landen-finkel-engineering/ROLLO-Wheelchair-Arm/output/renders/arm_exploded_iso.png

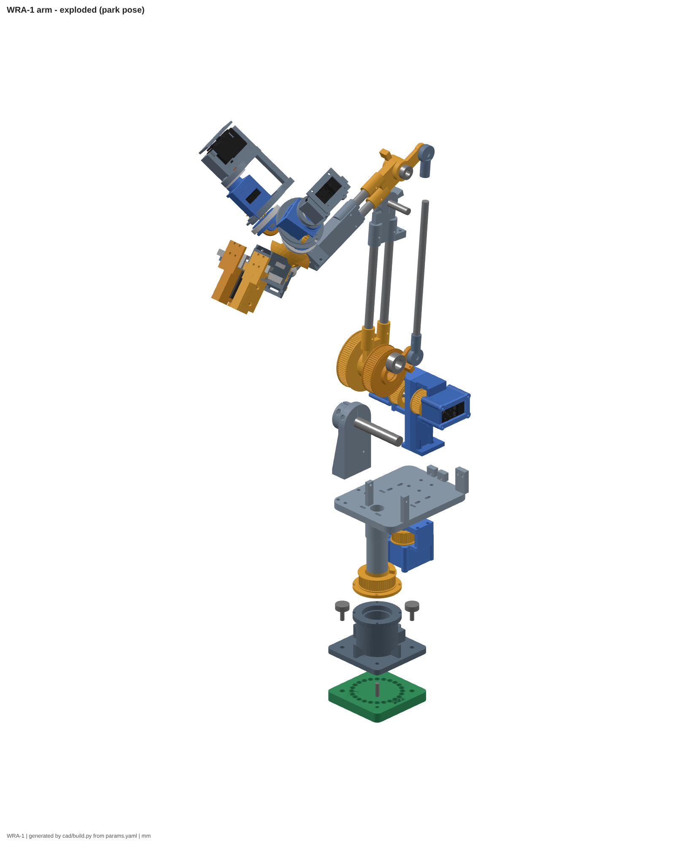
output/renders/arm_exploded_iso.png
