landen-finkel-engineering/ROLLO-Wheelchair-Arm/output/renders/arm_park_iso.png

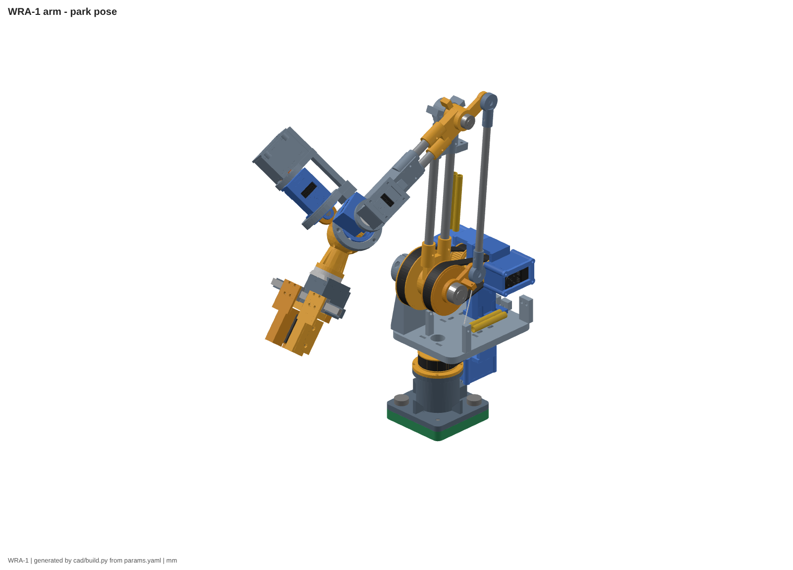
output/renders/arm_park_iso.png
