landen-finkel-engineering/ROLLO-Wheelchair-Arm/output/renders/arm_park_iso_right.png

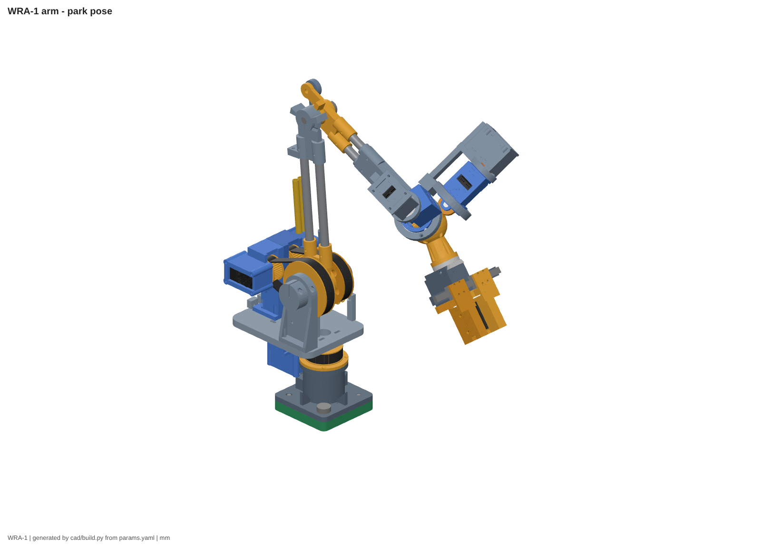
output/renders/arm_park_iso_right.png
