landen-finkel-engineering/ROLLO-Wheelchair-Arm/output/renders/arm_park_left.png

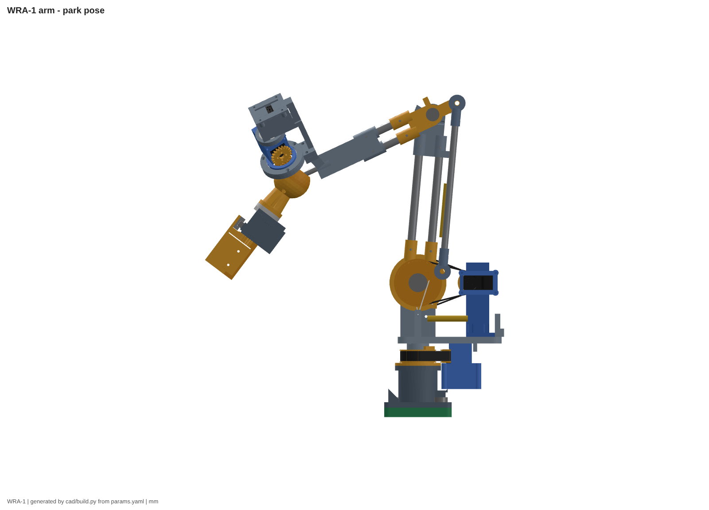
output/renders/arm_park_left.png
