landen-finkel-engineering/ROLLO-Wheelchair-Arm/output/renders/arm_work_iso.png

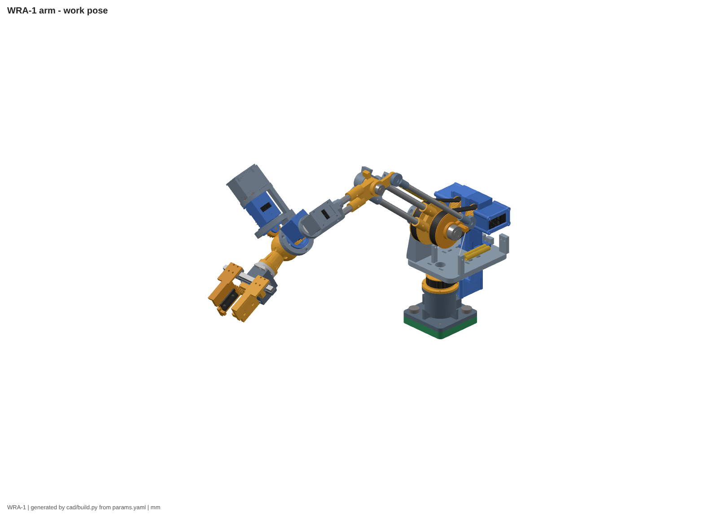
output/renders/arm_work_iso.png
