landen-finkel-engineering/ROLLO-Wheelchair-Arm/output/renders/arm_work_iso_back_right.png

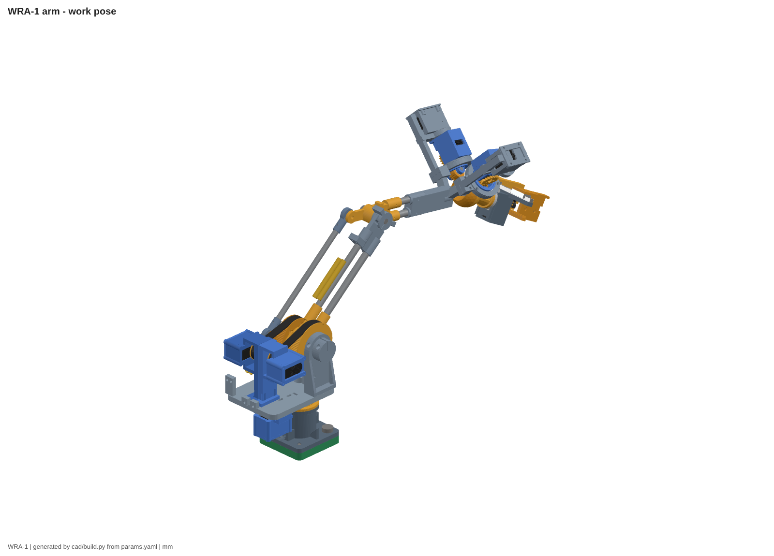
output/renders/arm_work_iso_back_right.png
