landen-finkel-engineering/ROLLO-Wheelchair-Arm/output/renders/detail_abenics_home_front.png

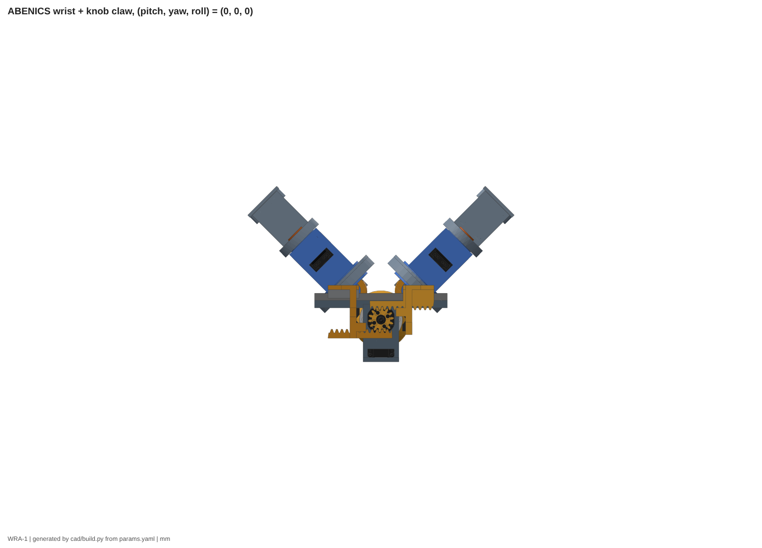
output/renders/detail_abenics_home_front.png
