landen-finkel-engineering/ROLLO-Wheelchair-Arm/output/renders/detail_abenics_home_iso_back_right.png

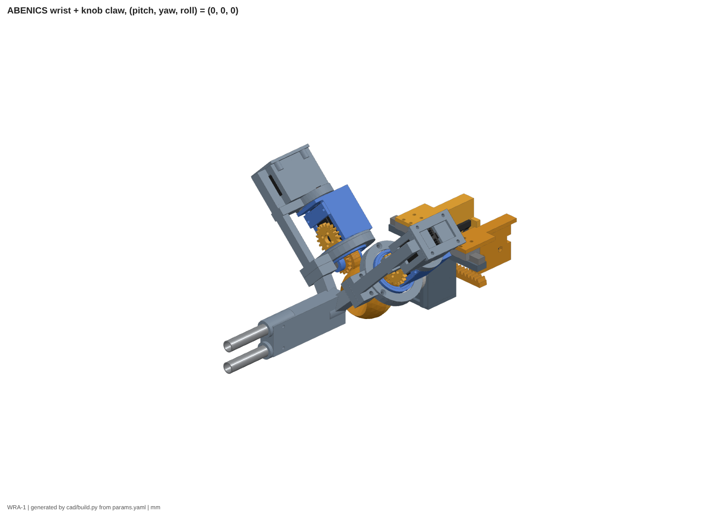
output/renders/detail_abenics_home_iso_back_right.png
