landen-finkel-engineering/ROLLO-Wheelchair-Arm/output/renders/detail_abenics_pitch_down_front.png

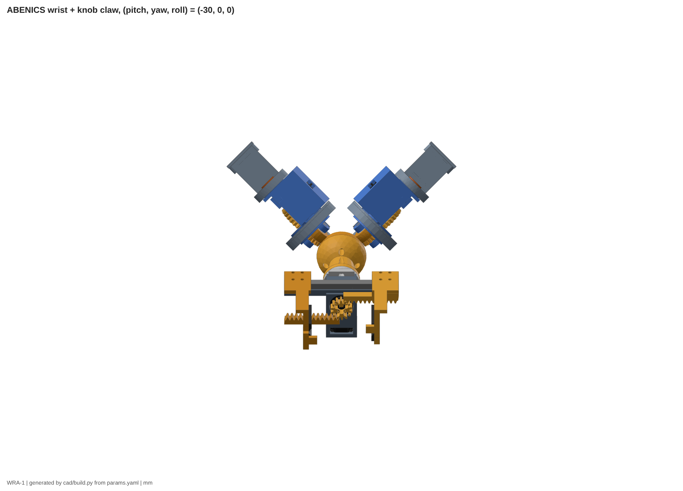
output/renders/detail_abenics_pitch_down_front.png
