landen-finkel-engineering/ROLLO-Wheelchair-Arm/output/renders/detail_abenics_pitch_down_iso_back_right.png

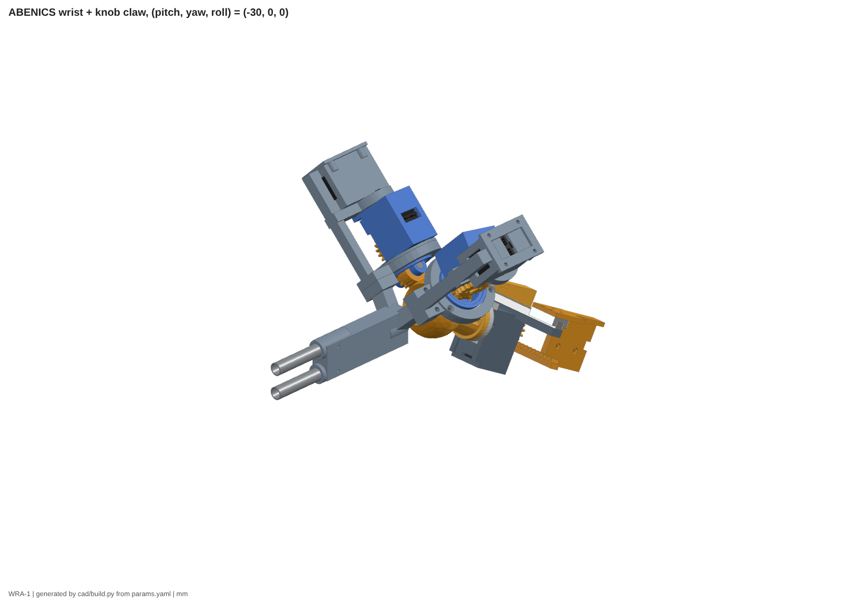
output/renders/detail_abenics_pitch_down_iso_back_right.png
