landen-finkel-engineering/ROLLO-Wheelchair-Arm/output/renders/detail_abenics_yaw_left_roll_iso.png

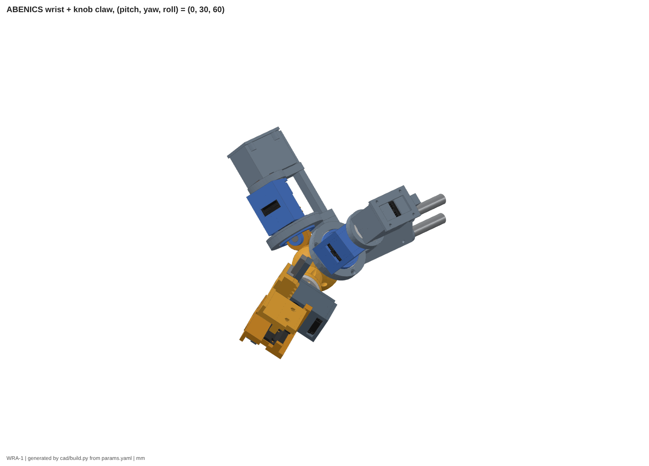
output/renders/detail_abenics_yaw_left_roll_iso.png
