landen-finkel-engineering/ROLLO-Wheelchair-Arm/output/renders/detail_base_iso.png

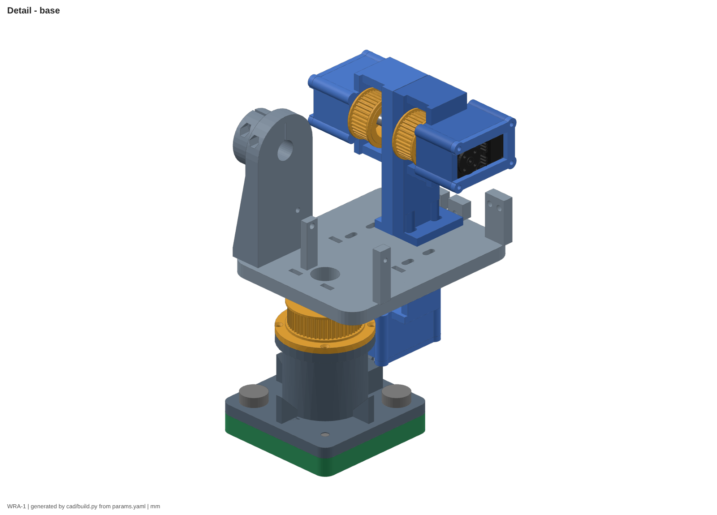
output/renders/detail_base_iso.png
