landen-finkel-engineering/ROLLO-Wheelchair-Arm/output/renders/detail_claw_iso.png

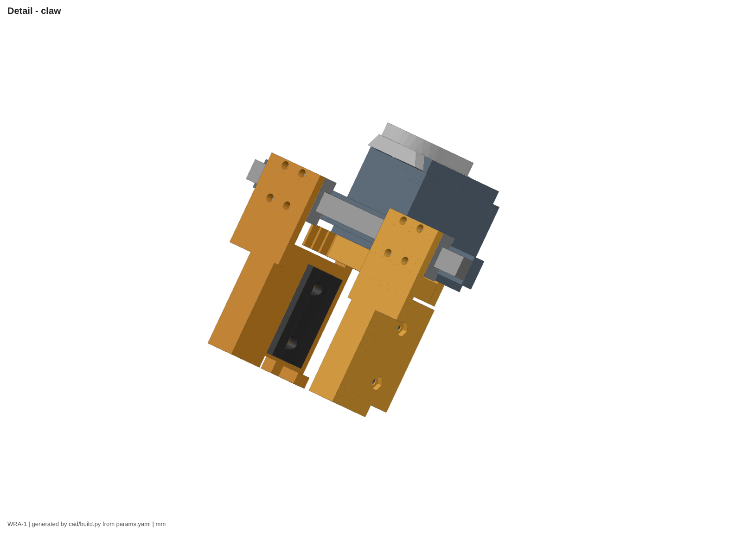
output/renders/detail_claw_iso.png
