landen-finkel-engineering/ROLLO-Wheelchair-Arm/output/renders/detail_claw_iso_back_right.png

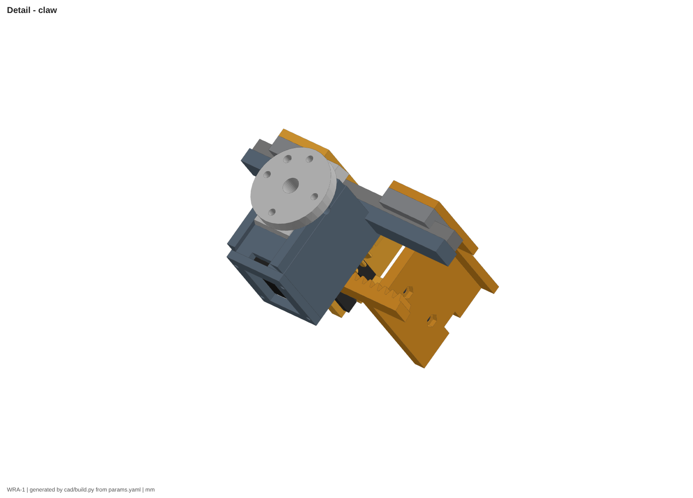
output/renders/detail_claw_iso_back_right.png
