landen-finkel-engineering/ROLLO-Wheelchair-Arm/output/renders/door_knob_right_iso_right.png

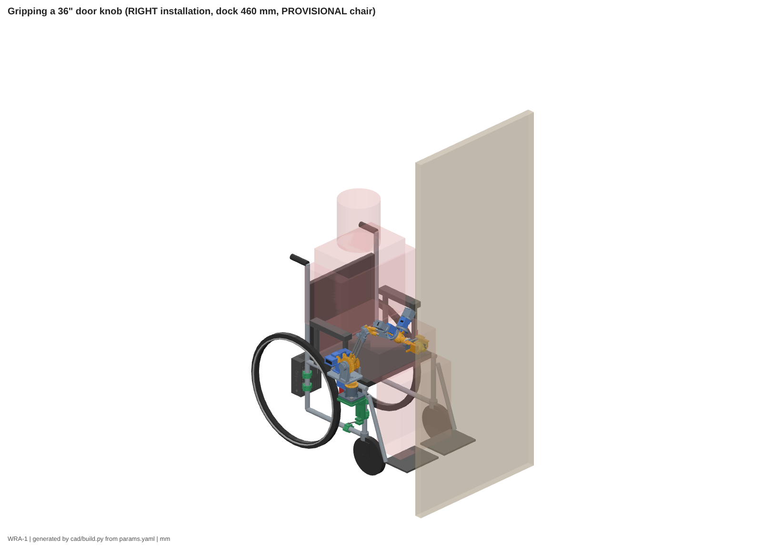
output/renders/door_knob_right_iso_right.png
