landen-finkel-engineering/ROLLO-Wheelchair-Arm/output/renders/door_knob_right_top.png

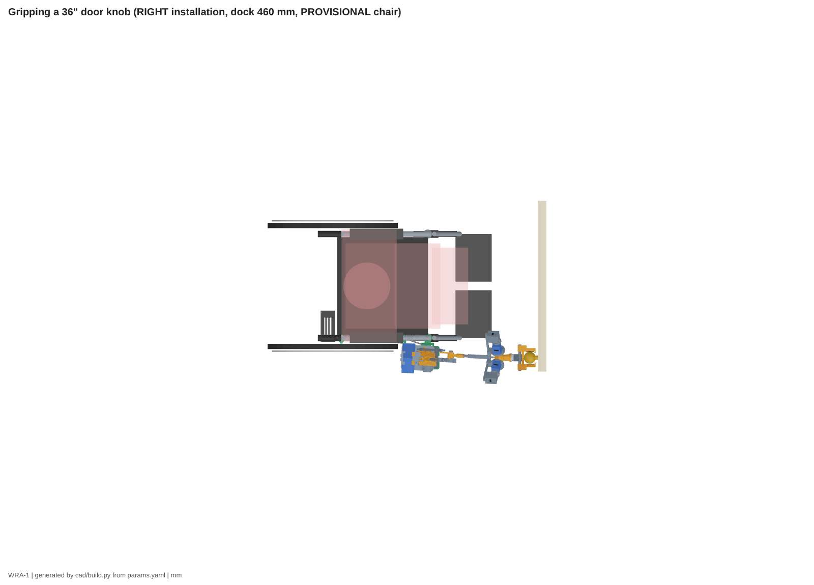
output/renders/door_knob_right_top.png
