landen-finkel-engineering/ROLLO-Wheelchair-Arm/output/reports/BOM.md

# Bill of materials (generated by `python build.py --bom`)

Active variant: **WRA-1A** (ABENICS 3-DoF wrist, set by `wrist_type` in params.yaml).  8 servos + 1 spare.  The other variant's extra parts are listed at the end.

Status tags: [V] verified catalogue/vendor data, [C] computed from the CAD/params, [E] estimate.

## Printed parts

| part | title | qty | material | mass each (g, est.) | bed size (mm) | inserts |
|---|---|---|---|---|---|---|
| 00_fit_test_coupon | PRINT FIRST: fit-test coupon (bearings, pins, inserts) | 1 | same as production | 61 | 170 x 64 x 10 | M3x1 M4x1 M5x1 |
| 01_receiver | Dock receiver (chair side, same part L/R) | 1 | PETG (PA-CF optional) | 104 | 100 x 100 x 14 | M6x2 |
| 02_tube_clamp_body | Tube clamp body (parametric tube OD) | 5 | PA-CF recommended (PETG ok) | 15 | 22 x 53 x 28 | M5x2 |
| 03_tube_clamp_cap | Tube clamp cap | 5 | PA-CF recommended (PETG ok) | 12 | 20 x 53 x 28 | - |
| 04_post_bracket | Post bracket (spine + shelf), same part L/R | 1 | PA-CF recommended | 211 | 162 x 110 x 125 | M4x4 |
| 05_stop_collar | Post stop collar (secondary retention) | 1 | PETG | 13 | 40 x 48 x 14 | - |
| 10_base_housing | Base housing + dock plate | 1 | PA-CF (required: dock plate bending) | 122 | 100 x 100 x 62 | M3x4 |
| 11_j1_fixed_pulley | J1 fixed pulley 54T (+ hard-stop arc) | 1 | PETG | 42 | 68 x 68 x 29 | - |
| 12_dm_bracket | Drive-module bracket | 1 | PETG | 53 | 59 x 60 x 64 | M4x5 M3x4 |
| 12_dm_cap | Drive-module servo cap | 3 | PETG | 4 | 59 x 38 x 4 | - |
| 12_dm_pulley36 | 36T HTD-3M drive pulley | 3 | PETG | 14 | 37 x 37 x 20 | - |
| 20_turntable | Turntable plate + J1 spindle | 1 | PETG (PA-CF optional) | 179 | 158 x 120 x 135 | M4x8 |
| 21_stub_cheek | Stub cheek (clamps J2 stub axle) | 1 | PETG (PA-CF recommended) | 80 | 52 x 106 x 30 | - |
| 22_ddm_bracket_j2 | Dual drive bracket (J2 half) | 1 | PETG | 72 | 59 x 110 x 66 | M3x4 M4x1 |
| 22_ddm_bracket_j3 | Dual drive bracket (J3 half) | 1 | PETG | 74 | 59 x 110 x 66 | M3x4 M4x1 |
| 30_ua_hub | Upper-arm hub with integral 86T (J2) pulley | 1 | PETG (PA-CF recommended) | 126 | 104 x 85 x 42 | - |
| 31_j3_hub | J3 hub: 72T pulley + parallelogram crank + spring L-lever | 1 | PETG (PA-CF recommended) | 62 | 87 x 71 x 46 | M5x1 |
| 32_elbow_block | Elbow block (clamps elbow pin, J2 spring anchor, stop lugs) | 1 | PETG (PA-CF recommended) | 40 | 78 x 64 x 20 | - |
| 33_rod_end | Parallelogram rod end (626 bearing) | 2 | PETG | 5 | 46 x 25 x 14 | - |
| 34_forearm_root | Forearm root: elbow bearings + crank + stop tab | 1 | PETG (PA-CF recommended) | 39 | 113 x 48 x 33 | M5x1 |
| 35_stub_spacer_14p46mm | Stub inner-ring spacer 14.46 mm | 1 | PETG | 1 | 17 x 17 x 14 | - |
| 35_stub_spacer_30p96mm | Stub inner-ring spacer 30.96 mm | 1 | PETG | 2 | 17 x 17 x 31 | - |
| 50_claw_palm | Claw palm: dovetail, servo cradle, rail beam | 1 | PA-CF (PETG ok) | 34 | 45 x 124 x 54 | M3x6 |
| 51_claw_cradle_cap | Claw servo cradle cap | 1 | PETG | 3 | 39 x 33 x 4 | - |
| 52_claw_pinion | Claw pinion 14T m1.5 (on servo horn) | 1 | PA-CF / PETG-CF | 2 | 24 x 24 x 10 | - |
| 53_claw_jaw_a | Claw jaw A (rack on top of pinion, upper knob lip) | 1 | PA-CF / PETG-CF | 26 | 84 x 46 x 60 | - |
| 53_claw_jaw_b | Claw jaw B (rack below pinion, lower knob lip) | 1 | PA-CF / PETG-CF | 25 | 84 x 49 x 60 | - |
| 54_claw_pad_a | Claw pad A, 100 deg V (glue 1.5 mm silicone facing) | 1 | TPU 95A + silicone sheet | 3 | 22 x 6 x 41 | - |
| 54_claw_pad_b | Claw pad B (mirror of A) | 1 | TPU 95A + silicone sheet | 3 | 22 x 6 x 41 | - |
| 56_tool_adapter | Quick-change tool adapter (dovetail, both wrists) | 1 | PA-CF (PETG ok) | 14 | 40 x 40 x 12 | - |
| 60_electronics_box | Electronics enclosure (Jetson, ESP32, power, E-stop relays) | 1 | PETG | 182 | 196 x 146 x 71 | M3x4 |
| 61_electronics_lid | Electronics enclosure lid | 1 | PETG | 59 | 196 x 146 x 5 | - |
| 62_estop_pendant | E-stop pendant body | 1 | PETG (yellow recommended) | 26 | 64 x 48 x 42 | M3x4 |
| 63_estop_pendant_lid | E-stop pendant lid (E-stop + guarded START) | 1 | PETG (yellow) | 7 | 65 x 48 x 12 | - |
| 70_bench_test_stand | Bench test stand (holds a post tube like the chair) | 1 | PETG | 376 | 220 x 170 x 72 | - |
| 80_cs_gear_front | CS-gear front hemisphere + tool flange | 1 | PA-CF (PETG-CF ok) | 64 | 54 x 54 x 56 | M3x4 |
| 81_cs_gear_back | CS-gear back hemisphere | 1 | PA-CF (PETG-CF ok) | 22 | 54 x 54 x 20 | M3x4 |
| 82_monopole | Monopole S-gear 17T m1.5 + 15T m1.5 drive gear | 2 | PA-CF | 5 | 28 x 28 x 16 | - |
| 83_mp_fork | Monopole fork: pin arms + 6808 inner-race ring (carrier part 1) | 2 | PA-CF (PETG-CF ok) | 9 | 44 x 44 x 23 | - |
| 84_mp_cradle | Theta-servo cradle: sleeve, U-channel, 6805 hub, q dogs (carrier part 2) | 2 | PA-CF (PETG ok) | 29 | 55 x 46 x 62 | M3x2 |
| 85_theta_gear | Theta drive gear 20T m1.5 (on servo horn) | 2 | PA-CF / PETG-CF | 3 | 33 x 33 x 4 | - |
| 86_q_coupling | q-servo horn coupling with drive dogs | 2 | PA-CF / PETG | 1 | 22 x 22 x 9 | - |
| 87_module_frame | Module frame: 6808 holder, lug, strut, 6805 boss, q-servo cradle | 2 | PA-CF (PETG ok) | 55 | 83 x 66 x 112 | M3x3 |
| 88_q_servo_cap | q-servo cap | 2 | PETG | 4 | 53 x 38 x 3 | - |
| 89_abenics_housing | ABENICS housing: forearm sockets, post clamp, shoulders | 1 | PA-CF (PETG ok) | 55 | 115 x 78 x 60 | M4x4 |
| 90_center_ball | Fixed centre ball (sphere bearing) | 1 | PA-CF | 4 | 18 x 19 x 19 | - |
| 91_holder_retainer | 6808 outer-race retainer ring (3x M3 countersunk) | 2 | PETG | 5 | 66 x 66 x 2 | - |
| 92_cradle_strap | Theta-servo strap (closes the cradle, 2x M3) | 2 | PETG | 2 | 14 x 35 x 4 | - |
| 93_mp_spacer | Monopole pin spacer 10.5/8.2 x 6.5 (or brass tube) | 2 | PETG | 0 | 10 x 10 x 6 | - |

Total printed mass (all instances, est.): **2618 g**.

## Purchased parts

| category | item | qty | spec | where | source | ~USD each |
|---|---|---|---|---|---|---|
| actuator | Waveshare ST3215 serial bus servo (30 kg.cm @12 V) | 4 | SKU 22414; 12 V; 4096-step magnetic encoder; 25T spline; supplied metal disc horn + screws | J1, J2, J3, claw | [V] owned / Waveshare | 22 |
| actuator | Waveshare ST3215 serial bus servo (30 kg.cm @12 V) | 4 | SKU 22414; 12 V; 4096-step magnetic encoder; 25T spline; supplied metal disc horn + screws | ABENICS wrist: q1, Theta1, q2, Theta2 | [V] Waveshare | 22 |
| actuator | Waveshare ST3215 serial bus servo (30 kg.cm @12 V) - SPARE | 1 | recommended: swap-in while a servo is re-calibrated | spares | [V] | 22 |
| electronics | NVIDIA Jetson Orin Nano 8GB developer kit | 1 | owned | e-box | [V] owned | owned |
| electronics | ESP32-WROOM-32 dev board (Freenove or DevKitC) | 1 | safety supervisor / servo bridge | e-box | [V] owned | 8 |
| electronics | Waveshare Bus Servo Adapter (A) | 1 | jumper A = UART mode (ESP32 drives the bus) | e-box | [V] Waveshare | 6 |
| electronics | ReSpeaker USB mic array | 1 | owned; USB to Jetson (voice commands) | user side | [V] owned | owned |
| power | DC-DC buck 12 V / 20 A (input >= 15-24 V) | 1 | servo bus supply; output must stay <= 12.6 V | e-box | [E] generic | 18 |
| power | DC-DC converter for the Jetson (voltage per YOUR carrier spec, >= 45 W) | 1 | do NOT feed raw 5S battery (21 V full) unless the carrier datasheet allows it | e-box | [E] generic | 15 |
| power | 18-20 V power-tool battery (5S Li-ion, >= 4 Ah) + adapter with fuse/switch | 1 | or any 15-24 V pack with BMS; the arm's own supply (a manual chair has no battery) | e-box / chair | [E] | 60 |
| power | ATO blade fuse holder + fuses 25 A, 5 A, 2 A | 1 | servo bus / Jetson / logic | e-box | [E] | 8 |
| power | TVS diode SMBJ15A (or 1.5KE15A) + 2200 uF 25 V low-ESR capacitor | 1 | servo bus clamp/bulk | e-box | [E] | 3 |
| power | XT60 connector pair | 2 | battery input | e-box | [E] | 2 |
| safety | 22 mm E-stop, red mushroom, latching twist-release, 1 NC (2 NC preferred) | 1 | IEC 60947-5-5 marked | pendant | [E] | 12 |
| safety | 22 mm momentary push button, NO, flush (START/RESET) | 1 | guarded by the printed ring | pendant | [E] | 5 |
| safety | Relay K1: 12 V coil DPDT (e.g. Omron G2R-2) + socket | 1 | self-hold latch | e-box | [E] | 8 |
| safety | Relay K2: 12 V coil automotive SPST-NO 40 A + socket | 1 | servo-bus power contactor | e-box | [E] | 6 |
| safety | Roller-lever microswitch (SS-5GL size, 20 x 10 x 6.5) | 1 | dock-present interlock | 01_receiver pocket | [E] | 1 |
| wiring | GX16-5 panel + cable connector pair | 1 | arm cable: 12 V, GND, DATA, dock-switch pair | e-box <-> 10_base_housing | [E] | 4 |
| wiring | GX12-4 panel + cable connector pair | 1 | pendant: E-stop NC loop + START | e-box <-> pendant | [E] | 3 |
| wiring | Silicone wire 14 AWG red/black (2 m each), 22 AWG 3-colour (5 m), 5264 3-pin servo leads | 1 | star power from the turntable distribution block; DATA daisy-chained | arm | [E] | 15 |
| wiring | Extra-flexible 3-core servo lead 26 AWG silicone, 0.5 m | 2 | Theta-servo service loops (carrier turns +/-120 deg) | ABENICS modules | [E] | 2 |
| wiring | WAGO 221 lever connectors or 4-way terminal block (turntable power star) | 1 |  | 20_turntable | [E] | 4 |
| wiring | Spiral wrap 6 mm, cable ties 2.5 mm, PG7 cable gland | 1 |  | arm / pendant | [E] | 5 |
| bearing | 6806-2RS deep-groove ball bearing 30x42x7 | 2 | J1 tower (face-to-face pair) | 10_base_housing | [V] catalogue part | 3 |
| bearing | 608-2RS 8x22x7 | 6 | 2 per drive-module pulley (J1, J2, J3) | 12_dm_pulley36 x3 | [V] catalogue part | 0.6 |
| bearing | 6802-2RS 15x24x5 | 4 | UA hub 2, J3 hub 2 | 30/31 | [V] catalogue part | 1.5 |
| bearing | 6800-2RS 10x19x5 | 2 | elbow | 34_forearm_root | [V] catalogue part | 1.5 |
| bearing | 626-2RS 6x19x6 | 2 | parallelogram rod ends | 33_rod_end x2 | [V] catalogue part | 1 |
| bearing | 623-2RS 3x10x4 | 3 | spring-cord idlers: A3 post 1, UA-hub lever B2/C2 2 | 20/30 | [V] catalogue part | 0.5 |
| bearing | 6808-2RS (61808) thin-section 40x52x7 | 2 | carrier locating bearing, 1 per module | 83_mp_fork / 87_module_frame | [V] catalogue part | 4 |
| bearing | 6805-2RS (61805) 25x37x7 | 2 | carrier floating bearing, 1 per module | 84_mp_cradle / 87_module_frame | [V] catalogue part | 2.5 |
| bearing | 688-2RS 8x16x5 | 4 | monopoles, 2 each | 82_monopole | [V] catalogue part | 1 |
| linear | MGN9 rail, cut 124 mm (min. 2 mounting holes per 20 mm pitch) | 1 | claw jaw guide; cut + deburr, keep the reference edge | 50_claw_palm | [V] Hiwin-pattern MGN9 | 8 |
| linear | MGN9C carriage (standard length) for MGN9 rail | 2 | one per jaw; preloaded/Z0 preferred | 53_claw_jaw_a/b | [V] check hole pattern 15 x 10 (params claw.block_holes) | 6 |
| belt | HTD-3M closed belt 240-3M-15 (80 teeth) | 1 | 36T -> 54T, centre 51.79 mm; if unavailable pick the nearest length and re-run build.py | J1 | [V] standard HTD pitch; check stock | 6 |
| belt | HTD-3M closed belt 345-3M-15 (115 teeth) | 1 | 36T -> 86T, centre 77.28 mm; if unavailable pick the nearest length and re-run build.py | J2 | [V] standard HTD pitch; check stock | 6 |
| belt | HTD-3M closed belt 321-3M-15 (107 teeth) | 1 | 36T -> 72T, centre 77.59 mm; if unavailable pick the nearest length and re-run build.py | J3 | [V] standard HTD pitch; check stock | 6 |
| stock | Aluminium tube 12 x 1 mm (6060/6063), cut 182.0 mm | 2 | upper-arm tubes | 30_ua_hub <-> 32_elbow_block | [V] stock size; [C] length | 4 |
| stock | Aluminium tube 12 x 1 mm, cut 83.0 mm | 2 | forearm tubes | 34_forearm_root <-> wrist housing (89 or 40: same sockets) | [C] length | 4 |
| stock | Aluminium tube 12 x 1 mm, cut 15.71 mm (deburr square) | 1 | elbow inner-ring spacer | elbow pin | [C] | 0 |
| stock | Aluminium tube 10 x 1 mm, cut 222.0 mm | 1 | parallelogram rod | 33_rod_end x2 | [C] | 3 |
| stock | 15 mm h6 linear shaft (hardened), cut 94.0 mm | 1 | J2/J3 stub axle (cantilever) | 21_stub_cheek | [C] length | 6 |
| stock | 10 mm h6 linear shaft, cut 56.2 mm | 1 | elbow pin | 32_elbow_block | [C] | 4 |
| stock | Stainless steel (304) tube 8 x 1 mm, cut 53.5 mm | 1 | ABENICS centre-ball post (claw cable inside) | 89_abenics_housing -> 90_center_ball | [C] | 2 |
| pin | dowel pin 8 x 25, hardened or stainless (the 608s must slide on) | 3 | drive-module pulley axles (J1, J2, J3) | 12/22 | [V] catalogue part | 0.5 |
| pin | ISO 8734 hardened dowel 8 x 30 | 2 | monopole axles (press in the -x arm) | 83_mp_fork | [V] catalogue part | 0.5 |
| pin | ISO 8734 dowel 3 x 12 | 2 | CS-gear hemisphere alignment | 80/81 | [V] catalogue part | 0.2 |
| pin | ISO 8734 dowel 2 x 20 (or M2 x 20 screw + nut) | 1 | centre ball cross pin (plus epoxy) | 90_center_ball | [V] catalogue part | 0.2 |
| pin | ISO 8734 hardened dowel 6 x 20 | 2 | dock locating dowels (pressed into receiver) | 01_receiver | [V] catalogue part | 0.4 |
| pin | ISO 8734 dowel 6 x 12 | 1 | J1 hard-stop pin | 20_turntable | [V] catalogue part | 0.3 |
| pin | ISO 8734 dowel 4 x 8 | 1 | tool-flange clocking dowel | 80_cs_gear_front (1A) / 46 (1B) | [V] catalogue part | 0.2 |
| pin | ISO 7379 shoulder screw 6 x 10, M5 thread | 2 | parallelogram crank pins P and Q (626 bearings) | 31_j3_hub, 34_forearm_root | [V] catalogue part | 1.5 |
| collar | Shaft collar 30 mm bore, OD <= 45, width 13 (clamp type) | 1 | J1 spindle axial retention. OPEN: standard 30 mm collars are 16 mm wide or over 45 mm OD, so none fits the base cavity as drawn (docs/16) | base cavity | [open] no standard part found | 5 |
| collar | Shaft collar 15 mm bore, OD <= 28, width <= 12 (set-screw) | 1 | stub stack retention | stub | [V] catalogue part | 2 |
| collar | Shaft collar 10 mm bore, OD <= 20, width <= 8 (set-screw) | 1 | elbow pin retention | elbow pin | [V] catalogue part | 2 |
| shim | DIN 988 shim rings 15 x 21 assorted (0.1 / 0.3 / 0.5 / 1.0) | 1 | stub stack end play | stub | [V] catalogue part | 4 |
| shim | DIN 988 shim rings 10 x 16 x 0.5 | 2 | elbow end play | elbow | [V] catalogue part | 1 |
| shim | DIN 988 shim rings 8 x 14 x 0.1 / 0.3 | 4 | monopole axial play (between fork arm and 688) | 83_mp_fork | [V] catalogue part | 0.3 |
| spring | Extension springs for gravity balance (rate/preload from calcs/report) | 4 | 2 per joint (J2, J3); see calcs/output/springs.json. OPEN: a spring meeting this spec is about 12-16 mm OD and 85-100 mm long unstretched; the CAD only has a 9 mm placeholder, so its mounting is not designed yet (docs/16) | upper arm, turntable | [C] spec from calcs; [open] size and mounting | 3 |
| spring | UHMWPE (Dyneema) braided cord 1.5-2 mm, >= 100 kg break | 1 | 1 m | spring cords | [V] catalogue part | 5 |
| spring | M4 eye bolts 40 mm + nuts (spring tension adjusters) | 4 |  | 32_elbow_block, 20_turntable | [V] catalogue part | 0.5 |
| consumable | Silicone rubber sheet 1.5 mm, Shore A 40-60, + silicone-compatible adhesive | 1 | claw pad facing (friction for knobs); replace when glazed | 54_claw_pad_a/b | [E] | 8 |
| consumable | PTFE dry-film lubricant or PTFE grease (plastic-safe) | 1 | ABENICS teeth, centre-ball socket, claw rack | wrist | [E] | 8 |
| fastener | DIN 464 knurled thumb screw M6 x 25 (+ 5 x 1.5 mm O-ring on the thread, in the 13 mm recess, to make it captive) | 2 | arm dock quick release | 10_base_housing -> 01_receiver | [V] catalogue part | 1.5 |
| mount | Rod end SI5 (M5 female, 5 mm bore) | 2 | torque strut | 04_post_bracket <-> strut clamp | [V] catalogue part | 3 |
| mount | M5 threaded rod, 150 mm, + 2 M5 jam nuts | 1 | torque strut (cut to fit 90-160 mm) | strut | [V] catalogue part | 1 |
| mount | Rubber liner 1.5 mm (bicycle inner tube) or printed TPU sleeve | 5 | inside every tube clamp | 02/03 | [V] catalogue part | 0 |
| mount | Steel safety tether, 1.5 mm wire rope loop with ferrule + snap hook | 1 | bracket eye -> chair frame (catches the arm if the dock is opened by mistake) | 04_post_bracket | [V] catalogue part | 4 |
| insert | Brass heat-set insert M3 x 5.7 (pilot 4.0) | 34 | counted from the CAD (+4 for the fit coupon / spares) | 10_base_housing 4, 12_dm_bracket 4, 22_ddm_bracket_j2 4, 22_ddm_bracket_j3 4, 50_claw_palm 6, 60_electronics_box 4, 62_estop_pendant 4 | [C] | 0.06 |
| insert | Brass heat-set insert M4 x 8.1 (pilot 5.6) | 23 | counted from the CAD (+4 for the fit coupon / spares) | 04_post_bracket 4, 12_dm_bracket 5, 20_turntable 8, 22_ddm_bracket_j2 1, 22_ddm_bracket_j3 1 | [C] | 0.1 |
| insert | Brass heat-set insert M5 x 9.5 (pilot 6.4) | 16 | counted from the CAD (+4 for the fit coupon / spares) | 02_tube_clamp_body 10, 31_j3_hub 1, 34_forearm_root 1 | [C] | 0.12 |
| insert | Brass heat-set insert M6 x 12.7 (pilot 8.0) | 6 | counted from the CAD (+4 for the fit coupon / spares) | 01_receiver 2 | [C] | 0.2 |
| insert | Brass heat-set insert M3 x 5.7 (pilot 4.0) | 18 | counted from the CAD | 80_cs_gear_front 4, 81_cs_gear_back 4, 84_mp_cradle 4, 87_module_frame 6 | [C] | 0.06 |
| insert | Brass heat-set insert M4 x 8.1 (pilot 5.6) | 4 | counted from the CAD | 89_abenics_housing 4 | [C] | 0.1 |

Purchased cost estimate excluding owned items: **~$577** [E].

## Fastener schedule

| location / step | fastener | qty | into |
|---|---|---|---|
| Servo horns J1-J3 (36T DM pulleys) | ISO 7380 M3 x 8 button head | 12 | servo horn threads |
| Drive-module caps (J1, J2, J3) | ISO 4762 M3 x 10 | 12 | M3 inserts in 12/22 |
| J1 drive module -> turntable (slotted) | ISO 4762 M4 x 16 + washer | 4 | M4 inserts in 12_dm_bracket |
| Belt tensioners J1, J2, J3 (pull screws) | ISO 4762 M4 x 30 + washer | 3 | tension inserts in 12/22 |
| DDM halves -> turntable (slotted feet) | ISO 4762 M4 x 16 + washer | 4 | M4 inserts in 20_turntable |
| Stub cheek -> turntable | ISO 4762 M4 x 16 | 4 | M4 inserts in 20_turntable |
| Stub cheek pinch (stub clamp) | ISO 4762 M4 x 25 + hex nut | 2 | nut traps in 21 |
| Fixed 54T pulley -> base housing | ISO 10642 countersunk M3 x 12 | 4 | M3 inserts in 10_base_housing |
| Tube cross-bolts (UA hub, elbow block, forearm root) | ISO 4762 M3 x 20 + nyloc nut | 6 | drill the Al tubes 3.4 mm through the printed guide holes |
| Rod-end cross-bolts | ISO 4762 M3 x 20 + nyloc nut | 2 | drill rod tube 3.4 mm |
| Elbow pin pinch | ISO 4762 M3 x 20 + hex nut | 2 | nut traps in 32 |
| Crank pins P, Q | ISO 7379 shoulder screw 6x10 / M5 | 2 | M5 inserts in 31, 34 |
| J2 cord anchor (A2 post) | ISO 4762 M4 x 16 + nut | 1 | 20_turntable post |
| Cord idler axles (A3, B2, C2) | ISO 4762 M3 x 20 + nyloc nut + 623 bearing | 3 | 20, 30 |
| CS-gear hemispheres (front -> back) | ISO 4762 M3 x 16 | 4 | M3 inserts in 81 |
| Tool adapter 56 -> CS-gear flange (BC 30) | ISO 4762 M3 x 10 | 4 | M3 inserts in 80 |
| Theta gear 85 -> Theta-servo horn | ISO 7380 M3 x 8 | 8 | servo horn threads |
| q coupling 86 -> q-servo horn | ISO 7380 M3 x 8 | 8 | servo horn threads |
| Cradle 84 -> fork 83 (radial) | ISO 10642 countersunk M3 x 8 (thread-forming in 2.5 mm pilot) | 4 | fork ring |
| Holder retainer 91 -> module frame | ISO 10642 countersunk M3 x 8 | 6 | M3 inserts in 87 |
| Theta-servo strap 92 | ISO 4762 M3 x 10 | 4 | M3 inserts in 84 |
| q-servo cap 88 | ISO 4762 M3 x 12 (thread-forming in 2.5 mm pilot) | 8 | bosses on 87 |
| Module frame lugs -> housing pads | DIN 7984 low-head M4 x 16 | 4 | M4 inserts in 89 |
| Post clamp (housing slit) | ISO 4762 M3 x 20 + hex nut | 1 | 89 |
| Housing -> forearm tubes (cross-bolts) | ISO 4762 M3 x 20 + nyloc nut | 2 | drill tubes 3.4 mm |
| Claw pinion 52 -> claw-servo horn | ISO 7380 M3 x 6 | 4 | servo horn threads |
| Claw cradle cap 51 | ISO 7380 M2 x 10 (thread-forming in 1.8 mm pilot) | 4 | side walls of 50 |
| MGN9 rail -> palm 50 | ISO 4762 M3 x 8 | 6 | M3 inserts in 50 |
| Jaws 53 -> MGN9C carriages | ISO 4762 M3 x 6 | 8 | carriage threads (check length!) |
| Pads 54 -> jaws 53 | ISO 4762 M3 x 16 + hex nut | 4 | nut recess in the finger |
| Dovetail lock (palm on tool adapter) | M4 x 20 thumb screw (or SHCS) + hex nut | 1 | nut trap in 50 |
| Dock thumb screws | DIN 464 M6 x 25 | 2 | M6 inserts in 01_receiver |
| Receiver -> post bracket shelf (index ring) | ISO 4762 M4 x 16 + washer | 4 | M4 inserts in 04 |
| Tube clamps (body + cap), 5 clamps | ISO 4762 M5 x 30 + hex nut | 10 | nut traps in 02 |
| Post bracket -> 2 post clamps | ISO 4762 M5 x 16 + washer | 4 | M5 inserts in 02 pads |
| Strut rod end -> bracket clevis | ISO 4762 M5 x 35 + nut (nut trap) | 1 | 04 clevis |
| Strut rod end -> strut clamp pad | ISO 4762 M5 x 16 + washer | 1 | M5 insert in 02 |
| Stop collar | ISO 4762 M4 x 20 + nut | 1 | 05 |
| Electronics box -> 2 cane clamps | ISO 4762 M5 x 12 + washer | 4 | M5 inserts in 02 pads |
| Electronics box lid | ISO 4762 M3 x 10 | 4 | M3 inserts in 60 |
| Pendant lid | ISO 4762 M3 x 10 | 4 | M3 inserts in 62 |
| Electronics boards | M3 nylon standoffs + screws (assorted) | 1 | floor slots in 60 |
| Dock microswitch | M2 x 10 self-tapping | 2 | 01_receiver pocket |

### Fastener totals

| fastener | qty |
|---|---|
| DIN 464 M6 x 25 | 2 |
| DIN 7984 low-head M4 x 16 | 4 |
| ISO 10642 countersunk M3 x 12 | 4 |
| ISO 10642 countersunk M3 x 8 | 6 |
| ISO 10642 countersunk M3 x 8 (thread-forming in 2.5 mm pilot) | 4 |
| ISO 4762 M3 x 10 | 28 |
| ISO 4762 M3 x 12 (thread-forming in 2.5 mm pilot) | 8 |
| ISO 4762 M3 x 16 | 8 |
| ISO 4762 M3 x 20 | 16 |
| ISO 4762 M3 x 6 | 8 |
| ISO 4762 M3 x 8 | 6 |
| ISO 4762 M4 x 16 | 17 |
| ISO 4762 M4 x 20 | 1 |
| ISO 4762 M4 x 25 | 2 |
| ISO 4762 M4 x 30 | 3 |
| ISO 4762 M5 x 12 | 4 |
| ISO 4762 M5 x 16 | 5 |
| ISO 4762 M5 x 30 | 10 |
| ISO 4762 M5 x 35 | 1 |
| ISO 7379 shoulder screw 6x10 / M5 | 2 |
| ISO 7380 M2 x 10 (thread-forming in 1.8 mm pilot) | 4 |
| ISO 7380 M3 x 6 | 4 |
| ISO 7380 M3 x 8 | 16 |
| ISO 7380 M3 x 8 button head | 12 |
| M2 x 10 self-tapping | 2 |
| M3 nylon standoffs | 1 |
| M4 x 20 thumb screw (or SHCS) | 1 |

## WRA-1B only (not needed for WRA-1A)

Printed: 40_wrist_housing x1, 41_pitch_yoke x1, 42_yoke_cap x1, 43_j4_pulley54 x1, 44_j5_horn_adapter x1, 45_roll_spindle x1, 46_tool_flange x1, 47_roll_spacer x1

| category | item | qty | where |
|---|---|---|---|
| actuator | Waveshare ST3215 serial bus servo (30 kg.cm @12 V) | 2 | J4 pitch, J5 roll |
| bearing | 608-2RS 8x22x7 | 2 | 12_dm_pulley36 |
| bearing | 6802-2RS 15x24x5 | 2 | 41_pitch_yoke |
| bearing | 688-2RS 8x16x5 | 2 | 41/43 |
| bearing | 625-2RS 5x16x5 | 3 | 40_wrist_housing |
| belt | HTD-3M closed belt 276-3M-15 (92 teeth) | 1 | J4 |
| pin | dowel pin 8 x 25, hardened or stainless (the 608s must slide on) | 1 | 40 |
| pin | ISO 8734 dowel 8 x 14 (needs 13.9) | 1 | 40_wrist_housing |
| pin | ISO 8734 dowel 8 x 14 (needs 13.3) | 1 | 40_wrist_housing |
| pin | ISO 8734 dowel 3 x 8 | 2 | 45_roll_spindle |
| insert | Brass heat-set insert M3 x 5.7 (pilot 4.0) | 16 | 40_wrist_housing 4, 41_pitch_yoke 8, 46_tool_flange 4 |
| insert | Brass heat-set insert M5 x 9.5 (pilot 6.4) | 1 | 45_roll_spindle 1 |
| fastener | ISO 7380 M3 x 8 button head | 8 | Servo horns J4, J5 (pulley 12, horn adapter 44) |
| fastener | ISO 4762 M3 x 10 | 4 | Drive-module cap J4 |
| fastener | ISO 4762 M3 x 20 + nyloc nut | 2 | Wrist housing 40 -> forearm tubes (cross-bolts) |
| fastener | ISO 4762 M5 x 40 + 3x 625 + washers + nyloc | 1 | J4 back-side idler |
| fastener | ISO 4762 M3 x 10 | 4 | Yoke cap |
| fastener | ISO 4762 M3 x 25 | 4 | 54T J4 pulley -> yoke |
| fastener | ISO 4762 M5 x 16 + washer | 1 | Tool flange -> roll spindle |
| fastener | ISO 4762 M3 x 10 | 4 | Tool adapter -> tool flange (BC 30) |
