landen-finkel-engineering/ROLLO-Wheelchair-Arm/output/dxf/04_post_bracket_plates.dxf

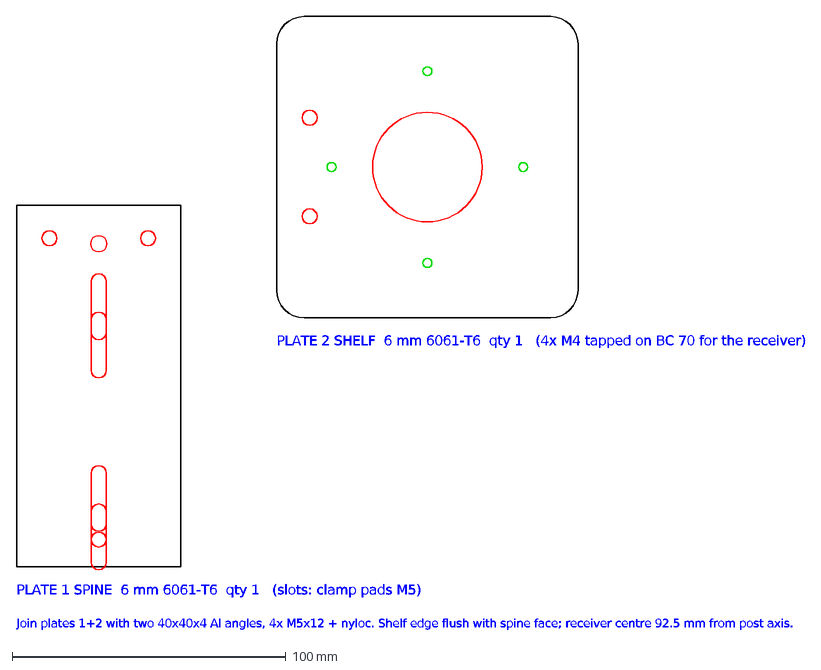
[picture p27: CAD file, 2026-10-12]
output/dxf/04_post_bracket_plates.dxf
PLATE 1 SPINE 6 mm 6061-T6 qty 1 (slots: clamp pads M5)
PLATE 2 SHELF 6 mm 6061-T6 qty 1 (4x M4 tapped on BC 70 for the receiver)
Join plates 1+2 with two 40x40x4 Al angles, 4x M5x12 + nyloc. Shelf edge flush with spine face; receiver centre 92.5 mm from post axis.
