landen-finkel-engineering/ROLLO-Wheelchair-Arm/output/step/parts/81_cs_gear_back.step

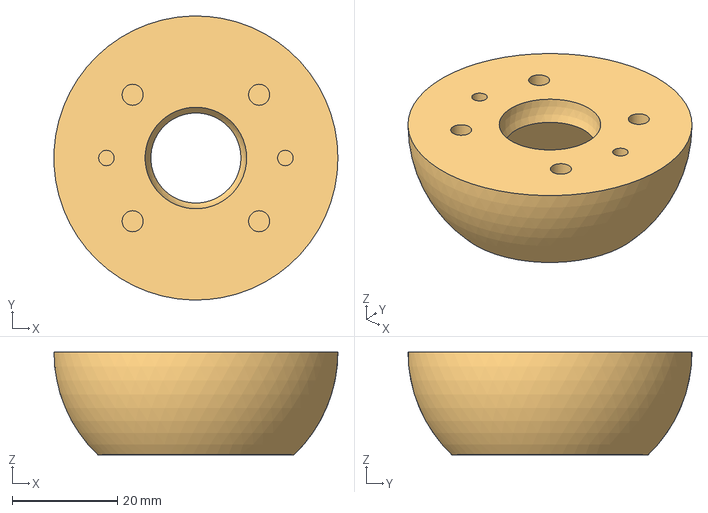
[picture p28: CAD file, 2026-10-12]
output/step/parts/81_cs_gear_back.step
54.0 x 54.0 x 19.5 mm
