landen-finkel-engineering/ROLLO-Wheelchair-Arm/software/wra_ros2/wra_description/meshes/turntable.stl

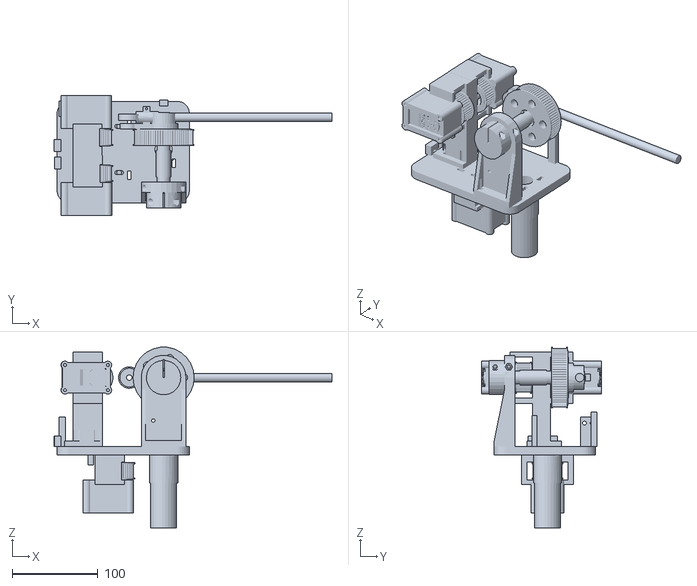
[picture p29: CAD file, 2026-10-13]
software/wra_ros2/wra_description/meshes/turntable.stl
323.6 x 139.7 x 210.1
