landen-finkel-engineering/ROLLO-Wheelchair-Arm/output/step/parts/20_turntable.step

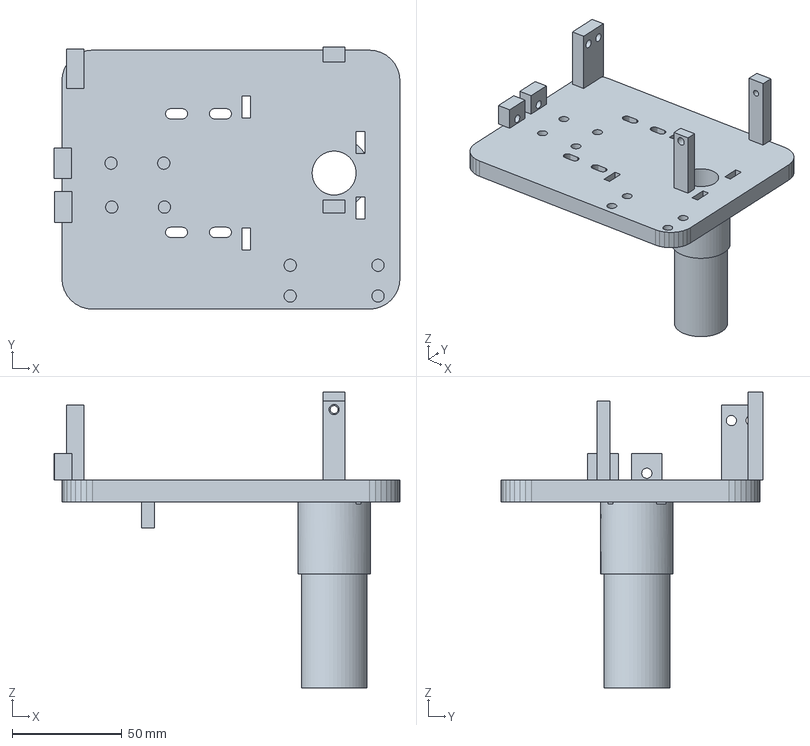
[picture p30: CAD file, 2026-10-12]
output/step/parts/20_turntable.step
157.6 x 119.5 x 134.8 mm
