landen-finkel-engineering/ROLLO-Wheelchair-Arm/output/step/parts/51_claw_cradle_cap.step

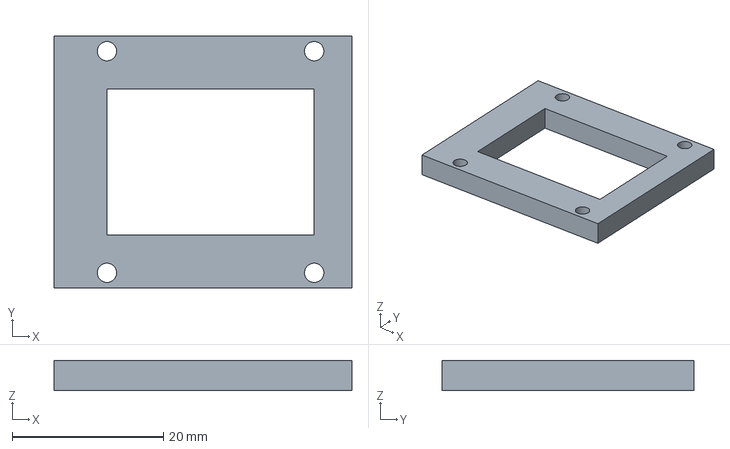
[picture p32: CAD file, 2026-10-12]
output/step/parts/51_claw_cradle_cap.step
39.4 x 33.3 x 4.00 mm
