landen-finkel-engineering/ROLLO-Wheelchair-Arm/software/wra_ros2/wra_description/meshes/tool_flange.stl

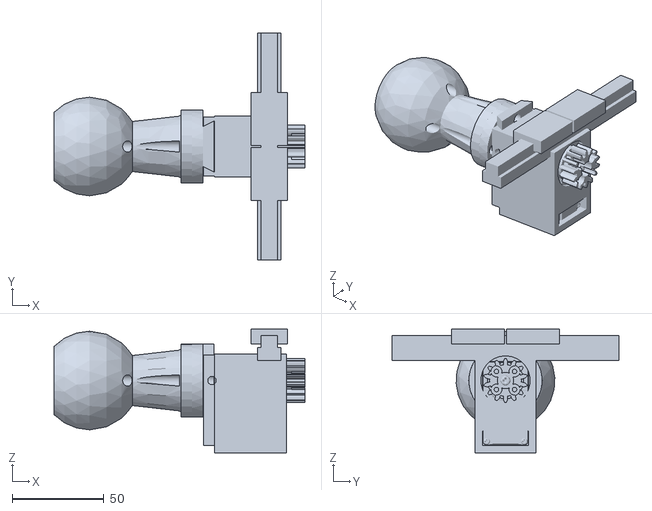
[picture p33: CAD file, 2026-10-12]
software/wra_ros2/wra_description/meshes/tool_flange.stl
137.1 x 124.0 x 67.5
