landen-finkel-engineering/ROLLO-Wheelchair-Arm/output/step/parts/85_theta_gear.step

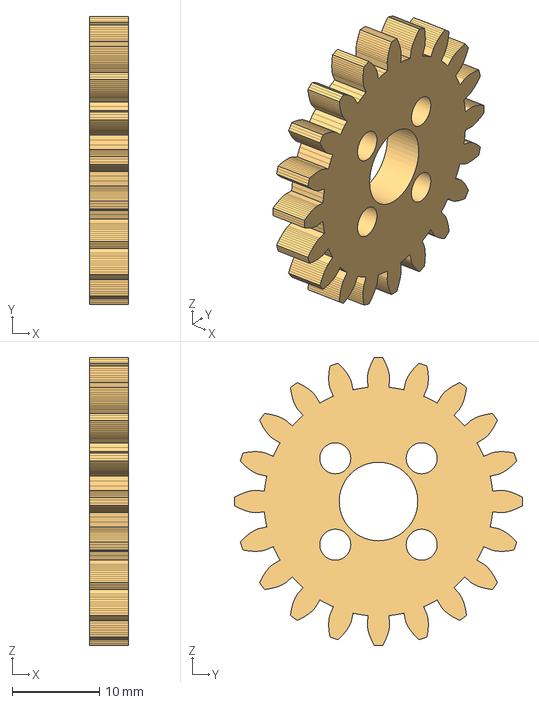
[picture p34: CAD file, 2026-10-12]
output/step/parts/85_theta_gear.step
4.50 x 33.0 x 33.0 mm
