landen-finkel-engineering/ROLLO-Wheelchair-Arm/software/wra_ros2/wra_description/meshes/jaw_b.stl

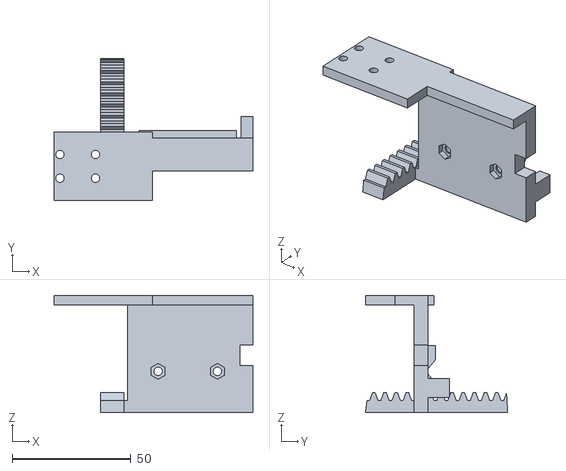
[picture p35: CAD file, 2026-10-12]
software/wra_ros2/wra_description/meshes/jaw_b.stl
83.9 x 60.0 x 49.4
