landen-finkel-engineering/ROLLO-Wheelchair-Arm/output/step/parts/88_q_servo_cap.step

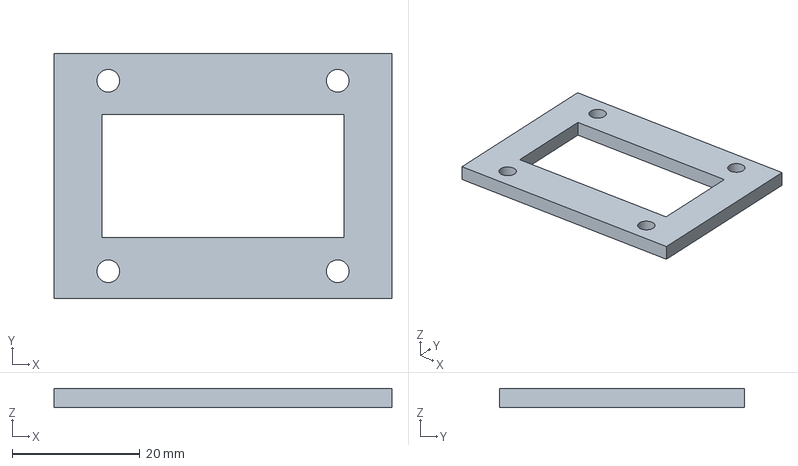
[picture p36: CAD file, 2026-10-12]
output/step/parts/88_q_servo_cap.step
52.9 x 38.3 x 3.00 mm
