landen-finkel-engineering/ROLLO-Wheelchair-Arm/software/wra_ros2/wra_description/meshes/base_link.stl

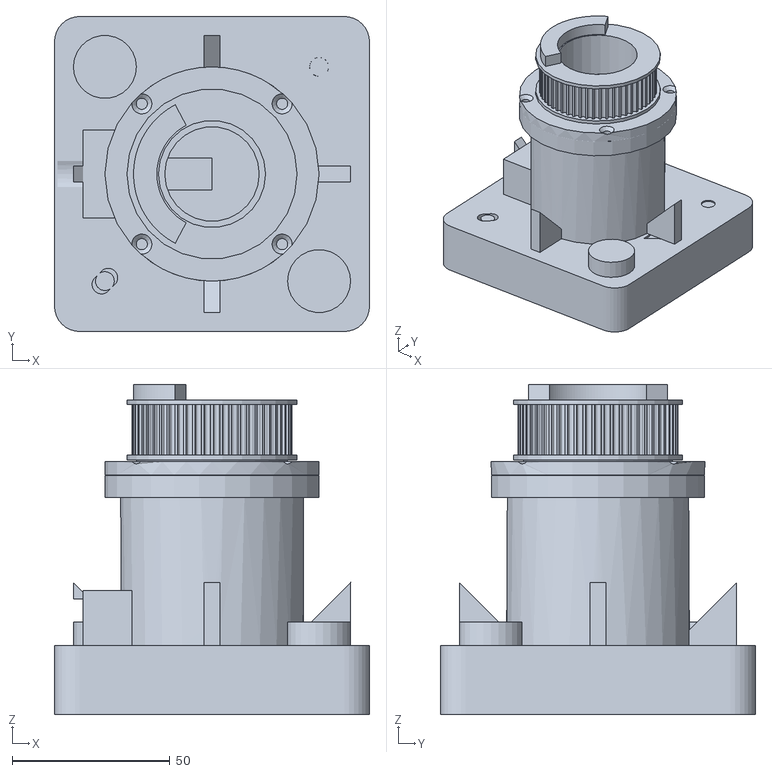
[picture p37: CAD file, 2026-10-12]
software/wra_ros2/wra_description/meshes/base_link.stl
100.0 x 100.0 x 104.9
