landen-finkel-engineering/ROLLO-Wheelchair-Arm/output/step/parts/42_yoke_cap.step

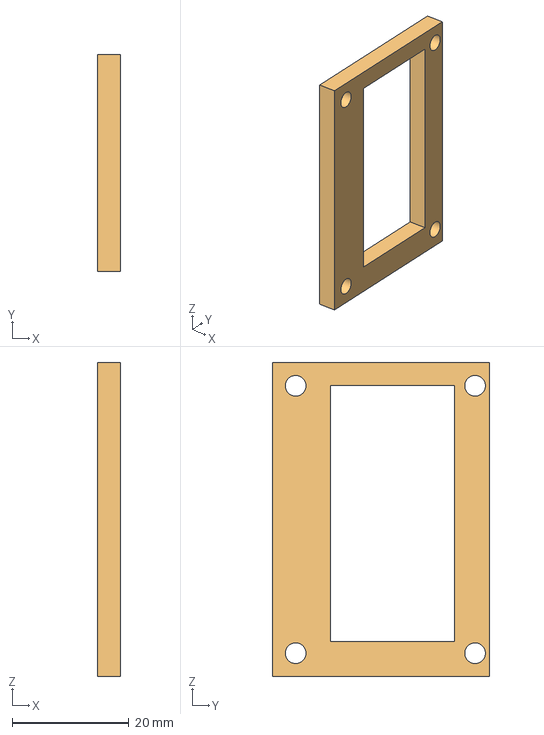
[picture p38: CAD file, 2026-10-12]
output/step/parts/42_yoke_cap.step
4.00 x 37.3 x 53.9 mm
