landen-finkel-engineering/ROLLO-Wheelchair-Arm/software/wra_ros2/wra_description/meshes/forearm.stl

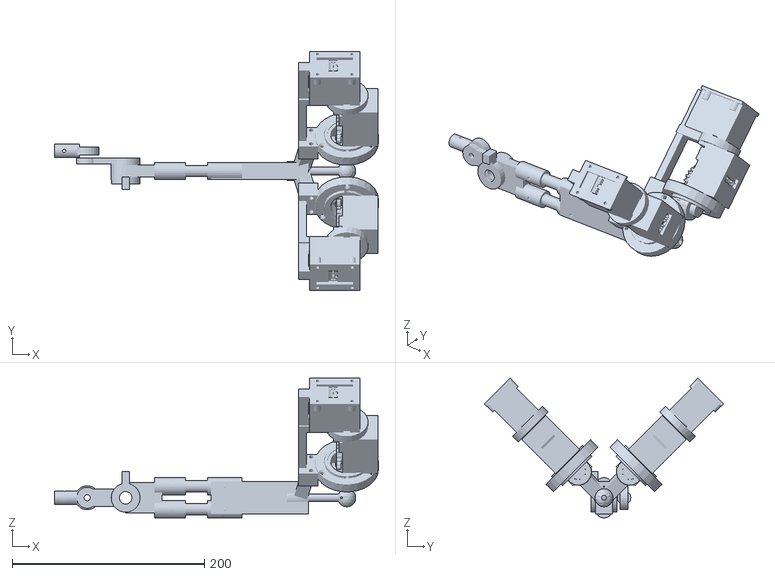
[picture p39: CAD file, 2026-10-12]
software/wra_ros2/wra_description/meshes/forearm.stl
337.0 x 249.0 x 145.5
