landen-finkel-engineering/ROLLO-Wheelchair-Arm/output/step/parts/00_fit_test_coupon.step

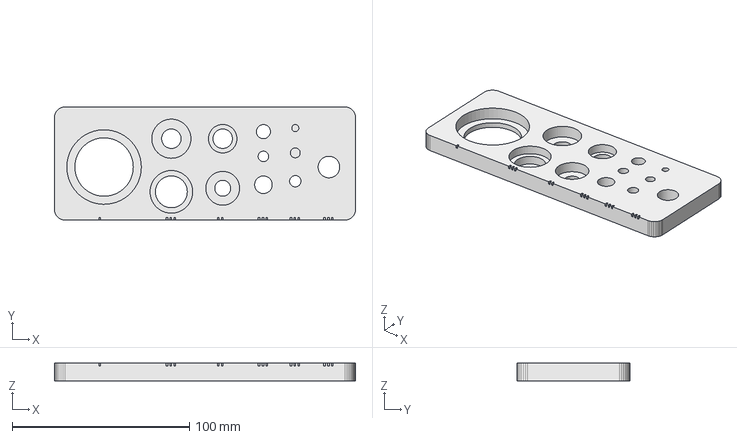
[picture p40: CAD file, 2026-10-12]
output/step/parts/00_fit_test_coupon.step
170.0 x 64.0 x 10.0 mm
