landen-finkel-engineering/ROLLO-Wheelchair-Arm/software/wra_ros2/wra_description/meshes/upper_arm.stl

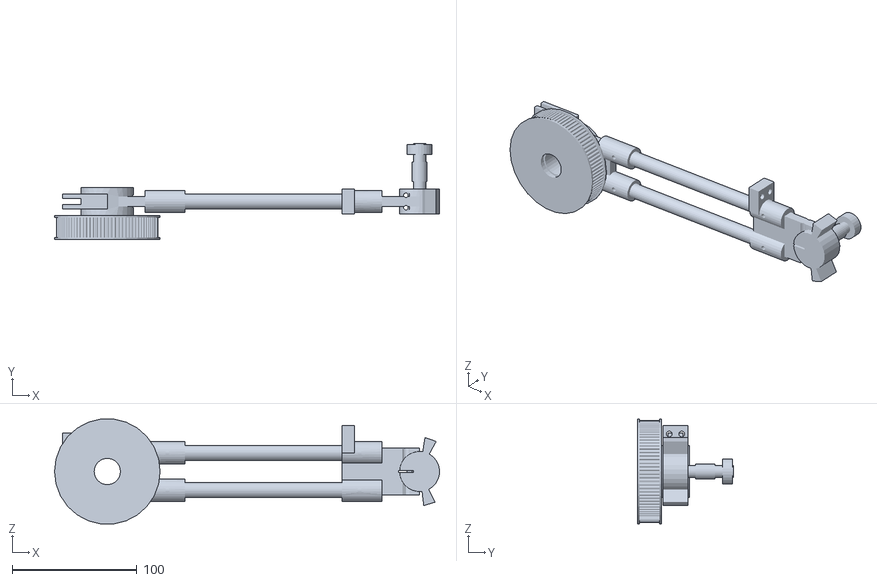
[picture p41: CAD file, 2026-10-12]
software/wra_ros2/wra_description/meshes/upper_arm.stl
308.2 x 76.5 x 83.9
