landen-finkel-engineering/ROLLO-Wheelchair-Arm/output/step/parts/44_j5_horn_adapter.step

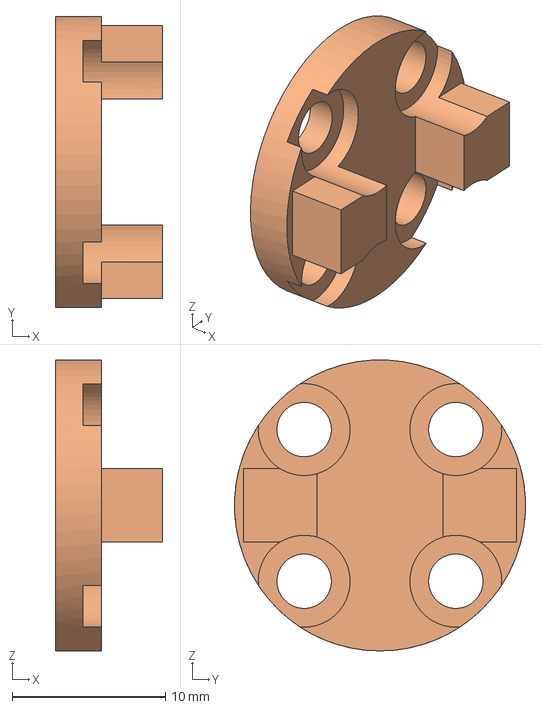
[picture p42: CAD file, 2026-10-12]
output/step/parts/44_j5_horn_adapter.step
7.00 x 19.0 x 19.0 mm
