landen-finkel-engineering/ROLLO-Wheelchair-Arm/output/step/parts/35_stub_spacer_14p46mm.step

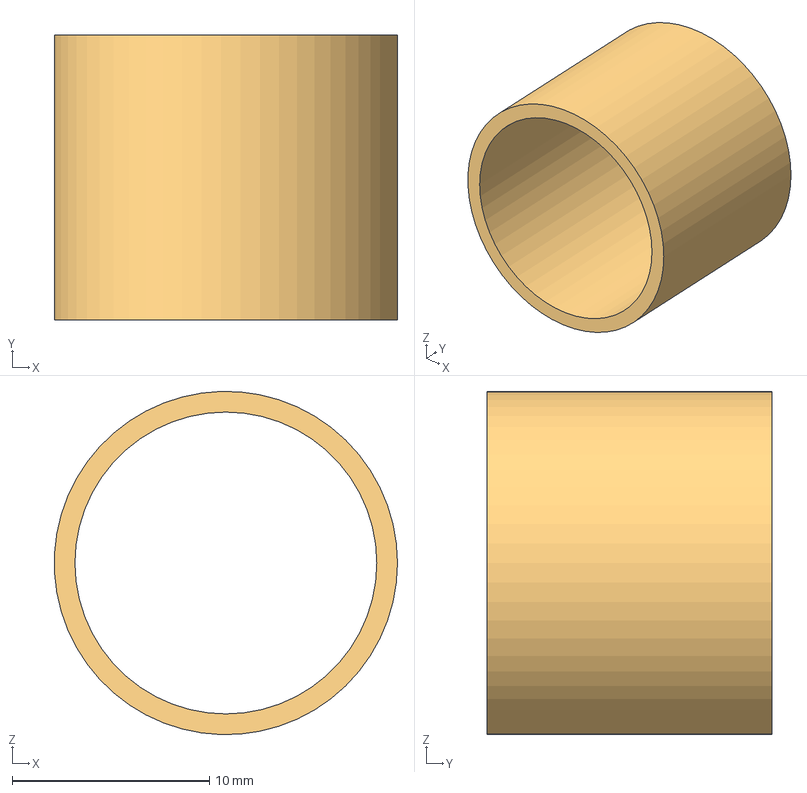
[picture p43: CAD file, 2026-10-12]
output/step/parts/35_stub_spacer_14p46mm.step
17.4 x 14.5 x 17.4 mm
