landen-finkel-engineering/ROLLO-Wheelchair-Arm/output/step/parts/40_wrist_housing.step

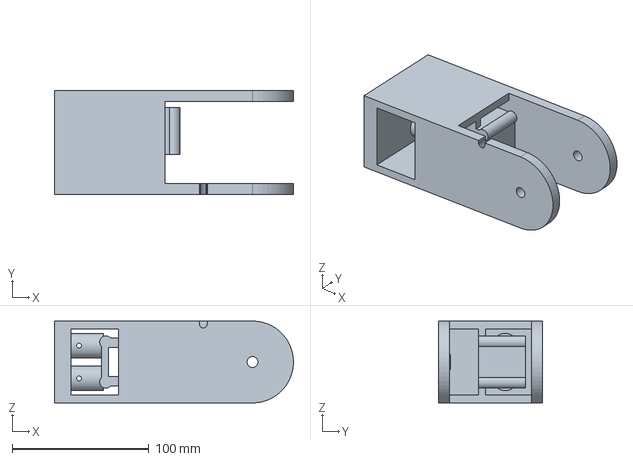
[picture p44: CAD file, 2026-10-12]
output/step/parts/40_wrist_housing.step
175.0 x 75.9 x 60.0 mm
