landen-finkel-engineering/ROLLO-Wheelchair-Arm/output/step/parts/63_estop_pendant_lid.step

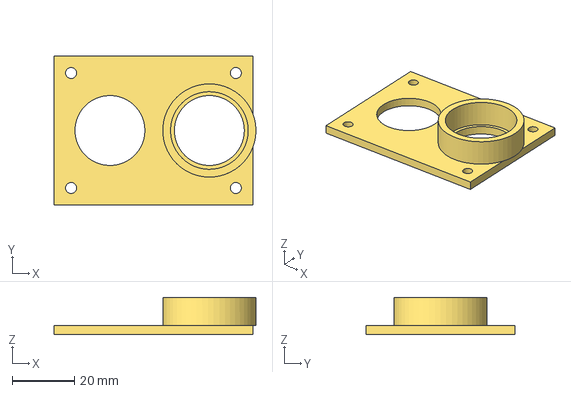
[picture p45: CAD file, 2026-10-12]
output/step/parts/63_estop_pendant_lid.step
65.0 x 48.0 x 12.0 mm
