landen-finkel-engineering/ROLLO-Wheelchair-Arm/output/step/parts/02_tube_clamp_body.step

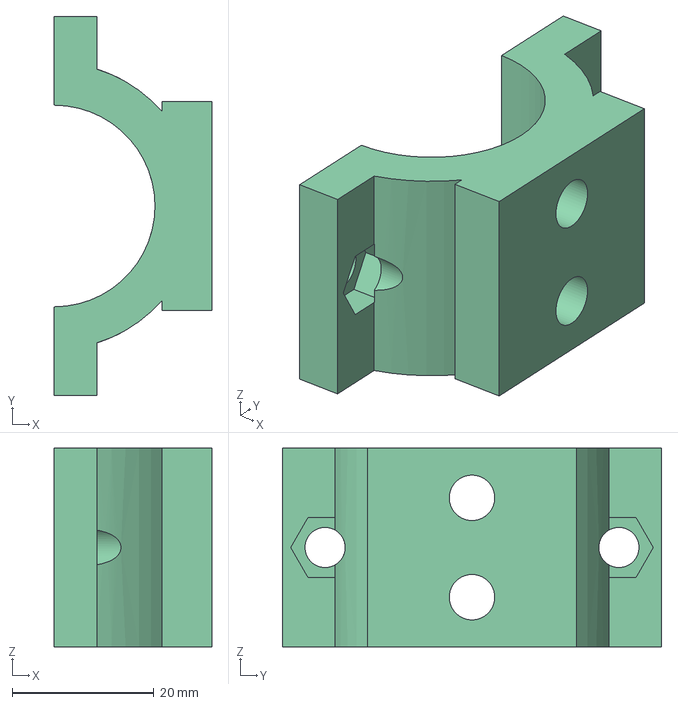
[picture p46: CAD file, 2026-10-12]
output/step/parts/02_tube_clamp_body.step
22.2 x 53.4 x 28.0 mm
