landen-finkel-engineering/ROLLO-Wheelchair-Arm/output/step/parts/35_stub_spacer_30p96mm.step

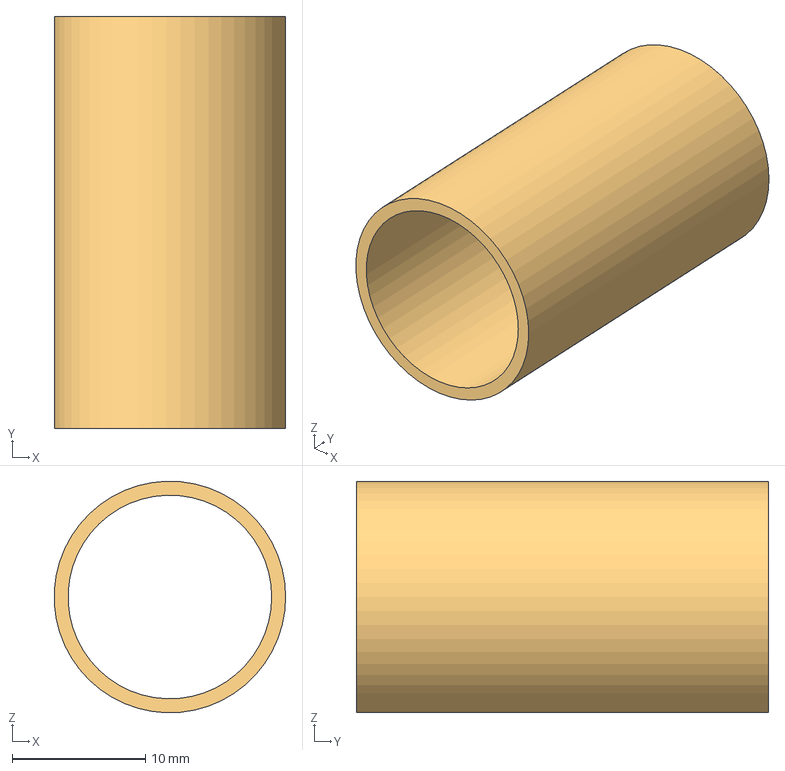
[picture p47: CAD file, 2026-10-12]
output/step/parts/35_stub_spacer_30p96mm.step
17.4 x 31.0 x 17.4 mm
