landen-finkel-engineering/ROLLO-Wheelchair-Arm/output/step/parts/33_rod_end.step

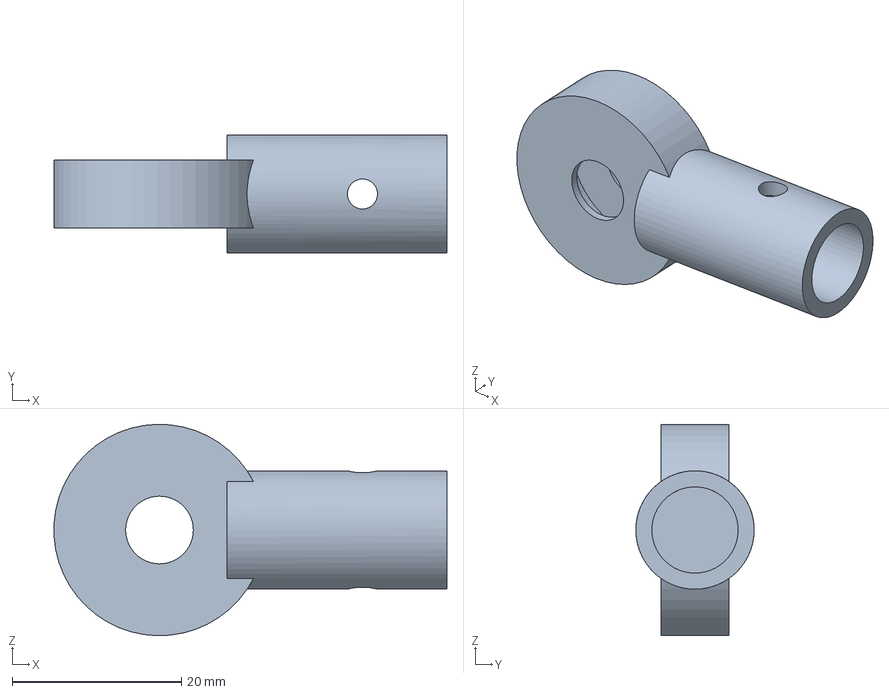
[picture p48: CAD file, 2026-10-12]
output/step/parts/33_rod_end.step
46.5 x 14.0 x 25.0 mm
