landen-finkel-engineering/ROLLO-Wheelchair-Arm/output/step/parts/41_pitch_yoke.step

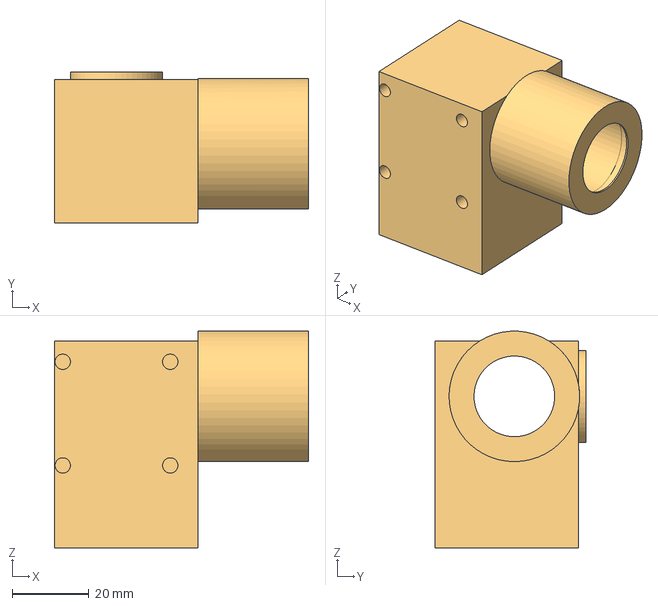
[picture p49: CAD file, 2026-10-12]
output/step/parts/41_pitch_yoke.step
66.2 x 39.3 x 56.4 mm
