landen-finkel-engineering/ROLLO-Wheelchair-Arm/output/step/parts/01_receiver.step

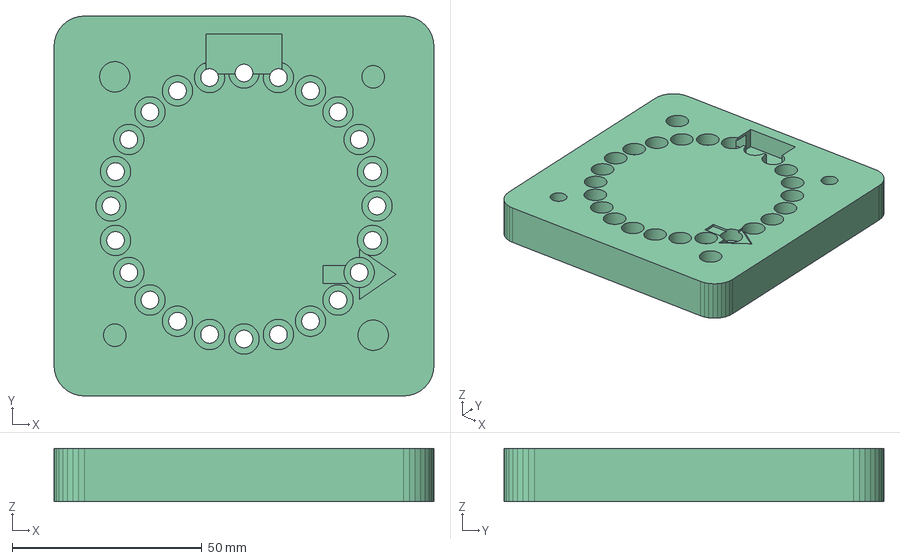
[picture p50: CAD file, 2026-10-12]
output/step/parts/01_receiver.step
100.0 x 100.0 x 14.0 mm
