landen-finkel-engineering/ROLLO-Wheelchair-Arm/output/step/parts/80_cs_gear_front.step

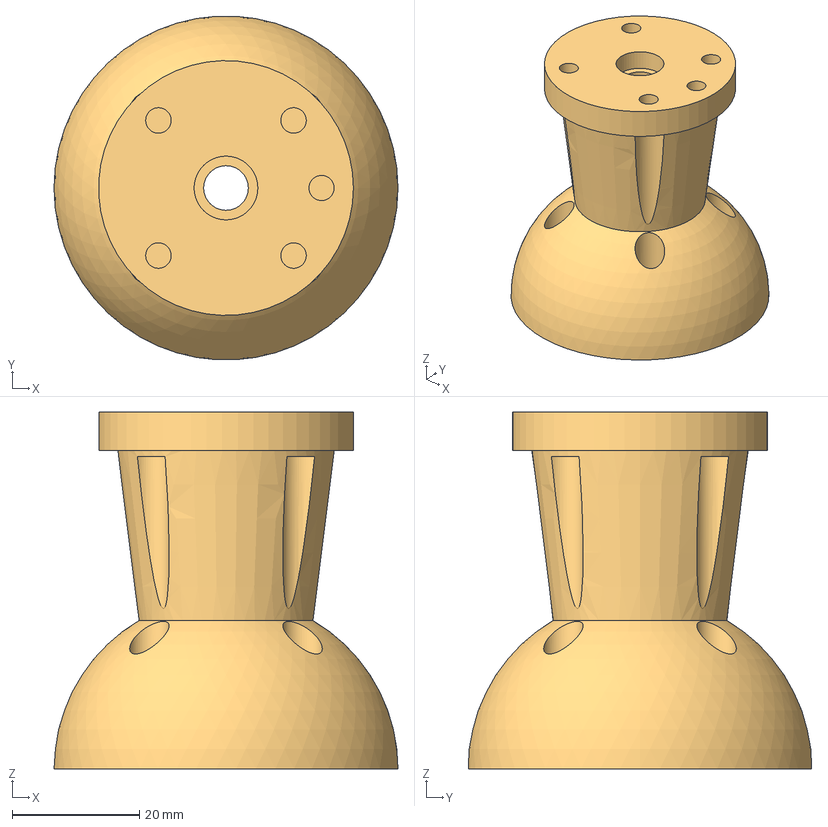
[picture p51: CAD file, 2026-10-12]
output/step/parts/80_cs_gear_front.step
54.0 x 53.9 x 56.0 mm
