landen-finkel-engineering/ROLLO-Wheelchair-Arm/output/step/parts/82_monopole.step

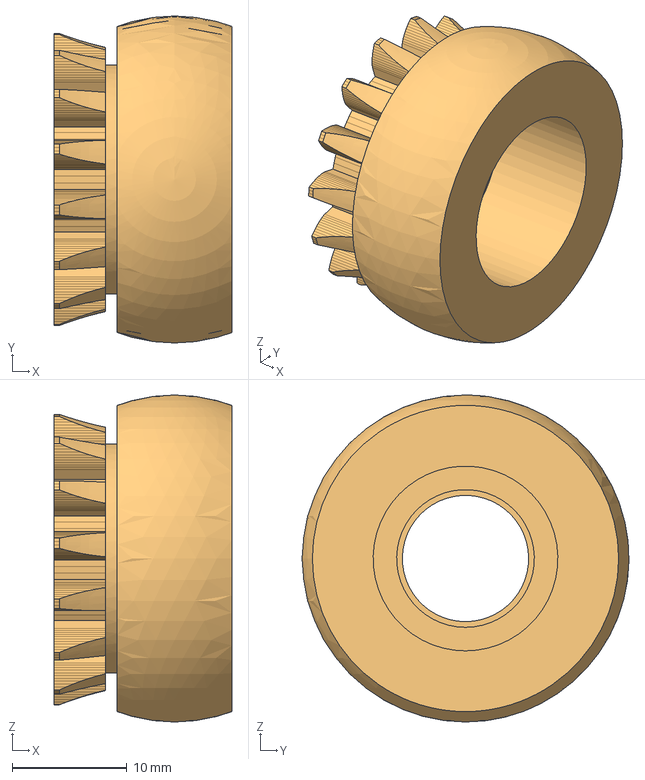
[picture p52: CAD file, 2026-10-12]
output/step/parts/82_monopole.step
15.5 x 28.5 x 28.5 mm
