landen-finkel-engineering/ROLLO-Wheelchair-Arm/output/step/parts/32_elbow_block.step

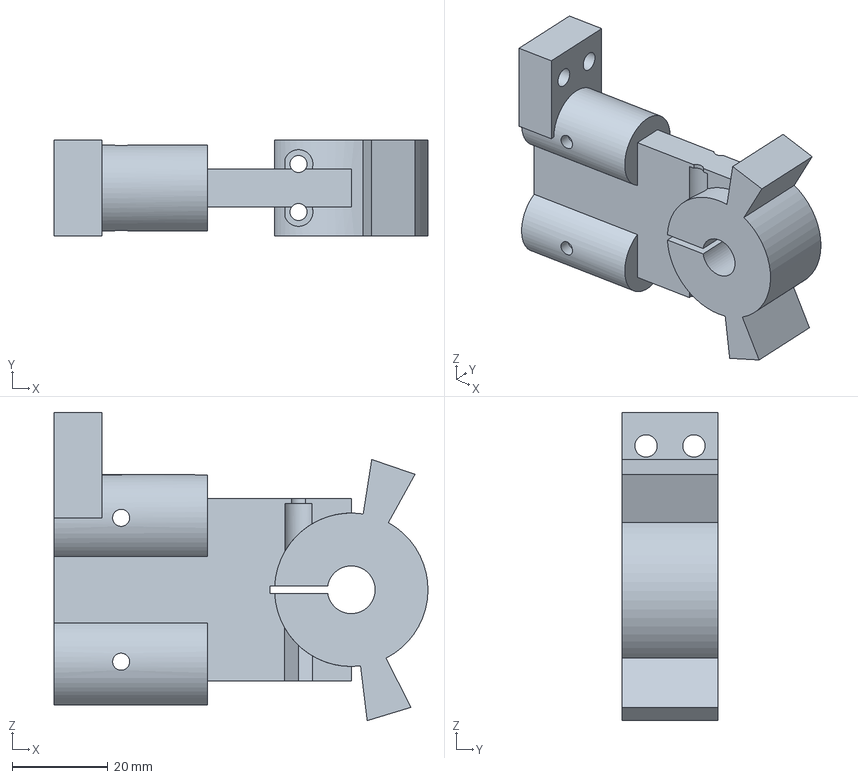
[picture p53: CAD file, 2026-10-12]
output/step/parts/32_elbow_block.step
78.0 x 20.0 x 64.3 mm
