landen-finkel-engineering/ROLLO-Wheelchair-Arm/output/step/parts/31_j3_hub.step

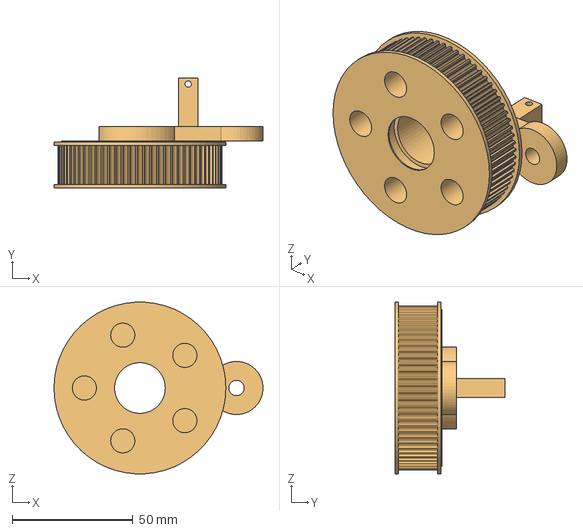
[picture p54: CAD file, 2026-10-12]
output/step/parts/31_j3_hub.step
86.6 x 45.5 x 71.1 mm
