landen-finkel-engineering/ROLLO-Wheelchair-Arm/output/step/parts/04_post_bracket.step

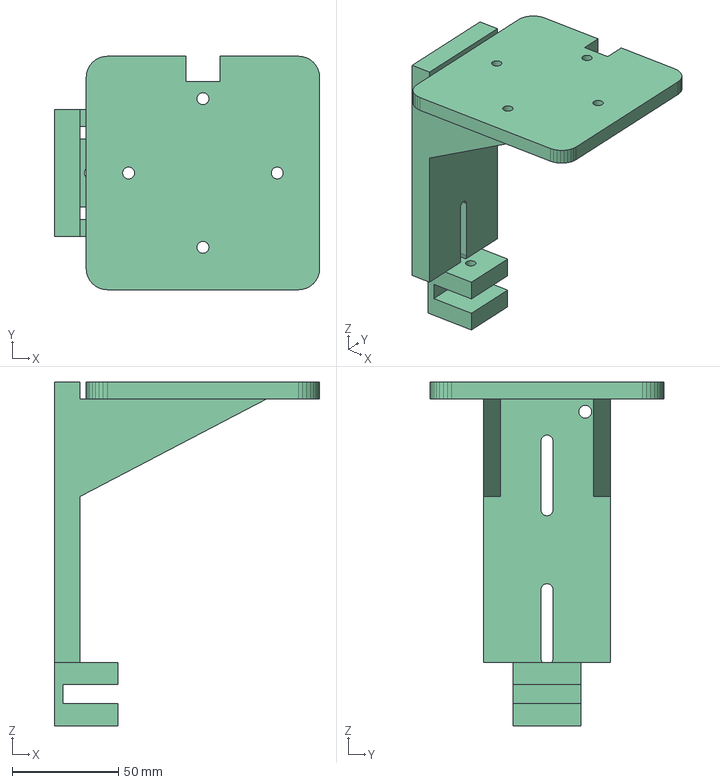
[picture p55: CAD file, 2026-10-12]
output/step/parts/04_post_bracket.step
125.0 x 110.0 x 162.0 mm
