landen-finkel-engineering/ROLLO-Wheelchair-Arm/output/step/parts/30_ua_hub.step

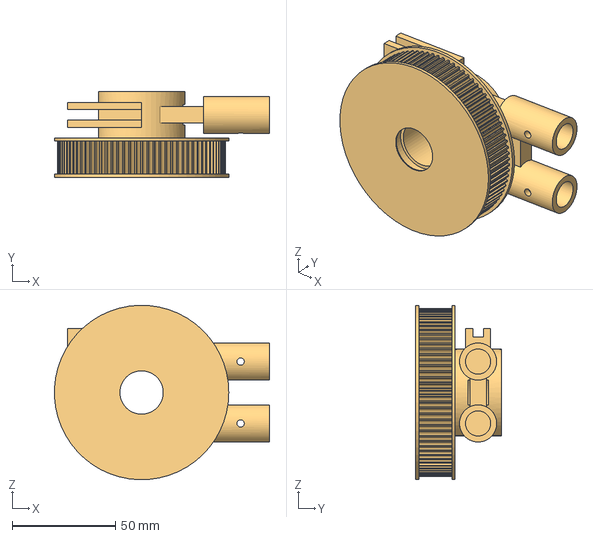
[picture p56: CAD file, 2026-10-12]
output/step/parts/30_ua_hub.step
104.2 x 41.5 x 84.5 mm
