landen-finkel-engineering/ROLLO-Wheelchair-Arm/output/step/parts/45_roll_spindle.step

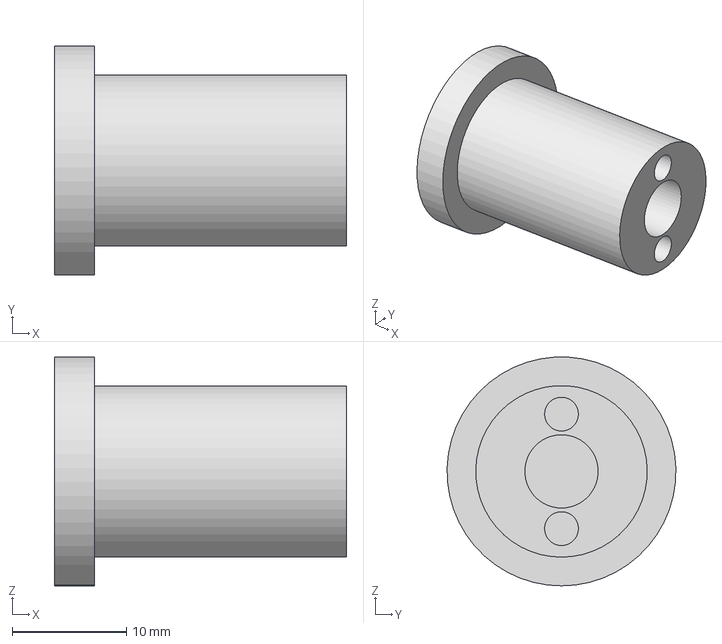
[picture p57: CAD file, 2026-10-12]
output/step/parts/45_roll_spindle.step
25.5 x 20.0 x 20.0 mm
