landen-finkel-engineering/ROLLO-Wheelchair-Arm/output/step/parts/91_holder_retainer.step

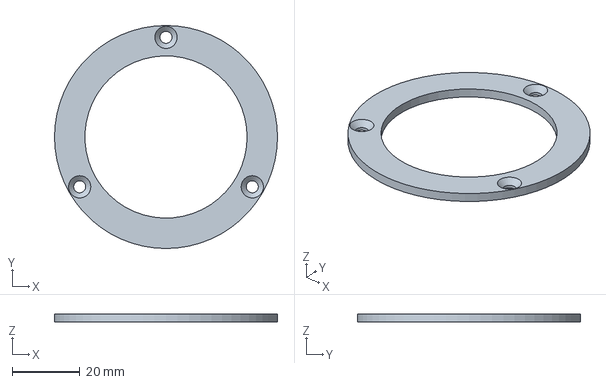
[picture p58: CAD file, 2026-10-12]
output/step/parts/91_holder_retainer.step
66.0 x 66.0 x 2.50 mm
