landen-finkel-engineering/ROLLO-Wheelchair-Arm/output/step/parts/61_electronics_lid.step

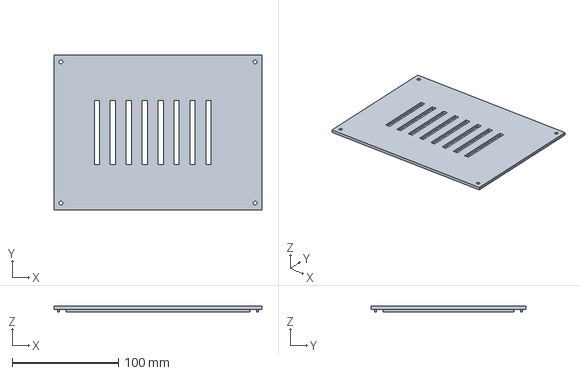
[picture p59: CAD file, 2026-10-12]
output/step/parts/61_electronics_lid.step
196.0 x 146.0 x 5.20 mm
