landen-finkel-engineering/ROLLO-Wheelchair-Arm/output/step/parts/70_bench_test_stand.step

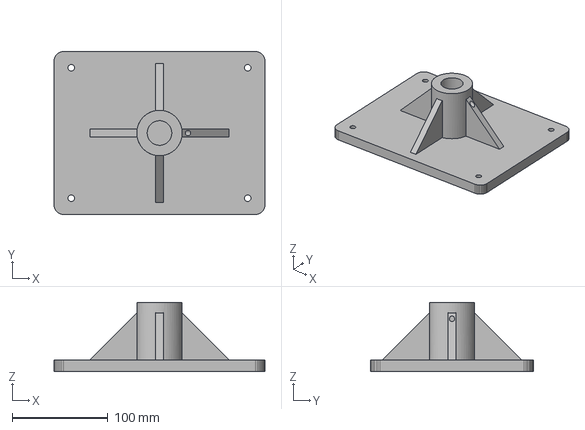
[picture p60: CAD file, 2026-10-12]
output/step/parts/70_bench_test_stand.step
220.0 x 170.0 x 72.0 mm
