landen-finkel-engineering/ROLLO-Wheelchair-Arm/output/step/parts/62_estop_pendant.step

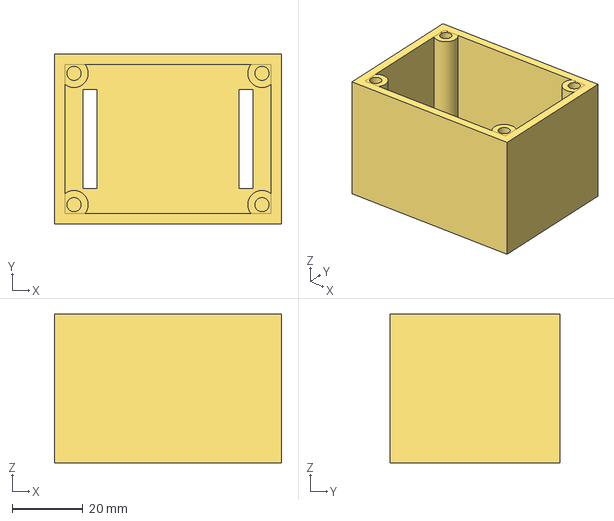
[picture p61: CAD file, 2026-10-12]
output/step/parts/62_estop_pendant.step
64.0 x 48.0 x 42.0 mm
