landen-finkel-engineering/ROLLO-Wheelchair-Arm/output/step/parts/93_mp_spacer.step

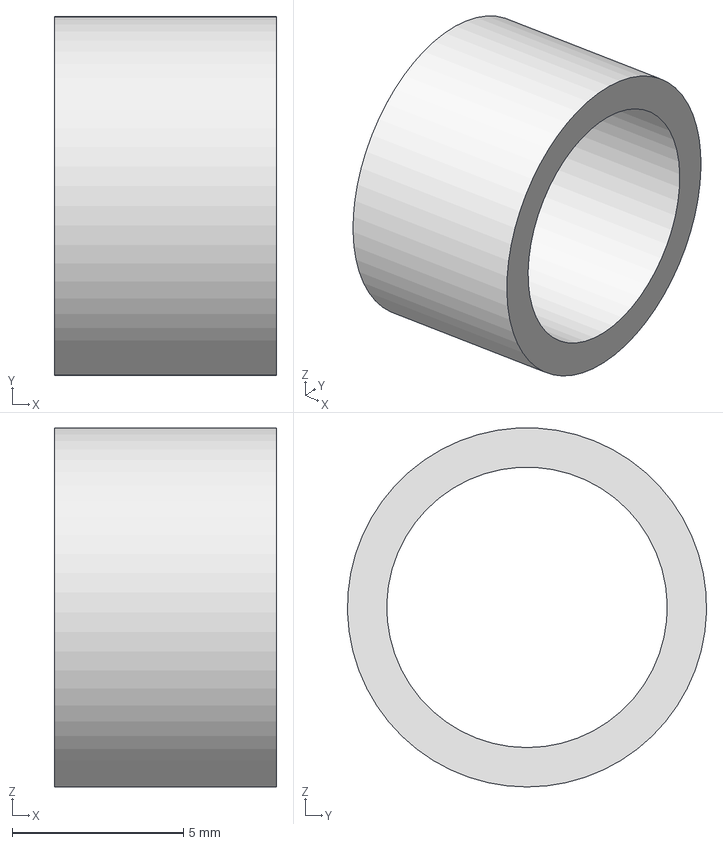
[picture p62: CAD file, 2026-10-12]
output/step/parts/93_mp_spacer.step
6.50 x 10.5 x 10.5 mm
