landen-finkel-engineering/ROLLO-Wheelchair-Arm/output/step/parts/12_dm_bracket.step

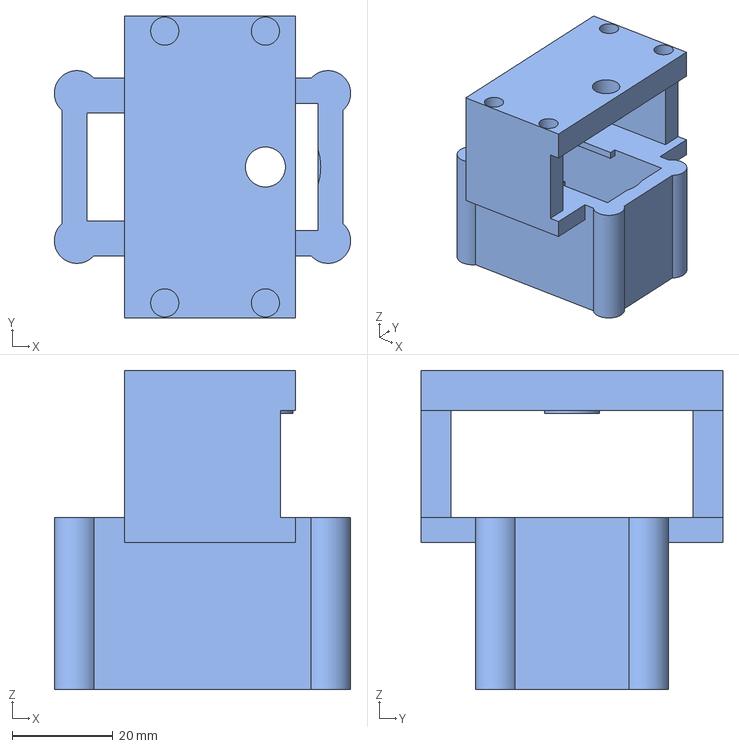
[picture p63: CAD file, 2026-10-12]
output/step/parts/12_dm_bracket.step
58.9 x 60.0 x 63.5 mm
