landen-finkel-engineering/ROLLO-Wheelchair-Arm/output/step/parts/50_claw_palm.step

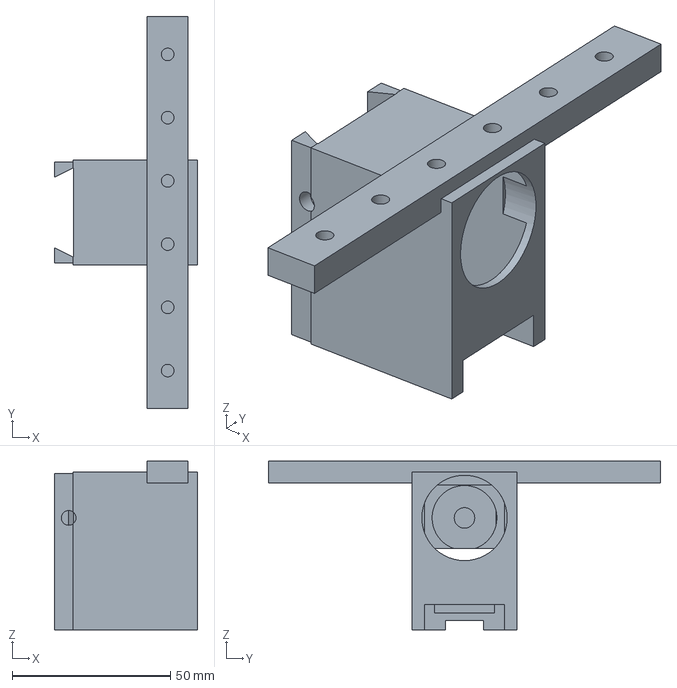
[picture p64: CAD file, 2026-10-12]
output/step/parts/50_claw_palm.step
45.2 x 124.0 x 53.5 mm
