landen-finkel-engineering/ROLLO-Wheelchair-Arm/output/step/parts/11_j1_fixed_pulley.step

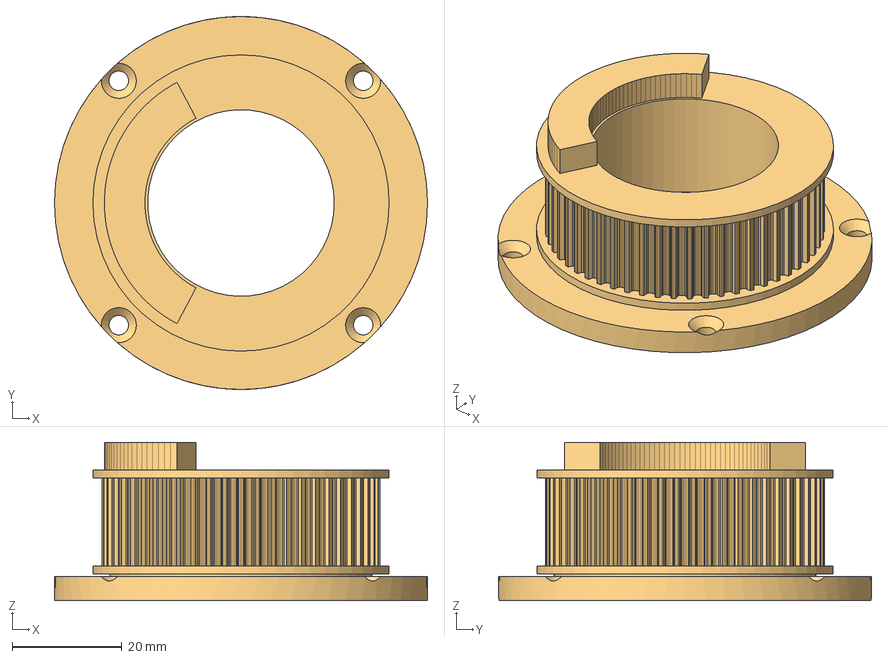
[picture p65: CAD file, 2026-10-12]
output/step/parts/11_j1_fixed_pulley.step
68.0 x 68.0 x 28.8 mm
