landen-finkel-engineering/ROLLO-Wheelchair-Arm/output/step/parts/12_dm_pulley36.step

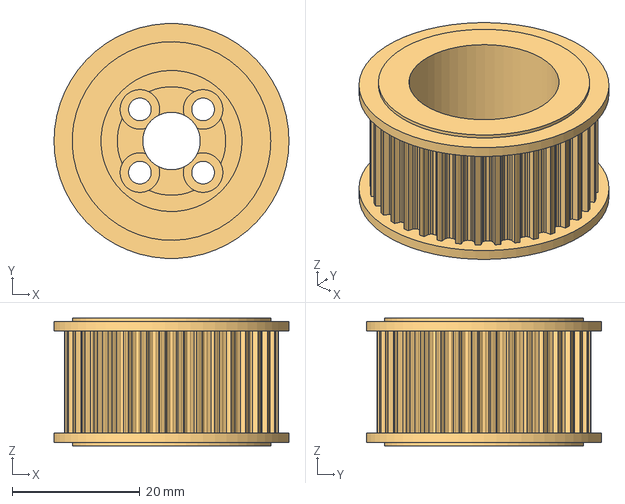
[picture p66: CAD file, 2026-10-12]
output/step/parts/12_dm_pulley36.step
36.8 x 36.8 x 20.0 mm
