landen-finkel-engineering/ROLLO-Wheelchair-Arm/output/step/parts/47_roll_spacer.step

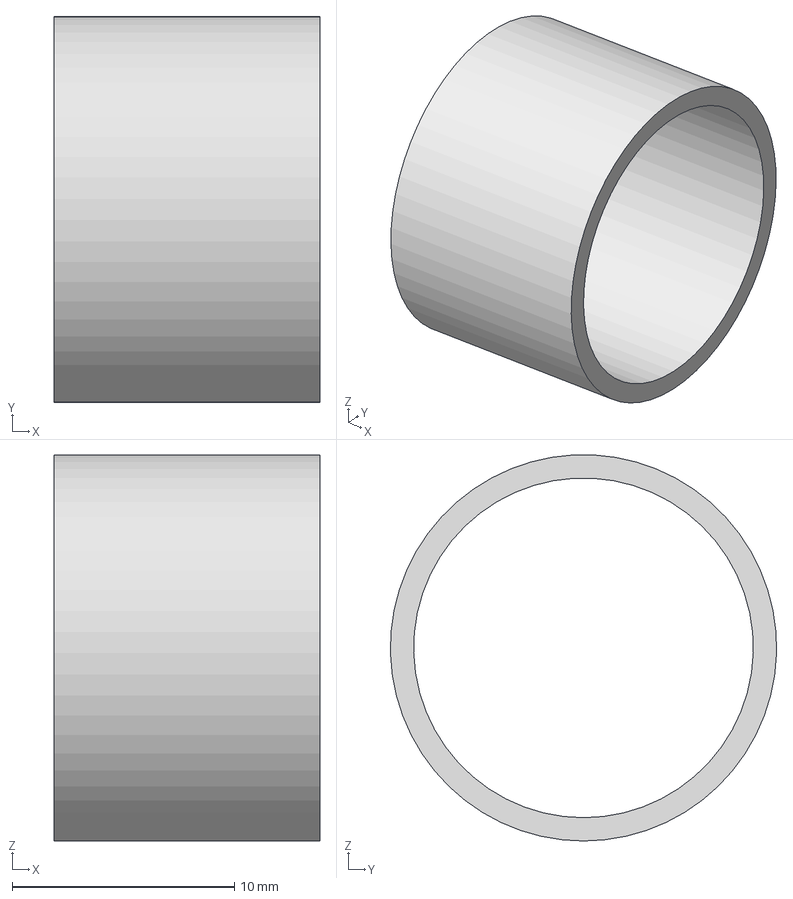
[picture p67: CAD file, 2026-10-12]
output/step/parts/47_roll_spacer.step
12.0 x 17.4 x 17.4 mm
