landen-finkel-engineering/ROLLO-Wheelchair-Arm/output/step/parts/10_base_housing.step

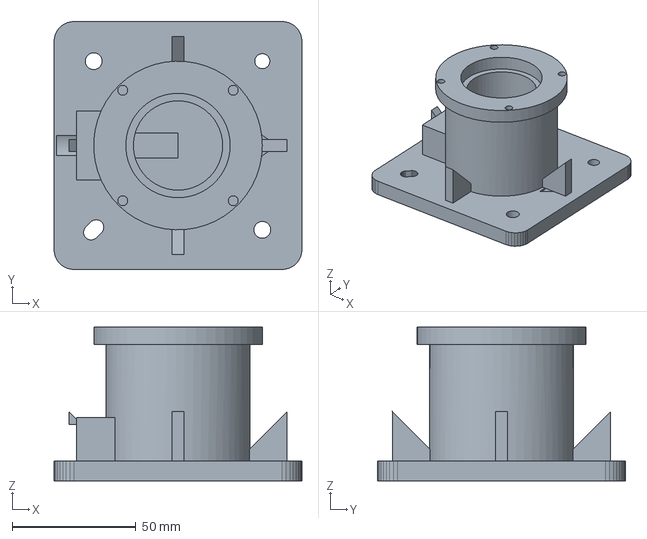
[picture p68: CAD file, 2026-10-12]
output/step/parts/10_base_housing.step
100.0 x 100.0 x 62.0 mm
