landen-finkel-engineering/ROLLO-Wheelchair-Arm/output/step/parts/56_tool_adapter.step

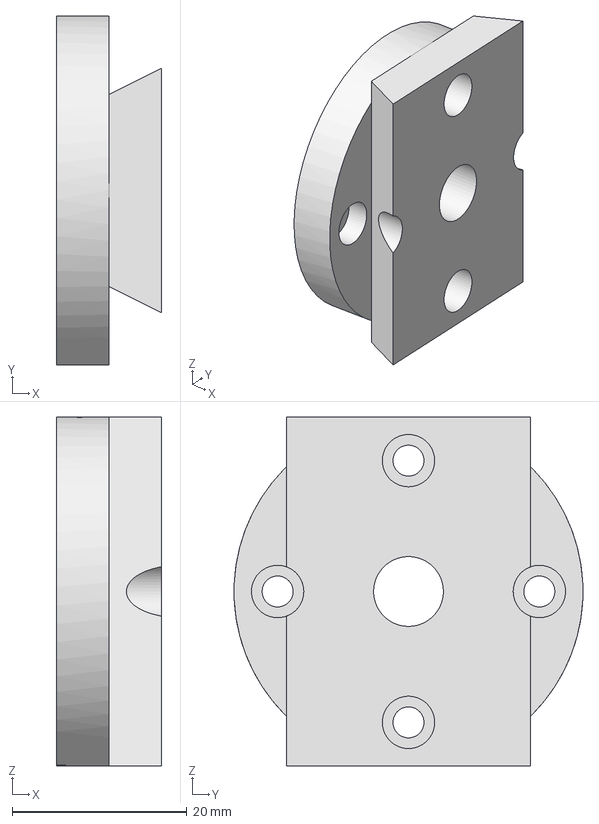
[picture p69: CAD file, 2026-10-12]
output/step/parts/56_tool_adapter.step
12.0 x 40.0 x 40.0 mm
