landen-finkel-engineering/ROLLO-Wheelchair-Arm/output/step/parts/53_claw_jaw_b.step

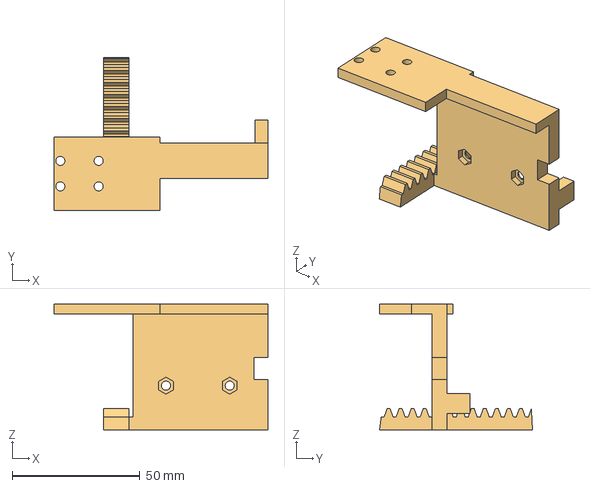
[picture p70: CAD file, 2026-10-12]
output/step/parts/53_claw_jaw_b.step
83.9 x 60.0 x 49.4 mm
