landen-finkel-engineering/ROLLO-Wheelchair-Arm/output/step/parts/89_abenics_housing.step

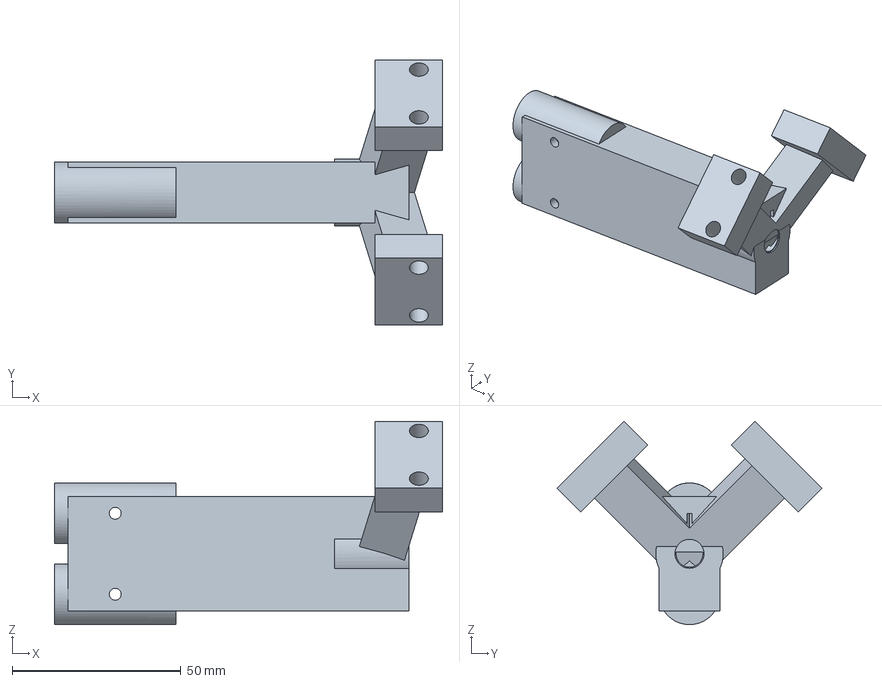
[picture p71: CAD file, 2026-10-12]
output/step/parts/89_abenics_housing.step
115.0 x 78.5 x 60.2 mm
