landen-finkel-engineering/ROLLO-Wheelchair-Arm/output/step/parts/54_claw_pad_b.step

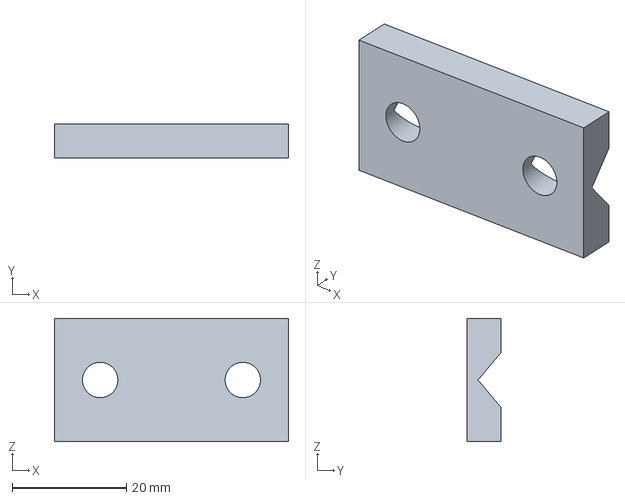
[picture p72: CAD file, 2026-10-12]
output/step/parts/54_claw_pad_b.step
41.0 x 5.90 x 21.6 mm
