landen-finkel-engineering/ROLLO-Wheelchair-Arm/output/step/parts/03_tube_clamp_cap.step

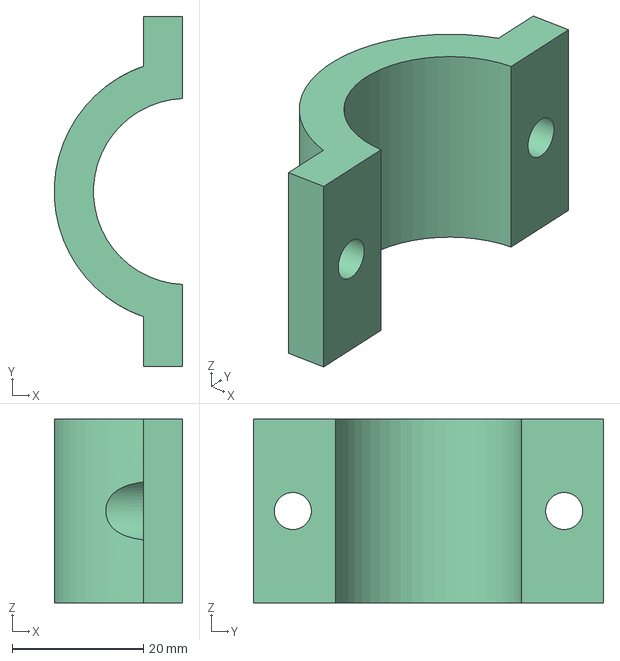
[picture p73: CAD file, 2026-10-12]
output/step/parts/03_tube_clamp_cap.step
19.6 x 53.4 x 28.0 mm
