landen-finkel-engineering/ROLLO-Wheelchair-Arm/output/step/parts/05_stop_collar.step

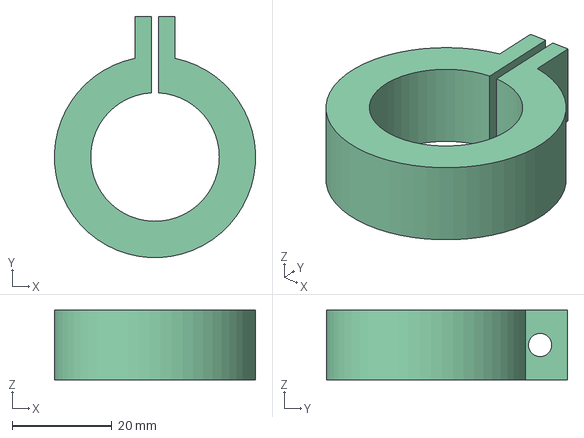
[picture p74: CAD file, 2026-10-12]
output/step/parts/05_stop_collar.step
40.4 x 48.4 x 14.0 mm
