landen-finkel-engineering/ROLLO-Wheelchair-Arm/output/step/parts/46_tool_flange.step

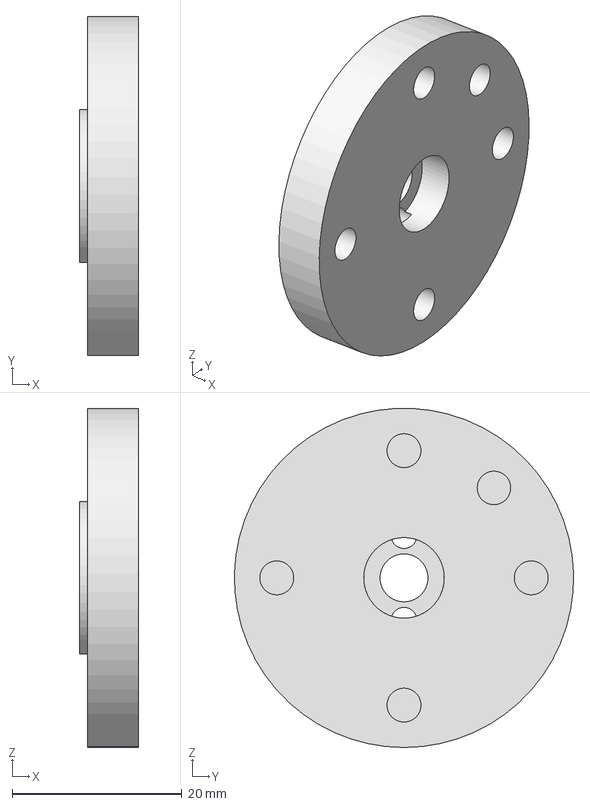
[picture p75: CAD file, 2026-10-12]
output/step/parts/46_tool_flange.step
6.95 x 40.0 x 40.0 mm
