landen-finkel-engineering/ROLLO-Wheelchair-Arm/output/step/parts/43_j4_pulley54.step

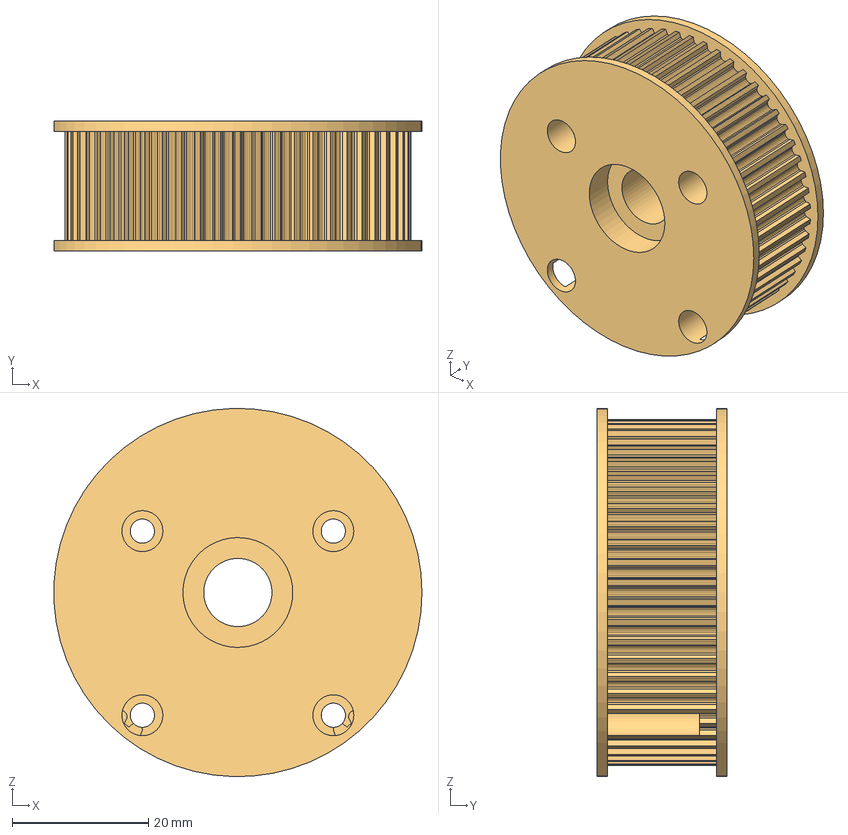
[picture p76: CAD file, 2026-10-12]
output/step/parts/43_j4_pulley54.step
54.0 x 19.0 x 54.0 mm
