landen-finkel-engineering/ROLLO-Wheelchair-Arm/output/step/parts/21_stub_cheek.step

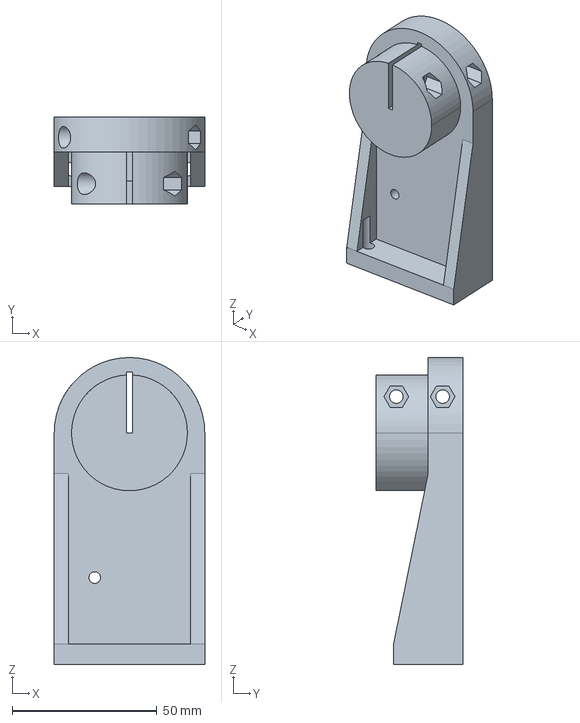
[picture p77: CAD file, 2026-10-12]
output/step/parts/21_stub_cheek.step
52.0 x 30.0 x 106.0 mm
