landen-finkel-engineering/ROLLO-Wheelchair-Arm/output/step/parts/52_claw_pinion.step

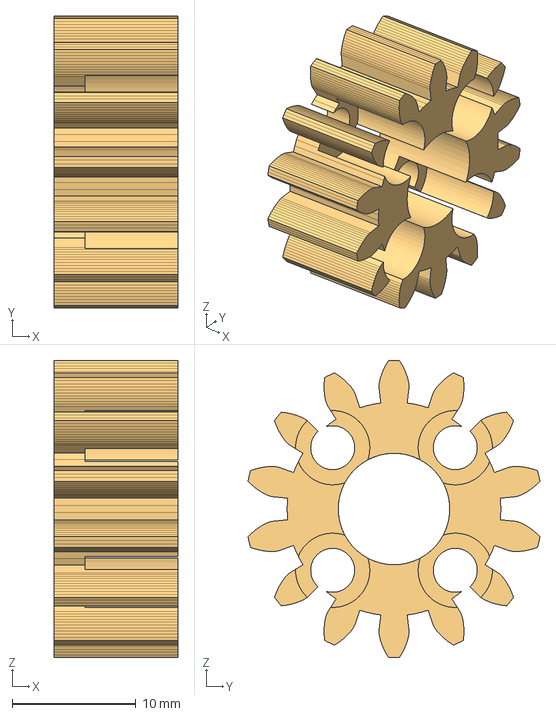
[picture p78: CAD file, 2026-10-12]
output/step/parts/52_claw_pinion.step
10.0 x 23.6 x 24.0 mm
