landen-finkel-engineering/ROLLO-Wheelchair-Arm/output/step/parts/84_mp_cradle.step

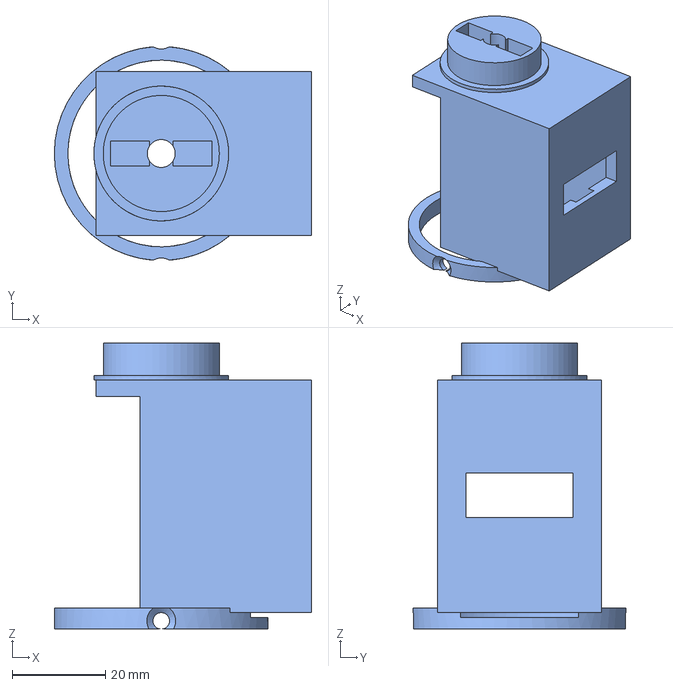
[picture p79: CAD file, 2026-10-12]
output/step/parts/84_mp_cradle.step
55.4 x 45.9 x 61.5 mm
