landen-finkel-engineering/ROLLO-Wheelchair-Arm/output/step/parts/34_forearm_root.step

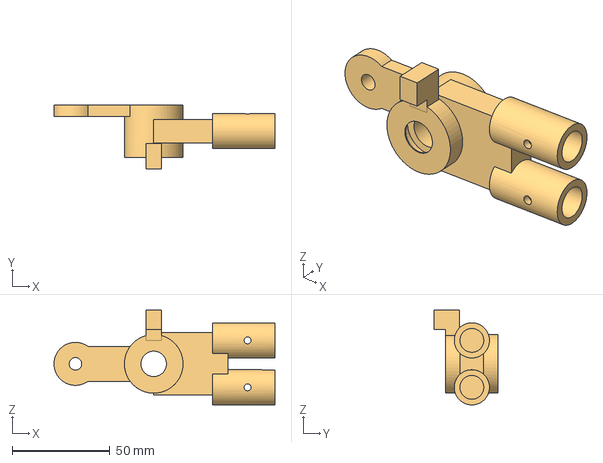
[picture p80: CAD file, 2026-10-12]
output/step/parts/34_forearm_root.step
113.0 x 32.8 x 48.5 mm
