landen-finkel-engineering/ROLLO-Wheelchair-Arm/output/step/parts/12_dm_cap.step

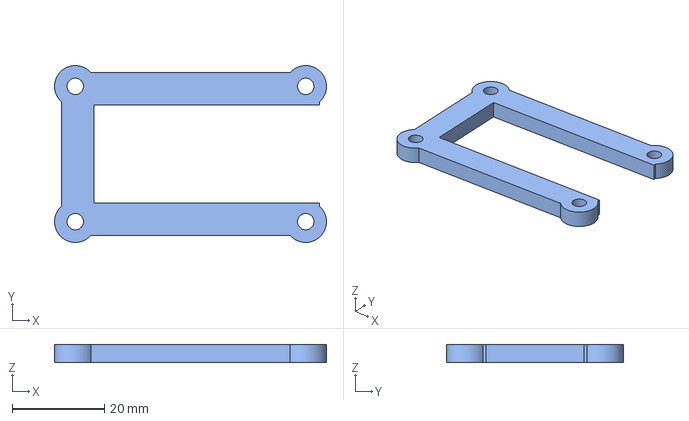
[picture p81: CAD file, 2026-10-12]
output/step/parts/12_dm_cap.step
58.9 x 38.3 x 4.00 mm
