landen-finkel-engineering/ROLLO-Wheelchair-Arm/output/step/parts/87_module_frame.step

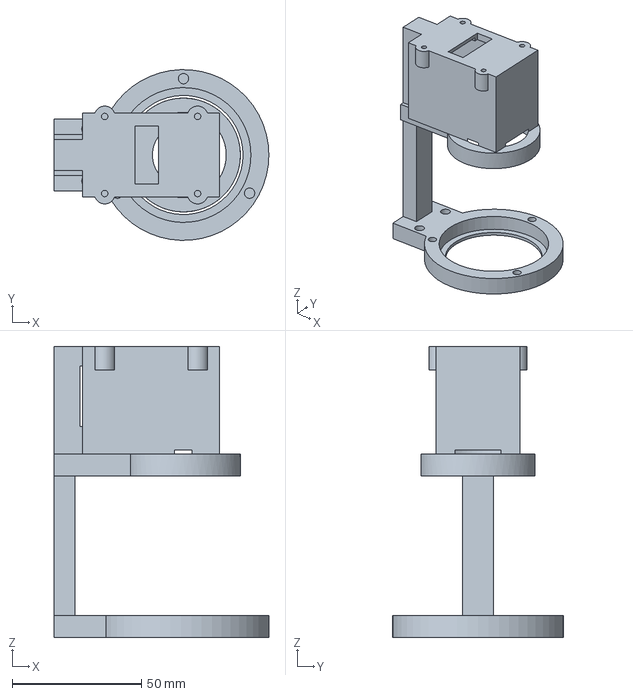
[picture p82: CAD file, 2026-10-12]
output/step/parts/87_module_frame.step
83.0 x 66.0 x 112.4 mm
