landen-finkel-engineering/ROLLO-Wheelchair-Arm/output/step/parts/83_mp_fork.step

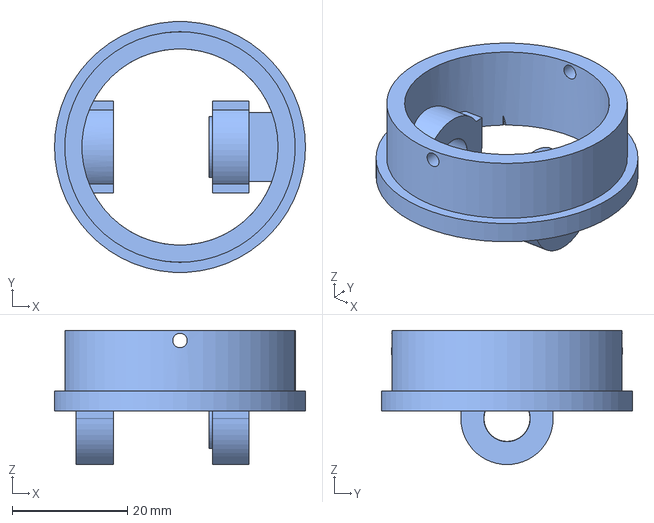
[picture p83: CAD file, 2026-10-12]
output/step/parts/83_mp_fork.step
43.5 x 43.4 x 23.2 mm
