landen-finkel-engineering/ROLLO-Wheelchair-Arm/output/step/parts/60_electronics_box.step

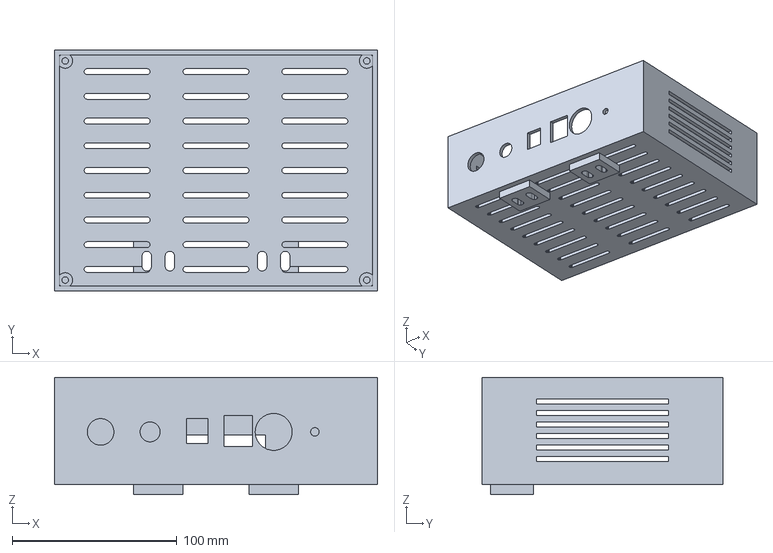
[picture p84: CAD file, 2026-10-12]
output/step/parts/60_electronics_box.step
196.0 x 146.0 x 71.0 mm
