landen-finkel-engineering/ROLLO-Wheelchair-Arm/output/step/parts/22_ddm_bracket_j3.step

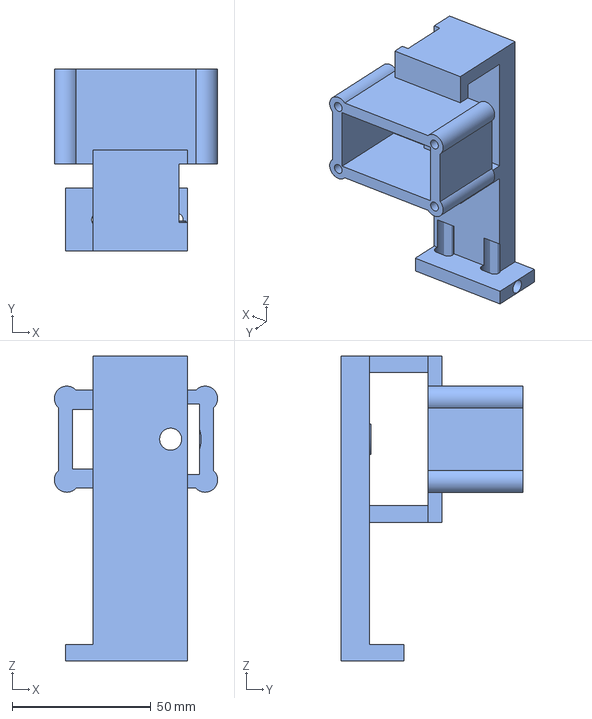
[picture p85: CAD file, 2026-10-12]
output/step/parts/22_ddm_bracket_j3.step
58.9 x 65.7 x 110.0 mm
