landen-finkel-engineering/ROLLO-Wheelchair-Arm/output/step/parts/90_center_ball.step

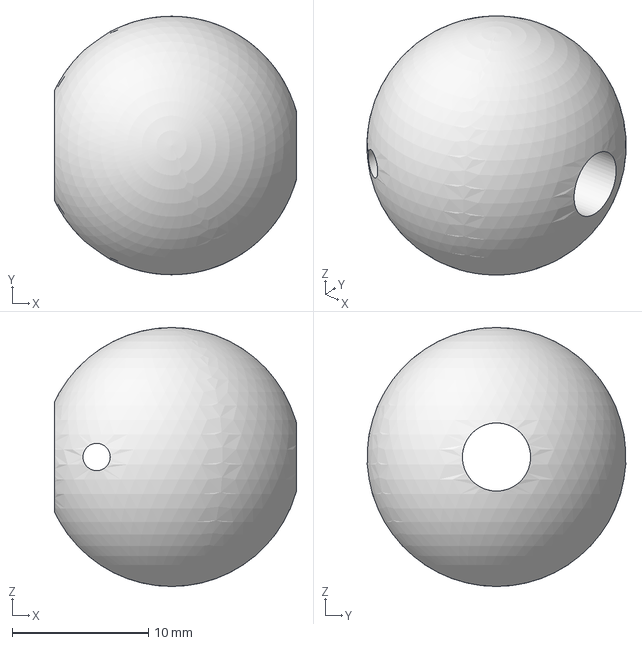
[picture p86: CAD file, 2026-10-12]
output/step/parts/90_center_ball.step
17.8 x 19.0 x 19.0 mm
