landen-finkel-engineering/ROLLO-Wheelchair-Arm/output/step/parts/22_ddm_bracket_j2.step

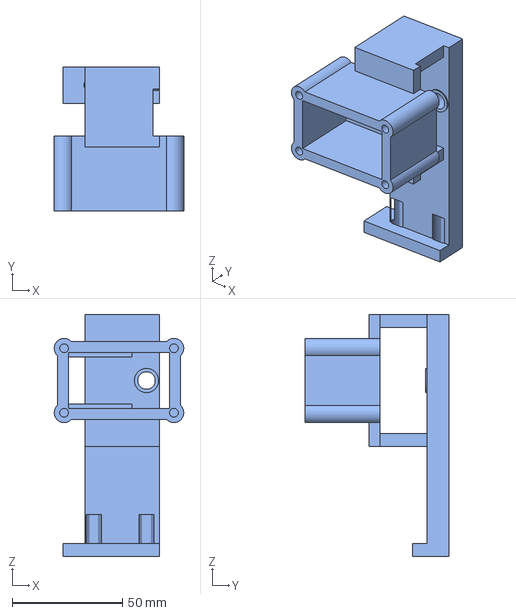
[picture p87: CAD file, 2026-10-12]
output/step/parts/22_ddm_bracket_j2.step
58.9 x 65.6 x 110.0 mm
