landen-finkel-engineering/ROLLO-Wheelchair-Arm/output/step/parts/86_q_coupling.step

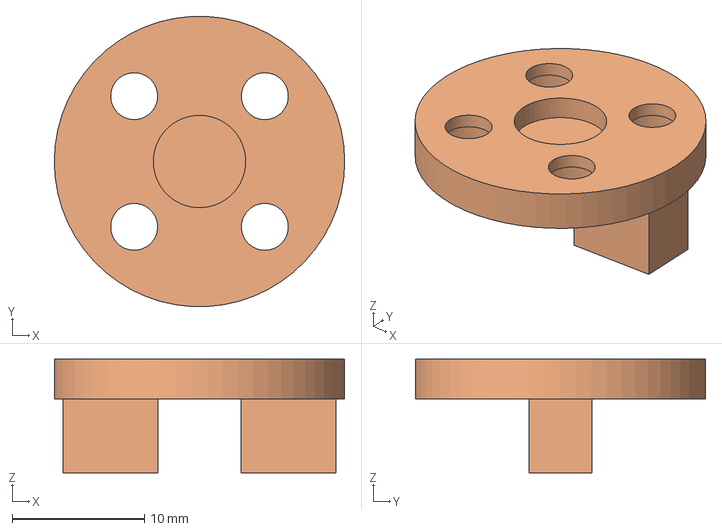
[picture p88: CAD file, 2026-10-12]
output/step/parts/86_q_coupling.step
22.0 x 22.0 x 8.60 mm
