landen-finkel-engineering/ROLLO-Wheelchair-Arm/output/step/parts/53_claw_jaw_a.step

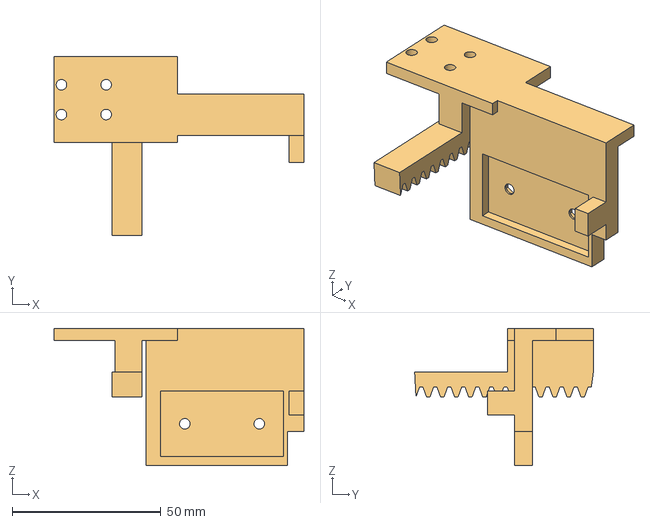
[picture p89: CAD file, 2026-10-12]
output/step/parts/53_claw_jaw_a.step
83.9 x 60.0 x 46.0 mm
