landen-finkel-engineering/ROLLO-Wheelchair-Arm/output/step/parts/92_cradle_strap.step

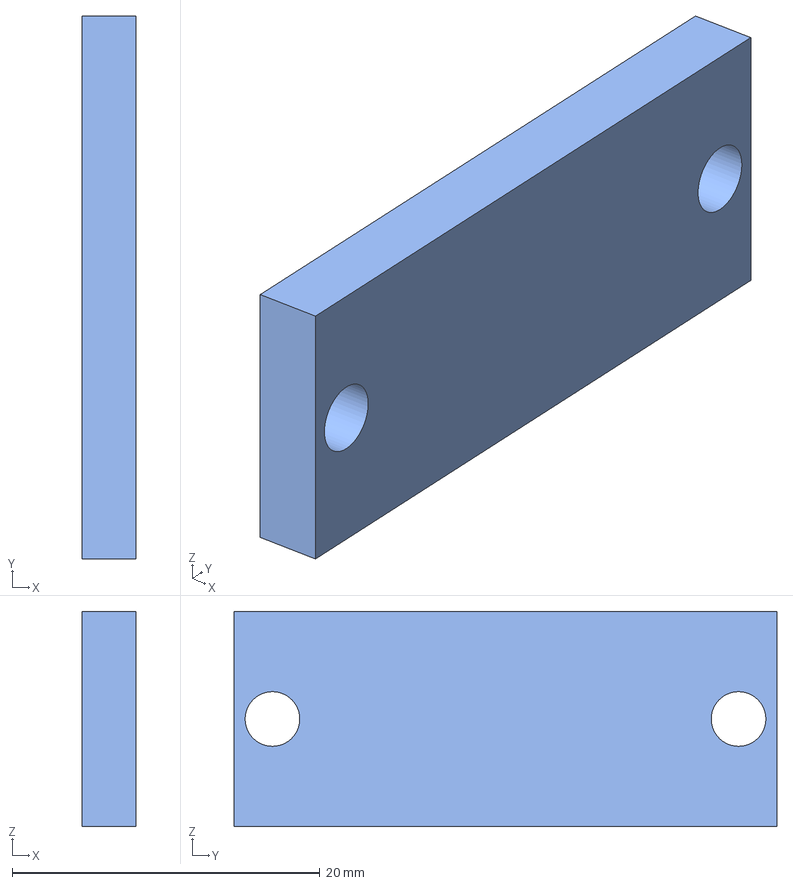
[picture p90: CAD file, 2026-10-12]
output/step/parts/92_cradle_strap.step
3.50 x 35.3 x 14.0 mm
