landen-finkel-engineering/ROLLO-Wheelchair-Arm/(list of files, cad)

Other CAD files:
output/step/parts/54_claw_pad_a.step
output/stl/00_fit_test_coupon.stl
output/stl/01_receiver.stl
output/stl/02_tube_clamp_body.stl
output/stl/03_tube_clamp_cap.stl
output/stl/04_post_bracket.stl
output/stl/05_stop_collar.stl
output/stl/10_base_housing.stl
output/stl/11_j1_fixed_pulley.stl
output/stl/12_dm_bracket.stl
output/stl/12_dm_cap.stl
output/stl/12_dm_pulley36.stl
output/stl/20_turntable.stl
output/stl/21_stub_cheek.stl
output/stl/22_ddm_bracket_j2.stl
output/stl/22_ddm_bracket_j3.stl
output/stl/30_ua_hub.stl
output/stl/31_j3_hub.stl
output/stl/32_elbow_block.stl
output/stl/33_rod_end.stl
output/stl/34_forearm_root.stl
output/stl/35_stub_spacer_14p46mm.stl
output/stl/35_stub_spacer_30p96mm.stl
output/stl/40_wrist_housing.stl
output/stl/41_pitch_yoke.stl
output/stl/42_yoke_cap.stl
output/stl/43_j4_pulley54.stl
output/stl/44_j5_horn_adapter.stl
output/stl/45_roll_spindle.stl
output/stl/46_tool_flange.stl
output/stl/47_roll_spacer.stl
output/stl/50_claw_palm.stl
output/stl/51_claw_cradle_cap.stl
output/stl/52_claw_pinion.stl
output/stl/53_claw_jaw_a.stl
output/stl/53_claw_jaw_b.stl
output/stl/54_claw_pad_a.stl
output/stl/54_claw_pad_b.stl
output/stl/56_tool_adapter.stl
output/stl/60_electronics_box.stl
output/stl/61_electronics_lid.stl
output/stl/62_estop_pendant.stl
output/stl/63_estop_pendant_lid.stl
output/stl/70_bench_test_stand.stl
output/stl/80_cs_gear_front.stl
output/stl/81_cs_gear_back.stl
output/stl/82_monopole.stl
output/stl/83_mp_fork.stl
output/stl/84_mp_cradle.stl
output/stl/85_theta_gear.stl
output/stl/86_q_coupling.stl
output/stl/87_module_frame.stl
output/stl/88_q_servo_cap.stl
output/stl/89_abenics_housing.stl
output/stl/90_center_ball.stl
output/stl/91_holder_retainer.stl
output/stl/92_cradle_strap.stl
output/stl/93_mp_spacer.stl
