landen-finkel-engineering/ROLLO-Wheelchair-Arm/docs/13_print_guide.md

# 13 - Print guide (GENERATED by `python cad/build.py --parts`; do not edit)

Active variant **WRA-1A**: 49 part files, 72 prints, about **2.6 kg** of filament and roughly **105 h** of printing at ~25 g/h [E].

## Printer and slicer (Bambu Lab P1S, 256 x 256 x 256 mm)

* Every STL in `output/stl/` is already in its PRINT ORIENTATION, sitting on z = 0: import, do not rotate.
* Nozzle: 0.4 mm **hardened steel** for any CF filament (PA-CF / PETG-CF are abrasive).
* PA-CF: dry 8 h at 80 C before printing, print from a dry box, enclosure closed, textured PEI plate with glue stick, bed 80-100 C.  PETG: 0.2 mm layers, bed 70-80 C.  TPU 95A (pads): 25 mm/s.
* Gears / pulleys / racks: 0.12 mm layers, 100 % infill, no ironing; check the first tooth with calipers.
* Structural parts: walls and infill below are minimums; 0.2 mm layers; no 'thin wall' detection shortcuts.
* Print `00_fit_test_coupon` first and tune `fit.*` in params.yaml (docs/04) before the real parts.
* ABENICS `80/81/82`: print the **STL** (it has the teeth); the STEP files are tooth-less blanks.

## Parts (active variant)

| part | qty | material | walls / infill | supports | bed footprint (mm) | g each | orientation / notes |
|---|---|---|---|---|---|---|---|
| 00_fit_test_coupon | 1 | same as production | 4 / 40% | none | 170 x 64 x 10 | 61 | - |
| 01_receiver | 1 | PETG (PA-CF optional) | 6 / 50% gyroid | none | 100 x 100 x 14 | 104 | Top face DOWN on the plate (flat dock face). Dowels pressed in after printing. |
| 02_tube_clamp_body | 5 | PA-CF recommended (PETG ok) | 6 / 80% | none | 22 x 53 x 28 | 15 | Ring end-face down (layers wrap the tube). Re-torque after 24 h (creep). |
| 03_tube_clamp_cap | 5 | PA-CF recommended (PETG ok) | 6 / 80% | none | 20 x 53 x 28 | 12 | - |
| 04_post_bracket | 1 | PA-CF recommended | 6 / 60% gyroid | none | 162 x 110 x 125 | 211 | Spine back face down: gussets and shelf print as vertical walls. Aluminium alternative: see output/dxf/04_post_bracket_plates.dxf. |
| 05_stop_collar | 1 | PETG | 6 / 80% | none | 40 x 48 x 14 | 13 | - |
| 10_base_housing | 1 | PA-CF (required: dock plate bending) | 6 / 40% gyroid | none | 100 x 100 x 62 | 122 | Dock face on plate. Bearing seats print vertical = round. Supports: only under the connector boss (build-plate only). |
| 11_j1_fixed_pulley | 1 | PETG | 6 / 100% | none | 68 x 68 x 29 | 42 | Base disc down. 0.16 mm layers. |
| 12_dm_bracket | 1 | PETG | 5 / 50% gyroid | none | 59 x 60 x 64 | 53 | Pin wall down on the plate (mounting face flat). Supports: none needed except under the cable window bridge (auto, build-plate only). |
| 12_dm_cap | 3 | PETG | 4 / 40% gyroid | none | 59 x 38 x 4 | 4 | - |
| 12_dm_pulley36 | 3 | PETG | 6 / 100% | none | 37 x 37 x 20 | 14 | Horn face down. 0.16 mm layers for tooth quality; 100% infill. |
| 20_turntable | 1 | PETG (PA-CF optional) | 6 / 40% gyroid | none | 158 x 120 x 135 | 179 | Plate TOP face down, spindle pointing up (bearing journals print round). Supports from build plate under the tension lug only. |
| 21_stub_cheek | 1 | PETG (PA-CF recommended) | 6 / 60% gyroid | none | 52 x 106 x 30 | 80 | Lay on its INBOARD face (stub axis vertical) so the clamp boss layers wrap the stub; gussets then print as walls. |
| 22_ddm_bracket_j2 | 1 | PETG | 5 / 50% gyroid | none | 59 x 110 x 66 | 72 | Central-wall face (split plane) DOWN. Supports: build-plate only under servo-cradle lips. |
| 22_ddm_bracket_j3 | 1 | PETG | 5 / 50% gyroid | none | 59 x 110 x 66 | 74 | Central-wall face (split plane) DOWN. Supports: build-plate only under servo-cradle lips. |
| 30_ua_hub | 1 | PETG (PA-CF recommended) | 6 / 60% gyroid | none | 104 x 85 x 42 | 126 | Pulley flange (-Y face) down: teeth and bearing seats vertical. Tube sockets horizontal: supports OFF (bores bridge as teardrops). |
| 31_j3_hub | 1 | PETG (PA-CF recommended) | 6 / 60% gyroid | none | 87 x 71 x 46 | 62 | Pulley flange down; L-lever prints upward. |
| 32_elbow_block | 1 | PETG (PA-CF recommended) | 6 / 60% gyroid | none | 78 x 64 x 20 | 40 | - |
| 33_rod_end | 2 | PETG | 5 / 80% | none | 46 x 25 x 14 | 5 | - |
| 34_forearm_root | 1 | PETG (PA-CF recommended) | 6 / 60% gyroid | none | 113 x 48 x 33 | 39 | - |
| 35_stub_spacer_14p46mm | 1 | PETG | 3 / 100% | none | 17 x 17 x 14 | 1 | Print upright (axis Z), 0.12 mm layers. |
| 35_stub_spacer_30p96mm | 1 | PETG | 3 / 100% | none | 17 x 17 x 31 | 2 | Print upright (axis Z), 0.12 mm layers. |
| 50_claw_palm | 1 | PA-CF (PETG ok) | 5 / 50% gyroid | none | 45 x 124 x 54 | 34 | Rail-beam top face DOWN on the bed (flat, precise rail seat); support only under the dovetail block overhang. |
| 51_claw_cradle_cap | 1 | PETG | 4 / 40% gyroid | none | 39 x 33 x 4 | 3 | - |
| 52_claw_pinion | 1 | PA-CF / PETG-CF | 6 / 100% | none | 24 x 24 x 10 | 2 | 0.12 mm layers, hardened nozzle for CF. |
| 53_claw_jaw_a | 1 | PA-CF / PETG-CF | 6 / 60% gyroid | none | 84 x 46 x 60 | 26 | Outer finger face down; rack teeth print as vertical walls. |
| 53_claw_jaw_b | 1 | PA-CF / PETG-CF | 6 / 60% gyroid | none | 84 x 49 x 60 | 25 | Outer finger face down. |
| 54_claw_pad_a | 1 | TPU 95A + silicone sheet | 3 / 40% | none | 22 x 6 x 41 | 3 | - |
| 54_claw_pad_b | 1 | TPU 95A + silicone sheet | 3 / 40% | none | 22 x 6 x 41 | 3 | - |
| 56_tool_adapter | 1 | PA-CF (PETG ok) | 6 / 100% | none | 40 x 40 x 12 | 14 | - |
| 60_electronics_box | 1 | PETG | 4 / 20% gyroid | none | 196 x 146 x 71 | 182 | Open side up. 0.24 mm layers OK. |
| 61_electronics_lid | 1 | PETG | 3 / 15% | none | 196 x 146 x 5 | 59 | - |
| 62_estop_pendant | 1 | PETG (yellow recommended) | 3 / 20% | none | 64 x 48 x 42 | 26 | - |
| 63_estop_pendant_lid | 1 | PETG (yellow) | 3 / 20% | none | 65 x 48 x 12 | 7 | - |
| 70_bench_test_stand | 1 | PETG | 5 / 40% gyroid | none | 220 x 170 x 72 | 376 | - |
| 80_cs_gear_front | 1 | PA-CF (PETG-CF ok) | 6 / 100% | none | 54 x 54 x 56 | 64 | Split face DOWN. 0.12 mm layers, no supports (both ring-tooth families have horizontal axes -> vertical flanks). Teeth: use the STL (mesh pipeline). |
| 81_cs_gear_back | 1 | PA-CF (PETG-CF ok) | 6 / 100% | none | 54 x 54 x 20 | 22 | Split face DOWN. 0.12 mm layers, no supports (both ring-tooth families have horizontal axes -> vertical flanks). Teeth: use the STL (mesh pipeline). |
| 82_monopole | 2 | PA-CF | 6 / 100% | none | 28 x 28 x 16 | 5 | Drive-gear face down (spin axis vertical): ring teeth print as vertical walls. |
| 83_mp_fork | 2 | PA-CF (PETG-CF ok) | 6 / 60% gyroid | none | 44 x 44 x 23 | 9 | Far ring face down, arms up; no supports.  Ream the pin bores (8 mm press in the -x arm, slip in the +x arm). |
| 84_mp_cradle | 2 | PA-CF (PETG ok) | 5 / 50% gyroid | end-plate overhang only | 55 x 46 x 62 | 29 | Sleeve down (module axis vertical): the 6805 hub prints round. |
| 85_theta_gear | 2 | PA-CF / PETG-CF | 6 / 100% | none | 33 x 33 x 4 | 3 | - |
| 86_q_coupling | 2 | PA-CF / PETG | 6 / 100% | none | 22 x 22 x 9 | 1 | Disc down, dogs up.  Dogs: sand to a snug slide in the hub slots (no shake). |
| 87_module_frame | 2 | PA-CF (PETG ok) | 5 / 40% gyroid | under the 6805 boss / q-cradle overhang | 83 x 66 x 112 | 55 | Holder (near lip) down: both bearing seats print round. |
| 88_q_servo_cap | 2 | PETG | 4 / 40% gyroid | none | 53 x 38 x 3 | 4 | - |
| 89_abenics_housing | 1 | PA-CF (PETG ok) | 5 / 40% gyroid | none | 115 x 78 x 60 | 55 | - |
| 90_center_ball | 1 | PA-CF | 6 / 100% | none | 18 x 19 x 19 | 4 | Sand/polish, grease (PTFE). Bonded + pinned on the post. |
| 91_holder_retainer | 2 | PETG | 4 / 100% | none | 66 x 66 x 2 | 5 | - |
| 92_cradle_strap | 2 | PETG | 4 / 40% gyroid | none | 14 x 35 x 4 | 2 | - |
| 93_mp_spacer | 2 | PETG | 3 / 100% | none | 10 x 10 x 6 | 0 | - |

## Only for the other wrist variant (WRA-1B pitch-roll)

| part | qty | material | g each |
|---|---|---|---|
| 40_wrist_housing | 1 | PETG (PA-CF recommended) | 226 |
| 41_pitch_yoke | 1 | PETG (PA-CF recommended) | 45 |
| 42_yoke_cap | 1 | PETG | 4 |
| 43_j4_pulley54 | 1 | PETG | 43 |
| 44_j5_horn_adapter | 1 | PETG (PA-CF) | 1 |
| 45_roll_spindle | 1 | PA-CF or PETG | 5 |
| 46_tool_flange | 1 | PETG (PA-CF) | 9 |
| 47_roll_spacer | 1 | PETG | 1 |

Suggested order: fit coupon -> base / dock -> drive modules -> turntable + shoulder -> arm nodes -> wrist -> claw -> mount -> electronics box.  Inspect every load-bearing print for layer splits before use.
