landen-finkel-engineering/ROLLO-Wheelchair-Arm/output/renders/install_both_sides_front.png

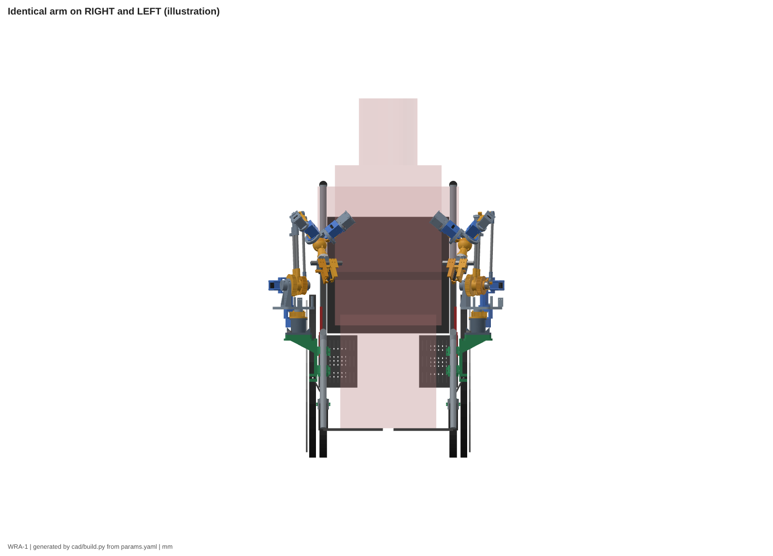
output/renders/install_both_sides_front.png
