landen-finkel-engineering/ROLLO-Wheelchair-Arm/output/renders/install_both_sides_top.png

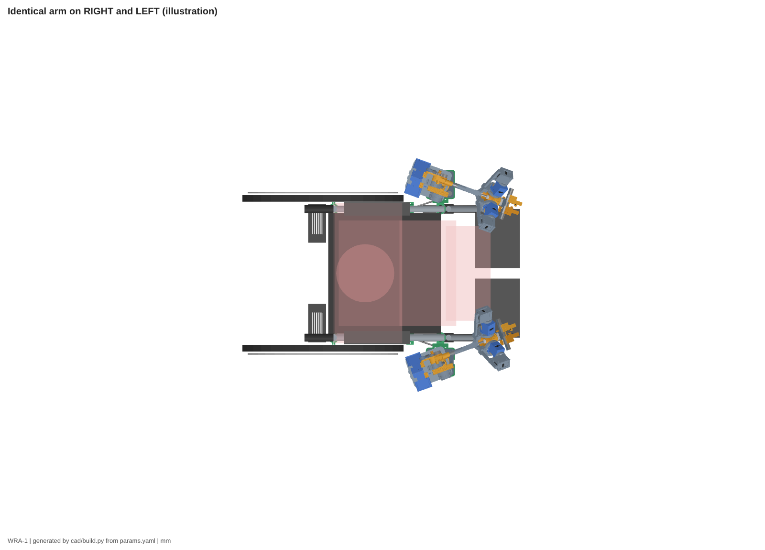
output/renders/install_both_sides_top.png
