landen-finkel-engineering/ROLLO-Wheelchair-Arm/output/renders/install_left_iso.png

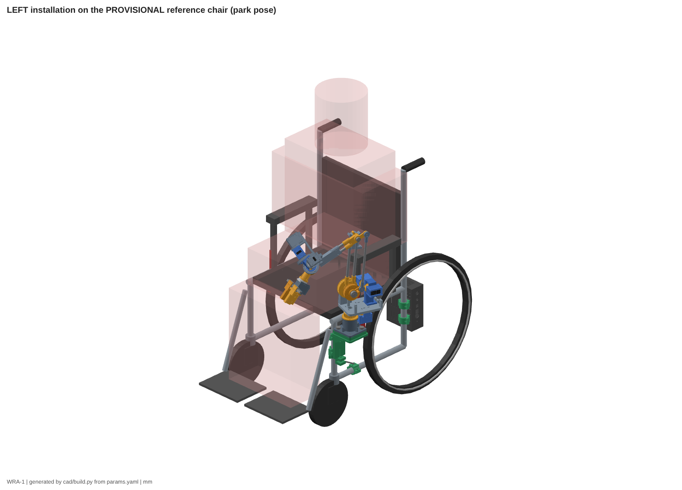
output/renders/install_left_iso.png
