landen-finkel-engineering/ROLLO-Wheelchair-Arm/docs/test_log.md

# Test log

## 1. Physical tests (fill in as you go — docs/09 §4 lists the stages)

| date | build (params_sha from output/reports/verification.json) | stage / test | result | measured values | notes / actions |
|---|---|---|---|---|---|
| | | T0.1 power-up | | | |
| | | T0.2 E-stop chain | | | |

## 2. Design verification already done (CAD / simulation only — not a substitute for section 1)

| date | check | tool | result |
|---|---|---|---|
| 2026-10-12 | Θ-pair phasing (20T servo gear vs 15T monopole gear) | `tools/wrist_sweep.py` + 2-D involute check | **found:** 36 mm³ tooth overlap at every pose; the odd 15T gear needs a tooth (not a gap) of the 20T gear facing it. **Fixed** in `abenics.theta_gear()`: 0.0 mm² overlap over 5 tooth pitches at 0.2° steps |
| 2026-10-12 | Θ spur gear on the monopole vs CS gear teeth | `tools/wrist_sweep.py --mesh` | **found:** up to 0.76 mm³ (inner tip corner inside the CS tip sphere) at the hard limits. **Fixed** with a revolved tip relief (`TG_RELIEF_CLR` 0.4 mm) |
| 2026-10-12 | claw servo vs tool adapter | `tools/wrist_sweep.py` | **found:** 1.6 mm³ (servo rear boss on the dovetail). **Fixed:** `claw.x_pinion` 55.6 → 56.6 mm (0.9 mm clearance) |
| 2026-10-12 | every part a single solid, watertight STL | `cad/build.py --verify` (first pass) | **found:** `32_elbow_block` printed as 3 bodies (stop lugs 1.5 mm off the boss) → lugs now reach into the boss. Cap screws of `50` and `87` were heat-set inserts as wide as the 3.5–4 mm walls (non-manifold, would split) → `51` cap on 4× M2 thread-forming in the side walls, `88` cap on 4× M3 thread-forming in new bosses on `87`. The first boss placement intruded into the q-servo pocket (sweep: 110 mm³); bosses are now added before the pocket is cut. Fork radial screw tangent to the ring end → moved 0.5 mm. Toothed gear / ball STLs had zero-area slivers from float32 rounding → `lib.stl_clean` after every export (volume unchanged) |
| 2026-10-12 | ABENICS + claw interference sweep with toothed gears | `tools/wrist_sweep.py --mesh` | 73 poses on the hard-limit boundary (home + 12 tilt directions × roll −90/0/+90 × claw closed/open), every wrist and claw solid plus vitamins: **no interferences** (B-rep part re-run after the fastener fixes above). Toothed CS gear vs both monopoles (with their Θ gears) at the same poses: largest overlap **0.20 mm³** (slivers ≤ 0.27 mm thick on the monopole tooth flanks: the 1° step of the generating sweep). |
| 2026-10-12 | LEFT / RIGHT installation at `mount_z` 460 (park + gripping a 36" knob 450 mm ahead) | `tools/chair_check.py` | no interferences on either side; closest: footrest hanger 11.5 mm, wheel lock 16.4 mm, user envelope 44.3 mm |
| 2026-10-12 | engineering calculations | `calcs/arm_calcs.py` → docs/05 | all used load cases ≥ 1.0; lowest: Θ pair at the 30 % knob cap = 1.00, dock plate 1.21, post bracket 1.22. 50 % peak on the wrist is **not** allowed (Θ pair 0.60, monopole 0.95) |
| 2026-10-12 | driver: framing, CRC, kinematics, actuator mapping, fake-ESP32 client and E-stop, door-knob task, stiff-latch abort, Θ torque cap, user keep-out zone | `pytest software/wra_ros2/wra_driver/test` | 10 / 10 pass |
| 2026-10-12 | ESP32 firmware compile + link (arduino-esp32 2.0.17, xtensa GCC 8.4.0, ESP32 Dev Module) | `firmware/esp32_safety_controller/tools/offline_build.py` | **found:** global `link` collided with POSIX `link()` → renamed `hostLink`. Then 0 errors and 0 warnings with -Wall -Wextra on the sketch sources; flash 285.5 kB (21.8 %), RAM 22.6 kB (6.9 %), image 285.9 kB. Rebuilt after adding the firmware-side Θ torque cap. Not yet run on a board |
| 2026-10-12 | whole build: part validity, bed fit, STL/STEP volumes, interfaces, arm self-interference sweep, chair checks | `cad/build.py --verify` | **ALL PASS**: 57/57 part files (valid single solid, fits and sits on the bed, STL watertight, STL/STEP volume match); 17/17 interface checks; arm sweep 16/16 poses clean; chair checks 4/4 clean (RIGHT/LEFT, park + 36" knob). One check failed on the first pass and was itself wrong: the belt-length interface check used the textbook approximation (0.06 mm off on J2); it now uses the same exact formula as the layout |
| 2026-10-12 | regeneration workflow after entering chair measurements | review of docs/12 vs `cad/build.py` | **found:** the worksheet's `--parts --verify` did not refresh `arm_geometry.json`, so the driver would have kept the provisional chair → arm transform and user keep-out boxes. **Fixed:** `--verify` now refreshes it first and records its `params_sha`; the driver logs it and `wra_cli.py status` prints it; new test T4.0 (docs/09) and docs/11 §G (copy to the Jetson). `--all` now runs the software export before the assemblies and renders. Re-ran `--software` (URDF and meshes byte-identical) and the driver tests (10/10) |
| 2026-10-12 | chair type: the user's chair is a manual (self-propelled) wheelchair, not a power chair | review of all docs, BOM text, CLI, voice node | **found:** README, docs/00, docs/01, docs/07, docs/09 and the BOM battery note said or assumed a power chair ("power wheelchair", "chair powered off", "let the chair push", "separate from the chair battery"). The CAD chair was already a manual chair (hand rims, wheel locks, push handles, swing-away footrests), so no geometry changed. **Fixed** the wording, and added what a manual chair needs: wheel locks on before the door task (docs/10 step 0, `wra_cli.py door` asks, hazard H15, new FMEA row RPN 120 → 60), push-stroke / swing-away footrest / folding checks (T4.2, docs/12 T18–T20), pushing with the arm docked (T5.3). BOM regenerated (only the battery note changed); driver tests 10/10 |
| 2026-10-12 | purchased parts vs the CAD, while finding buy links (docs/16) | spring sizing from the calcs spec (music wire, 0.45 Sut), collar catalogue dimensions, base.py O-ring recess | **found:** (1) a spring meeting the J2/J3 spec is about 12–16 mm OD and 85–100 mm long unstretched (about 180 mm stretched), but the CAD only has a 9 mm × 60–80 mm placeholder: spring mounting still to design; (2) standard 30 mm collars are 16 mm wide or over 45 mm OD, so none fits the J1 cavity (45 × 13 mm); (3) the BOM's '13 x 1.5' O-ring was the recess size, but a captive O-ring must grip the M6 thread (5 × 1.5 mm). BOM corrected; (1) and (2) are open items in docs/00 §13 |
| 2026-10-12 | drive-module pulley axles vs their 608 bearings, while building the Amazon list (8 × 24 dowels are hard to find there) | pin and bearing positions in the drive-module frame (`dm.py`, `turntable.py`) | **found:** in the J2/J3 dual drive module the 8 × 24 dowel ends 0.8 mm short of the bottom of the lower 608 (pin 6.8–30.8 mm, bearings 6.0–20.0 mm), so 0.8 mm of that bearing's 7 mm inner ring is off the pin. (The J1 module was fine: its pin starts at 4.6 mm.) **Fixed:** all three axles are now 8 × 25 dowels pressed flush (`dm.pin_len`, `ddm.pin_len` = 25): the J2/J3 pins now start at 5.8 mm, and the J1 pin ends 2.1 mm above the servo horn screw. No printed part changed (the J2/J3 press-bore extension is in empty space; part volumes identical). Regenerated the BOM, driver geometry and assemblies. `--verify` re-run: **ALL PASS** (57/57 parts, arm sweep 16/16 poses clean, chair checks 4/4 clean, new params_sha 5d1eef09daa8874d). Calcs re-run (arm mass 3159 g, +2 g; every other result unchanged); driver tests 10/10 |
| 2026-10-12 | BOM materials vs the calcs and docs, same review | `calcs/arm_calcs.py` check list, docs/00 §8, docs/14 | **found:** the BOM listed the ABENICS centre-ball post (8 × 1 mm tube, 53.5 mm) as aluminium, but the calcs (margin 2.49), the report and the assembly manual all use 304 stainless (aluminium 6063-T5 would give 1.72). **Fixed:** BOM line now says 304 stainless; shopping list and Amazon list changed to a stainless tube |
