landen-finkel-engineering/ROLLO-Wheelchair-Arm/output/reports/verification.md

# Verification report (generated)

Generated 2026-10-12T23:46:36 from params.yaml sha256:5d1eef09daa8874d.

**Overall: PASS** (57/57 parts pass).

## Printed parts

| part | valid B-rep | 1 solid | fits P1S (246 mm) | on bed | STL watertight | STL vol err % | STEP vol err % | result |
|---|---|---|---|---|---|---|---|---|
| 00_fit_test_coupon | True | True | True | True | True | 0.013 | -0.0 | PASS |
| 01_receiver | True | True | True | True | True | 0.006 | -0.0 | PASS |
| 02_tube_clamp_body | True | True | True | True | True | 0.012 | 0.0 | PASS |
| 03_tube_clamp_cap | True | True | True | True | True | -0.013 | 0.0 | PASS |
| 04_post_bracket | True | True | True | True | True | 0.0 | -0.0 | PASS |
| 05_stop_collar | True | True | True | True | True | -0.036 | 0.0 | PASS |
| 10_base_housing | True | True | True | True | True | -0.014 | 0.0 | PASS |
| 11_j1_fixed_pulley | True | True | True | True | True | 0.002 | -0.0 | PASS |
| 12_dm_bracket | True | True | True | True | True | -0.002 | -0.0 | PASS |
| 12_dm_cap | True | True | True | True | True | -0.004 | -0.0 | PASS |
| 12_dm_pulley36 | True | True | True | True | True | 0.008 | 0.0 | PASS |
| 20_turntable | True | True | True | True | True | -0.005 | -0.0 | PASS |
| 21_stub_cheek | True | True | True | True | True | -0.012 | -0.0 | PASS |
| 22_ddm_bracket_j2 | True | True | True | True | True | -0.002 | -0.0 | PASS |
| 22_ddm_bracket_j3 | True | True | True | True | True | -0.002 | -0.0 | PASS |
| 30_ua_hub | True | True | True | True | True | -0.009 | -0.0 | PASS |
| 31_j3_hub | True | True | True | True | True | -0.001 | -0.0 | PASS |
| 32_elbow_block | True | True | True | True | True | -0.012 | 0.0 | PASS |
| 33_rod_end | True | True | True | True | True | -0.03 | -0.0 | PASS |
| 34_forearm_root | True | True | True | True | True | -0.016 | 0.0 | PASS |
| 35_stub_spacer_14p46mm | True | True | True | True | True | -0.041 | 0.0 | PASS |
| 35_stub_spacer_30p96mm | True | True | True | True | True | -0.041 | 0.0 | PASS |
| 40_wrist_housing | True | True | True | True | True | -0.004 | -0.0 | PASS |
| 41_pitch_yoke | True | True | True | True | True | -0.006 | 0.0 | PASS |
| 42_yoke_cap | True | True | True | True | True | 0.002 | -0.0 | PASS |
| 43_j4_pulley54 | True | True | True | True | True | -0.004 | -0.0 | PASS |
| 44_j5_horn_adapter | True | True | True | True | True | -0.018 | 0.0 | PASS |
| 45_roll_spindle | True | True | True | True | True | -0.043 | -0.0 | PASS |
| 46_tool_flange | True | True | True | True | True | -0.042 | 0.0 | PASS |
| 47_roll_spacer | True | True | True | True | True | -0.041 | 0.0 | PASS |
| 50_claw_palm | True | True | True | True | True | 0.004 | 0.0 | PASS |
| 51_claw_cradle_cap | True | True | True | True | True | 0.001 | -0.0 | PASS |
| 52_claw_pinion | True | True | True | True | True | 0.024 | -0.0 | PASS |
| 53_claw_jaw_a | True | True | True | True | True | 0.0 | 0.0 | PASS |
| 53_claw_jaw_b | True | True | True | True | True | 0.0 | -0.0 | PASS |
| 54_claw_pad_a | True | True | True | True | True | 0.001 | -0.0 | PASS |
| 54_claw_pad_b | True | True | True | True | True | 0.001 | -0.0 | PASS |
| 56_tool_adapter | True | True | True | True | True | -0.015 | 0.0 | PASS |
| 60_electronics_box | True | True | True | True | True | -0.001 | -0.0 | PASS |
| 61_electronics_lid | True | True | True | True | True | 0.0 | -0.0 | PASS |
| 62_estop_pendant | True | True | True | True | True | -0.003 | 0.0 | PASS |
| 63_estop_pendant_lid | True | True | True | True | True | 0.01 | -0.0 | PASS |
| 70_bench_test_stand | True | True | True | True | True | -0.003 | -0.0 | PASS |
| 80_cs_gear_front | True | True | True | True | True | - | 0.0 | PASS |
| 81_cs_gear_back | True | True | True | True | True | - | 0.0 | PASS |
| 82_monopole | True | True | True | True | True | - | 0.0 | PASS |
| 83_mp_fork | True | True | True | True | True | -0.057 | -0.0 | PASS |
| 84_mp_cradle | True | True | True | True | True | -0.006 | -0.0 | PASS |
| 85_theta_gear | True | True | True | True | True | 0.007 | 0.0 | PASS |
| 86_q_coupling | True | True | True | True | True | -0.029 | 0.0 | PASS |
| 87_module_frame | True | True | True | True | True | -0.005 | 0.0 | PASS |
| 88_q_servo_cap | True | True | True | True | True | 0.001 | -0.0 | PASS |
| 89_abenics_housing | True | True | True | True | True | 0.001 | 0.0 | PASS |
| 90_center_ball | True | True | True | True | True | -0.201 | -0.0 | PASS |
| 91_holder_retainer | True | True | True | True | True | -0.039 | 0.0 | PASS |
| 92_cradle_strap | True | True | True | True | True | 0.002 | -0.0 | PASS |
| 93_mp_spacer | True | True | True | True | True | -0.041 | 0.0 | PASS |

## Interface checks

| check | value | result |
|---|---|---|
| dock_dowel_0_clears_base_hole | {'value_mm3': 0} | PASS |
| thumb_screw_0_clears_base_hole | {'value_mm3': 0} | PASS |
| thumb_screw_0_in_receiver_insert_bore | {'value_mm3': 0} | PASS |
| dock_dowel_1_clears_base_hole | {'value_mm3': 0} | PASS |
| thumb_screw_1_clears_base_hole | {'value_mm3': 0} | PASS |
| thumb_screw_1_in_receiver_insert_bore | {'value_mm3': 0} | PASS |
| belt_j1_length | {'centre_mm': 51.785, 'pitch_length_mm': 240.0, 'nominal': 240} | PASS |
| belt_j2_length | {'centre_mm': 77.282, 'pitch_length_mm': 345.0, 'nominal': 345} | PASS |
| belt_j3_length | {'centre_mm': 77.588, 'pitch_length_mm': 321.0, 'nominal': 321} | PASS |
| belt_j4_length | {'centre_mm': 69.972, 'pitch_length_mm': 276.0, 'nominal': 276} | PASS |
| claw_closed_pads_touch | {'overlap_mm3': 0, 'gap_mm': 0.0} | PASS |
| claw_carriage_on_rail_at_full_open | {'carriage_edge_mm': 62.0, 'rail_half_mm': 62.0} | PASS |
| claw_jaw_force_N_per_jaw | {'cont': 35.0, 'knob': 70.0} | PASS |
| abenics_fk_ik_roundtrip | {'max_err': 5.100087019371813e-15} | PASS |
| abenics_cs_monopole_centre_distance | {'D_MP': 38.25, 'from_teeth': 38.25} | PASS |
| abenics_theta_pair_centre_distance | {'Z_TS - D_MP': 26.25, 'from_teeth': 26.25} | PASS |
| abenics_toothed_mesh_overlap_home | {'overlap_mm3': [0.0, -0.0]} | PASS |

## Self-interference sweep (arm, full CAD solids)

| pose (deg) | interferences | result |
|---|---|---|
| `{}` | none | PASS |
| `{"j2": 40, "j3": -10, "wt": [-20, 0, 0], "j6": 20}` | none | PASS |
| `{"j2": -30, "j3": -90, "wt": [0, 0, 0], "j6": 32.5}` | none | PASS |
| `{"j2": 85, "j3": 40, "wt": [-30, 0, 90], "j6": 6}` | none | PASS |
| `{"j1": 105, "j2": 10, "j3": -60, "wt": [30, 0, 0], "j6": 0}` | none | PASS |
| `{"j1": -105, "j2": 45, "j3": -95, "wt": [10, 0, -90], "j6": 6}` | none | PASS |
| `{"j2": 100, "j3": 58, "wt": [-30, 0, 90], "j6": 32.5}` | none | PASS |
| `{"j2": 50, "j3": 8, "wt": [33, 0, 0], "j6": 32.5}` | none | PASS |
| `{"j2": 50, "j3": 8, "wt": [-33, 0, 90], "j6": 0}` | none | PASS |
| `{"j2": -30, "j3": -95, "wt": [-30, 0, 0]}` | none | PASS |
| `{"j2": 100, "j3": -40, "wt": [0, 0, 0], "j6": 32.5}` | none | PASS |
| `{"j2": 100, "j3": -40, "wt": [0, 33, 0], "j6": 32.5}` | none | PASS |
| `{"j2": 100, "j3": -40, "wt": [0, -33, 90], "j6": 32.5}` | none | PASS |
| `{"j2": 100, "j3": -40, "wt": [-33, 0, 0], "j6": 32.5}` | none | PASS |
| `{"j2": 45, "j3": -95, "wt": [33, 0, 0], "j6": 32.5}` | none | PASS |
| `{"j2": 45, "j3": -95, "wt": [17, 17, 90], "j6": 32.5}` | none | PASS |

## ABENICS wrist + claw sweep (tools/wrist_sweep.py)

73 poses at the hard limits (tilt 33 deg, 24 deg toward a module axis, roll -90/0/+90, claw closed/open); toothed gear-mesh check: True.  Problems: none -> **PASS**

## Installation checks on the PROVISIONAL reference chair (park, and gripping a 36-inch knob)

* **RIGHT, park**: interferences none; added width beyond hand rim 140.5 mm; minimum clearances {'chair_rear_wheel': (102.0, 'turntable', 'chair_rear_wheel_R'), 'chair_hand_rim': (118.2, 'turntable', 'chair_hand_rim_R'), 'chair_wheel_lock': (60.8, 'turntable', 'chair_wheel_lock_R'), 'chair_footrest_hanger': (11.5, 'post_bracket', 'chair_footrest_hanger_R'), 'user': (62.0, 'j3_dm_cap', 'user_upper_arms_elbows')}
* **RIGHT, knob_36in**: interferences none; added width beyond hand rim 151.6 mm; minimum clearances {'chair_rear_wheel': (93.9, 'j1_dm_cap', 'chair_rear_wheel_R'), 'chair_hand_rim': (111.9, 'j1_dm_cap', 'chair_hand_rim_R'), 'chair_wheel_lock': (17.4, 'turntable', 'chair_wheel_lock_R'), 'chair_footrest_hanger': (11.5, 'post_bracket', 'chair_footrest_hanger_R'), 'user': (44.3, 'j3_dm_cap', 'user_upper_arms_elbows')}
* **LEFT, park**: interferences none; added width beyond hand rim 127.4 mm; minimum clearances {'chair_rear_wheel': (98.9, 'turntable', 'chair_rear_wheel_L'), 'chair_hand_rim': (115.7, 'turntable', 'chair_hand_rim_L'), 'chair_wheel_lock': (54.8, 'turntable', 'chair_wheel_lock_L'), 'chair_footrest_hanger': (11.5, 'post_bracket', 'chair_footrest_hanger_L'), 'user': (50.4, 'j2_dm_cap', 'user_upper_arms_elbows')}
* **LEFT, knob_36in**: interferences none; added width beyond hand rim 184.8 mm; minimum clearances {'chair_rear_wheel': (93.9, 'j1_dm_cap', 'chair_rear_wheel_L'), 'chair_hand_rim': (111.9, 'j1_dm_cap', 'chair_hand_rim_L'), 'chair_wheel_lock': (16.4, 'turntable', 'chair_wheel_lock_L'), 'chair_footrest_hanger': (11.5, 'post_bracket', 'chair_footrest_hanger_L'), 'user': (44.5, 'ddm_bracket_j2', 'user_upper_arms_elbows')}

`software/wra_ros2/wra_driver/config/arm_geometry.json` (chair -> arm transform, user keep-out boxes) was refreshed from this params.yaml (params_sha 5d1eef09daa8874d). The driver logs this value at start-up and `wra_cli.py status` prints it: it must match before the arm is used on the chair (docs/09 T4.0).

Clearances to the provisional chair are only as good as the provisional chair: re-run `python build.py --parts --verify` after entering YOUR measurements in params.yaml, then update the Jetson (docs/11 section G).
