landen-finkel-engineering/ROLLO-Wheelchair-Arm/software/wra_ros2/wra_description/urdf/wra.urdf.xacro

<?xml version="1.0"?>
<!-- GENERATED by cad/build.py --software from params.yaml. Do not edit. -->
<robot xmlns:xacro="http://www.ros.org/wiki/xacro" name="wra1">
  <xacro:arg name="side" default="right"/>
  <!-- side only changes the base mounting (see launch); the arm is identical L/R -->
  <material name="grey"><color rgba="0.55 0.6 0.65 1"/></material>
  <material name="orange"><color rgba="0.88 0.63 0.19 1"/></material>
  <link name="base_link">
    <visual><geometry><mesh filename="package://wra_description/meshes/base_link.stl" scale="0.001 0.001 0.001"/></geometry><material name="grey"/></visual>
  </link>
  <link name="turntable">
    <visual><geometry><mesh filename="package://wra_description/meshes/turntable.stl" scale="0.001 0.001 0.001"/></geometry><material name="grey"/></visual>
  </link>
  <link name="upper_arm">
    <visual><geometry><mesh filename="package://wra_description/meshes/upper_arm.stl" scale="0.001 0.001 0.001"/></geometry><material name="grey"/></visual>
  </link>
  <link name="forearm">
    <visual><geometry><mesh filename="package://wra_description/meshes/forearm.stl" scale="0.001 0.001 0.001"/></geometry><material name="grey"/></visual>
  </link>
  <joint name="j1" type="revolute">
    <parent link="base_link"/><child link="turntable"/><origin xyz="0.000000 0.000000 0.105000" rpy="0.000000 -0.000000 0.000000"/>
    <axis xyz="0 0 1"/>
    <limit lower="-1.83260" upper="1.83260" effort="3.0" velocity="1.0"/>
  </joint>
  <joint name="j2" type="revolute">
    <parent link="turntable"/><child link="upper_arm"/><origin xyz="0.000000 0.000000 0.080000" rpy="0.000000 -0.000000 0.000000"/>
    <axis xyz="0 -1 0"/>
    <limit lower="-0.52360" upper="1.74533" effort="3.0" velocity="1.0"/>
  </joint>
  <joint name="j3" type="revolute">
    <parent link="upper_arm"/><child link="forearm"/><origin xyz="0.250000 0.000000 0.000000" rpy="0.000000 -0.000000 0.000000"/>
    <axis xyz="0 -1 0"/>
    <limit lower="-2.44346" upper="-0.73304" effort="3.0" velocity="1.0"/>
  </joint>
  <link name="wrist_yaw_link"/>
  <link name="wrist_pitch_link"/>
  <link name="wrist_roll_link"/>
  <joint name="wrist_yaw" type="revolute">
    <parent link="forearm"/><child link="wrist_yaw_link"/><origin xyz="0.230000 0.016625 0.000000" rpy="0.000000 -0.000000 0.000000"/>
    <axis xyz="0 0 1"/>
    <limit lower="-0.57596" upper="0.57596" effort="3.0" velocity="3.0"/>
  </joint>
  <joint name="wrist_pitch" type="revolute">
    <parent link="wrist_yaw_link"/><child link="wrist_pitch_link"/><origin xyz="0 0 0" rpy="0 0 0"/>
    <axis xyz="0 -1 0"/>
    <limit lower="-0.57596" upper="0.57596" effort="3.0" velocity="3.0"/>
  </joint>
  <joint name="wrist_roll" type="revolute">
    <parent link="wrist_pitch_link"/><child link="wrist_roll_link"/><origin xyz="0 0 0" rpy="0 0 0"/>
    <axis xyz="1 0 0"/>
    <limit lower="-1.57080" upper="1.57080" effort="3.0" velocity="3.0"/>
  </joint>
  <link name="tool_flange">
    <visual><geometry><mesh filename="package://wra_description/meshes/tool_flange.stl" scale="0.001 0.001 0.001"/></geometry><material name="orange"/></visual>
  </link>
  <joint name="wrist_tool" type="fixed">
    <parent link="wrist_roll_link"/><child link="tool_flange"/><origin xyz="0.056000 0.000000 0.000000" rpy="0.000000 -0.000000 0.000000"/>
  </joint>
  <link name="jaw_a">
    <visual><geometry><mesh filename="package://wra_description/meshes/jaw_a.stl" scale="0.001 0.001 0.001"/></geometry><material name="orange"/></visual>
  </link>
  <link name="jaw_b">
    <visual><geometry><mesh filename="package://wra_description/meshes/jaw_b.stl" scale="0.001 0.001 0.001"/></geometry><material name="orange"/></visual>
  </link>
  <joint name="claw" type="prismatic">
    <parent link="tool_flange"/><child link="jaw_a"/><origin xyz="0 0 0" rpy="0 0 0"/>
    <axis xyz="0 1 0"/>
    <limit lower="0.00000" upper="0.03250" effort="3.0" velocity="0.05"/>
  </joint>
  <joint name="claw_b" type="prismatic">
    <parent link="tool_flange"/><child link="jaw_b"/><origin xyz="0 0 0" rpy="0 0 0"/>
    <axis xyz="0 -1 0"/>
    <limit lower="0.00000" upper="0.03250" effort="3.0" velocity="0.05"/>
    <mimic joint="claw" multiplier="1.0"/>
  </joint>
  <link name="tcp"/>
  <joint name="tcp_joint" type="fixed">
    <parent link="tool_flange"/><child link="tcp"/><origin xyz="0.088500 0 0" rpy="0 0 0"/>
  </joint>
</robot>
