landen-finkel-engineering/ROLLO-Wheelchair-Arm/output/drawings/WRA1_drawings.pdf

# WRA-1 wheelchair robotic arm - part drawings

Generated from the parametric source (cad/wra). Units mm. Third-angle projection.
Dimensions shown are overall sizes and auto-extracted bore tables; the STEP files are the master geometry.
1 | 00_fit_test_coupon | x1 | same as production | PRINT FIRST: fit-test coupon (bearings, pins, inserts)
2 | 01_receiver | x1 | PETG (PA-CF optional) | Dock receiver (chair side, same part L/R)
3 | 02_tube_clamp_body | x5 | PA-CF recommended (PETG ok) | Tube clamp body (parametric tube OD)
4 | 03_tube_clamp_cap | x5 | PA-CF recommended (PETG ok) | Tube clamp cap
5 | 04_post_bracket | x1 | PA-CF recommended | Post bracket (spine + shelf), same part L/R
6 | 05_stop_collar | x1 | PETG | Post stop collar (secondary retention)
7 | 10_base_housing | x1 | PA-CF (required: dock plate | Base housing + dock plate
8 | 11_j1_fixed_pulley | x1 | PETG | J1 fixed pulley 54T (+ hard-stop arc)
9 | 12_dm_bracket | x1 | PETG | Drive-module bracket
10 | 12_dm_cap | x3 | PETG | Drive-module servo cap
11 | 12_dm_pulley36 | x3 | PETG | 36T HTD-3M drive pulley
12 | 20_turntable | x1 | PETG (PA-CF optional) | Turntable plate + J1 spindle
13 | 21_stub_cheek | x1 | PETG (PA-CF recommended) | Stub cheek (clamps J2 stub axle)
14 | 22_ddm_bracket_j2 | x1 | PETG | Dual drive bracket (J2 half)
15 | 22_ddm_bracket_j3 | x1 | PETG | Dual drive bracket (J3 half)
16 | 30_ua_hub | x1 | PETG (PA-CF recommended) | Upper-arm hub with integral 86T (J2) pulley
17 | 31_j3_hub | x1 | PETG (PA-CF recommended) | J3 hub: 72T pulley + parallelogram crank + spring L-lever
18 | 32_elbow_block | x1 | PETG (PA-CF recommended) | Elbow block (clamps elbow pin, J2 spring anchor, stop lugs)
19 | 33_rod_end | x2 | PETG | Parallelogram rod end (626 bearing)
20 | 34_forearm_root | x1 | PETG (PA-CF recommended) | Forearm root: elbow bearings + crank + stop tab
21 | 35_stub_spacer_14p46mm | x1 | PETG | Stub inner-ring spacer 14.46 mm
22 | 35_stub_spacer_30p96mm | x1 | PETG | Stub inner-ring spacer 30.96 mm
23 | 40_wrist_housing | x1 | PETG (PA-CF recommended) | Wrist housing: forearm sockets + J4 drive cradle + pitch for
24 | 41_pitch_yoke | x1 | PETG (PA-CF recommended) | Pitch yoke: J5 servo pocket + roll bearing housing
25 | 42_yoke_cap | x1 | PETG | Pitch-yoke rear cap
26 | 43_j4_pulley54 | x1 | PETG | J4 54T pulley (bolts to yoke)
27 | 44_j5_horn_adapter | x1 | PETG (PA-CF) | J5 horn adapter with drive dogs
28 | 45_roll_spindle | x1 | PA-CF or PETG | Roll spindle
29 | 46_tool_flange | x1 | PETG (PA-CF) | Tool flange (WRA-TF30 interface)
30 | 47_roll_spacer | x1 | PETG | Roll-spindle inner-ring spacer
31 | 50_claw_palm | x1 | PA-CF (PETG ok) | Claw palm: dovetail, servo cradle, rail beam
32 | 51_claw_cradle_cap | x1 | PETG | Claw servo cradle cap
33 | 52_claw_pinion | x1 | PA-CF / PETG-CF | Claw pinion 14T m1.5 (on servo horn)
34 | 53_claw_jaw_a | x1 | PA-CF / PETG-CF | Claw jaw A (rack on top of pinion, upper knob lip)
35 | 53_claw_jaw_b | x1 | PA-CF / PETG-CF | Claw jaw B (rack below pinion, lower knob lip)
36 | 54_claw_pad_a | x1 | TPU 95A + silicone sheet | Claw pad A, 100 deg V (glue 1.5 mm silicone facing)
37 | 54_claw_pad_b | x1 | TPU 95A + silicone sheet | Claw pad B (mirror of A)
38 | 56_tool_adapter | x1 | PA-CF (PETG ok) | Quick-change tool adapter (dovetail, both wrists)
39 | 60_electronics_box | x1 | PETG | Electronics enclosure (Jetson, ESP32, power, E-stop relays)
40 | 61_electronics_lid | x1 | PETG | Electronics enclosure lid
41 | 62_estop_pendant | x1 | PETG (yellow recommended) | E-stop pendant body
42 | 63_estop_pendant_lid | x1 | PETG (yellow) | E-stop pendant lid (E-stop + guarded START)
43 | 70_bench_test_stand | x1 | PETG | Bench test stand (holds a post tube like the chair)
44 | 80_cs_gear_front | x1 | PA-CF (PETG-CF ok) | CS-gear front hemisphere + tool flange
45 | 81_cs_gear_back | x1 | PA-CF (PETG-CF ok) | CS-gear back hemisphere
46 | 82_monopole | x2 | PA-CF | Monopole S-gear 17T m1.5 + 15T m1.5 drive gear
47 | 83_mp_fork | x2 | PA-CF (PETG-CF ok) | Monopole fork: pin arms + 6808 inner-race ring (carrier part
48 | 84_mp_cradle | x2 | PA-CF (PETG ok) | Theta-servo cradle: sleeve, U-channel, 6805 hub, q dogs (car
49 | 85_theta_gear | x2 | PA-CF / PETG-CF | Theta drive gear 20T m1.5 (on servo horn)
50 | 86_q_coupling | x2 | PA-CF / PETG | q-servo horn coupling with drive dogs
51 | 87_module_frame | x2 | PA-CF (PETG ok) | Module frame: 6808 holder, lug, strut, 6805 boss, q-servo cr
52 | 88_q_servo_cap | x2 | PETG | q-servo cap
53 | 89_abenics_housing | x1 | PA-CF (PETG ok) | ABENICS housing: forearm sockets, post clamp, shoulders
54 | 90_center_ball | x1 | PA-CF | Fixed centre ball (sphere bearing)
55 | 91_holder_retainer | x2 | PETG | 6808 outer-race retainer ring (3x M3 countersunk)
56 | 92_cradle_strap | x2 | PETG | Theta-servo strap (closes the cradle, 2x M3)
57 | 93_mp_spacer | x2 | PETG | Monopole pin spacer 10.5/8.2 x 6.5 (or brass tube)

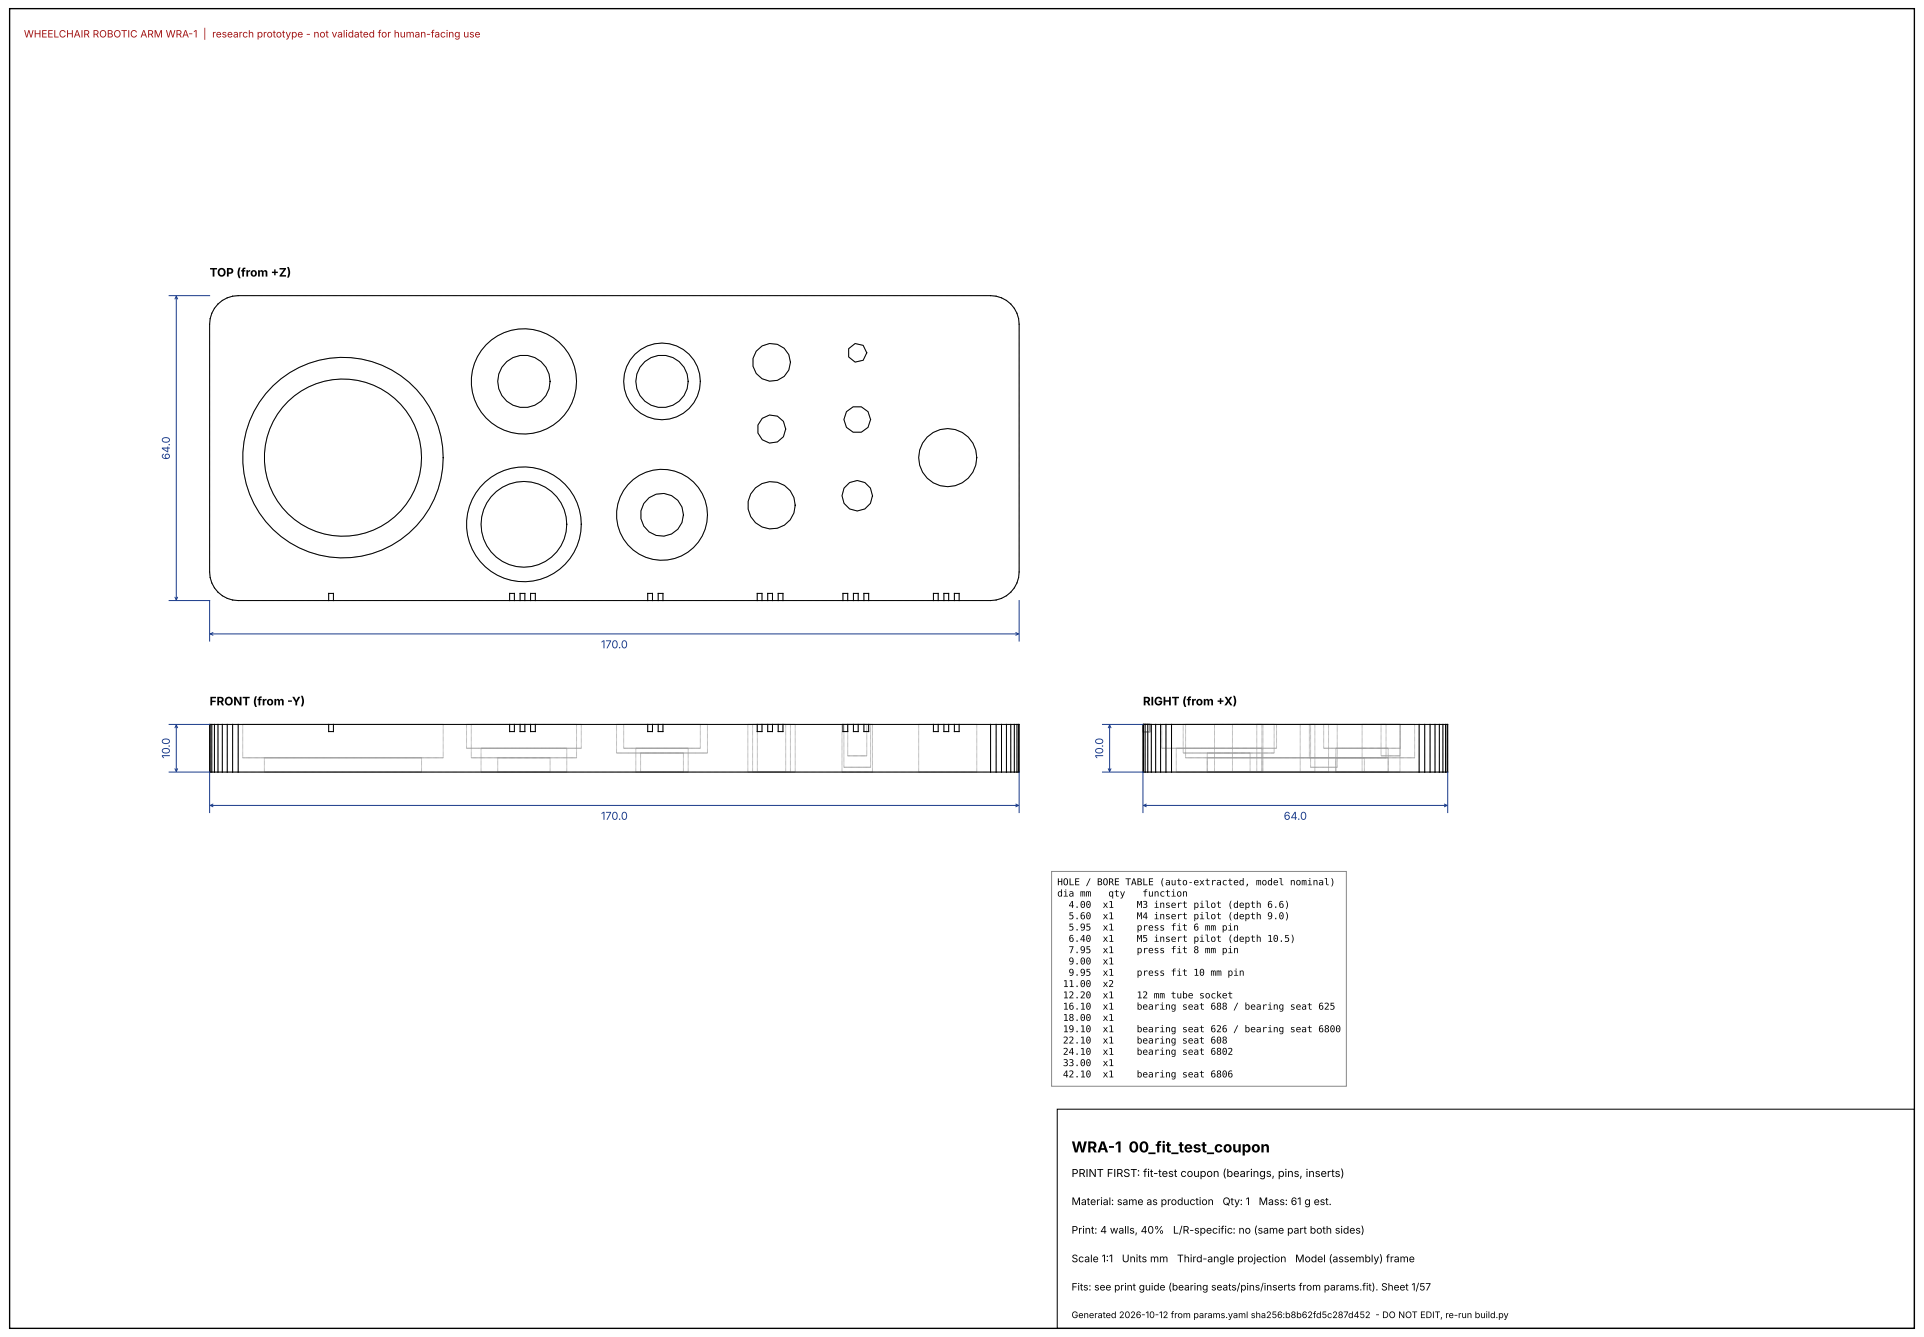
[picture p94: page 2]
FRONT (from -Y); TOP (from +Z); RIGHT (from +X); dia mm; qty; function; M3 insert pilot (depth 6.6); M4 insert pilot (depth 9.0); press fit 6 mm pin; M5 insert pilot (depth 10.5); press fit 8 mm pin; press fit 10 mm pin; 12 mm tube socket; bearing seat 688 / bearing seat 625; bearing seat 626 / bearing seat 6800; bearing seat 608; bearing seat 6802; bearing seat 6806; WRA-1 00_fit_test_coupon

WHEELCHAIR ROBOTIC ARM WRA-1 | research prototype - not validated for human-facing use

HOLE / BORE TABLE (auto-extracted, model nominal)

PRINT FIRST: fit-test coupon (bearings, pins, inserts)

Material: same as production Qty: 1 Mass: 61 g est.

Print: 4 walls, 40% L/R-specific: no (same part both sides)

Scale 1:1 Units mm Third-angle projection Model (assembly) frame

Fits: see print guide (bearing seats/pins/inserts from params.fit). Sheet 1/57

Generated 2026-10-12 from params.yaml sha256:b8b62fd5c287d452 - DO NOT EDIT, re-run build.py

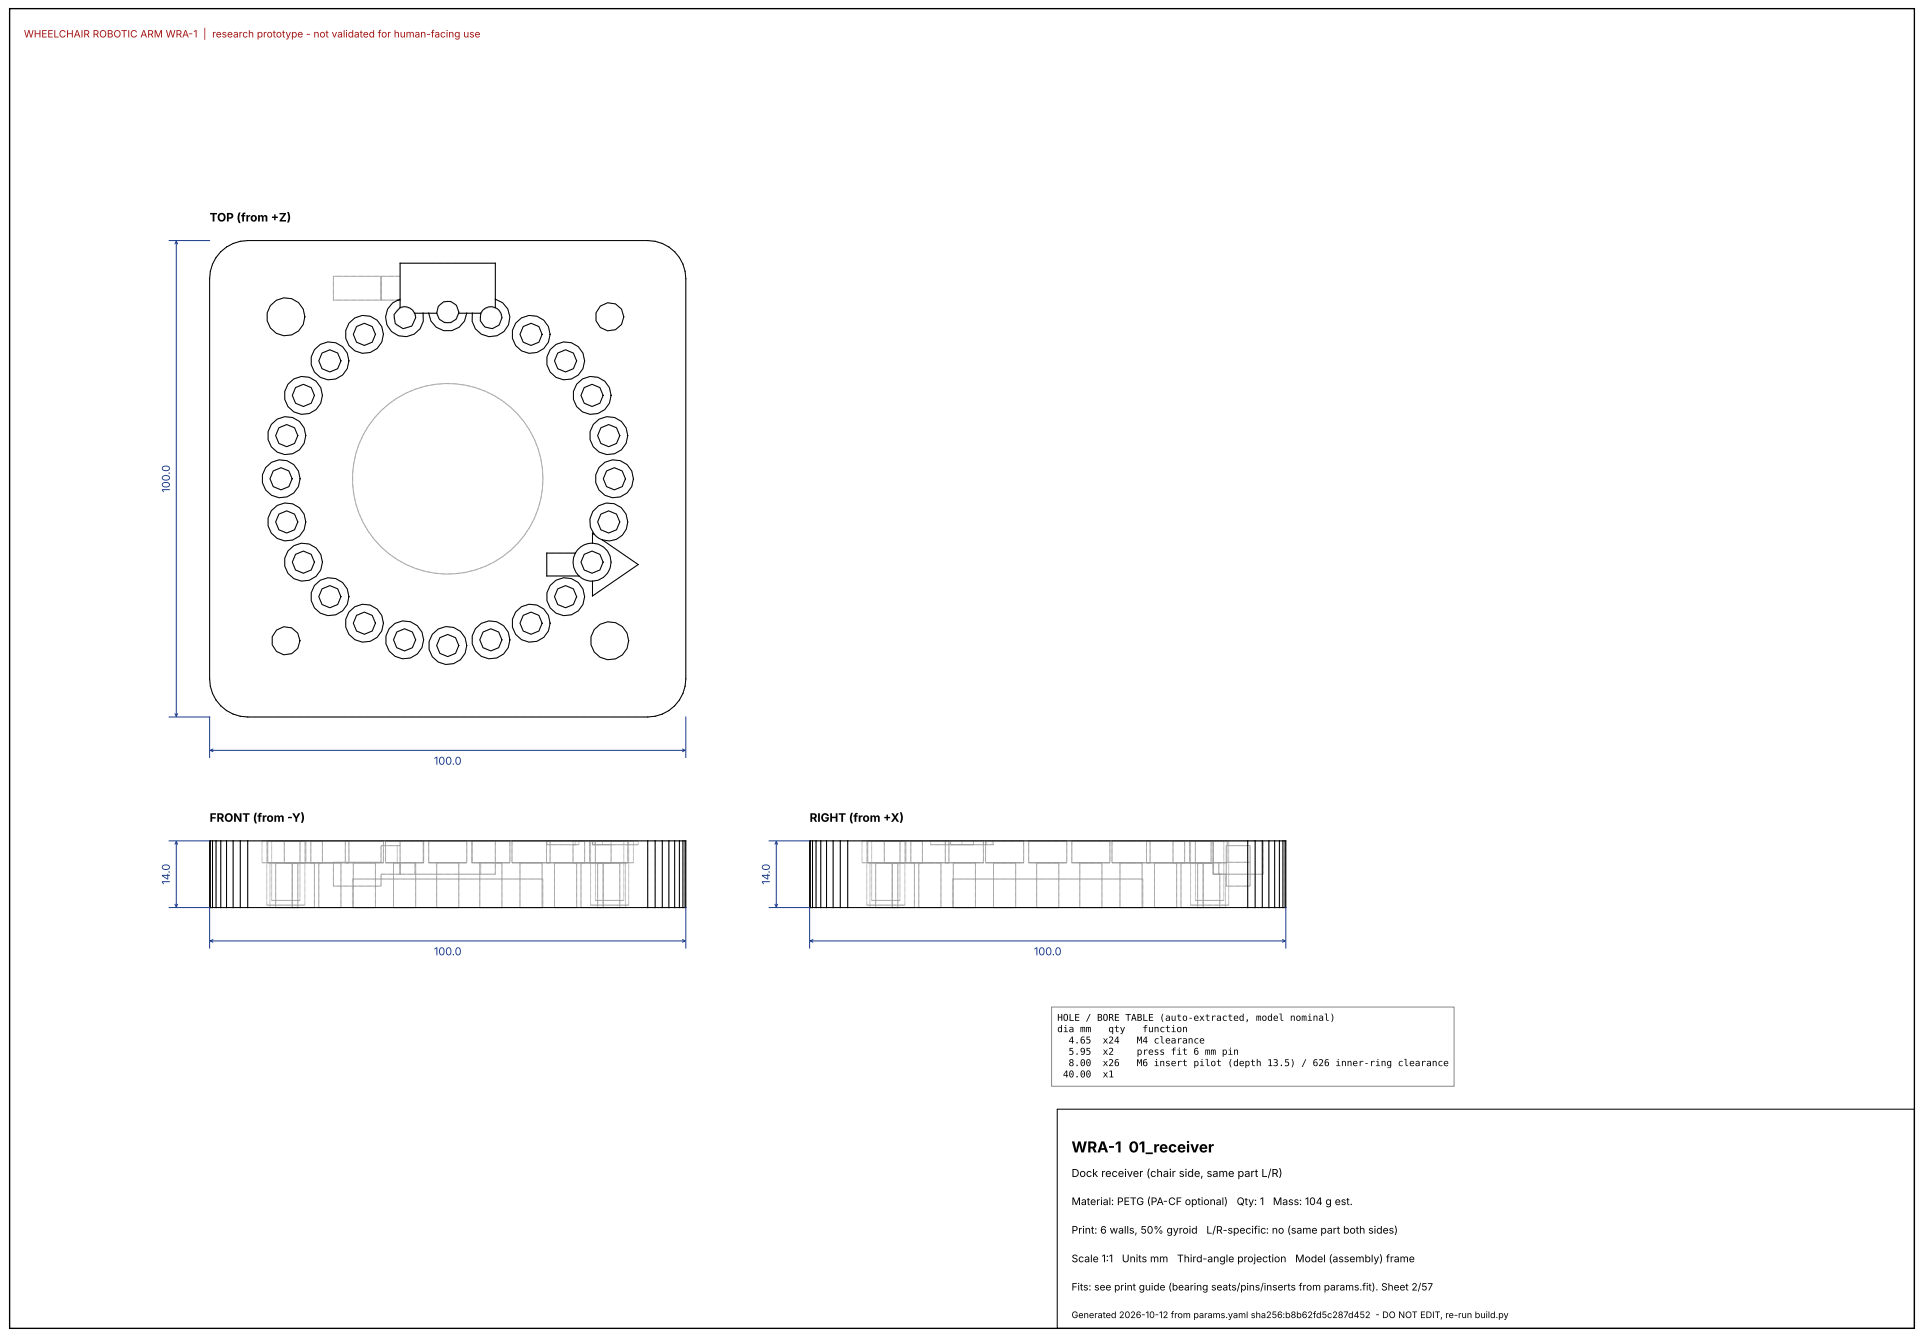
[picture p95: page 3]
FRONT (from -Y); TOP (from +Z); RIGHT (from +X); dia mm; qty; function; M4 clearance; press fit 6 mm pin; M6 insert pilot (depth 13.5) / 626 inner-ring clearance; WRA-1 01_receiver

HOLE / BORE TABLE (auto-extracted, model nominal)

Dock receiver (chair side, same part L/R)

Material: PETG (PA-CF optional) Qty: 1 Mass: 104 g est.

Print: 6 walls, 50% gyroid L/R-specific: no (same part both sides)

Fits: see print guide (bearing seats/pins/inserts from params.fit). Sheet 2/57

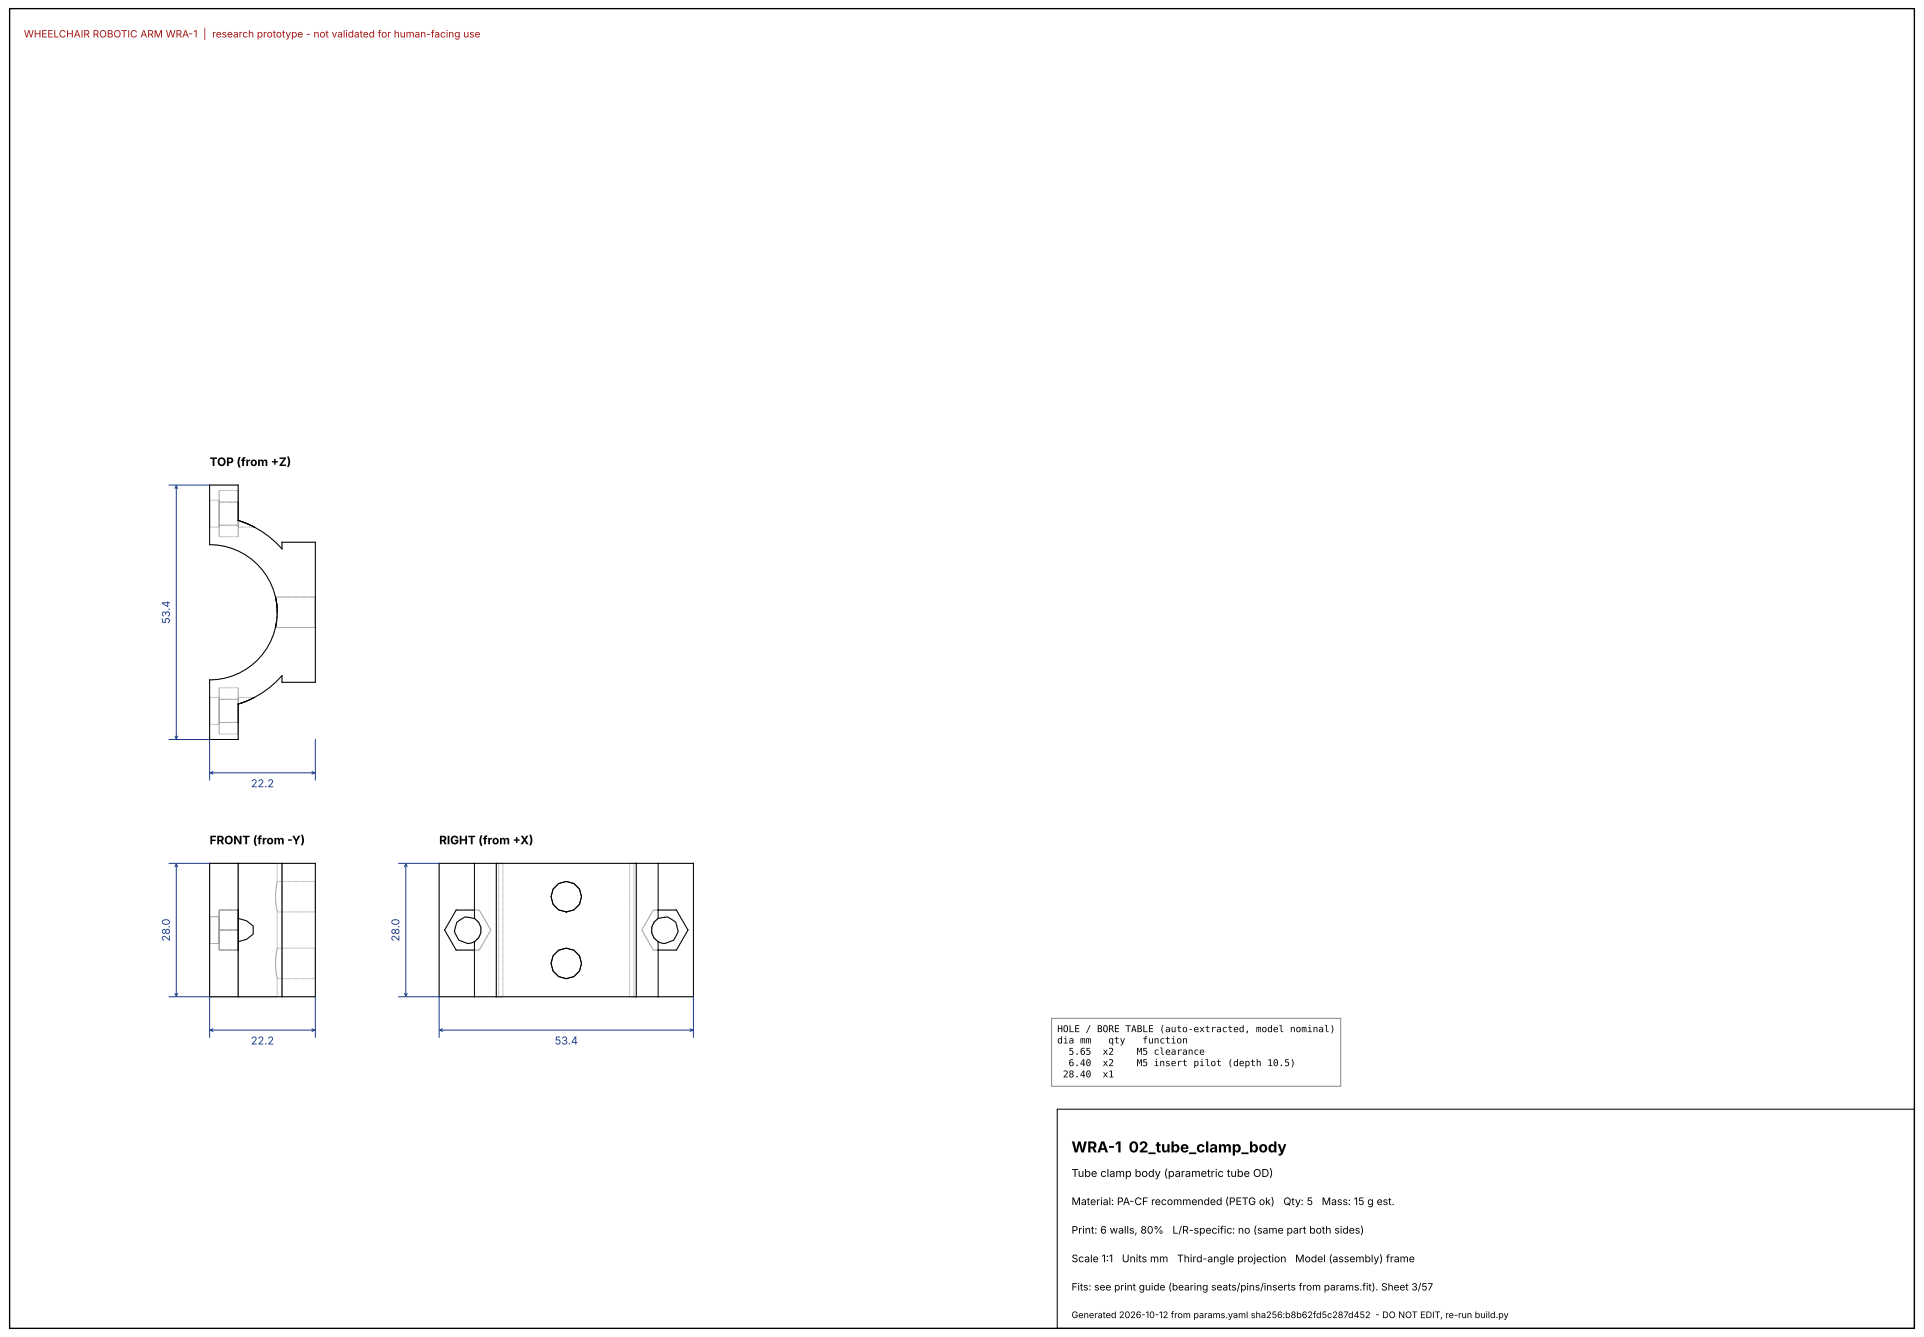
[picture p96: page 4]
FRONT (from -Y); TOP (from +Z); RIGHT (from +X); dia mm; qty; function; M5 clearance; M5 insert pilot (depth 10.5); WRA-1 02_tube_clamp_body

HOLE / BORE TABLE (auto-extracted, model nominal)

Tube clamp body (parametric tube OD)

Material: PA-CF recommended (PETG ok) Qty: 5 Mass: 15 g est.

Print: 6 walls, 80% L/R-specific: no (same part both sides)

Fits: see print guide (bearing seats/pins/inserts from params.fit). Sheet 3/57

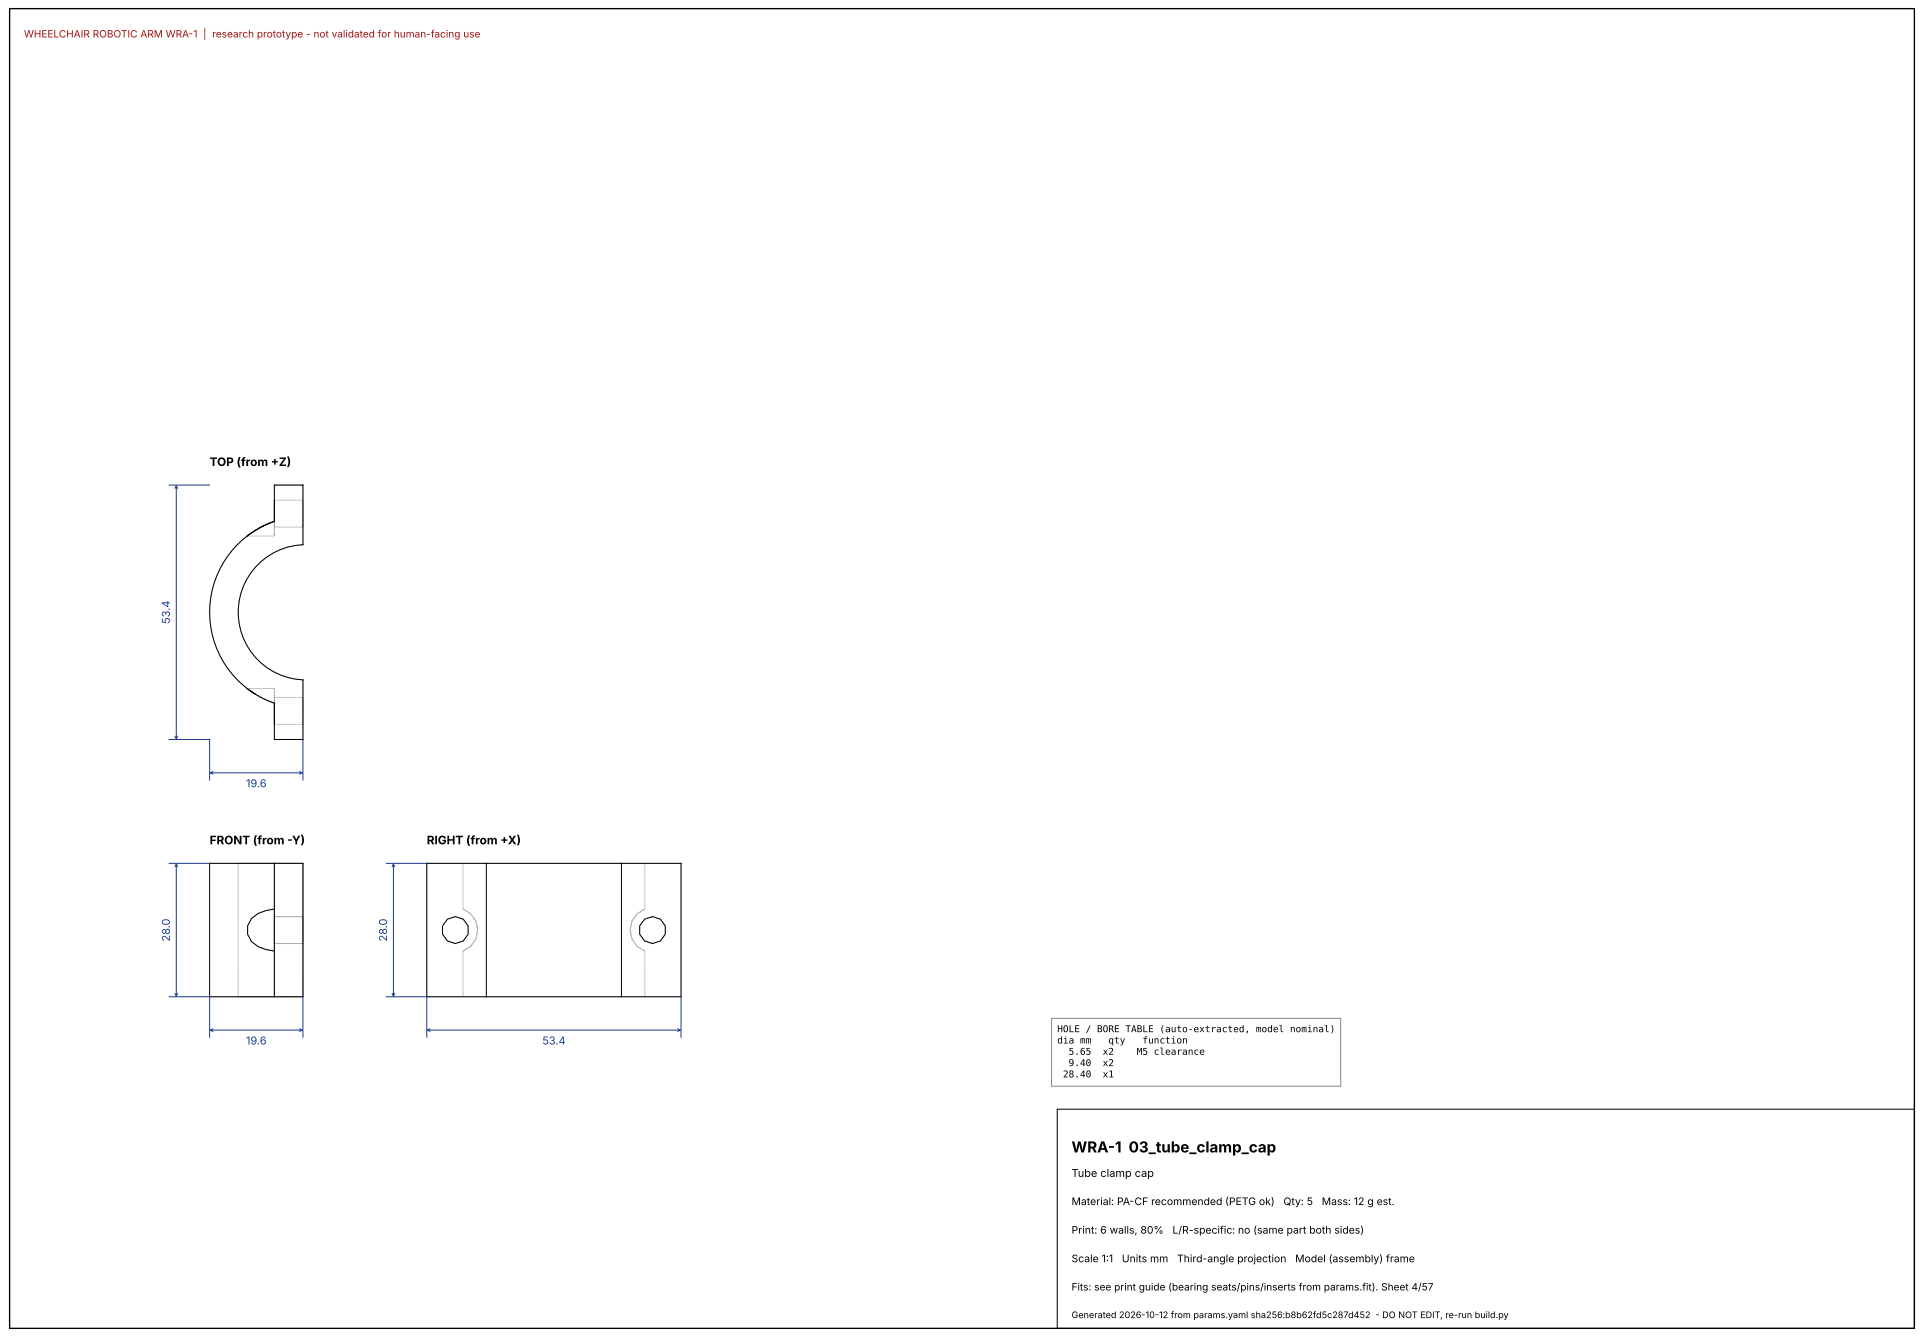
[picture p97: page 5]
FRONT (from -Y); TOP (from +Z); RIGHT (from +X); dia mm; qty; function; M5 clearance; WRA-1 03_tube_clamp_cap

HOLE / BORE TABLE (auto-extracted, model nominal)

Tube clamp cap

Material: PA-CF recommended (PETG ok) Qty: 5 Mass: 12 g est.

Print: 6 walls, 80% L/R-specific: no (same part both sides)

Fits: see print guide (bearing seats/pins/inserts from params.fit). Sheet 4/57

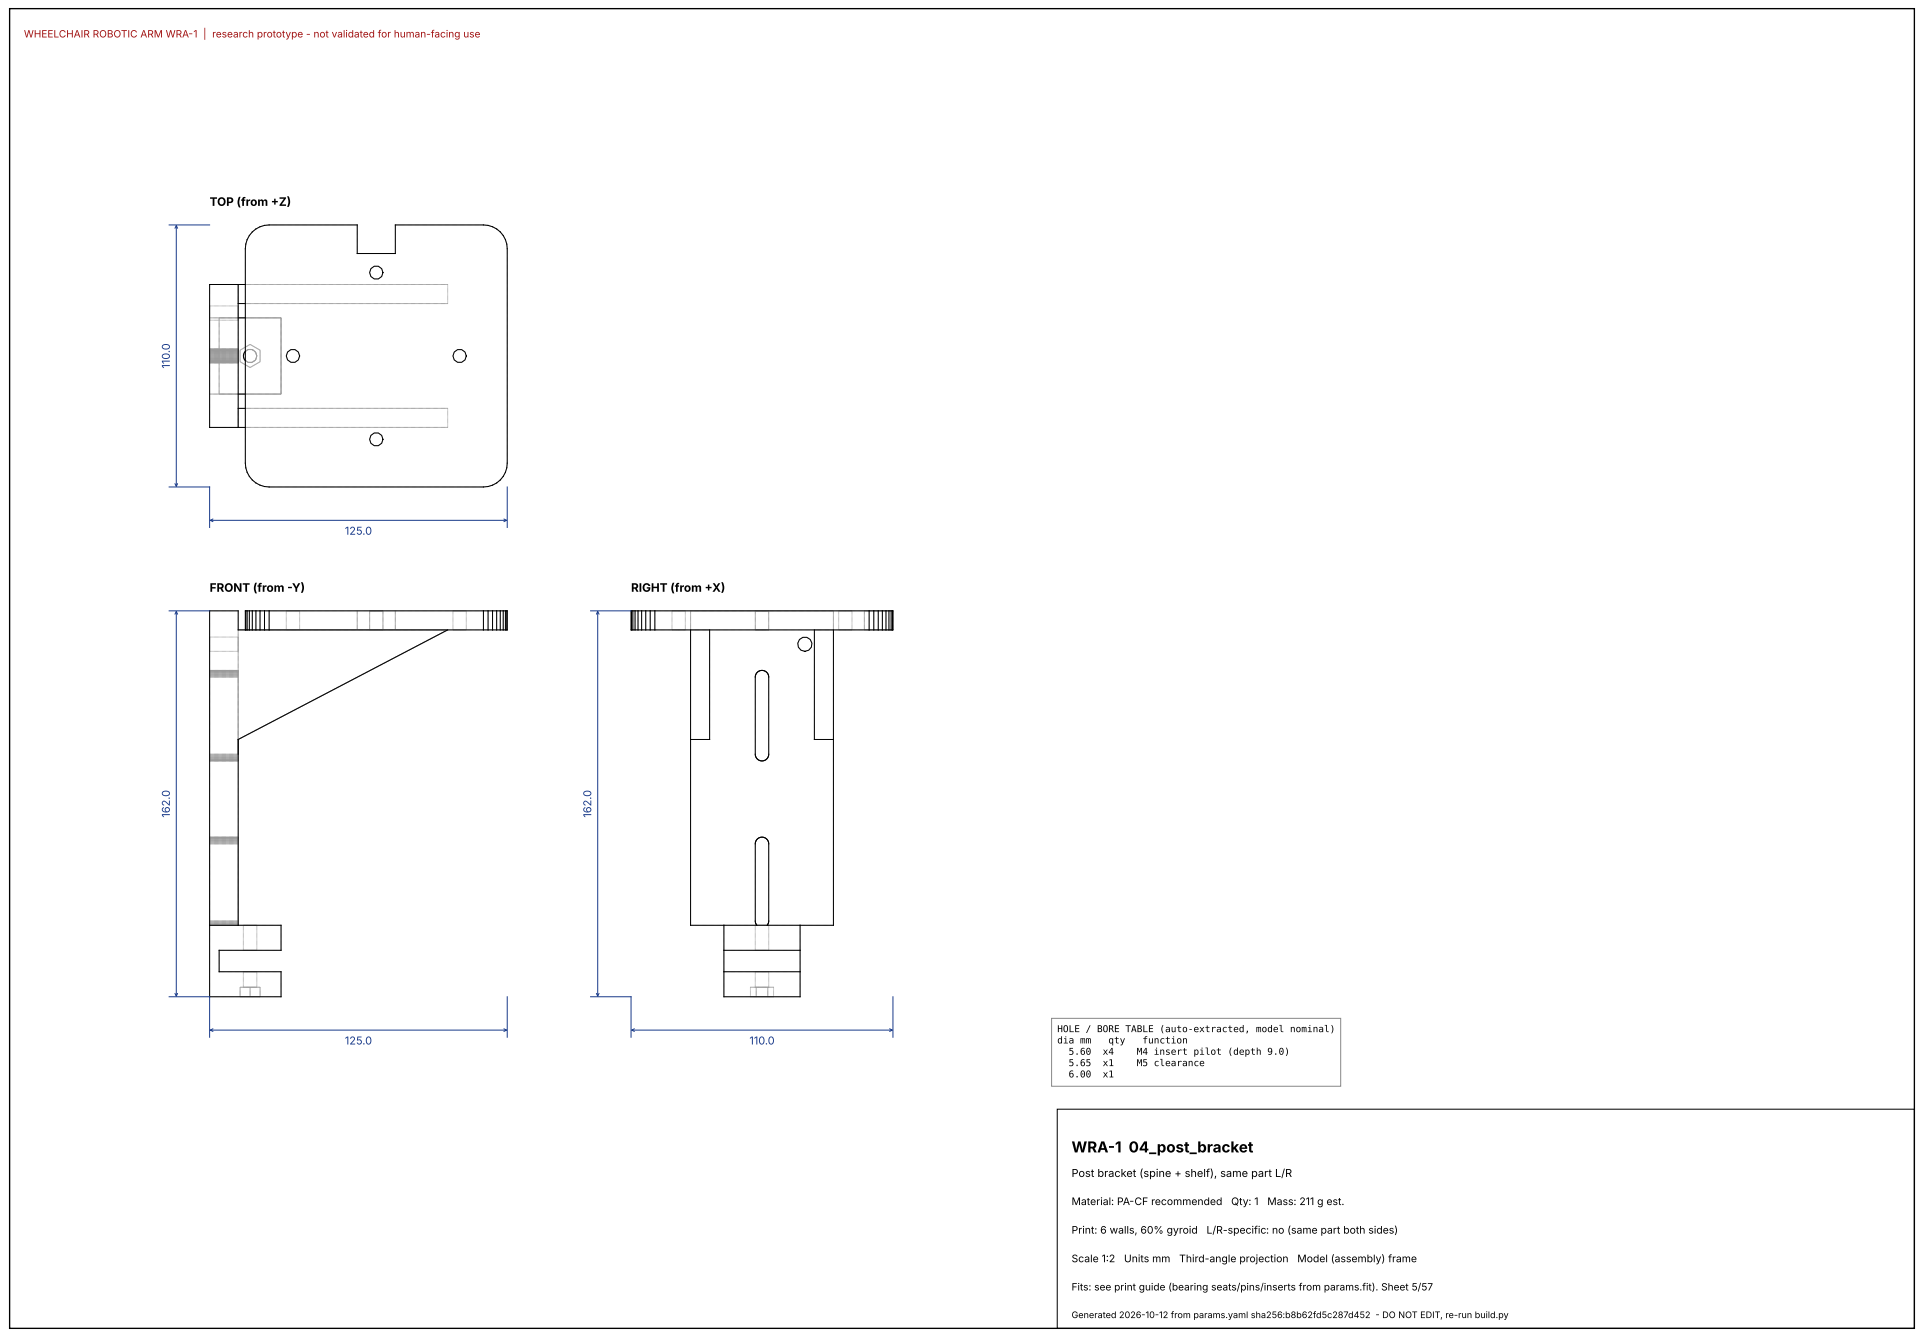
[picture p98: page 6]
FRONT (from -Y); TOP (from +Z); RIGHT (from +X); dia mm; qty; function; M4 insert pilot (depth 9.0); M5 clearance; WRA-1 04_post_bracket

HOLE / BORE TABLE (auto-extracted, model nominal)

Post bracket (spine + shelf), same part L/R

Material: PA-CF recommended Qty: 1 Mass: 211 g est.

Print: 6 walls, 60% gyroid L/R-specific: no (same part both sides)

Scale 1:2 Units mm Third-angle projection Model (assembly) frame

Fits: see print guide (bearing seats/pins/inserts from params.fit). Sheet 5/57

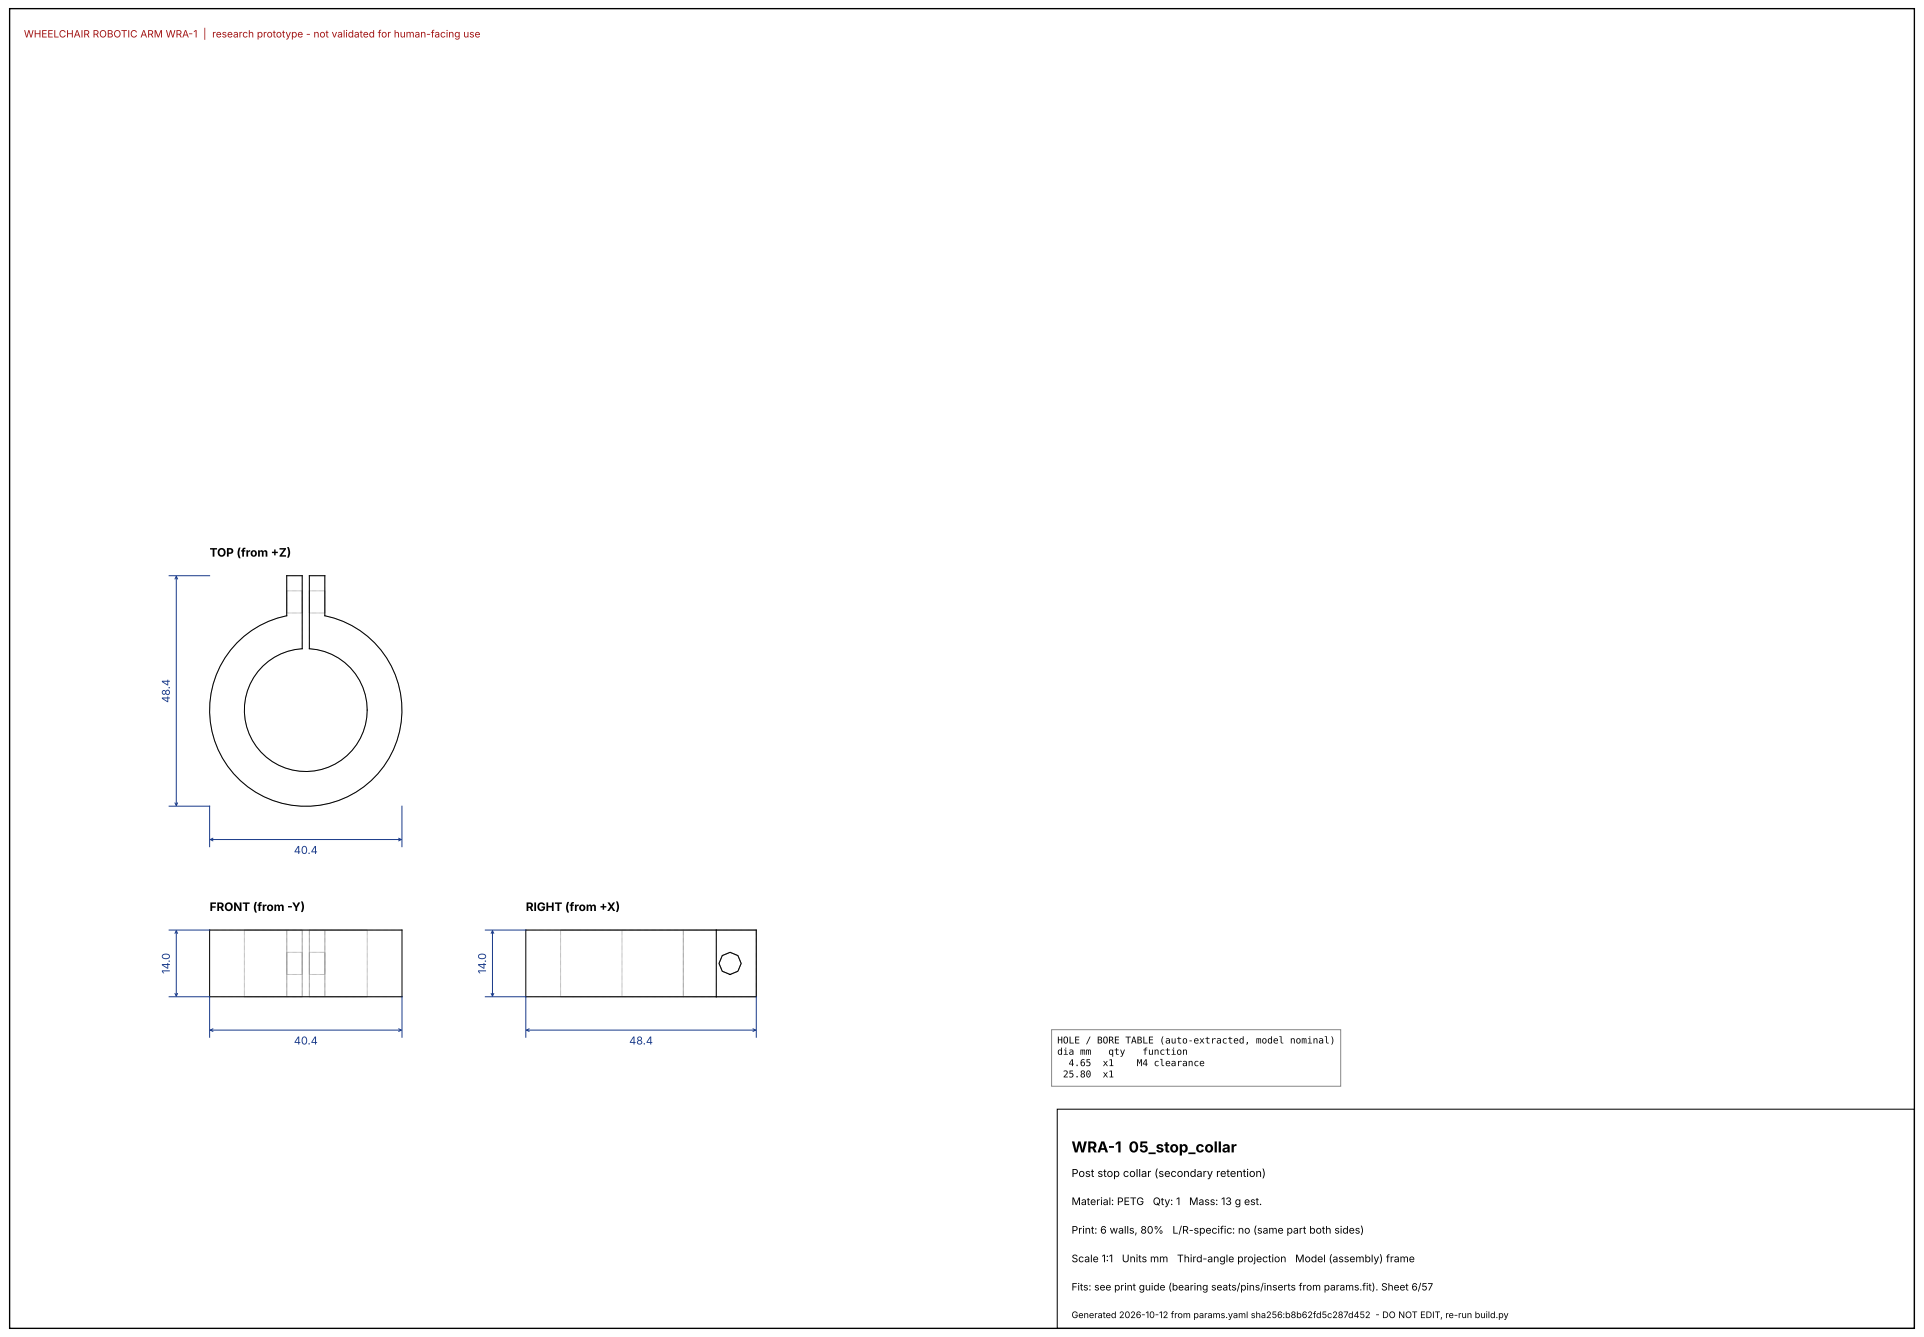
[picture p99: page 7]
FRONT (from -Y); TOP (from +Z); RIGHT (from +X); dia mm; qty; function; M4 clearance; WRA-1 05_stop_collar

HOLE / BORE TABLE (auto-extracted, model nominal)

Post stop collar (secondary retention)

Material: PETG Qty: 1 Mass: 13 g est.

Print: 6 walls, 80% L/R-specific: no (same part both sides)

Fits: see print guide (bearing seats/pins/inserts from params.fit). Sheet 6/57

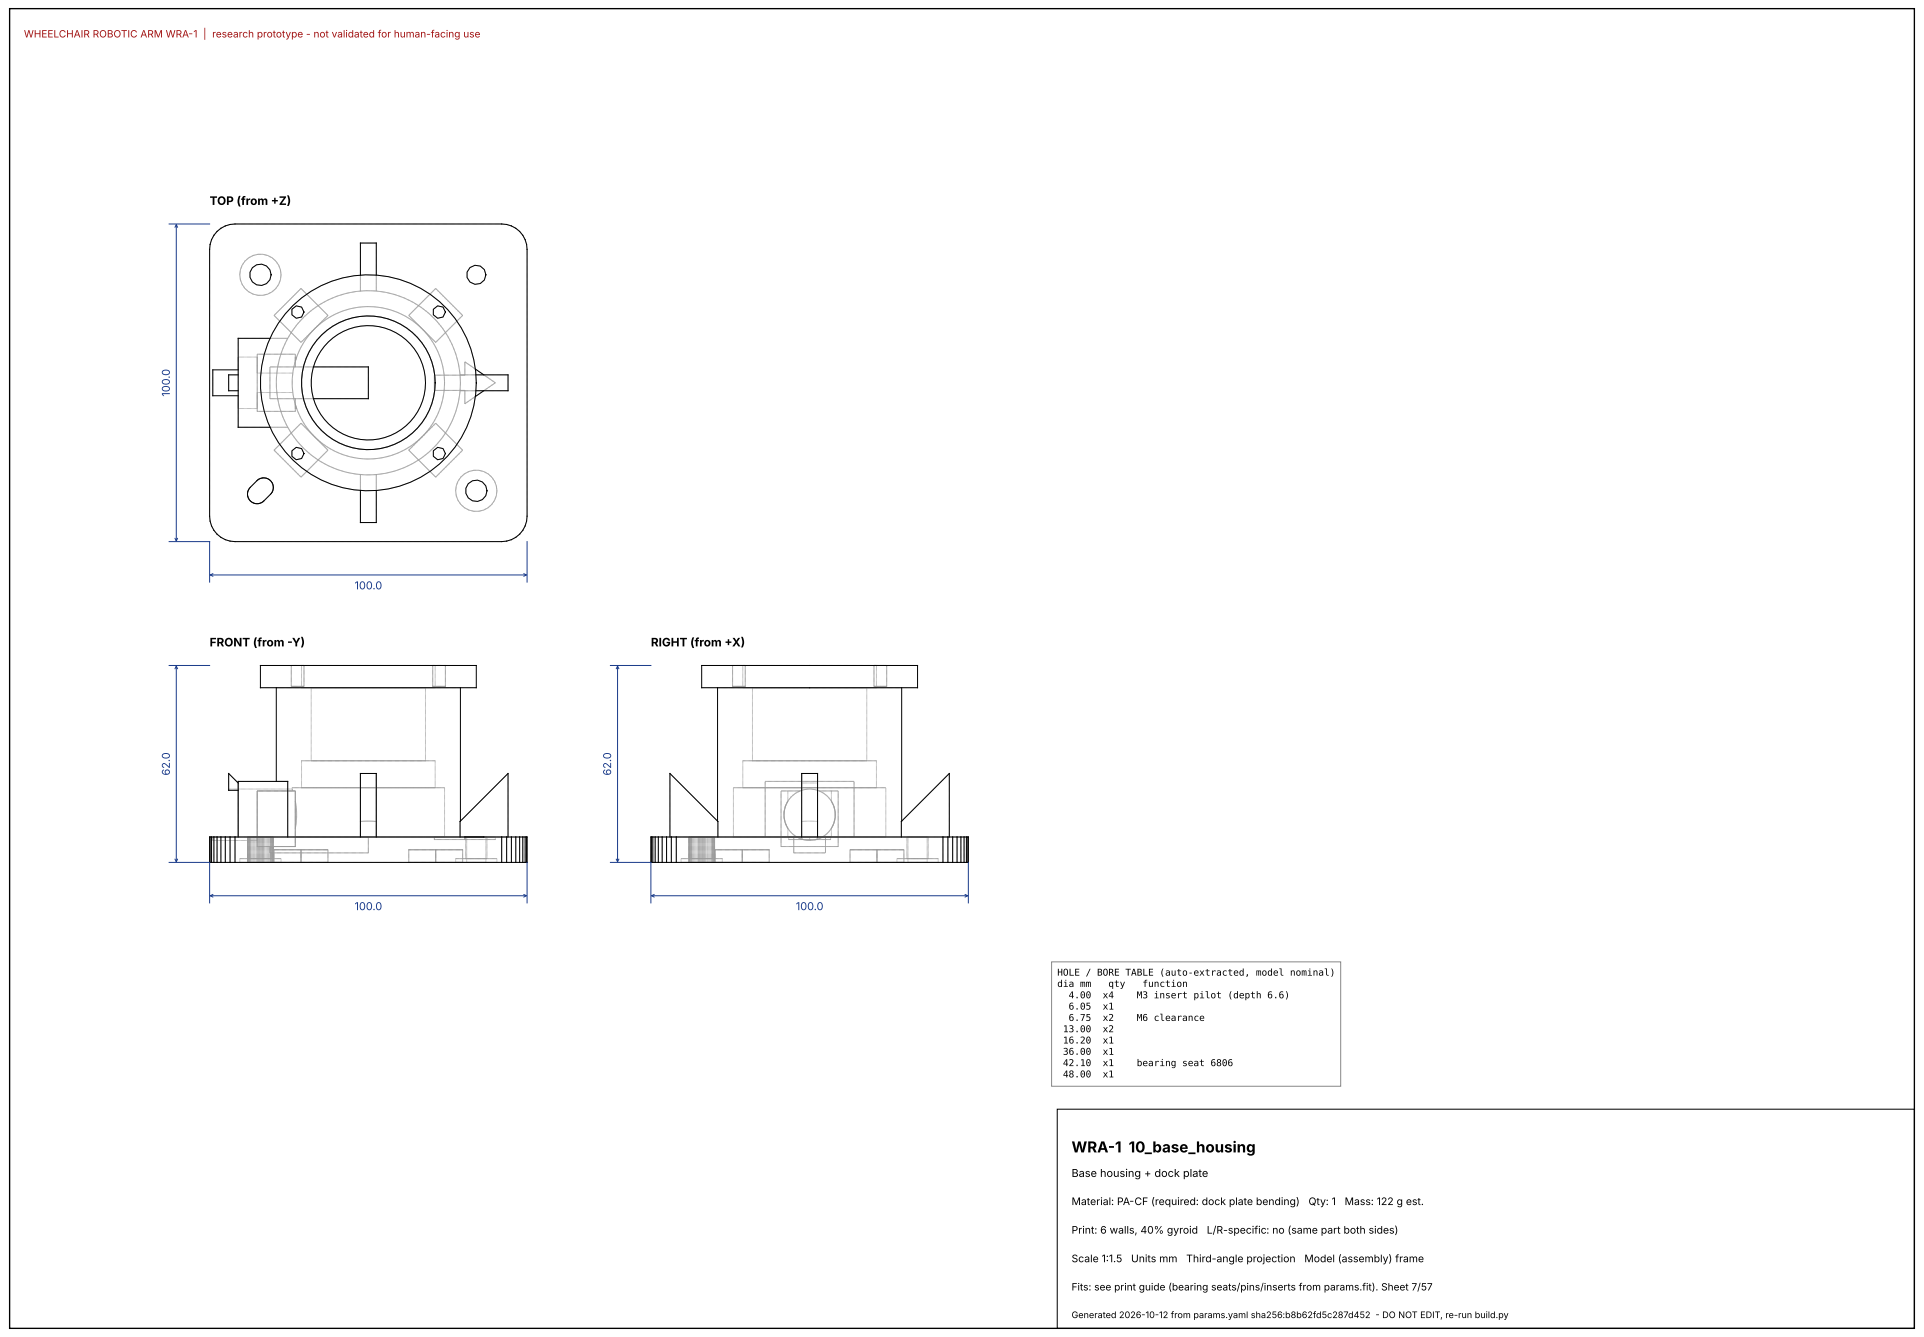
[picture p100: page 8]
FRONT (from -Y); TOP (from +Z); RIGHT (from +X); dia mm; qty; function; M3 insert pilot (depth 6.6); M6 clearance; bearing seat 6806; WRA-1 10_base_housing

HOLE / BORE TABLE (auto-extracted, model nominal)

Base housing + dock plate

Material: PA-CF (required: dock plate bending) Qty: 1 Mass: 122 g est.

Print: 6 walls, 40% gyroid L/R-specific: no (same part both sides)

Scale 1:1.5 Units mm Third-angle projection Model (assembly) frame

Fits: see print guide (bearing seats/pins/inserts from params.fit). Sheet 7/57

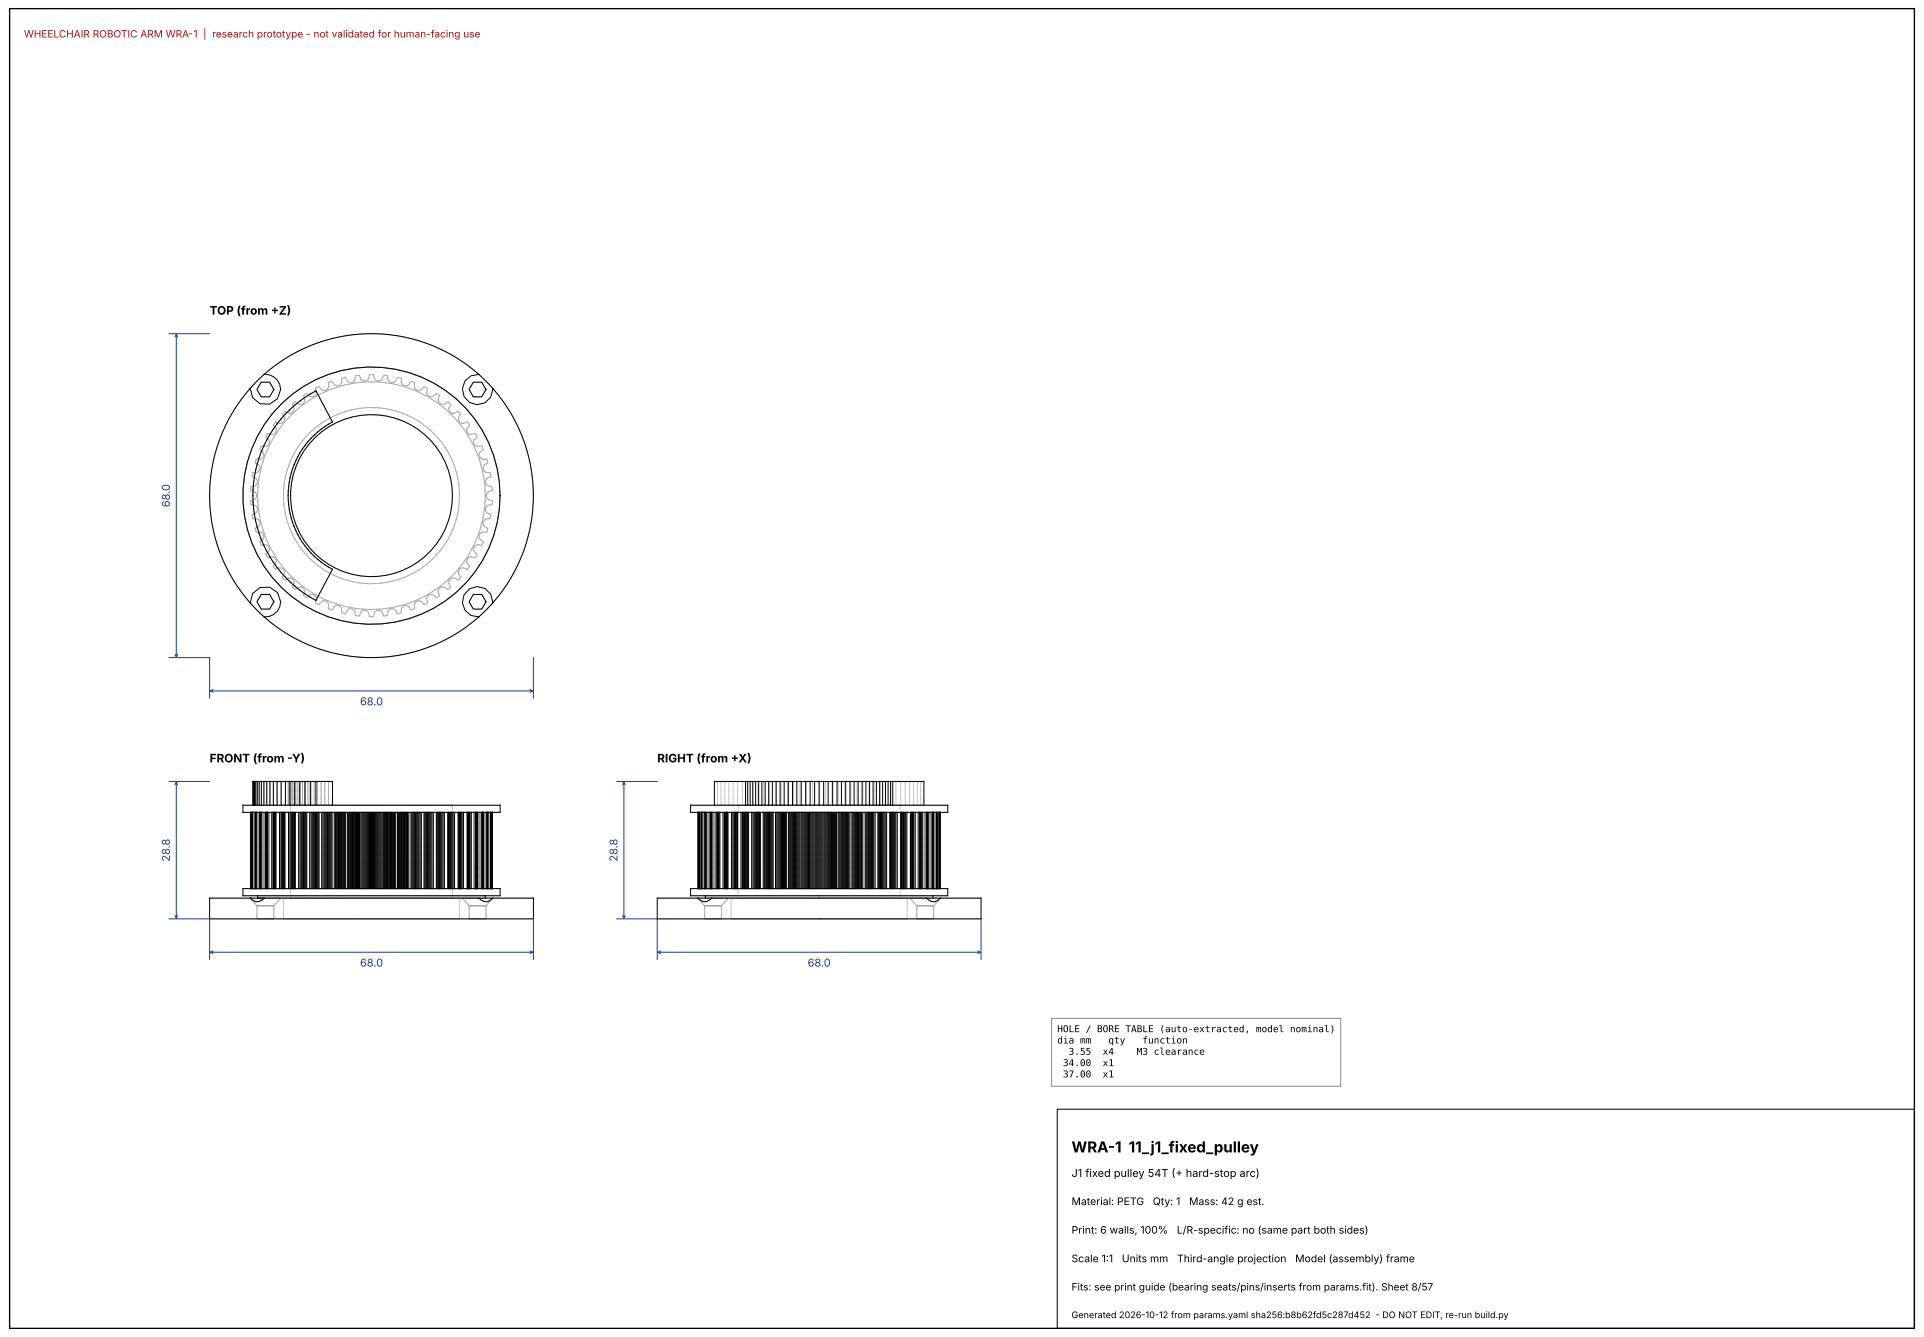
[picture p101: page 9]
FRONT (from -Y); TOP (from +Z); RIGHT (from +X); dia mm; qty; function; M3 clearance; WRA-1 11_j1_fixed_pulley

HOLE / BORE TABLE (auto-extracted, model nominal)

J1 fixed pulley 54T (+ hard-stop arc)

Material: PETG Qty: 1 Mass: 42 g est.

Print: 6 walls, 100% L/R-specific: no (same part both sides)

Fits: see print guide (bearing seats/pins/inserts from params.fit). Sheet 8/57

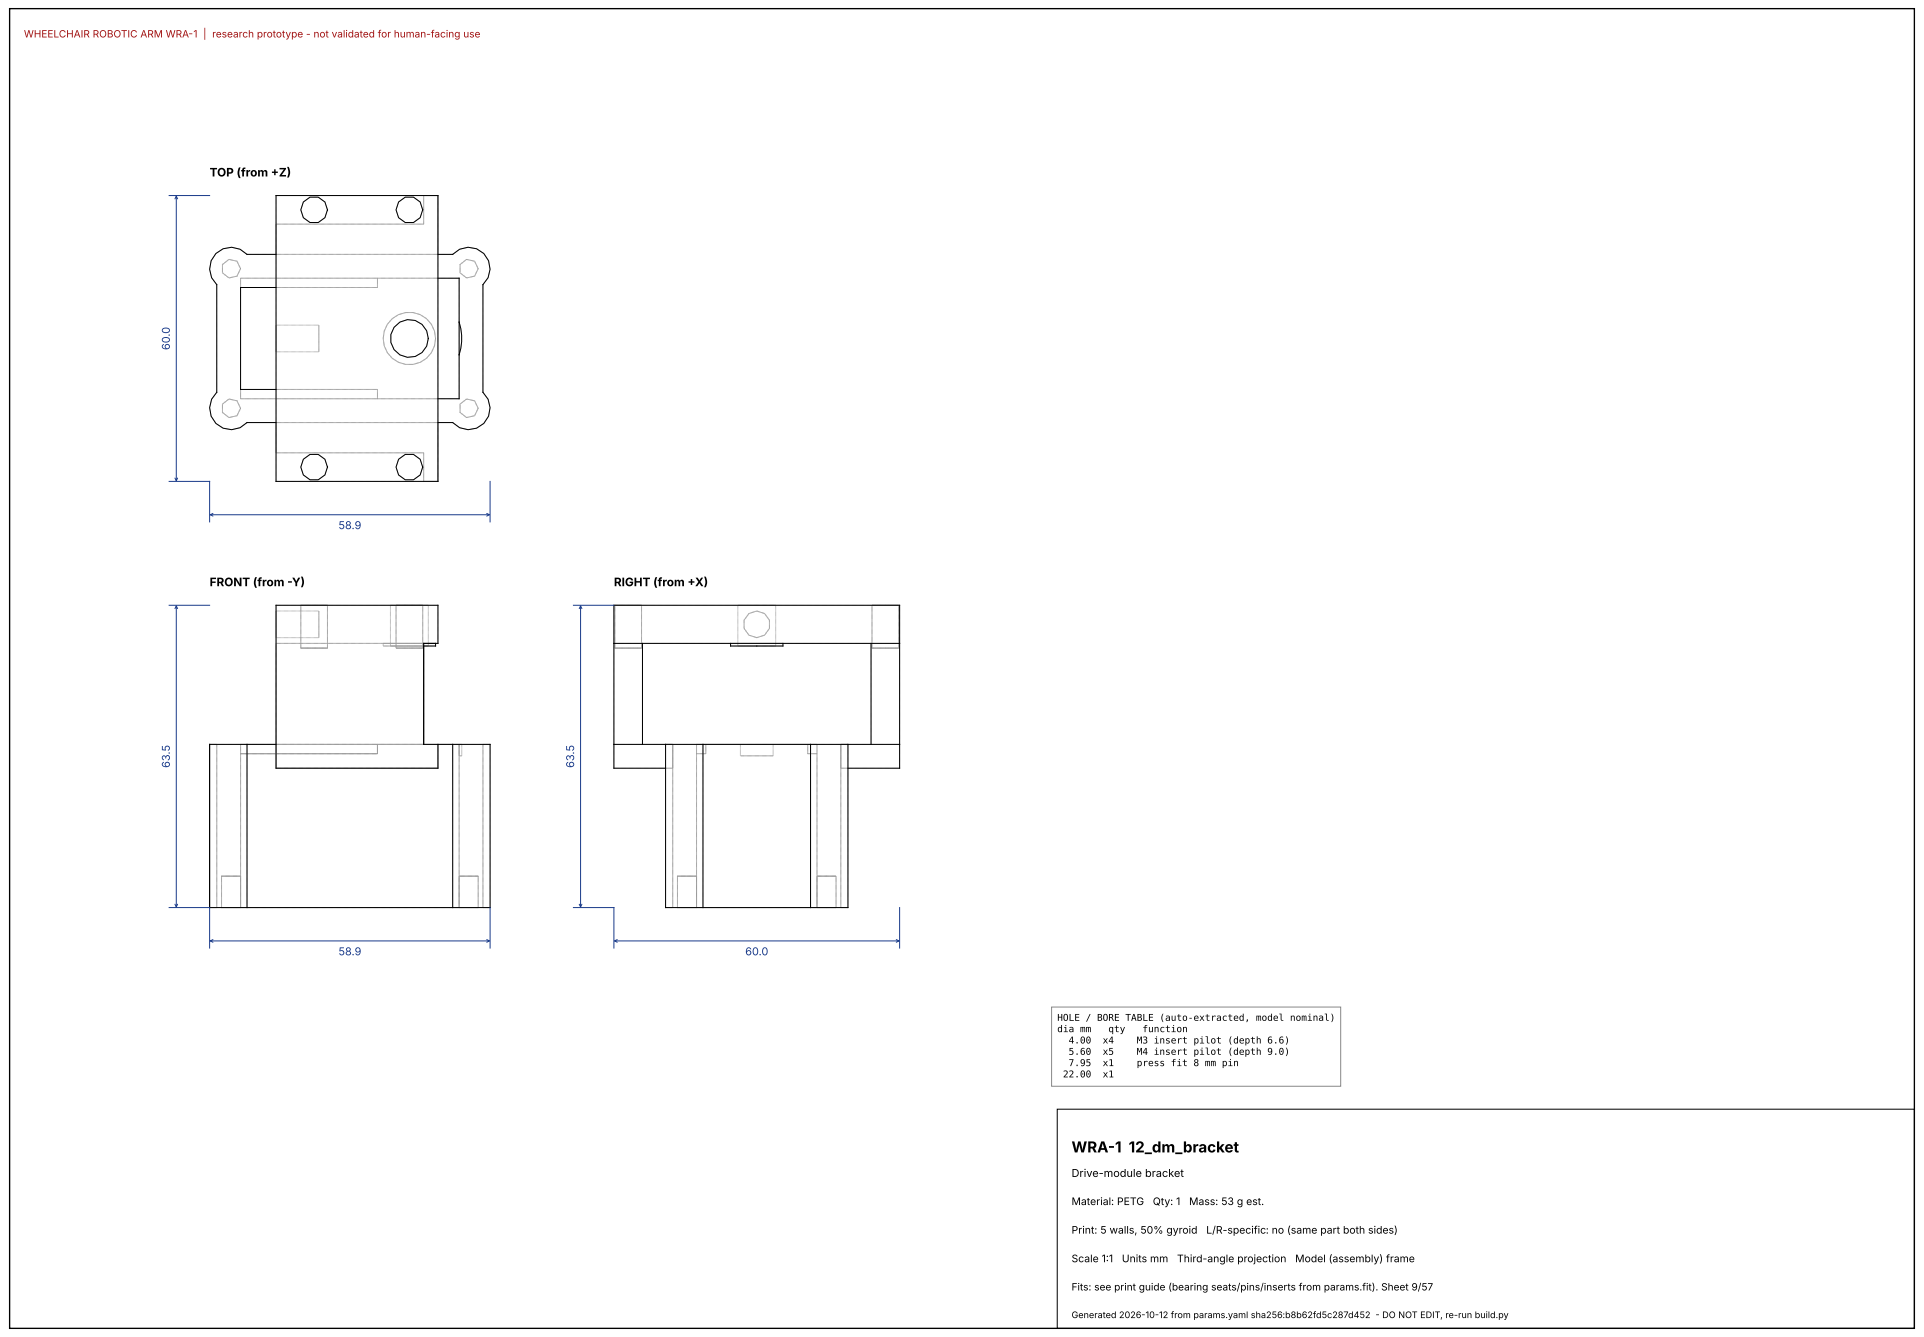
[picture p102: page 10]
FRONT (from -Y); TOP (from +Z); RIGHT (from +X); dia mm; qty; function; M3 insert pilot (depth 6.6); M4 insert pilot (depth 9.0); press fit 8 mm pin; WRA-1 12_dm_bracket

HOLE / BORE TABLE (auto-extracted, model nominal)

Drive-module bracket

Material: PETG Qty: 1 Mass: 53 g est.

Print: 5 walls, 50% gyroid L/R-specific: no (same part both sides)

Fits: see print guide (bearing seats/pins/inserts from params.fit). Sheet 9/57

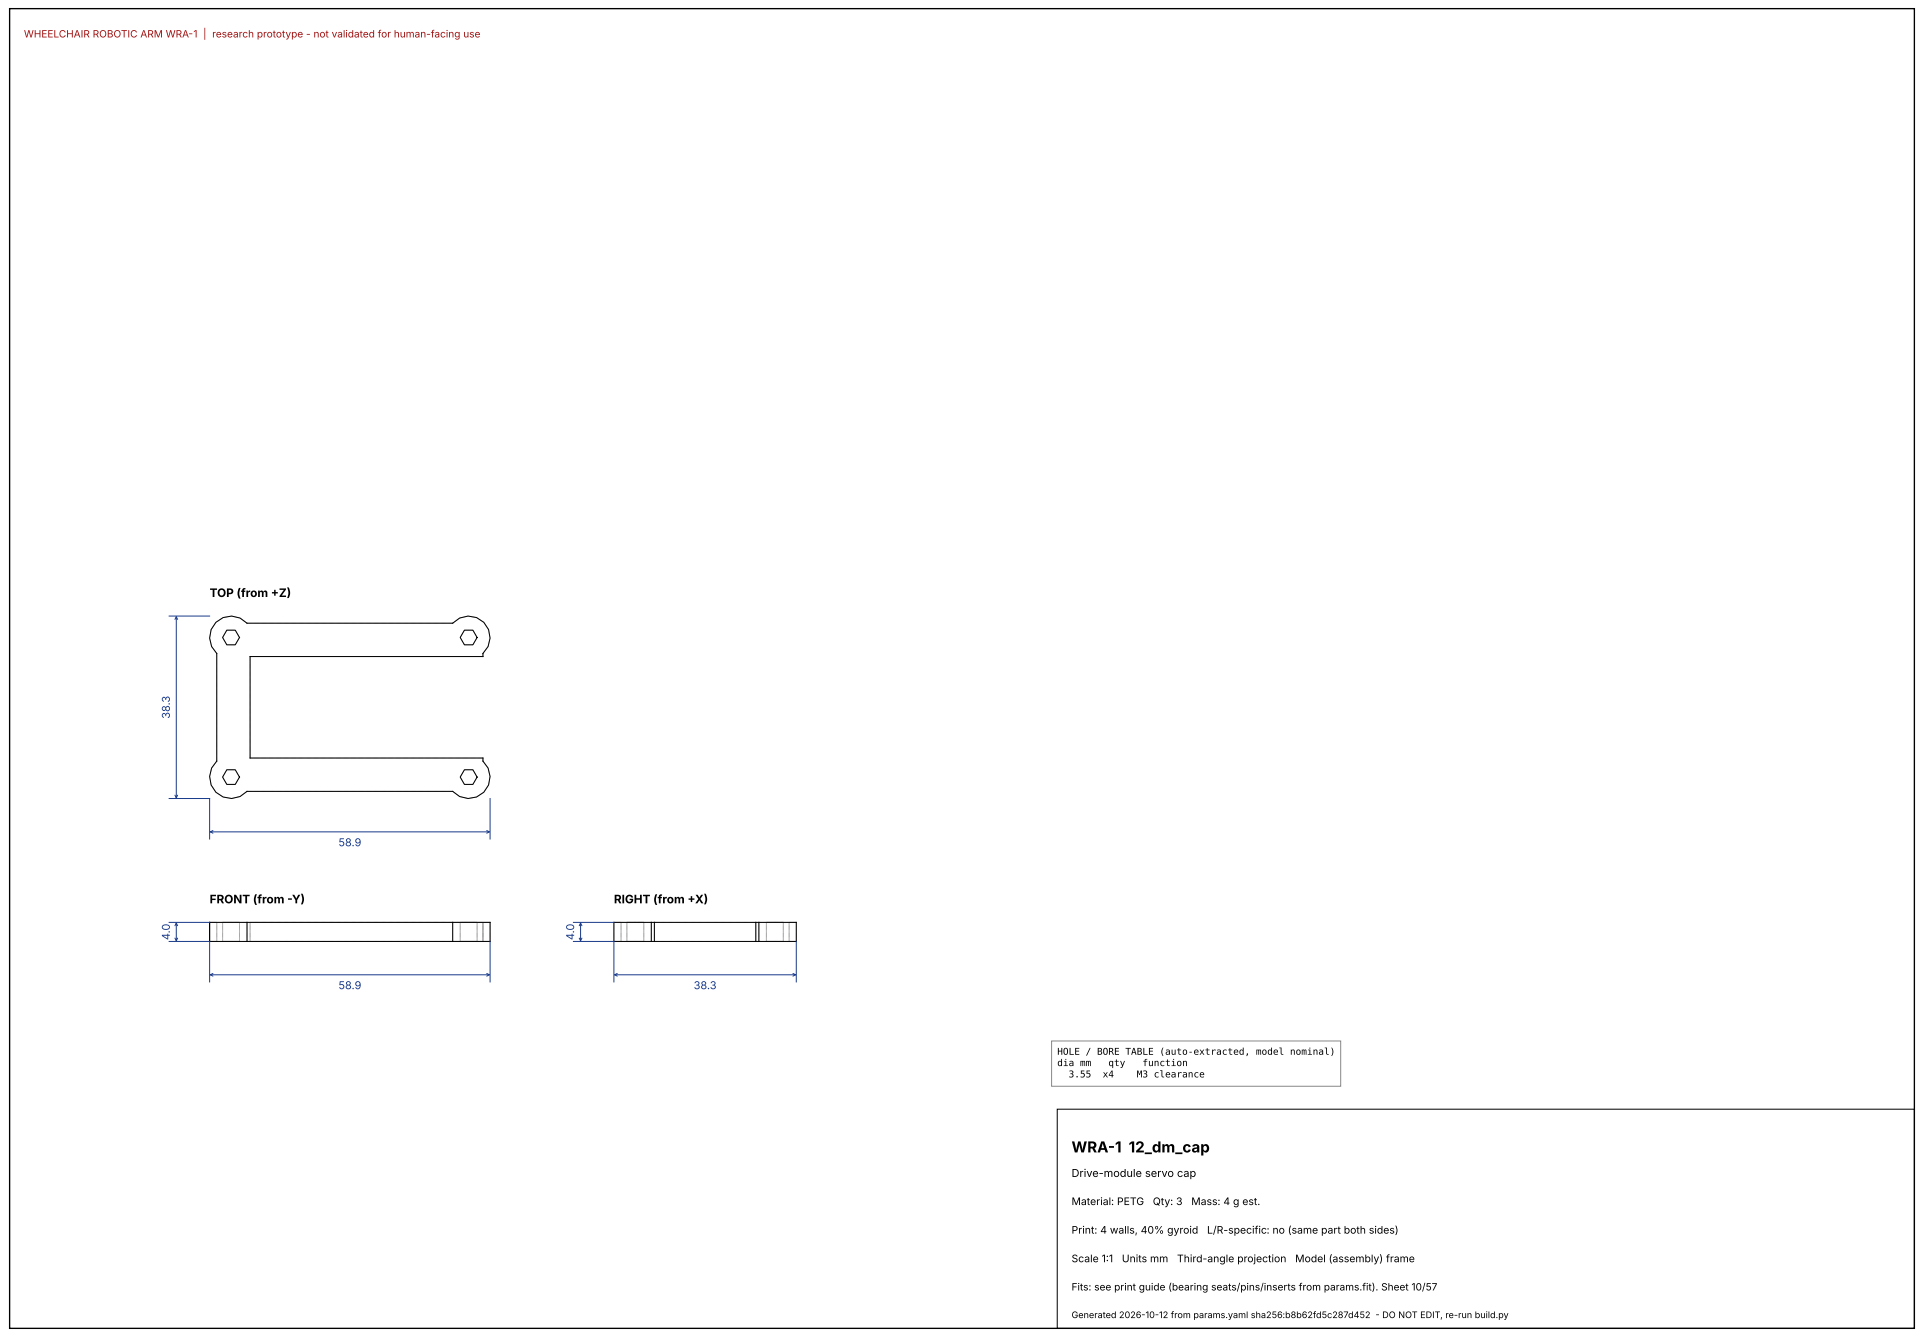
[picture p103: page 11]
FRONT (from -Y); TOP (from +Z); RIGHT (from +X); dia mm; qty; function; M3 clearance; WRA-1 12_dm_cap

HOLE / BORE TABLE (auto-extracted, model nominal)

Drive-module servo cap

Material: PETG Qty: 3 Mass: 4 g est.

Print: 4 walls, 40% gyroid L/R-specific: no (same part both sides)

Fits: see print guide (bearing seats/pins/inserts from params.fit). Sheet 10/57

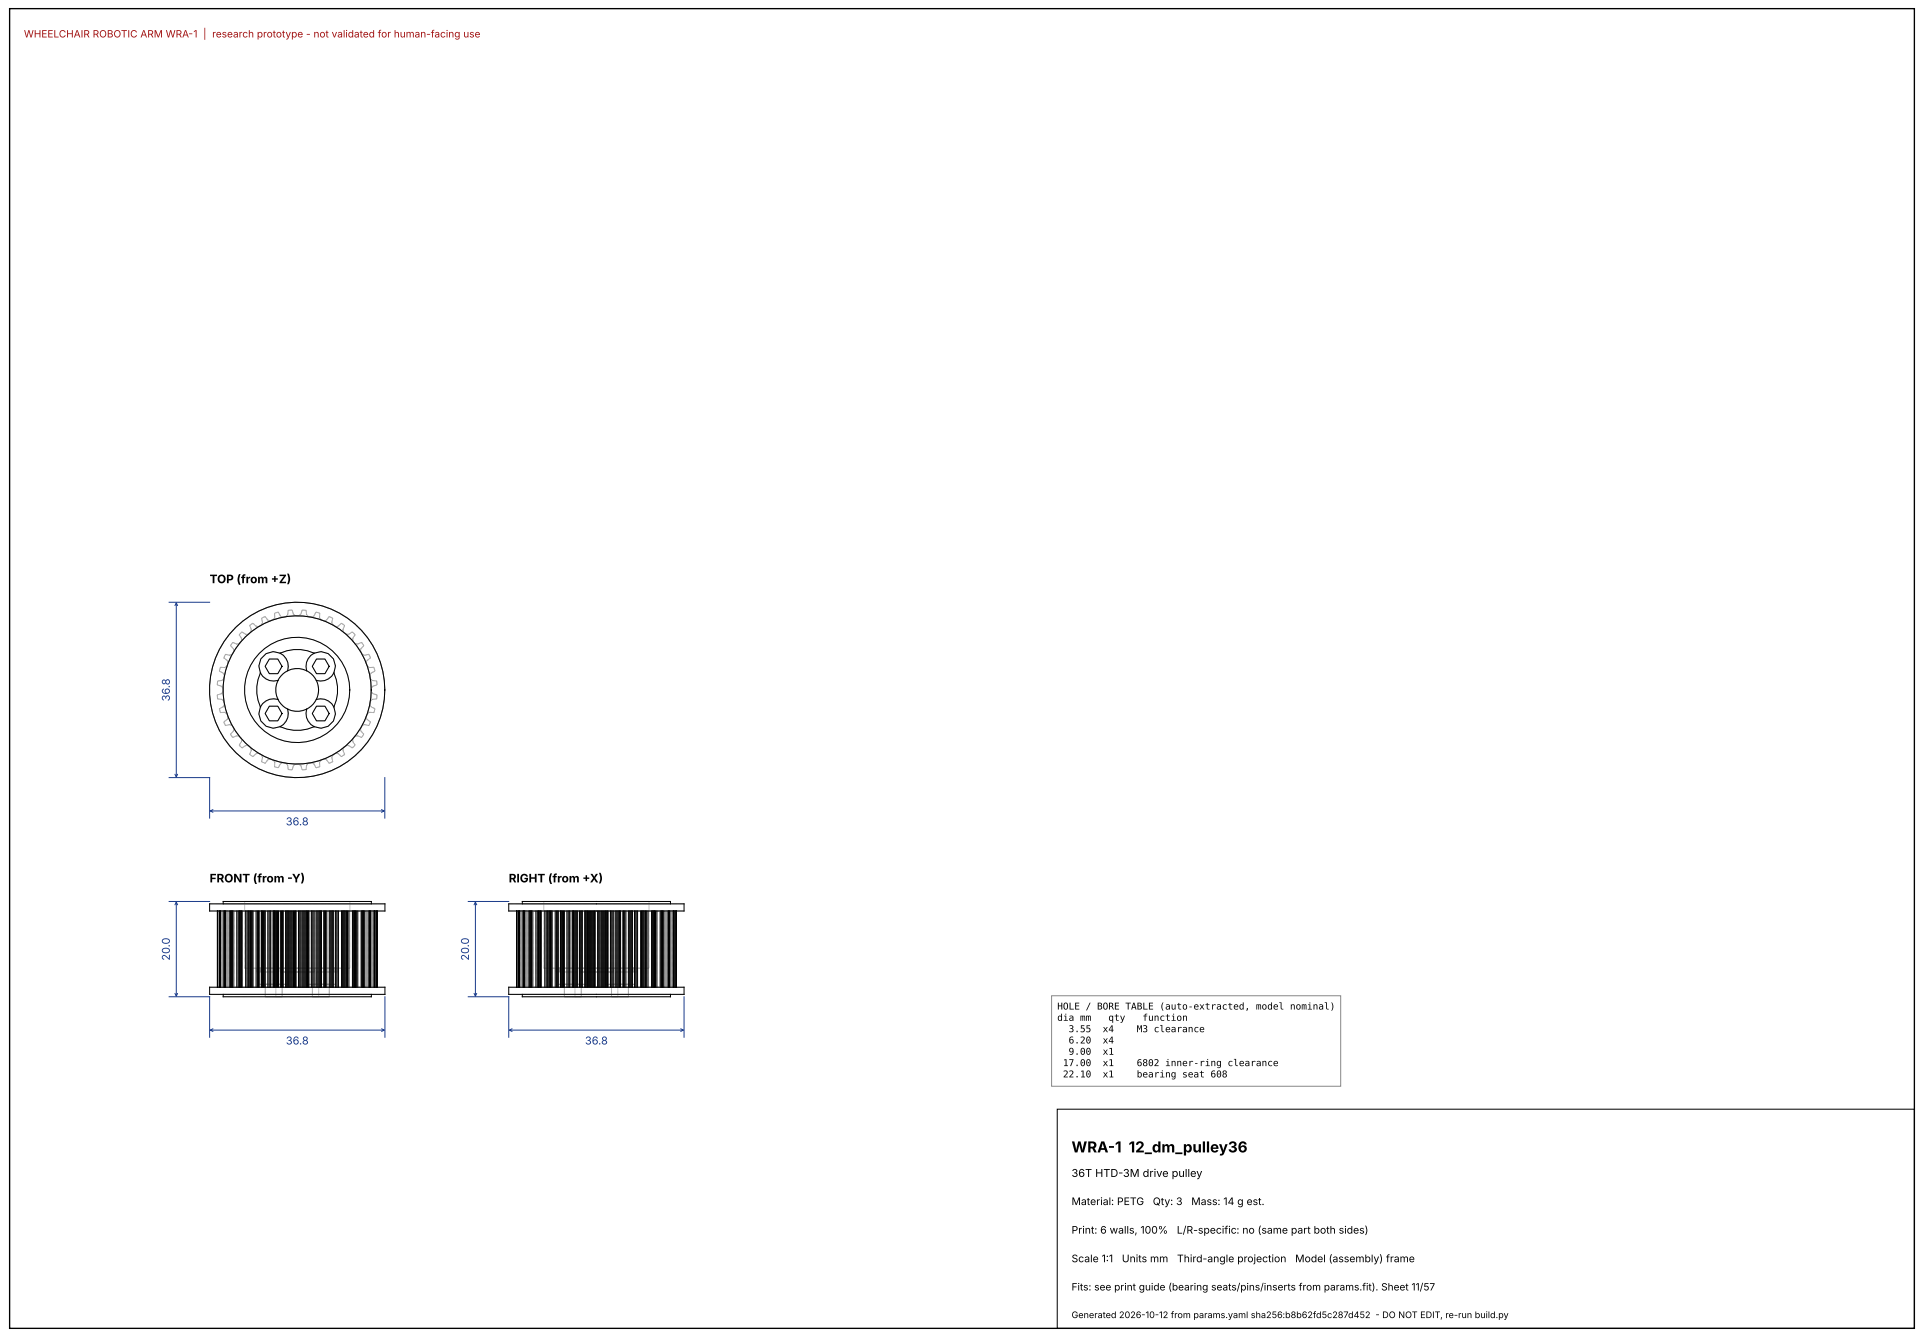
[picture p104: page 12]
FRONT (from -Y); TOP (from +Z); RIGHT (from +X); dia mm; qty; function; M3 clearance; 6802 inner-ring clearance; bearing seat 608; WRA-1 12_dm_pulley36

HOLE / BORE TABLE (auto-extracted, model nominal)

36T HTD-3M drive pulley

Material: PETG Qty: 3 Mass: 14 g est.

Print: 6 walls, 100% L/R-specific: no (same part both sides)

Fits: see print guide (bearing seats/pins/inserts from params.fit). Sheet 11/57

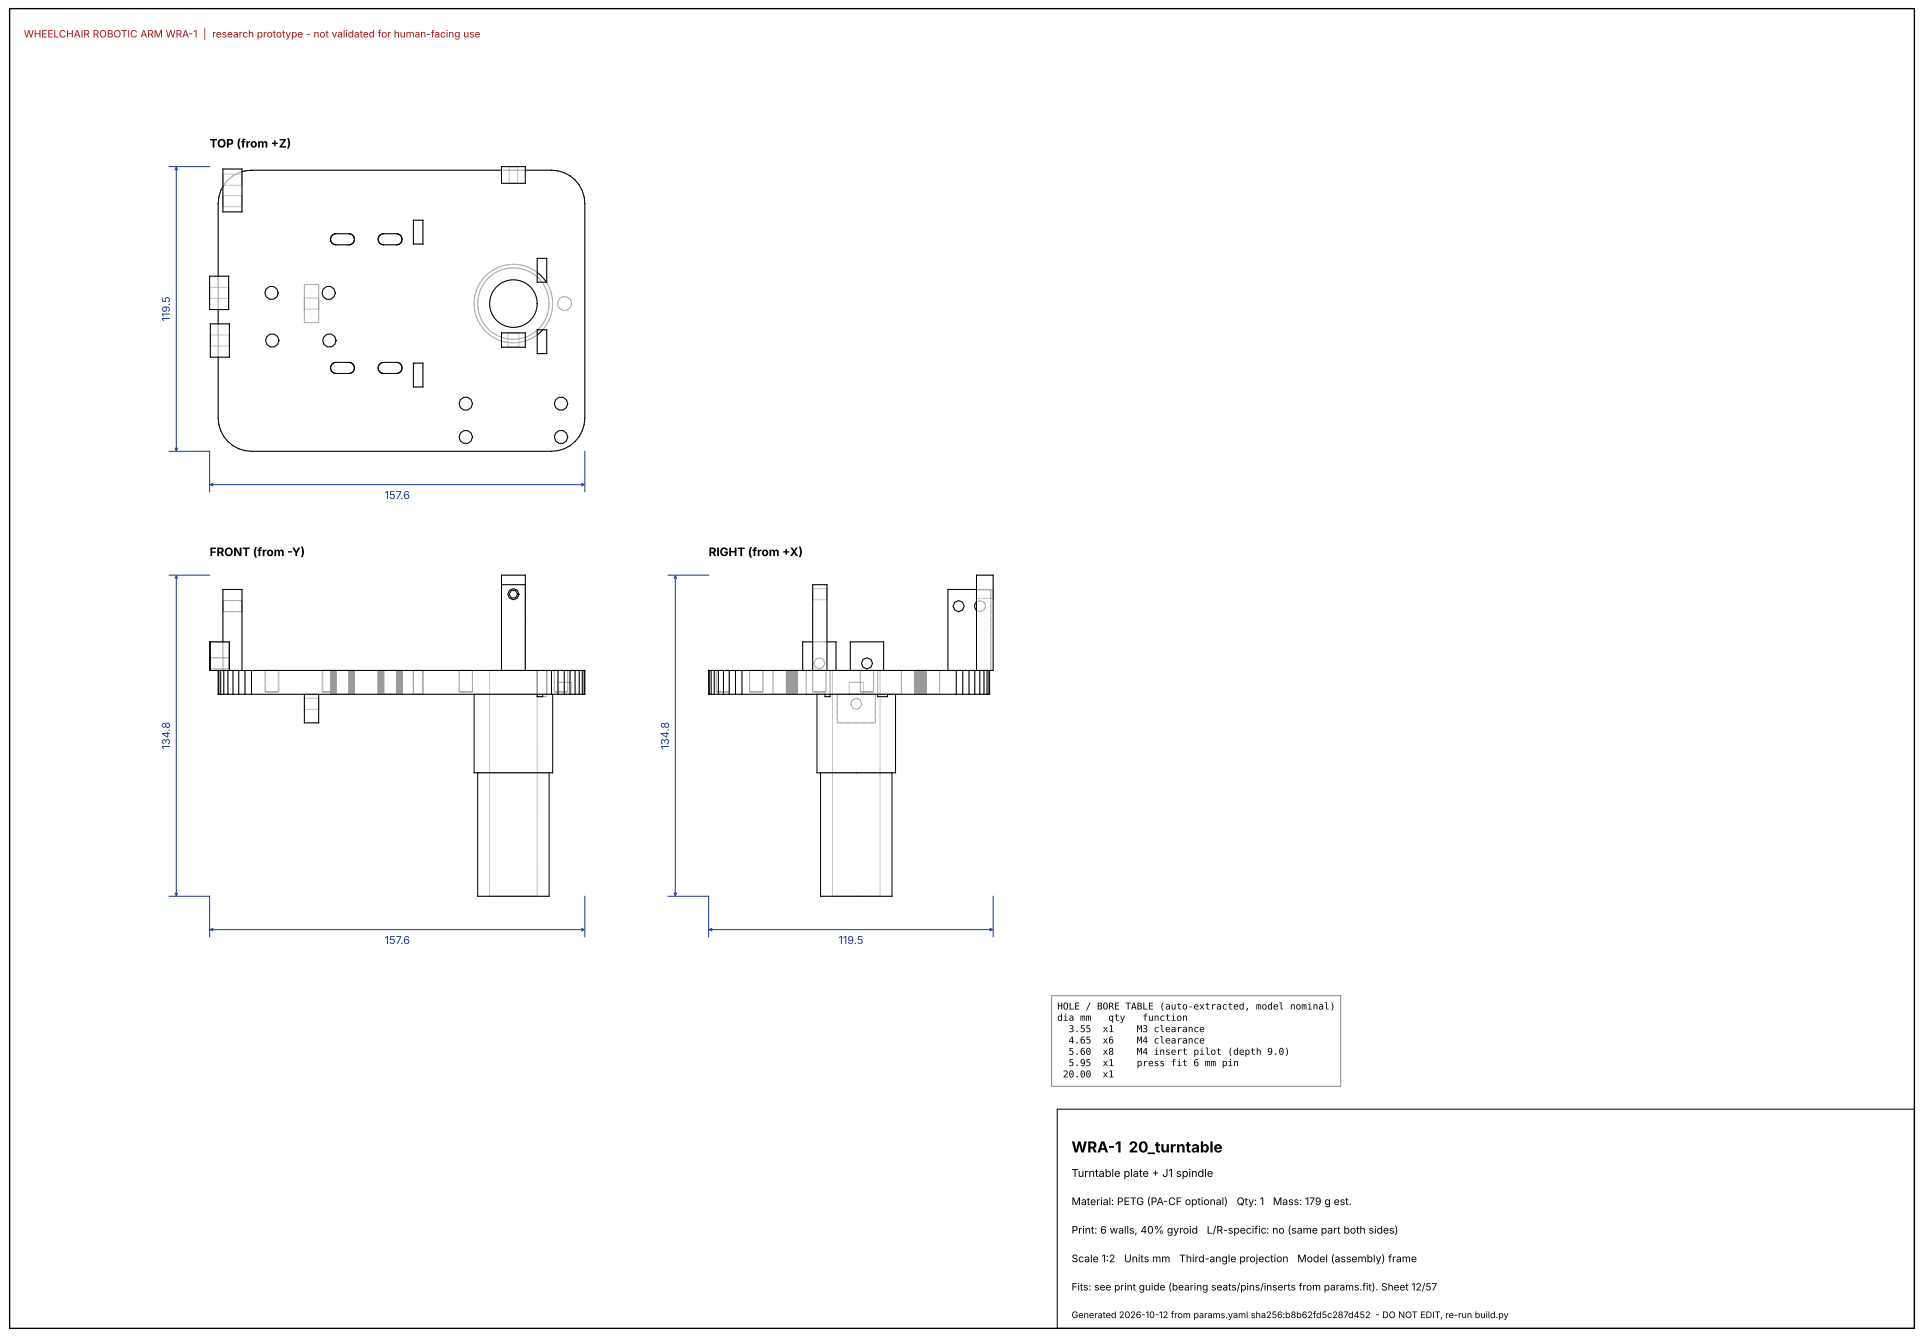
[picture p105: page 13]
FRONT (from -Y); TOP (from +Z); RIGHT (from +X); dia mm; qty; function; M3 clearance; M4 clearance; M4 insert pilot (depth 9.0); press fit 6 mm pin; WRA-1 20_turntable

HOLE / BORE TABLE (auto-extracted, model nominal)

Turntable plate + J1 spindle

Material: PETG (PA-CF optional) Qty: 1 Mass: 179 g est.

Print: 6 walls, 40% gyroid L/R-specific: no (same part both sides)

Scale 1:2 Units mm Third-angle projection Model (assembly) frame

Fits: see print guide (bearing seats/pins/inserts from params.fit). Sheet 12/57

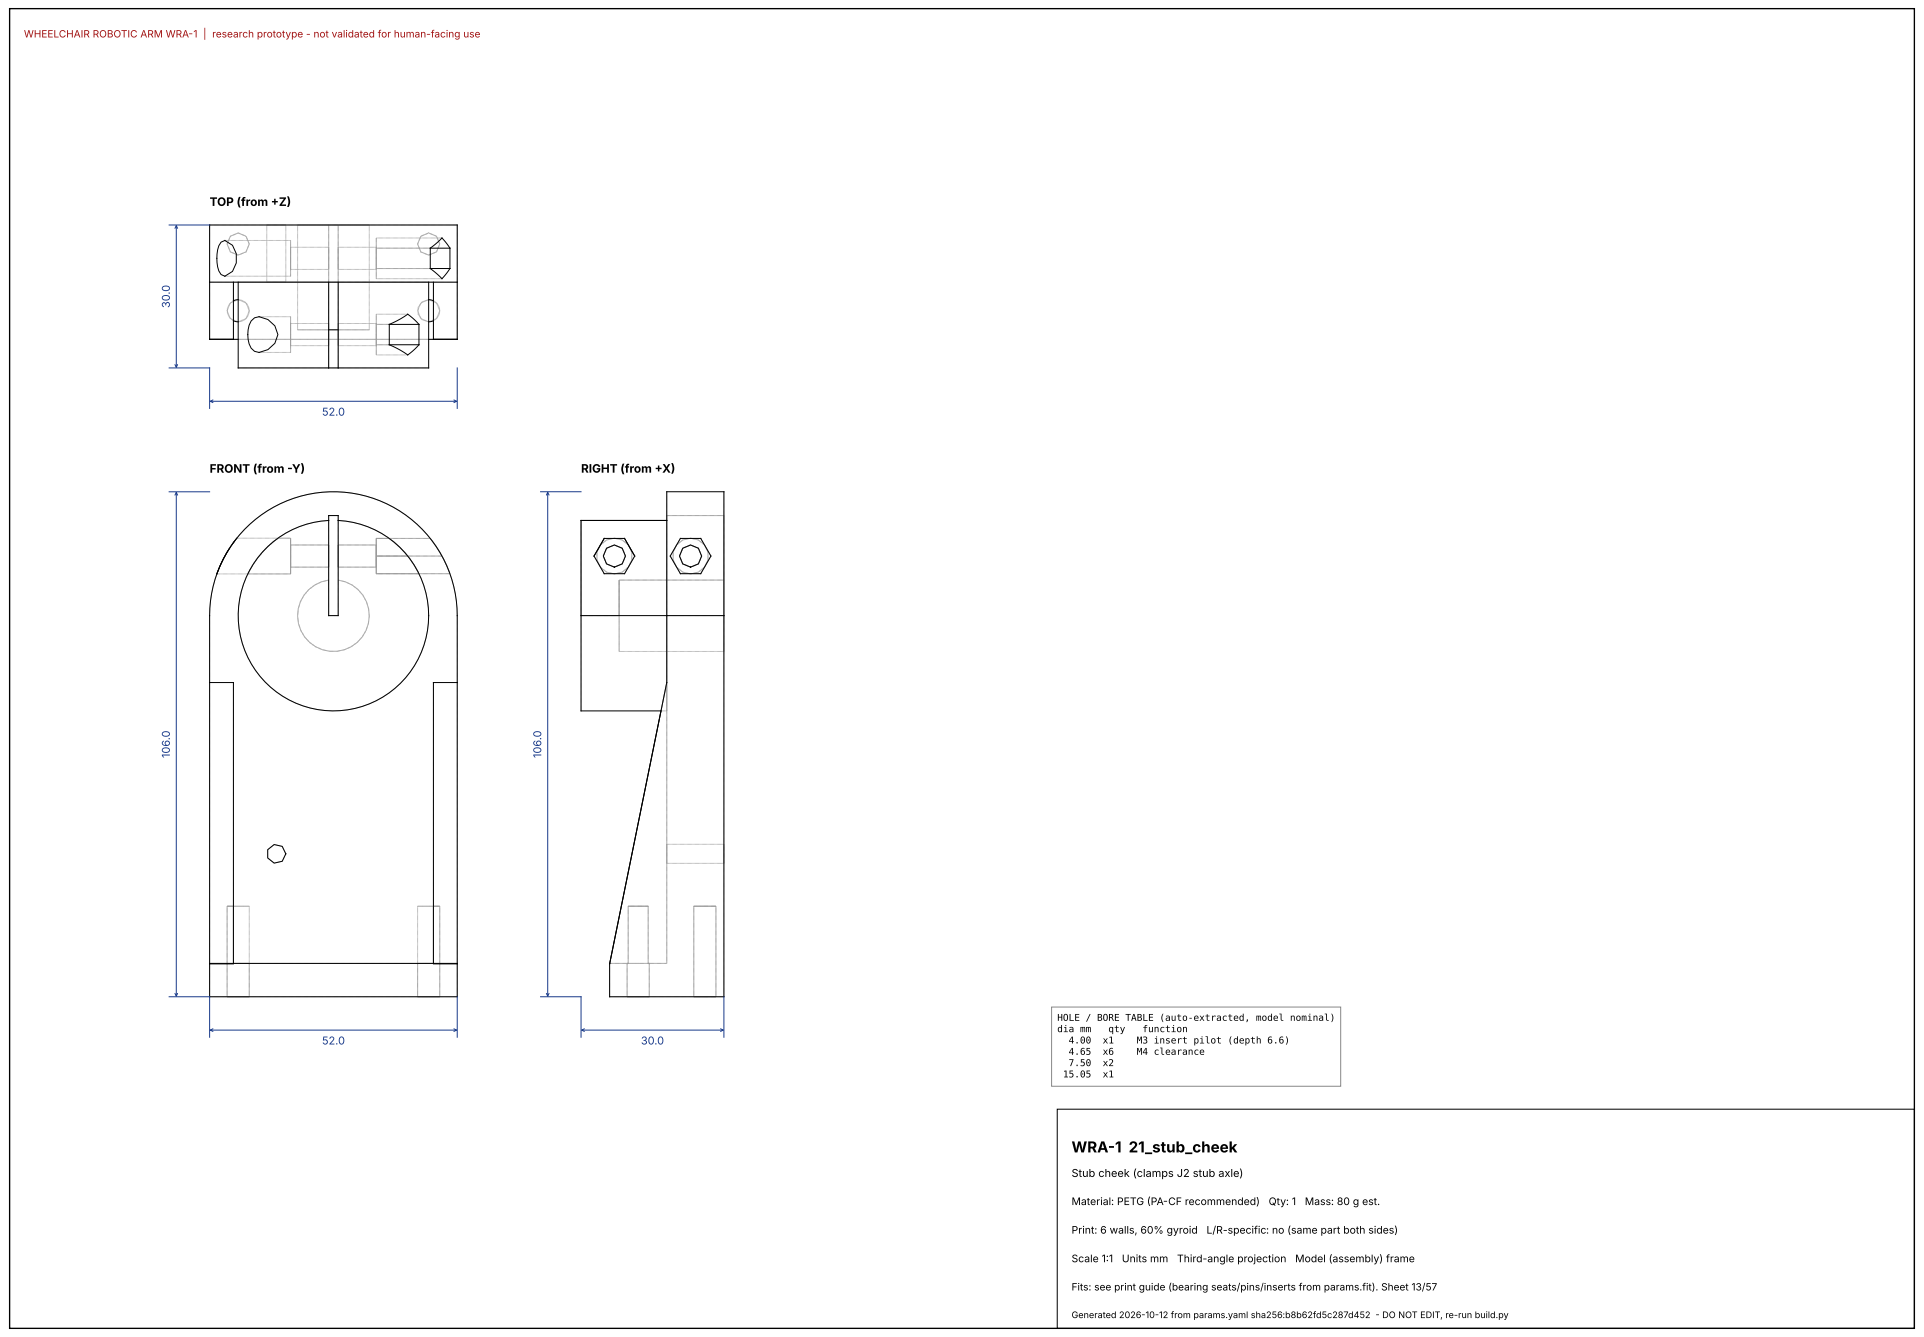
[picture p106: page 14]
FRONT (from -Y); TOP (from +Z); RIGHT (from +X); dia mm; qty; function; M3 insert pilot (depth 6.6); M4 clearance; WRA-1 21_stub_cheek

HOLE / BORE TABLE (auto-extracted, model nominal)

Stub cheek (clamps J2 stub axle)

Material: PETG (PA-CF recommended) Qty: 1 Mass: 80 g est.

Print: 6 walls, 60% gyroid L/R-specific: no (same part both sides)

Fits: see print guide (bearing seats/pins/inserts from params.fit). Sheet 13/57

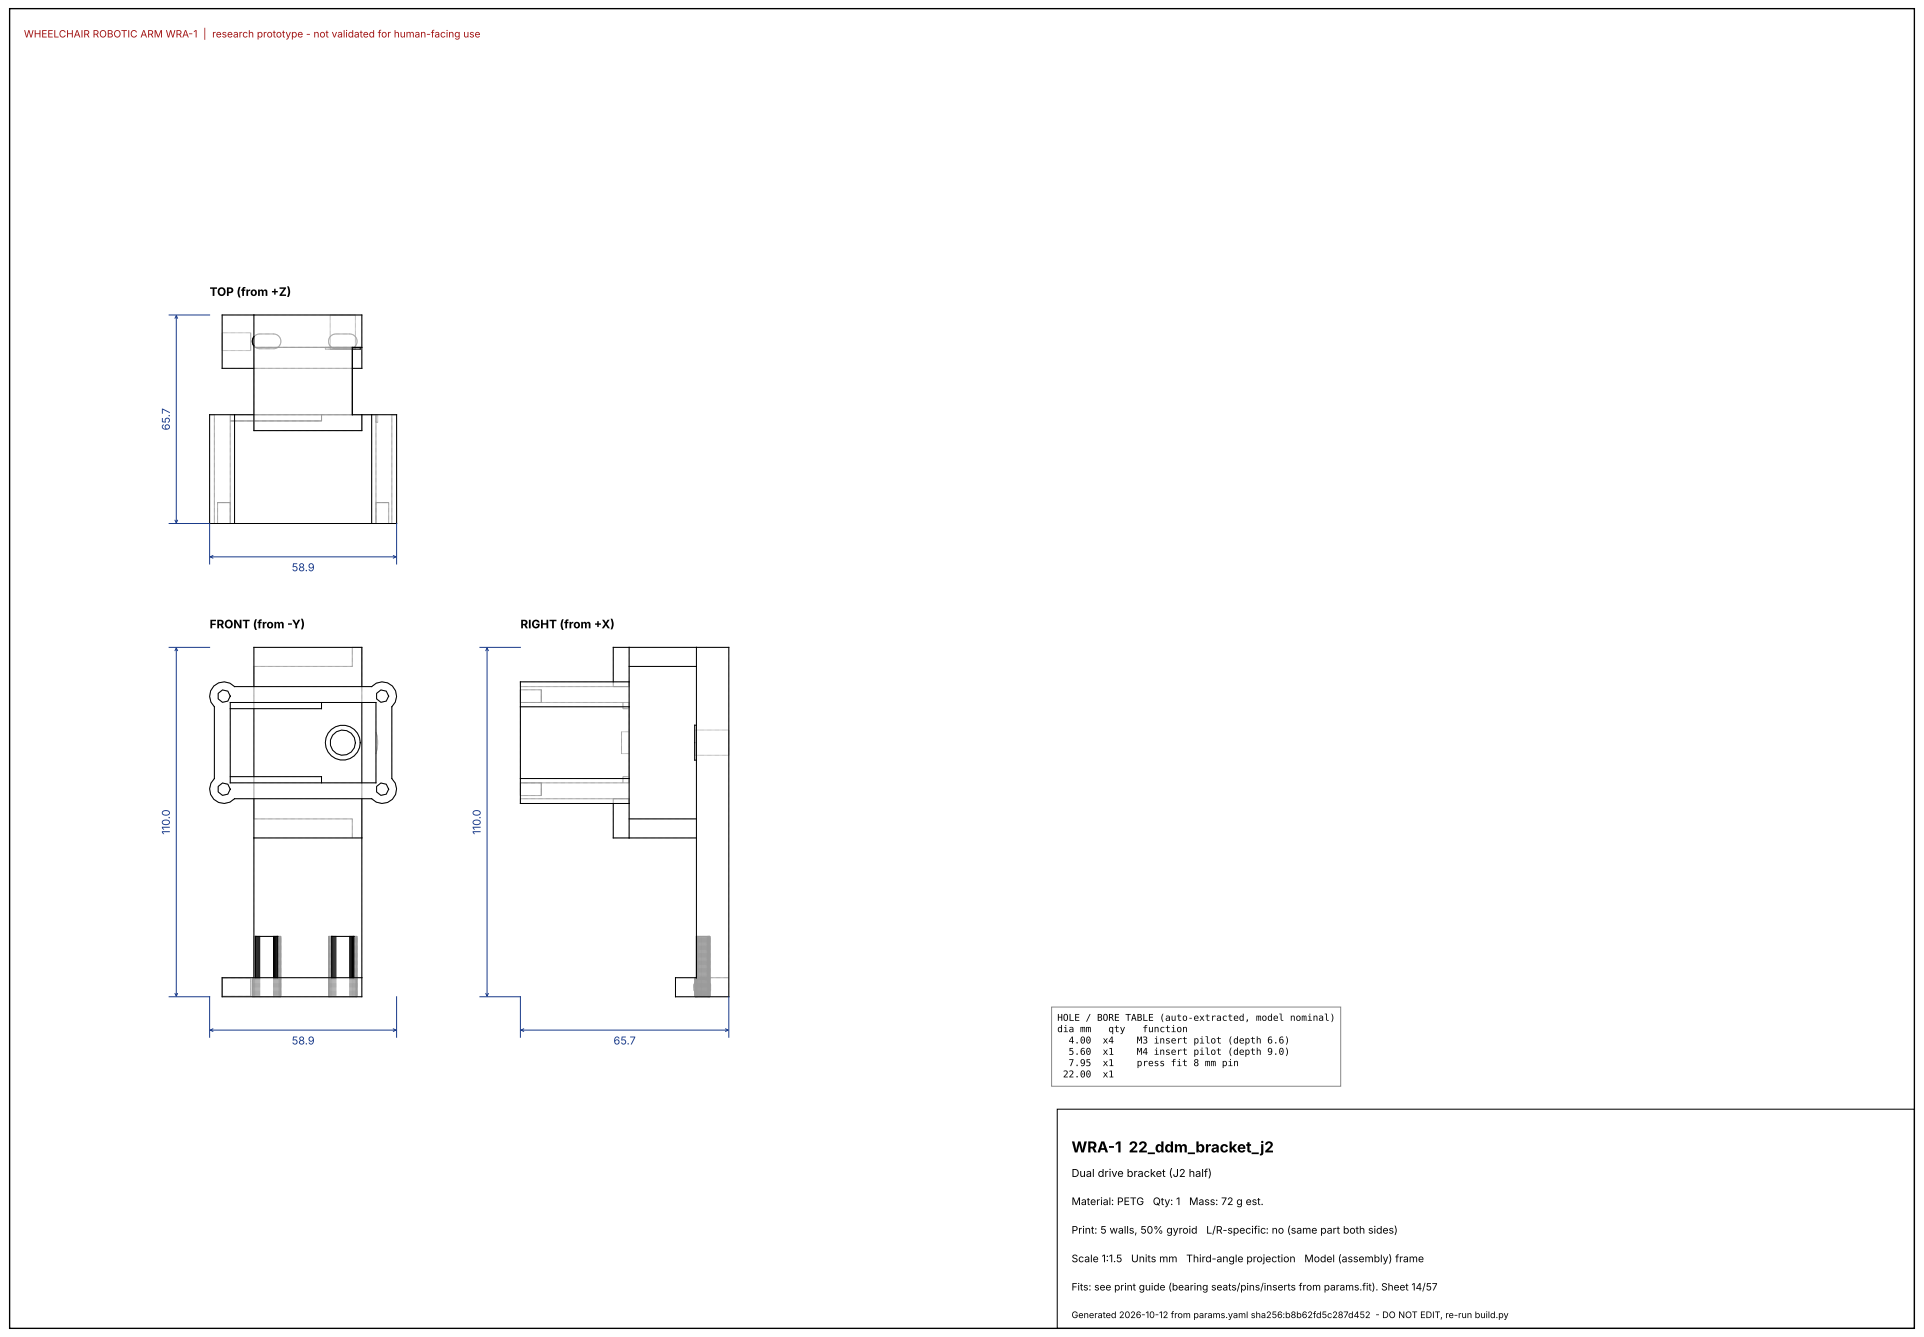
[picture p107: page 15]
FRONT (from -Y); TOP (from +Z); RIGHT (from +X); dia mm; qty; function; M3 insert pilot (depth 6.6); M4 insert pilot (depth 9.0); press fit 8 mm pin; WRA-1 22_ddm_bracket_j2

HOLE / BORE TABLE (auto-extracted, model nominal)

Dual drive bracket (J2 half)

Material: PETG Qty: 1 Mass: 72 g est.

Print: 5 walls, 50% gyroid L/R-specific: no (same part both sides)

Scale 1:1.5 Units mm Third-angle projection Model (assembly) frame

Fits: see print guide (bearing seats/pins/inserts from params.fit). Sheet 14/57

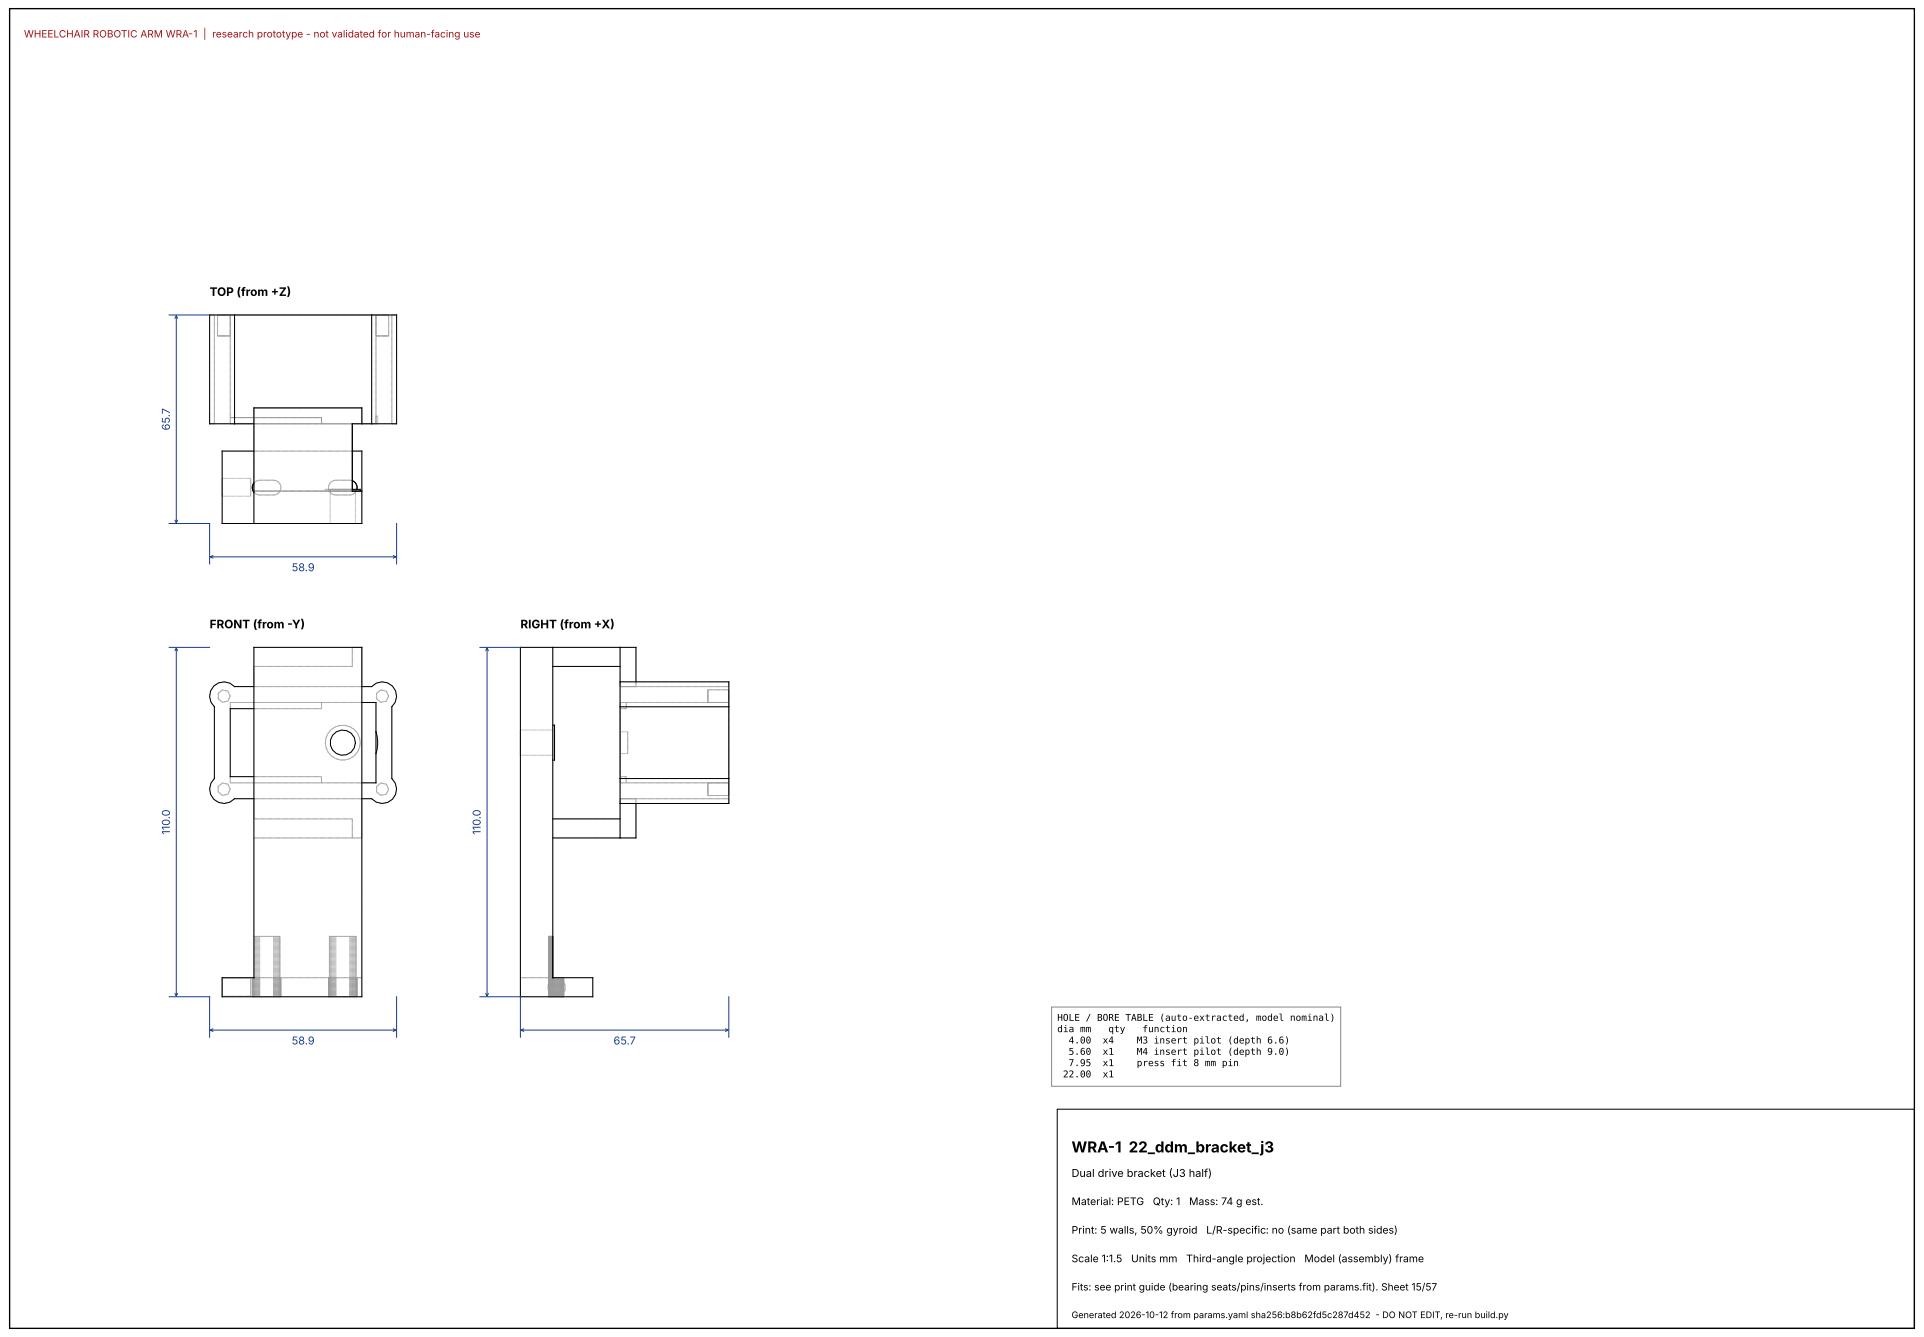
[picture p108: page 16]
FRONT (from -Y); TOP (from +Z); RIGHT (from +X); dia mm; qty; function; M3 insert pilot (depth 6.6); M4 insert pilot (depth 9.0); press fit 8 mm pin; WRA-1 22_ddm_bracket_j3

HOLE / BORE TABLE (auto-extracted, model nominal)

Dual drive bracket (J3 half)

Material: PETG Qty: 1 Mass: 74 g est.

Print: 5 walls, 50% gyroid L/R-specific: no (same part both sides)

Scale 1:1.5 Units mm Third-angle projection Model (assembly) frame

Fits: see print guide (bearing seats/pins/inserts from params.fit). Sheet 15/57

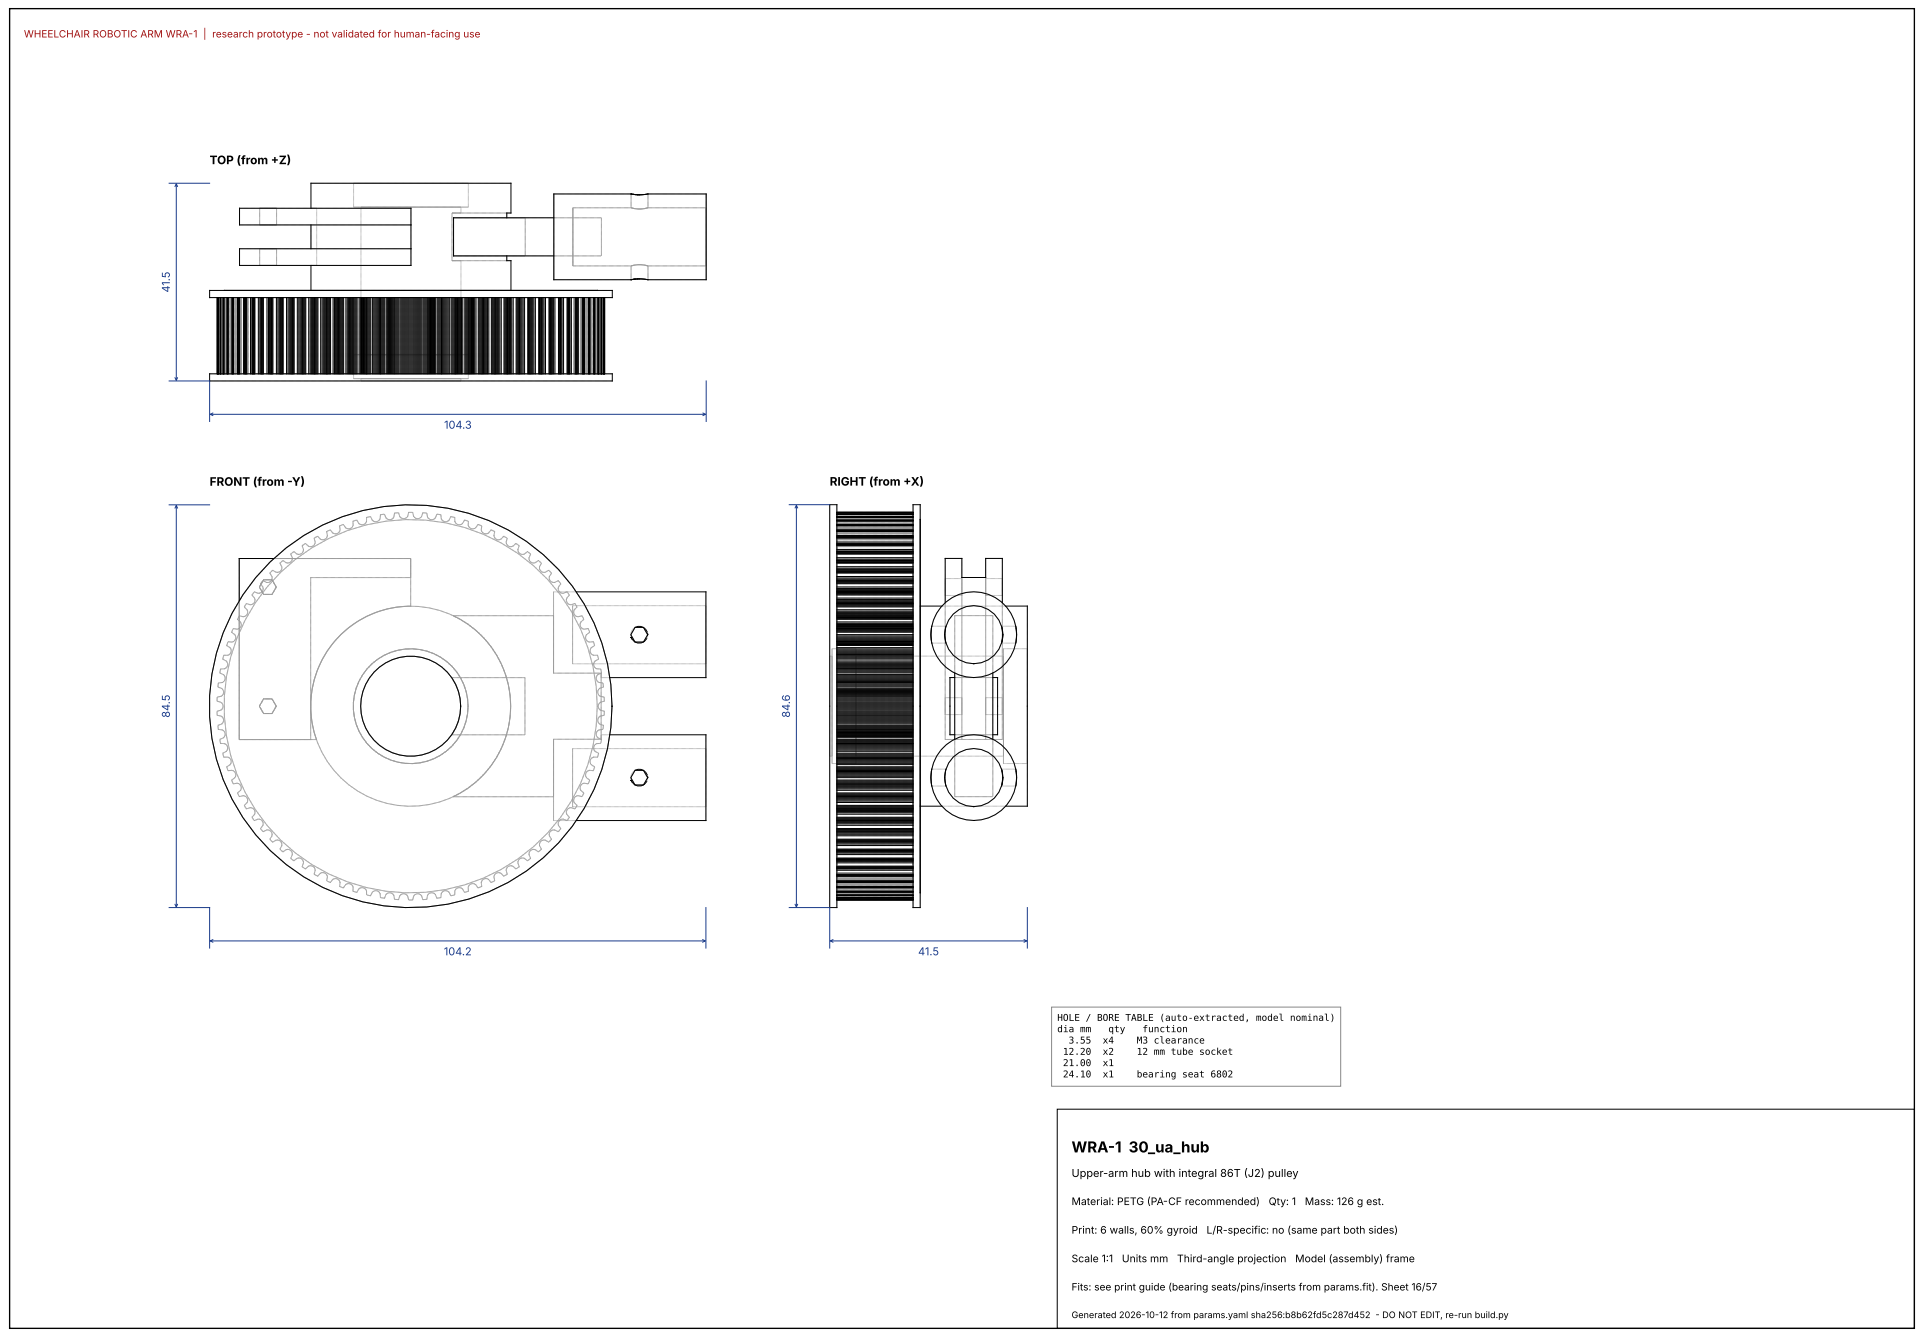
[picture p109: page 17]
FRONT (from -Y); TOP (from +Z); RIGHT (from +X); dia mm; qty; function; M3 clearance; 12 mm tube socket; bearing seat 6802; WRA-1 30_ua_hub

HOLE / BORE TABLE (auto-extracted, model nominal)

Upper-arm hub with integral 86T (J2) pulley

Material: PETG (PA-CF recommended) Qty: 1 Mass: 126 g est.

Print: 6 walls, 60% gyroid L/R-specific: no (same part both sides)

Fits: see print guide (bearing seats/pins/inserts from params.fit). Sheet 16/57

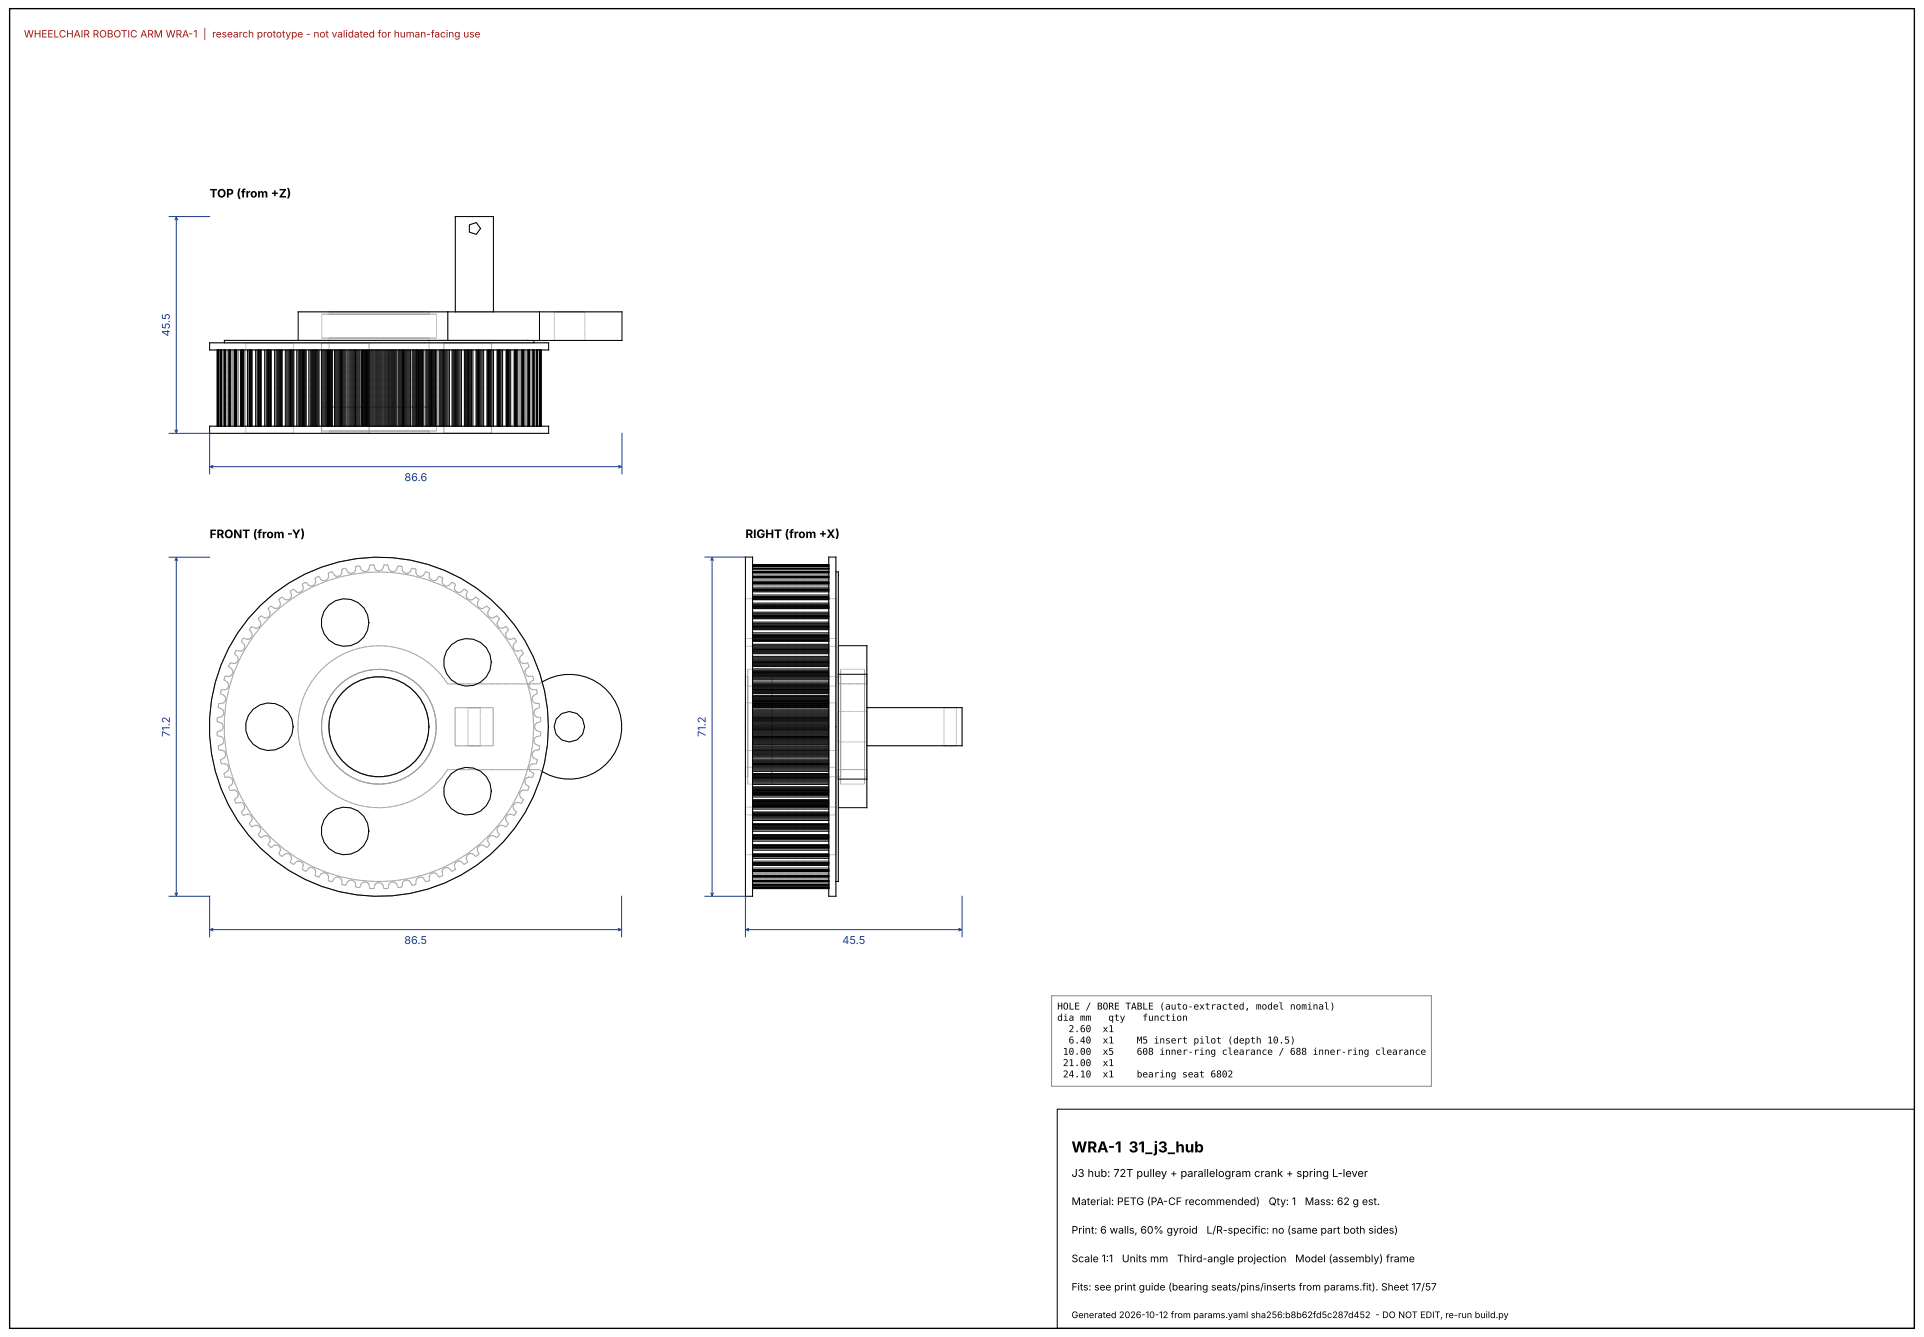
[picture p110: page 18]
FRONT (from -Y); TOP (from +Z); RIGHT (from +X); dia mm; qty; function; M5 insert pilot (depth 10.5); 608 inner-ring clearance / 688 inner-ring clearance; bearing seat 6802; WRA-1 31_j3_hub

HOLE / BORE TABLE (auto-extracted, model nominal)

J3 hub: 72T pulley + parallelogram crank + spring L-lever

Material: PETG (PA-CF recommended) Qty: 1 Mass: 62 g est.

Print: 6 walls, 60% gyroid L/R-specific: no (same part both sides)

Fits: see print guide (bearing seats/pins/inserts from params.fit). Sheet 17/57

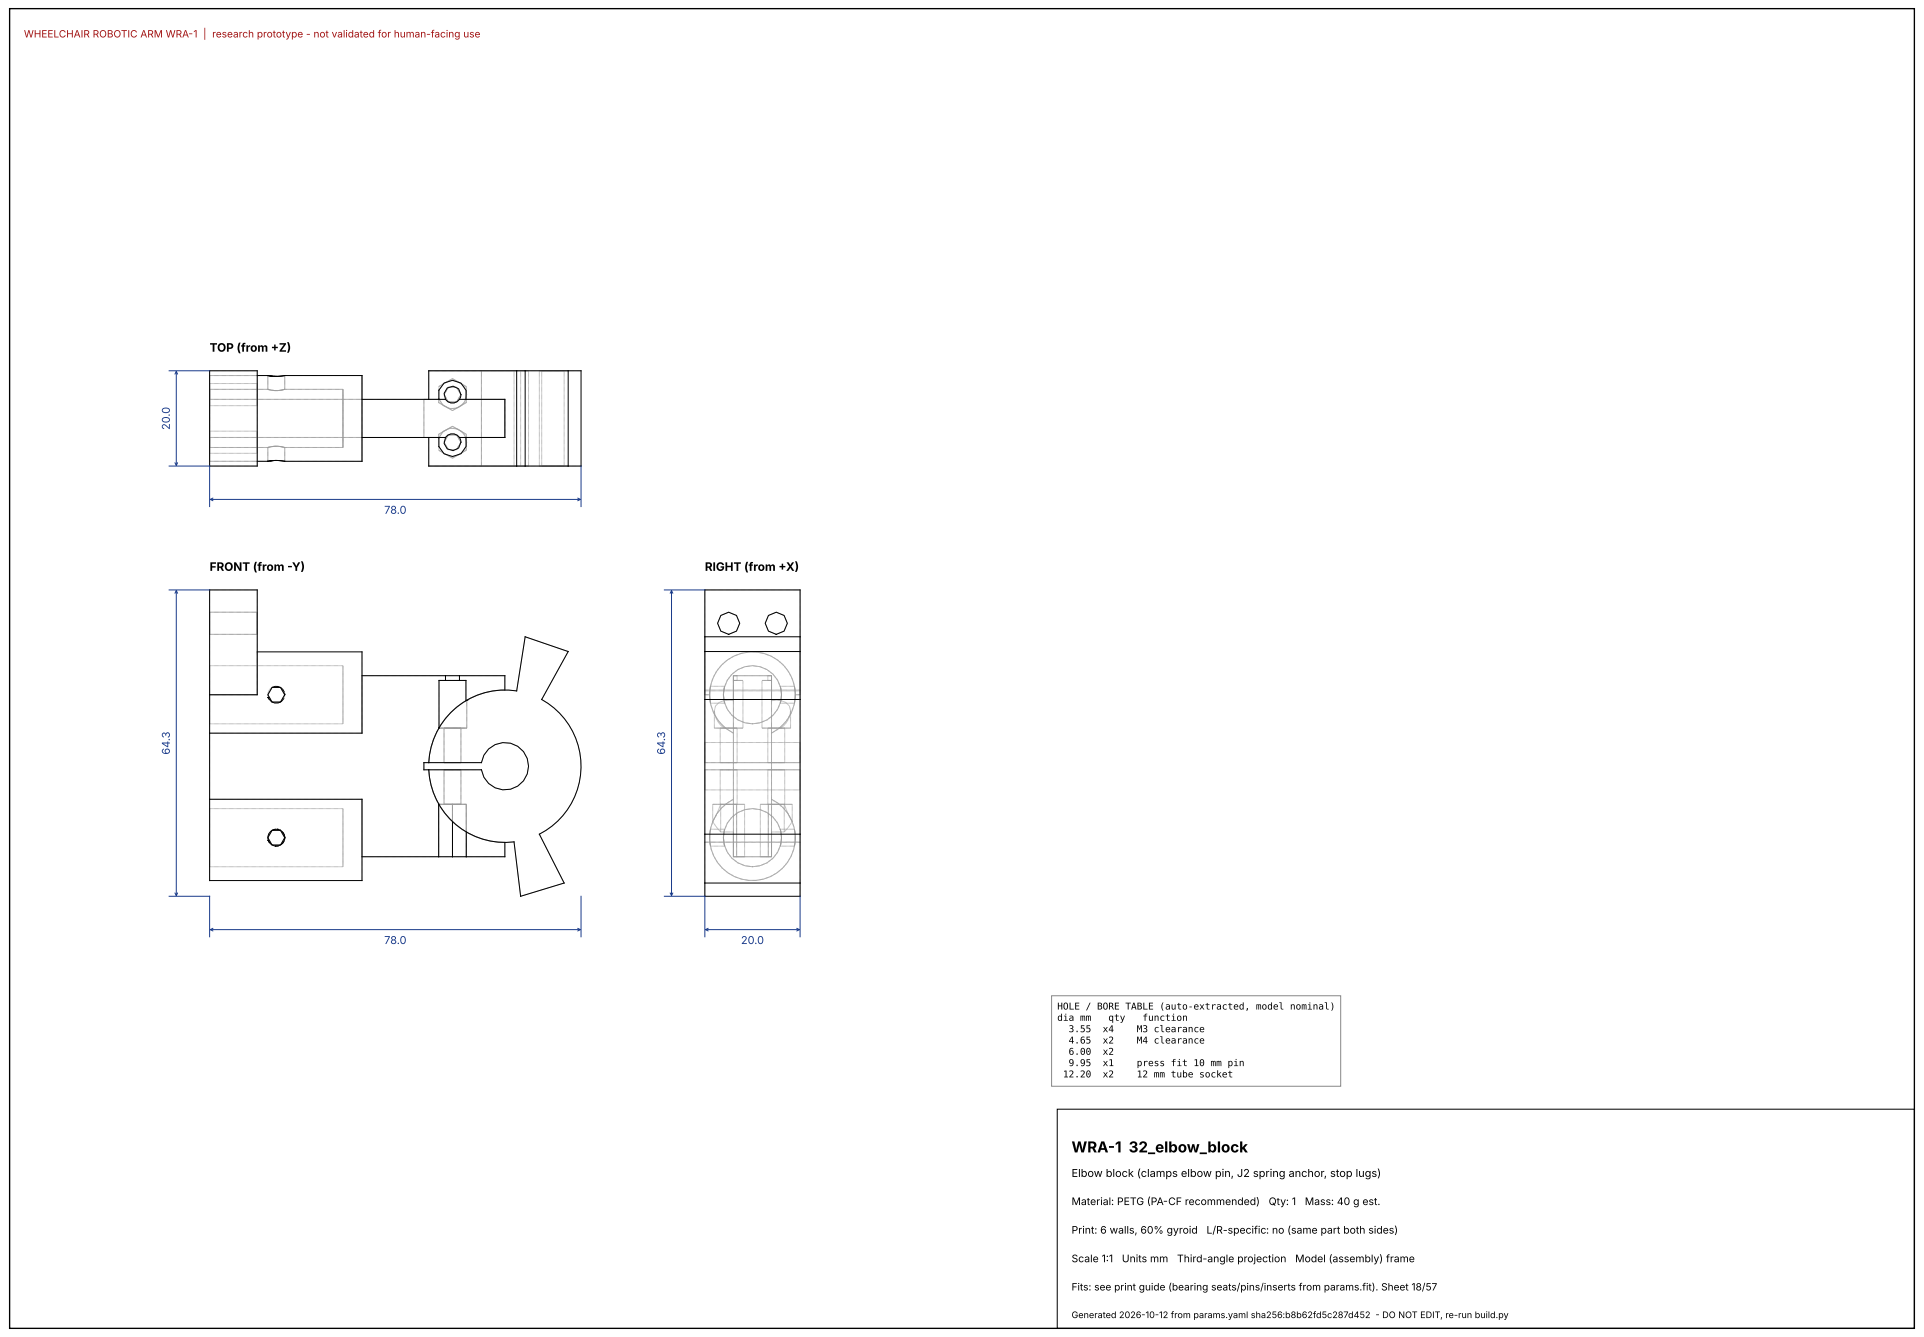
[picture p111: page 19]
FRONT (from -Y); TOP (from +Z); RIGHT (from +X); dia mm; qty; function; M3 clearance; M4 clearance; press fit 10 mm pin; 12 mm tube socket; WRA-1 32_elbow_block

HOLE / BORE TABLE (auto-extracted, model nominal)

Elbow block (clamps elbow pin, J2 spring anchor, stop lugs)

Material: PETG (PA-CF recommended) Qty: 1 Mass: 40 g est.

Print: 6 walls, 60% gyroid L/R-specific: no (same part both sides)

Fits: see print guide (bearing seats/pins/inserts from params.fit). Sheet 18/57

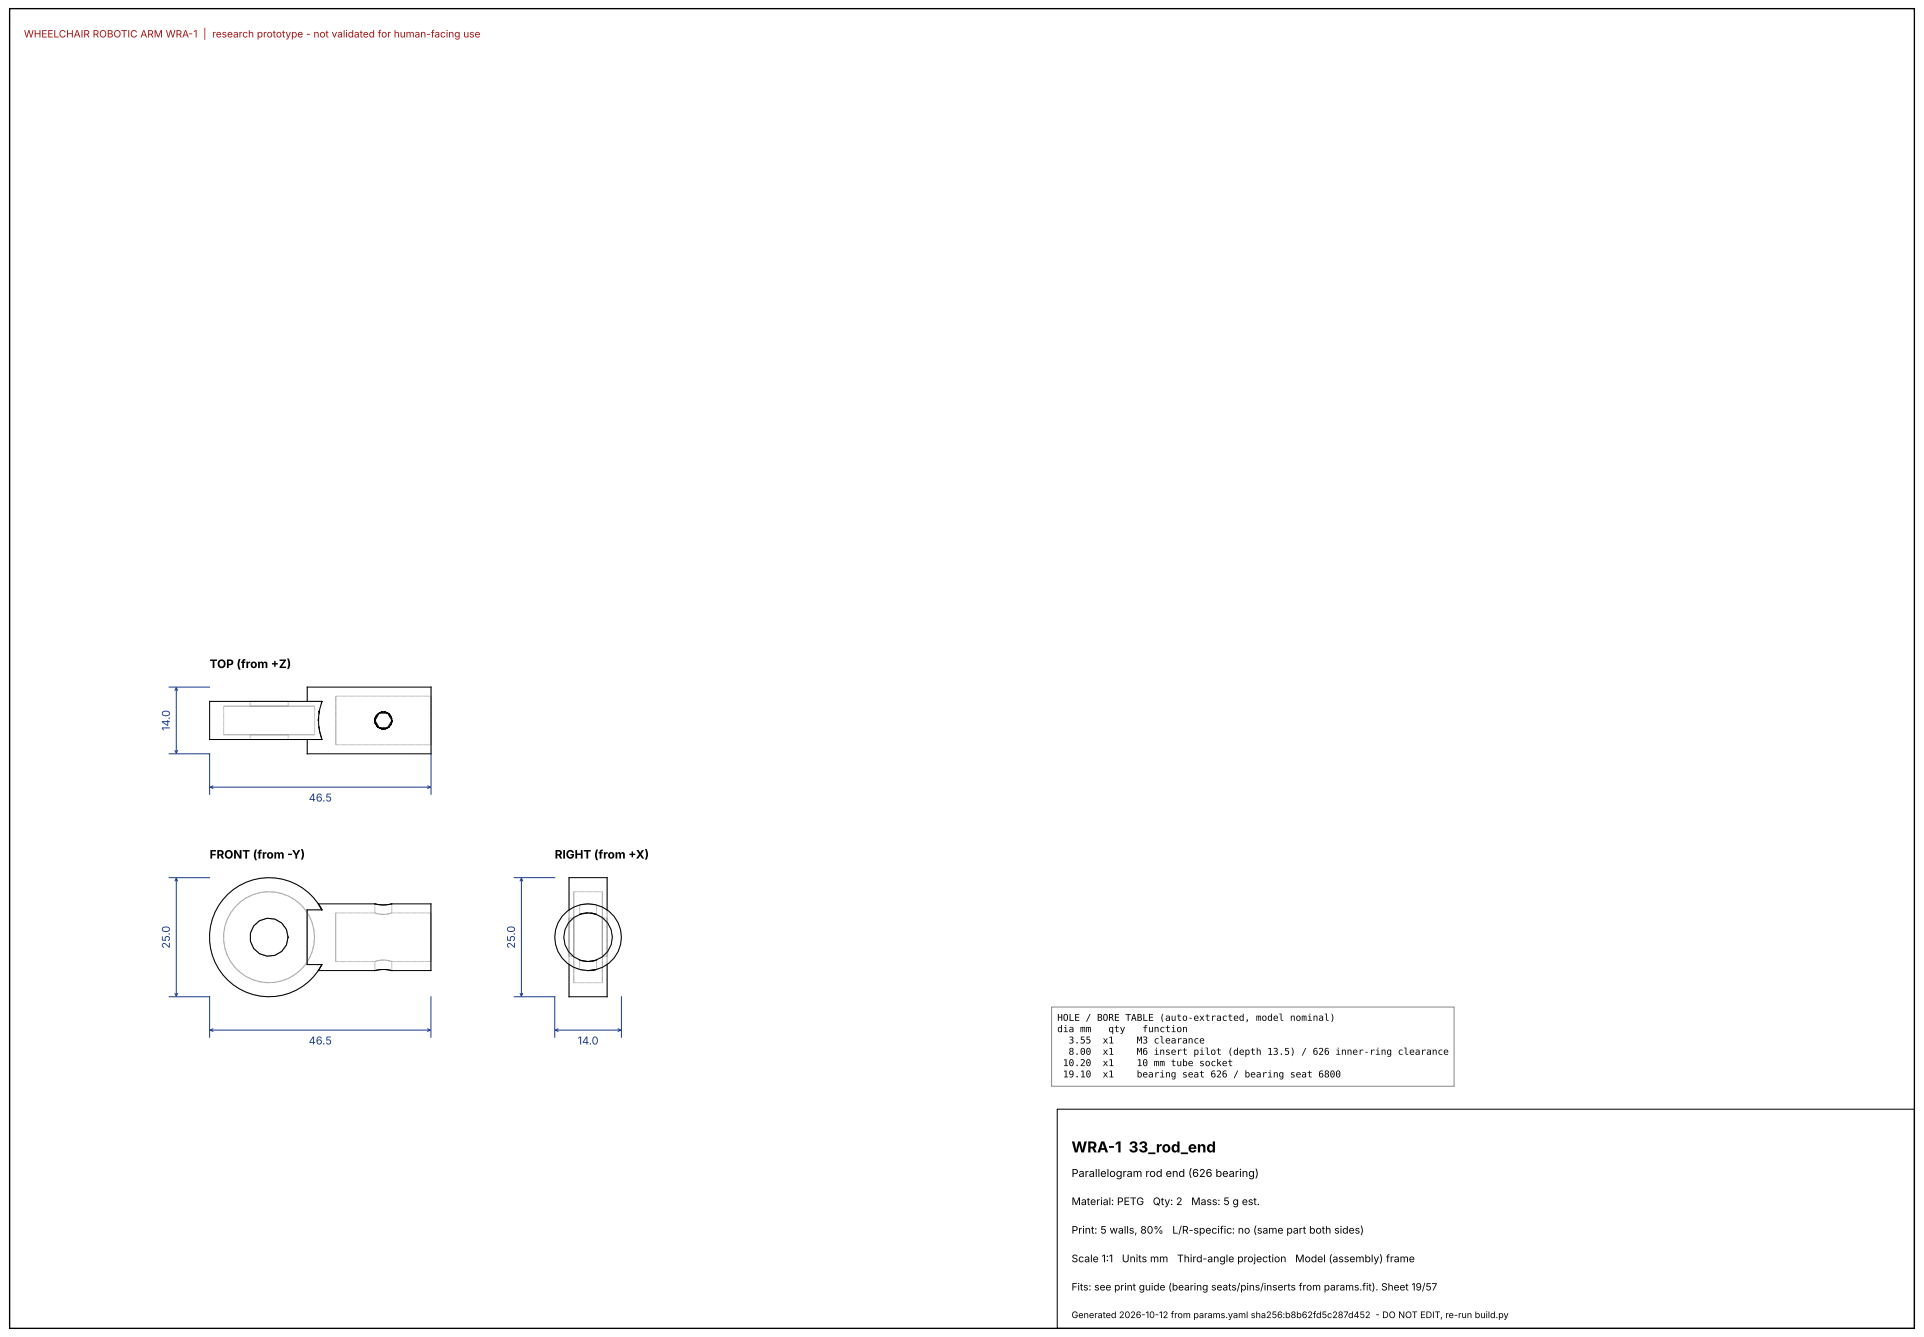
[picture p112: page 20]
FRONT (from -Y); TOP (from +Z); RIGHT (from +X); dia mm; qty; function; M3 clearance; M6 insert pilot (depth 13.5) / 626 inner-ring clearance; 10 mm tube socket; bearing seat 626 / bearing seat 6800; WRA-1 33_rod_end

HOLE / BORE TABLE (auto-extracted, model nominal)

Parallelogram rod end (626 bearing)

Material: PETG Qty: 2 Mass: 5 g est.

Print: 5 walls, 80% L/R-specific: no (same part both sides)

Fits: see print guide (bearing seats/pins/inserts from params.fit). Sheet 19/57

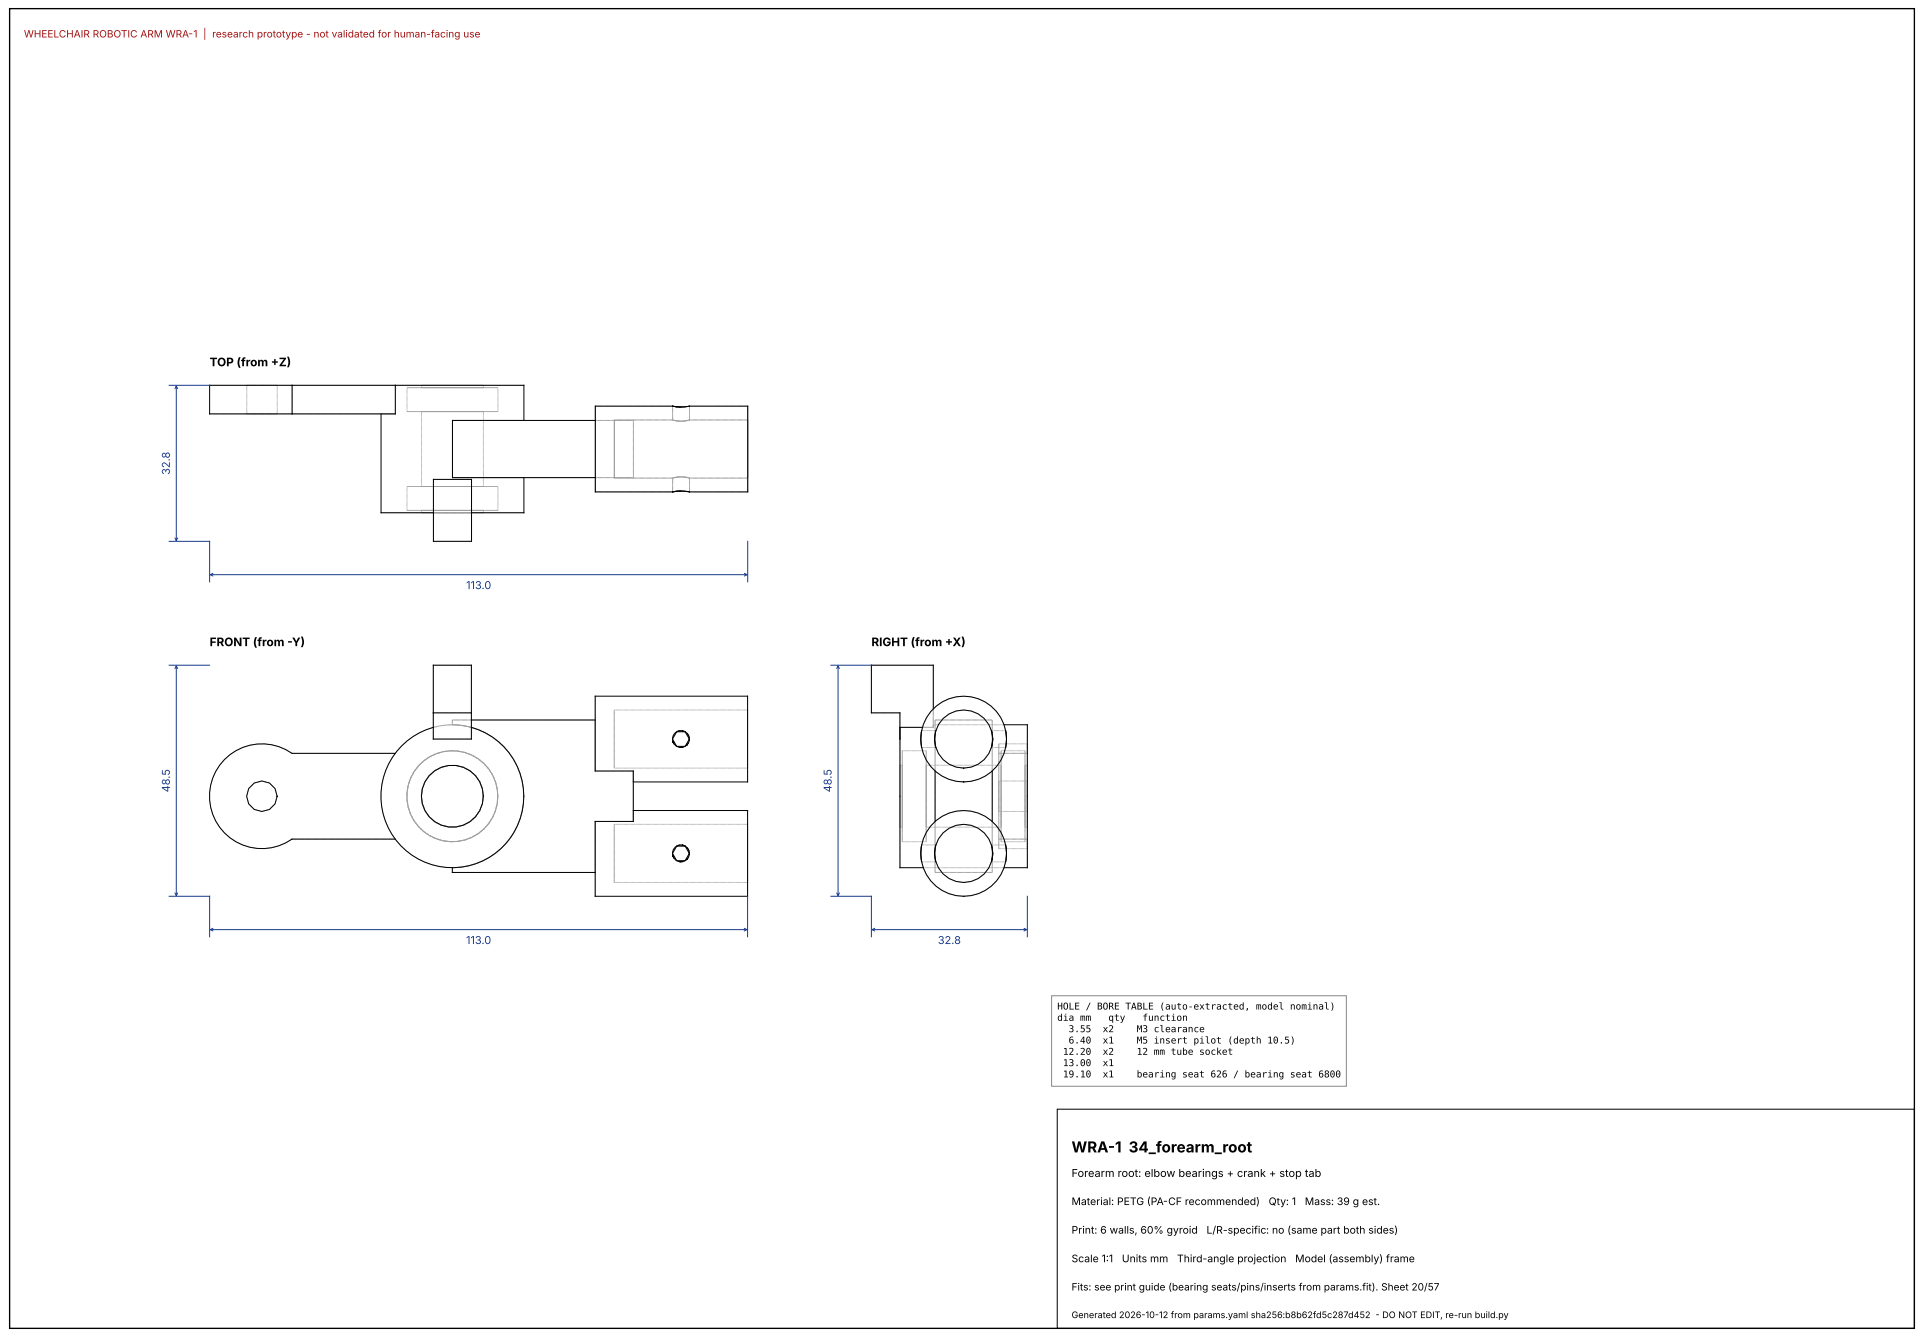
[picture p113: page 21]
FRONT (from -Y); TOP (from +Z); RIGHT (from +X); dia mm; qty; function; M3 clearance; M5 insert pilot (depth 10.5); 12 mm tube socket; bearing seat 626 / bearing seat 6800; WRA-1 34_forearm_root

HOLE / BORE TABLE (auto-extracted, model nominal)

Forearm root: elbow bearings + crank + stop tab

Material: PETG (PA-CF recommended) Qty: 1 Mass: 39 g est.

Print: 6 walls, 60% gyroid L/R-specific: no (same part both sides)

Fits: see print guide (bearing seats/pins/inserts from params.fit). Sheet 20/57

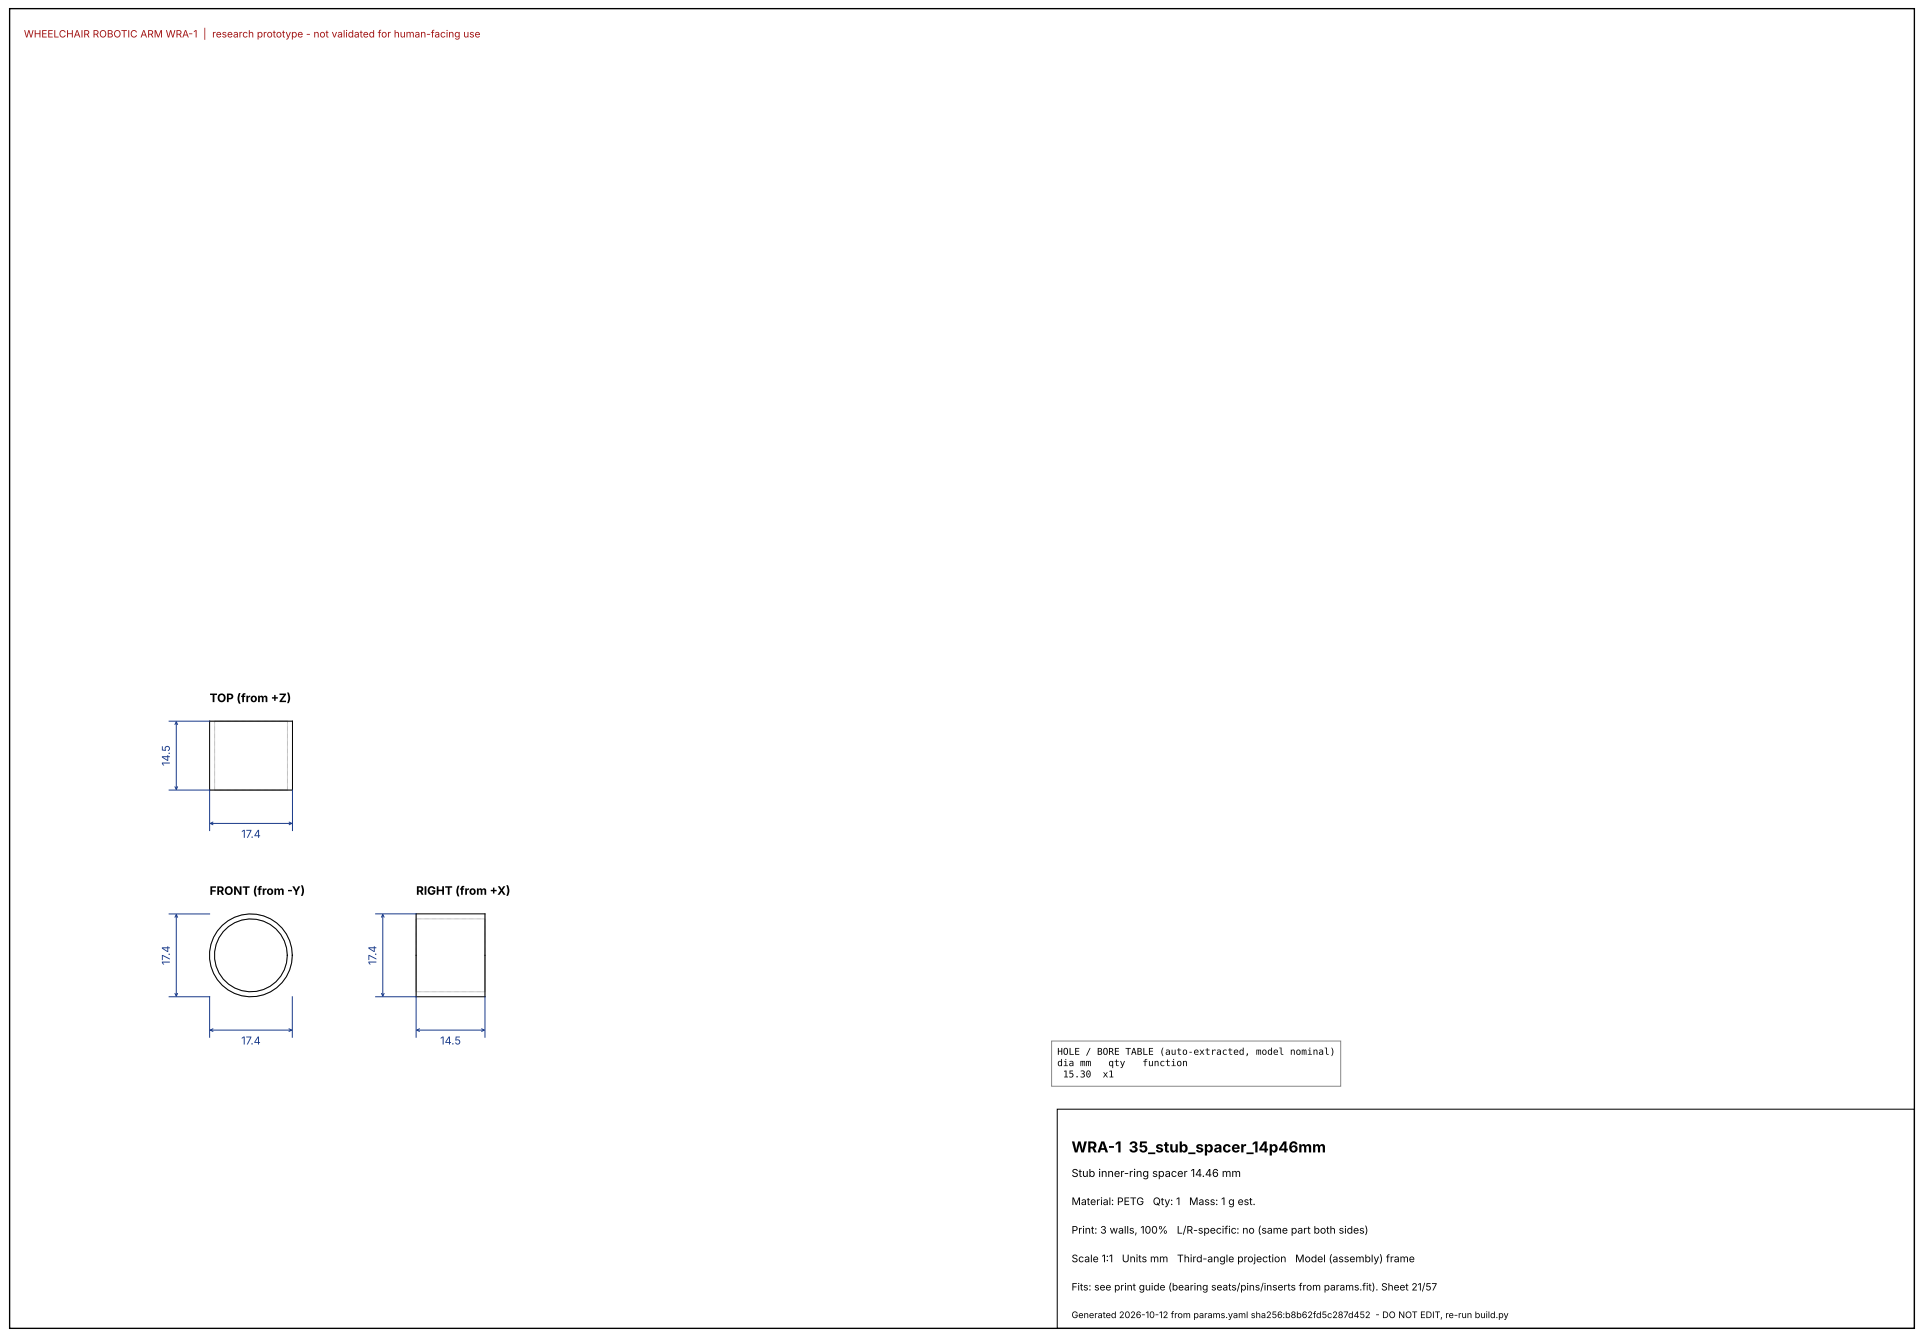
[picture p114: page 22]
FRONT (from -Y); TOP (from +Z); RIGHT (from +X); dia mm; qty; function; WRA-1 35_stub_spacer_14p46mm

HOLE / BORE TABLE (auto-extracted, model nominal)

Stub inner-ring spacer 14.46 mm

Material: PETG Qty: 1 Mass: 1 g est.

Print: 3 walls, 100% L/R-specific: no (same part both sides)

Fits: see print guide (bearing seats/pins/inserts from params.fit). Sheet 21/57

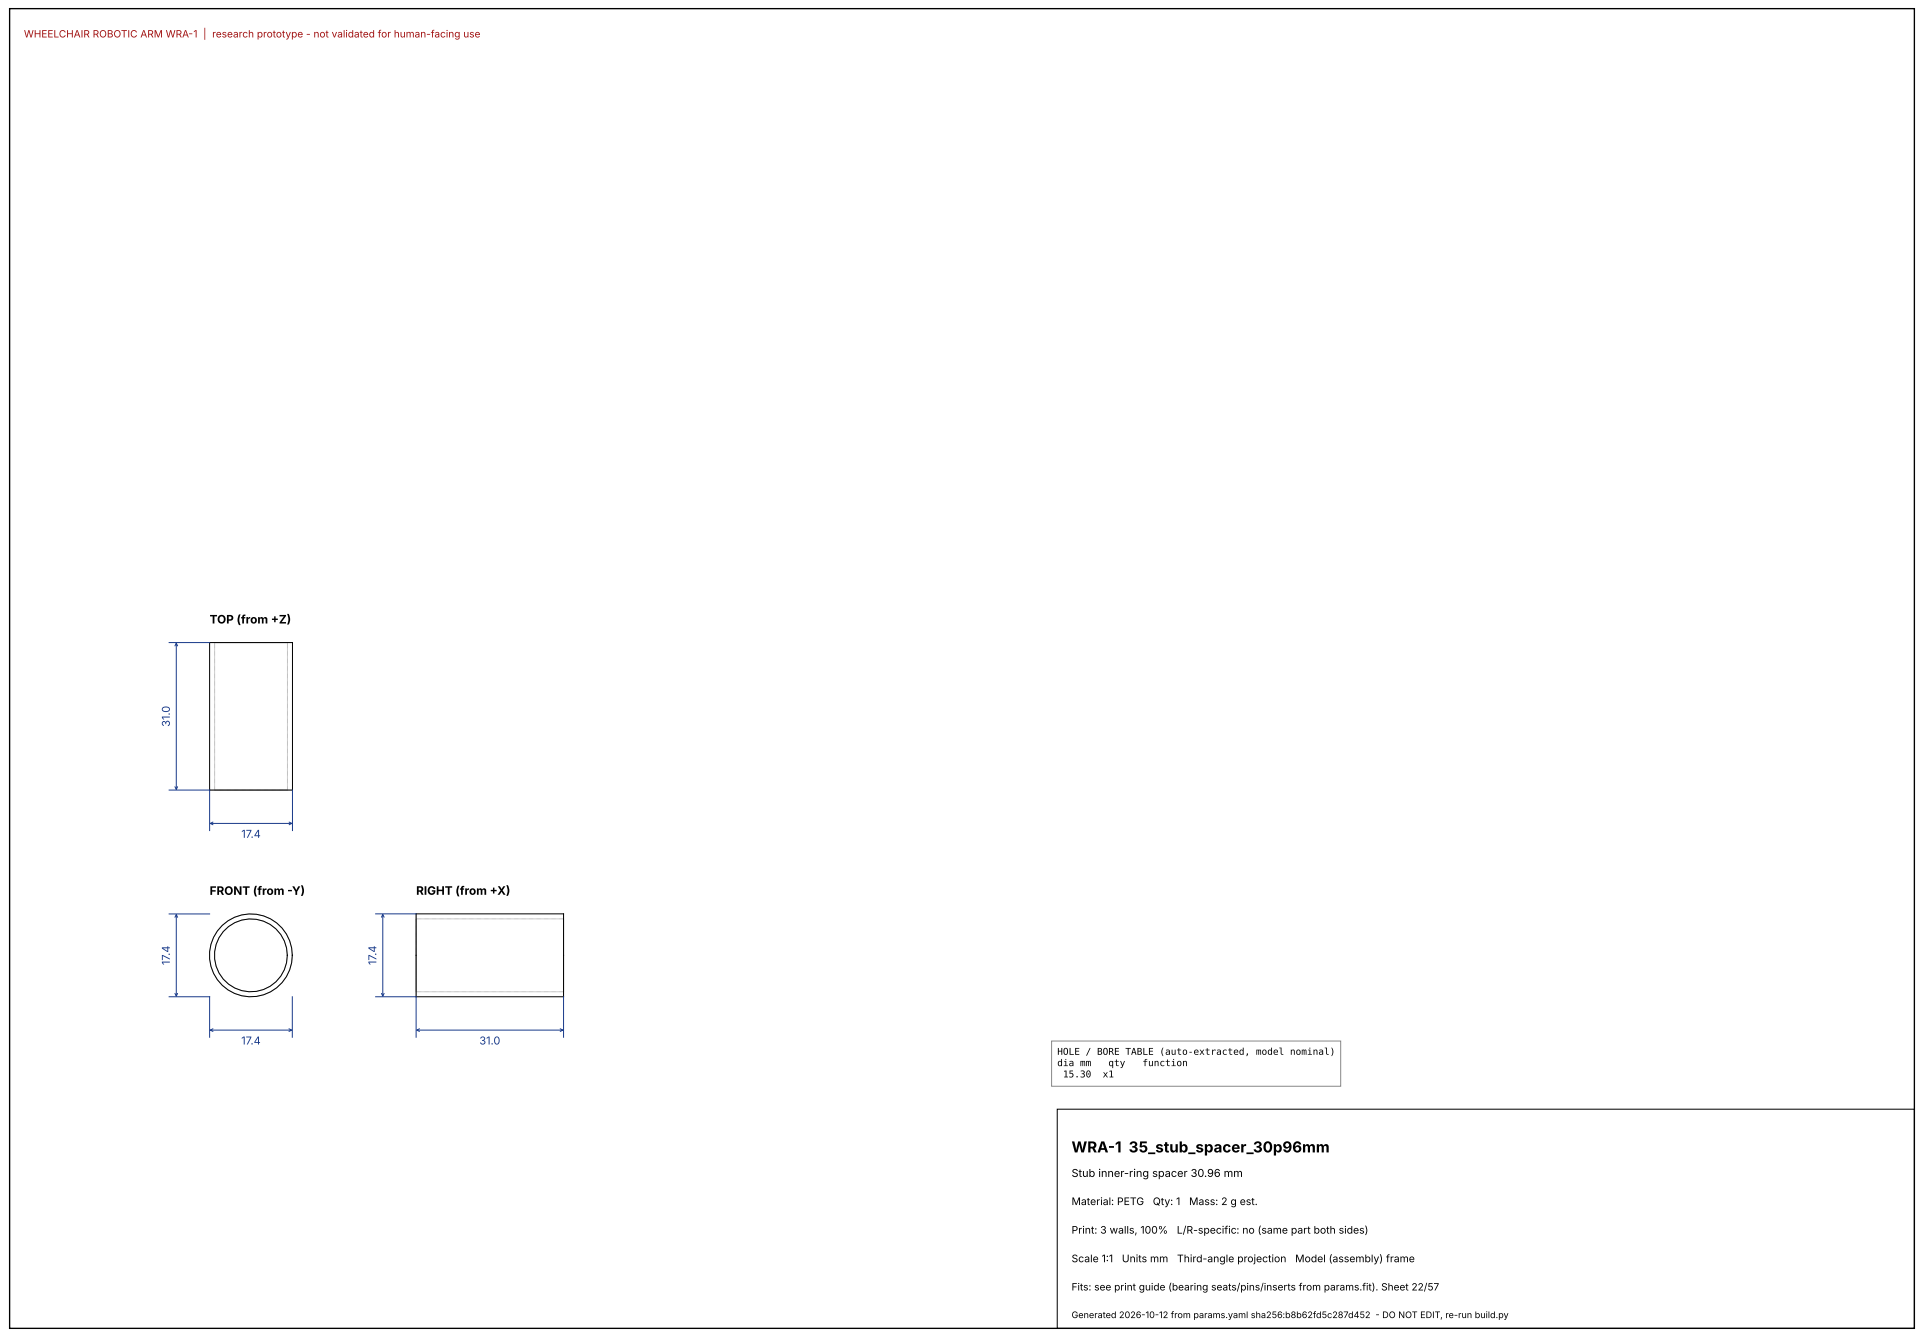
[picture p115: page 23]
FRONT (from -Y); TOP (from +Z); RIGHT (from +X); dia mm; qty; function; WRA-1 35_stub_spacer_30p96mm

HOLE / BORE TABLE (auto-extracted, model nominal)

Stub inner-ring spacer 30.96 mm

Material: PETG Qty: 1 Mass: 2 g est.

Print: 3 walls, 100% L/R-specific: no (same part both sides)

Fits: see print guide (bearing seats/pins/inserts from params.fit). Sheet 22/57

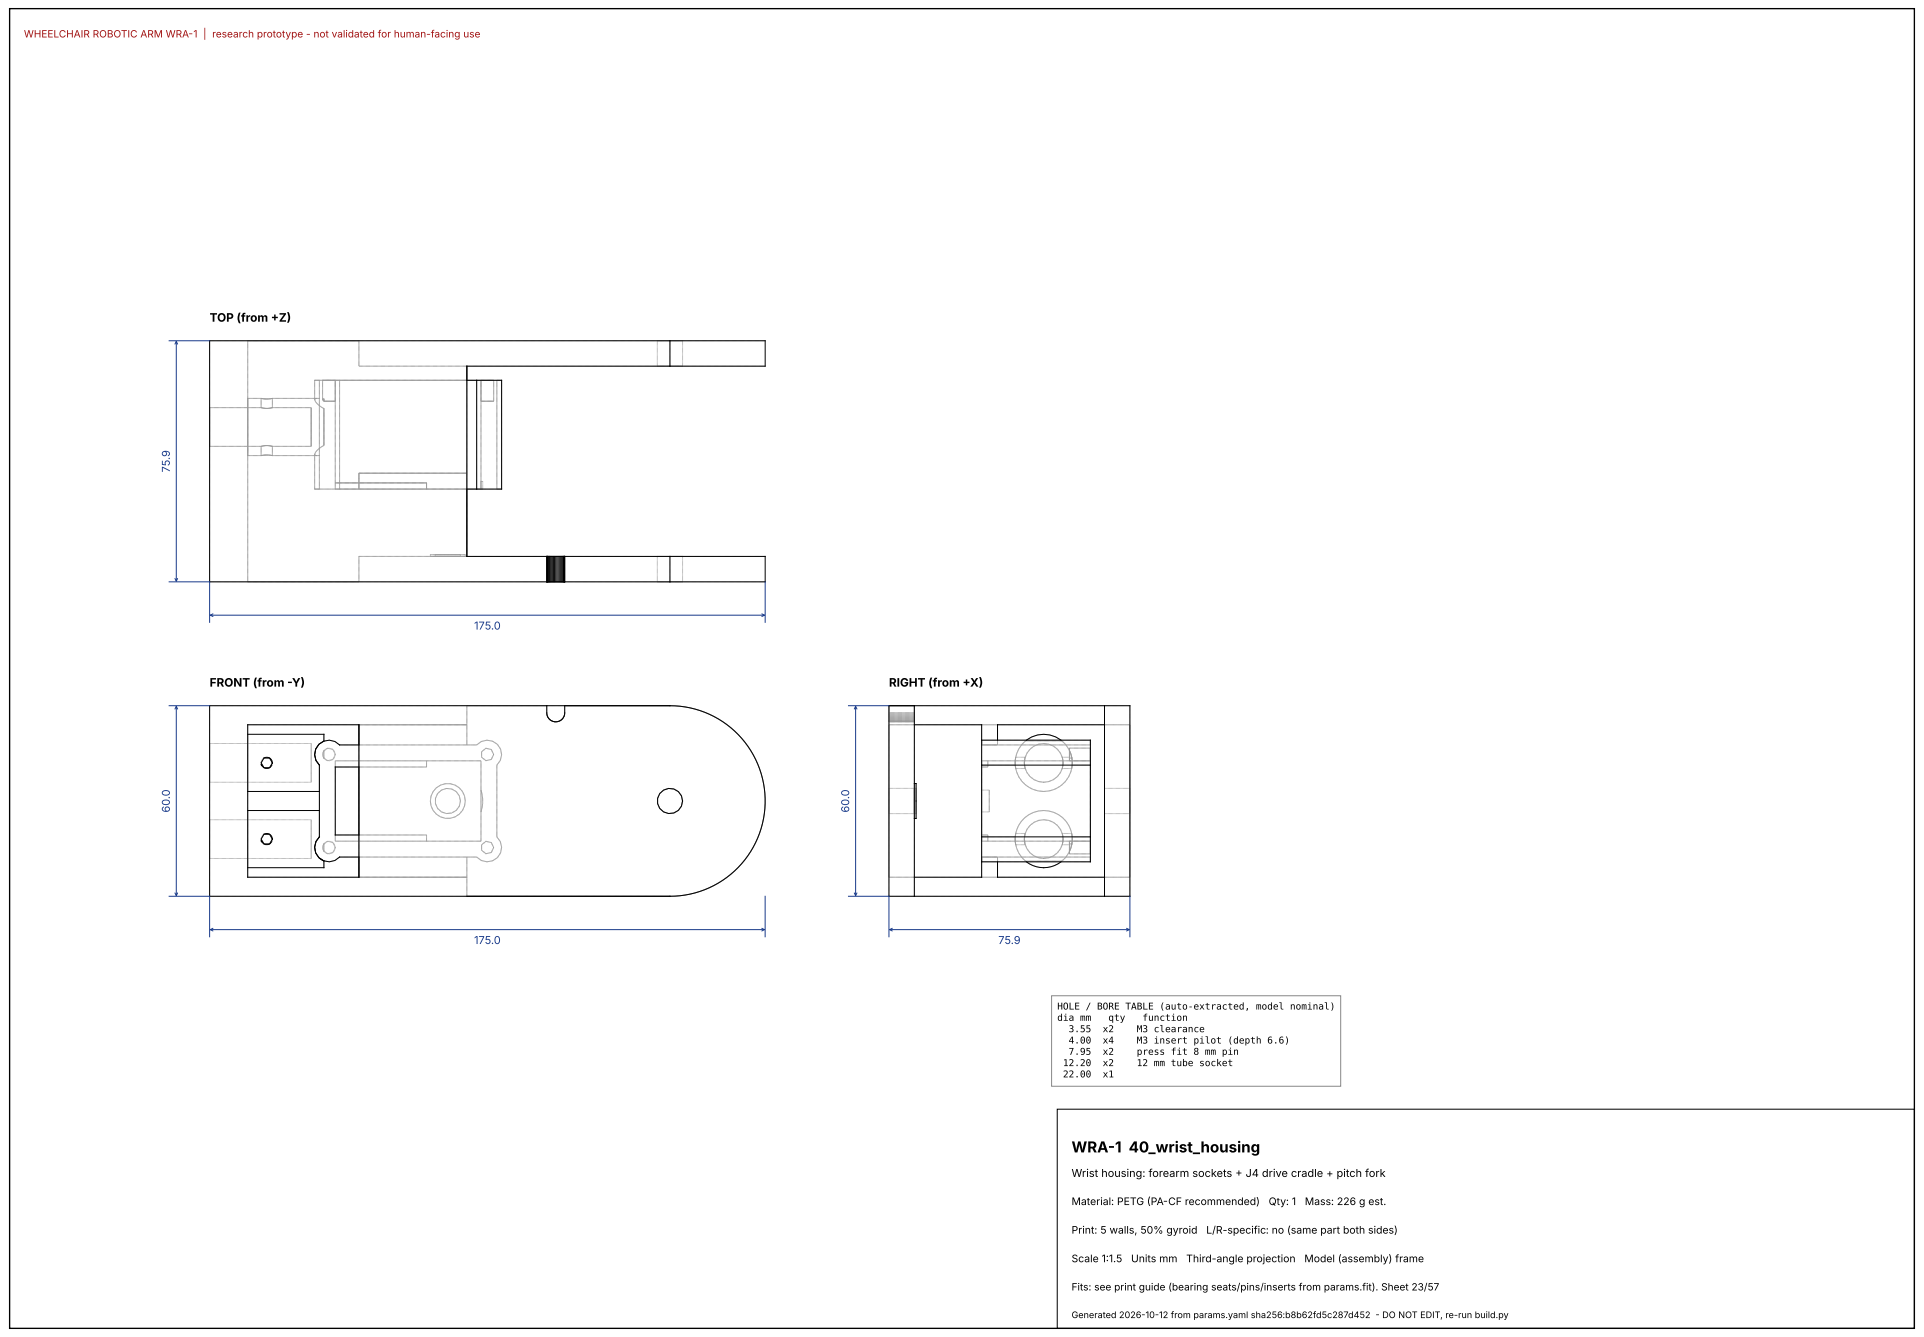
[picture p116: page 24]
FRONT (from -Y); TOP (from +Z); RIGHT (from +X); dia mm; qty; function; M3 clearance; M3 insert pilot (depth 6.6); press fit 8 mm pin; 12 mm tube socket; WRA-1 40_wrist_housing

HOLE / BORE TABLE (auto-extracted, model nominal)

Wrist housing: forearm sockets + J4 drive cradle + pitch fork

Material: PETG (PA-CF recommended) Qty: 1 Mass: 226 g est.

Print: 5 walls, 50% gyroid L/R-specific: no (same part both sides)

Scale 1:1.5 Units mm Third-angle projection Model (assembly) frame

Fits: see print guide (bearing seats/pins/inserts from params.fit). Sheet 23/57

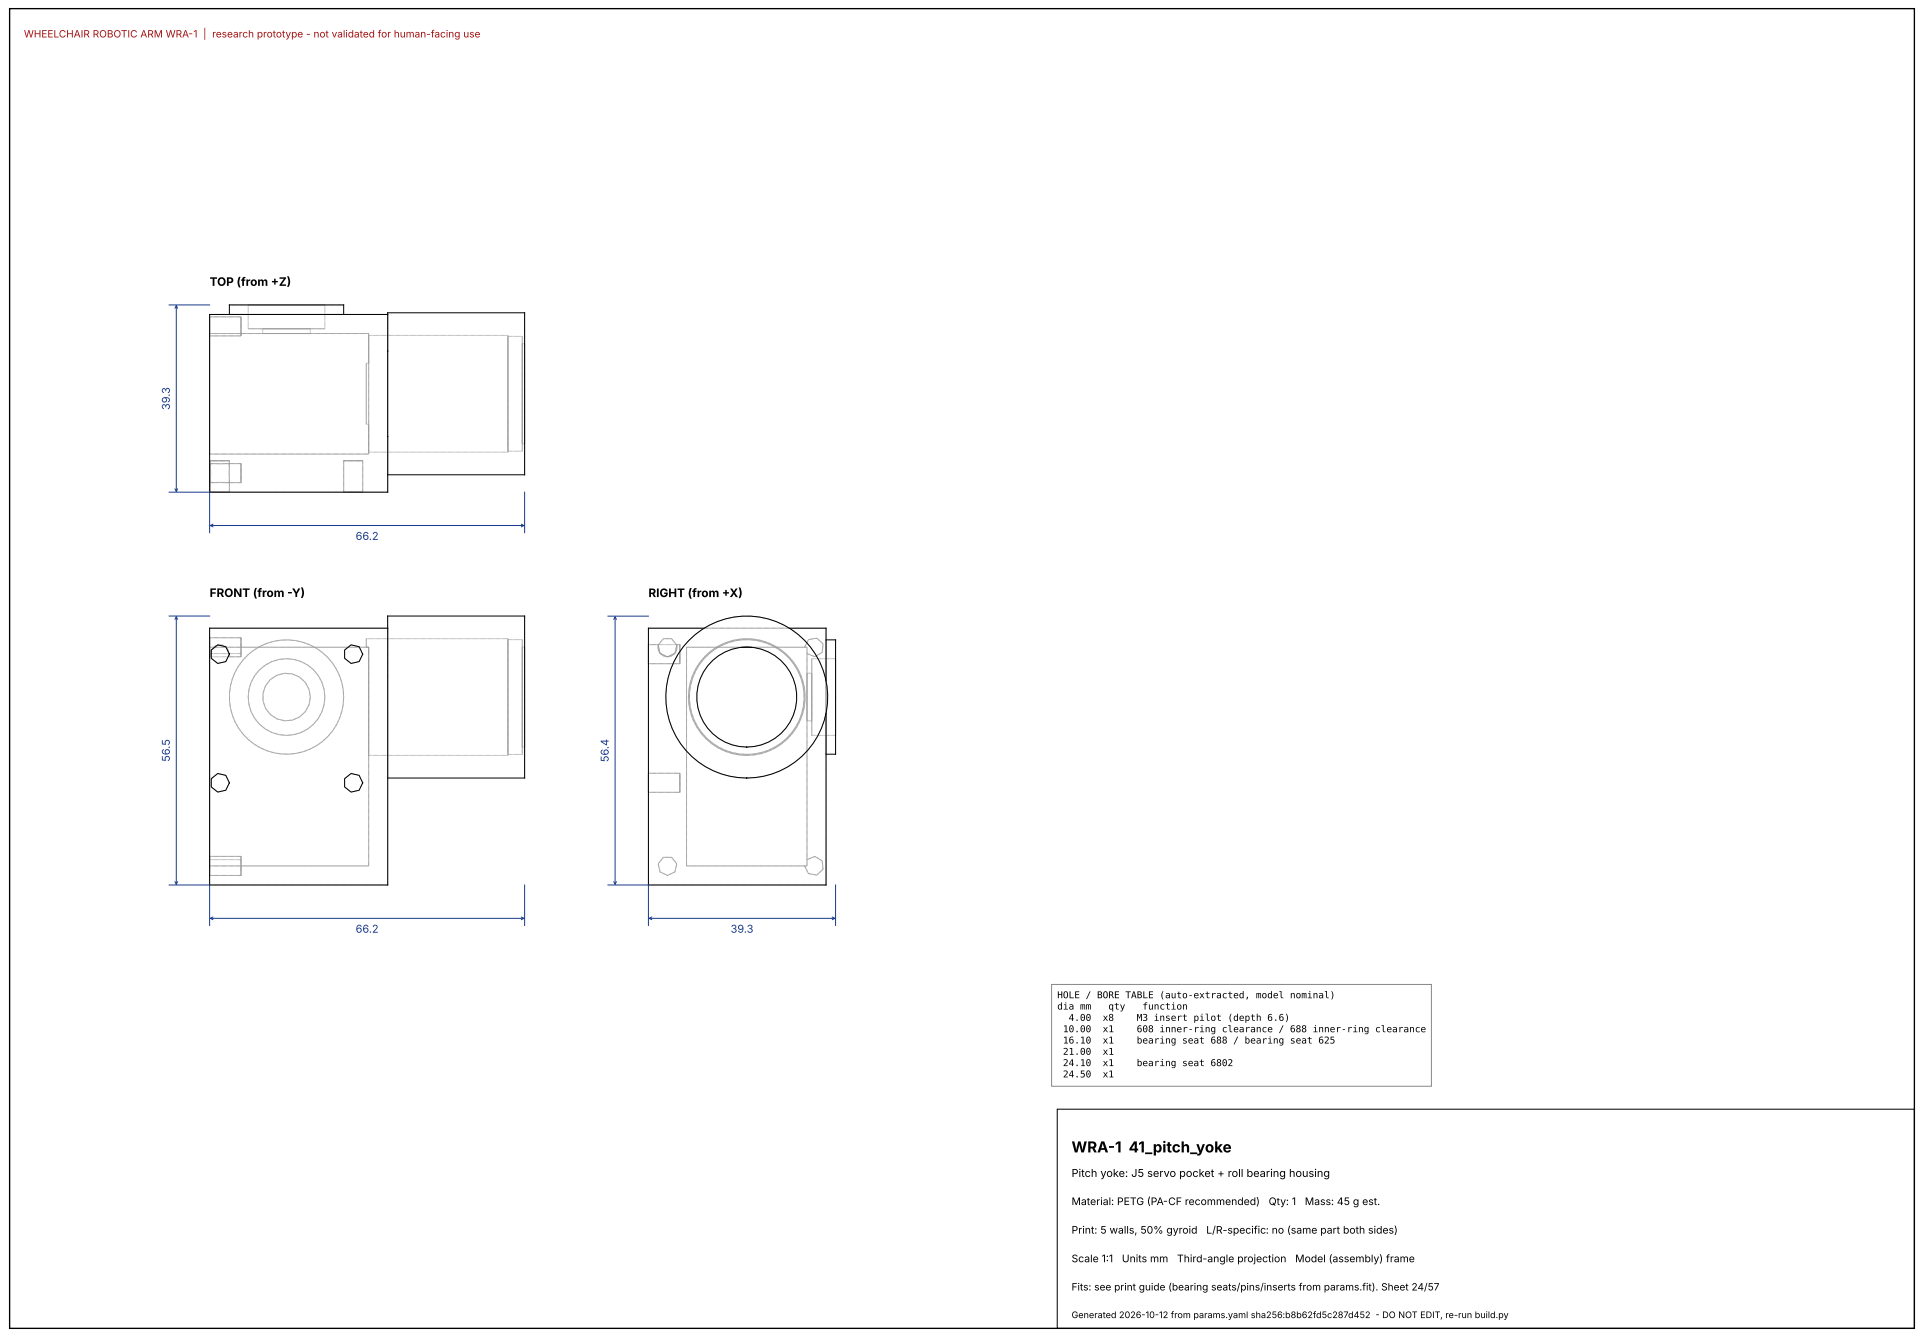
[picture p117: page 25]
FRONT (from -Y); TOP (from +Z); RIGHT (from +X); dia mm; qty; function; M3 insert pilot (depth 6.6); 608 inner-ring clearance / 688 inner-ring clearance; bearing seat 688 / bearing seat 625; bearing seat 6802; WRA-1 41_pitch_yoke

HOLE / BORE TABLE (auto-extracted, model nominal)

Pitch yoke: J5 servo pocket + roll bearing housing

Material: PETG (PA-CF recommended) Qty: 1 Mass: 45 g est.

Print: 5 walls, 50% gyroid L/R-specific: no (same part both sides)

Fits: see print guide (bearing seats/pins/inserts from params.fit). Sheet 24/57

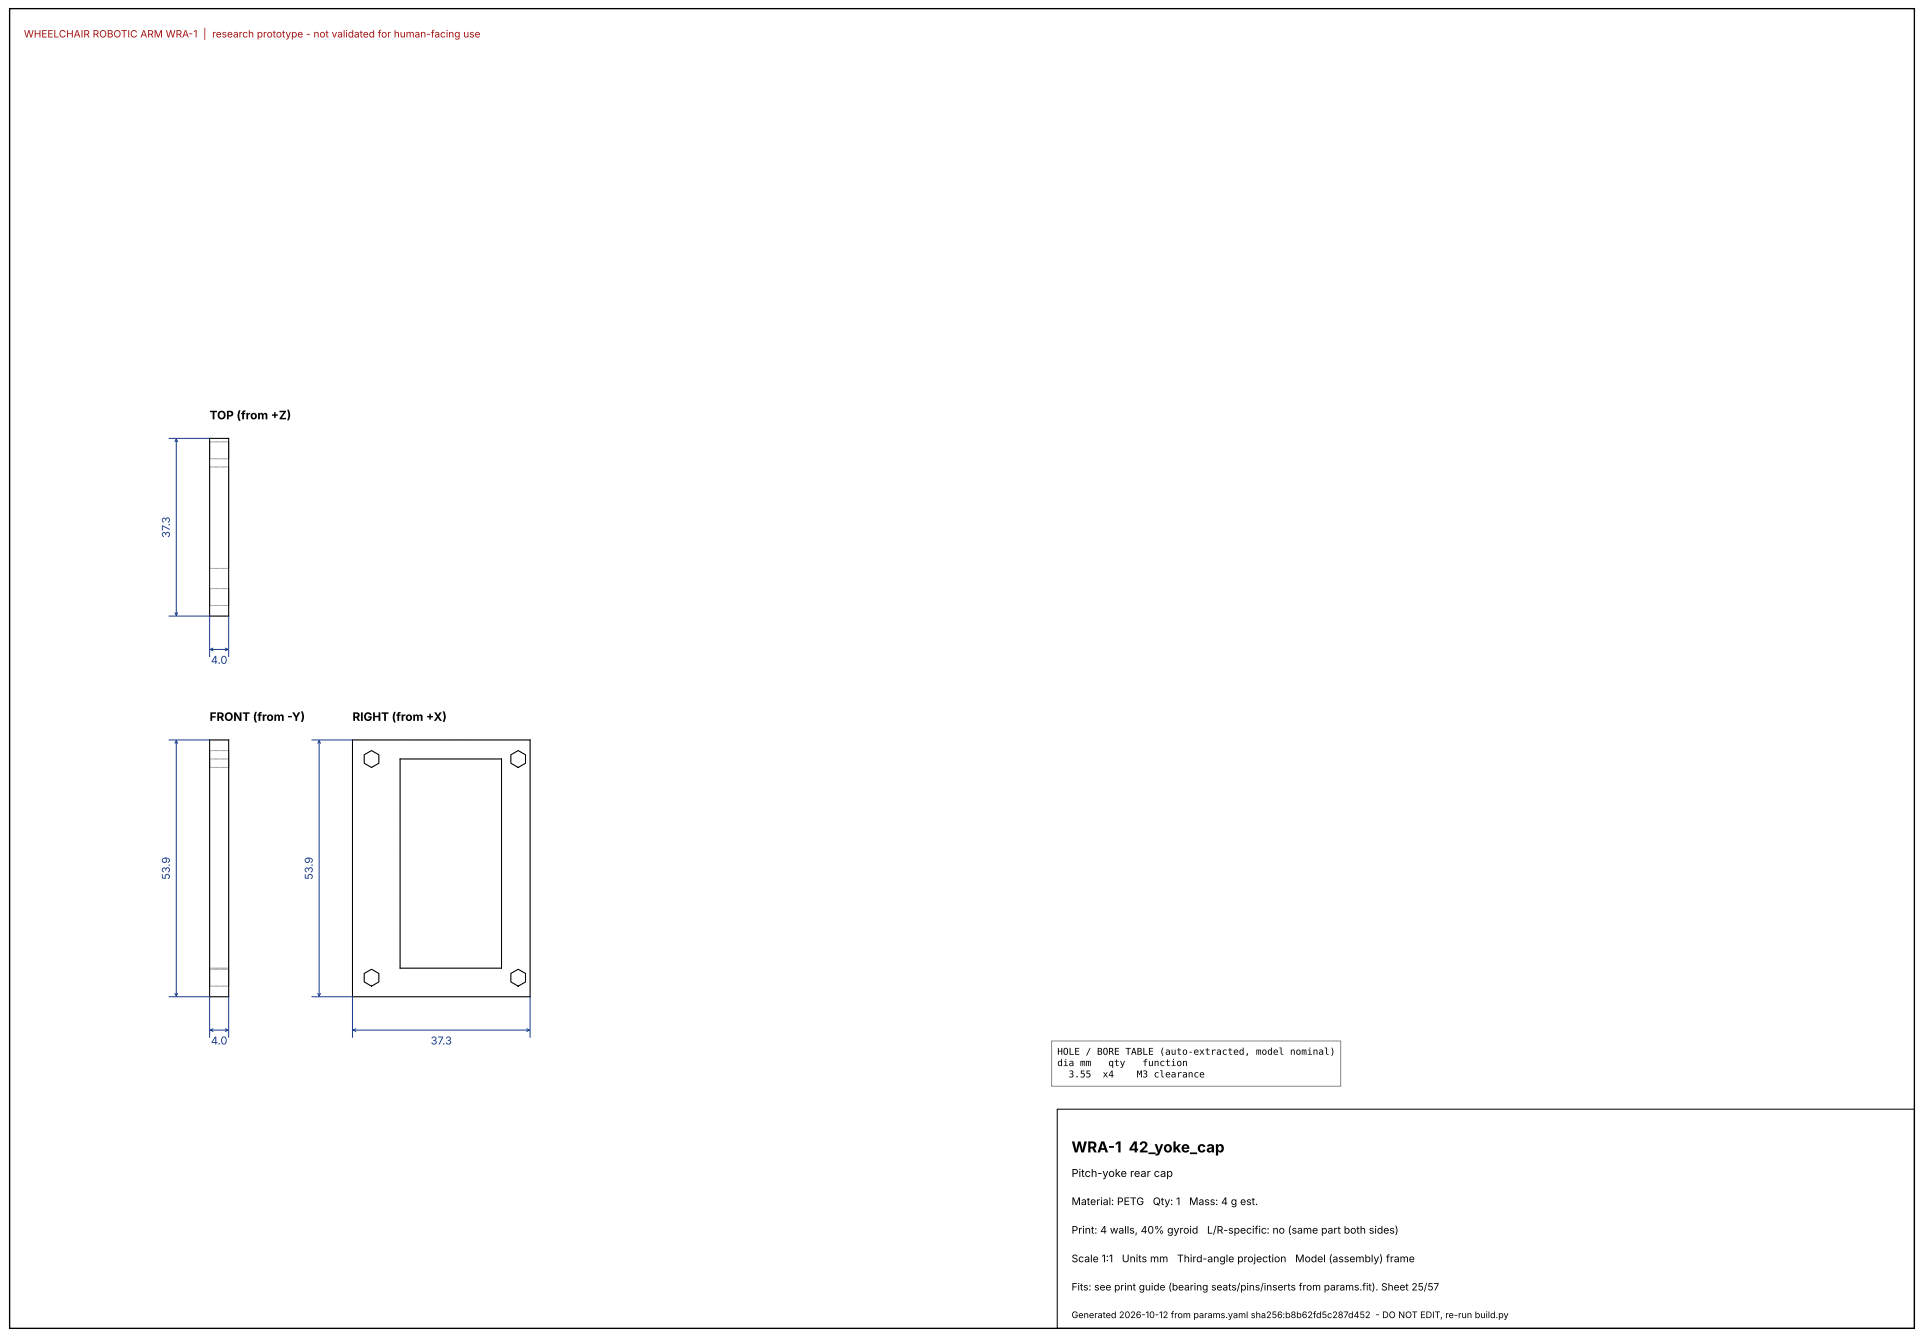
[picture p118: page 26]
FRONT (from -Y); TOP (from +Z); RIGHT (from +X); dia mm; qty; function; M3 clearance; WRA-1 42_yoke_cap

HOLE / BORE TABLE (auto-extracted, model nominal)

Pitch-yoke rear cap

Material: PETG Qty: 1 Mass: 4 g est.

Print: 4 walls, 40% gyroid L/R-specific: no (same part both sides)

Fits: see print guide (bearing seats/pins/inserts from params.fit). Sheet 25/57

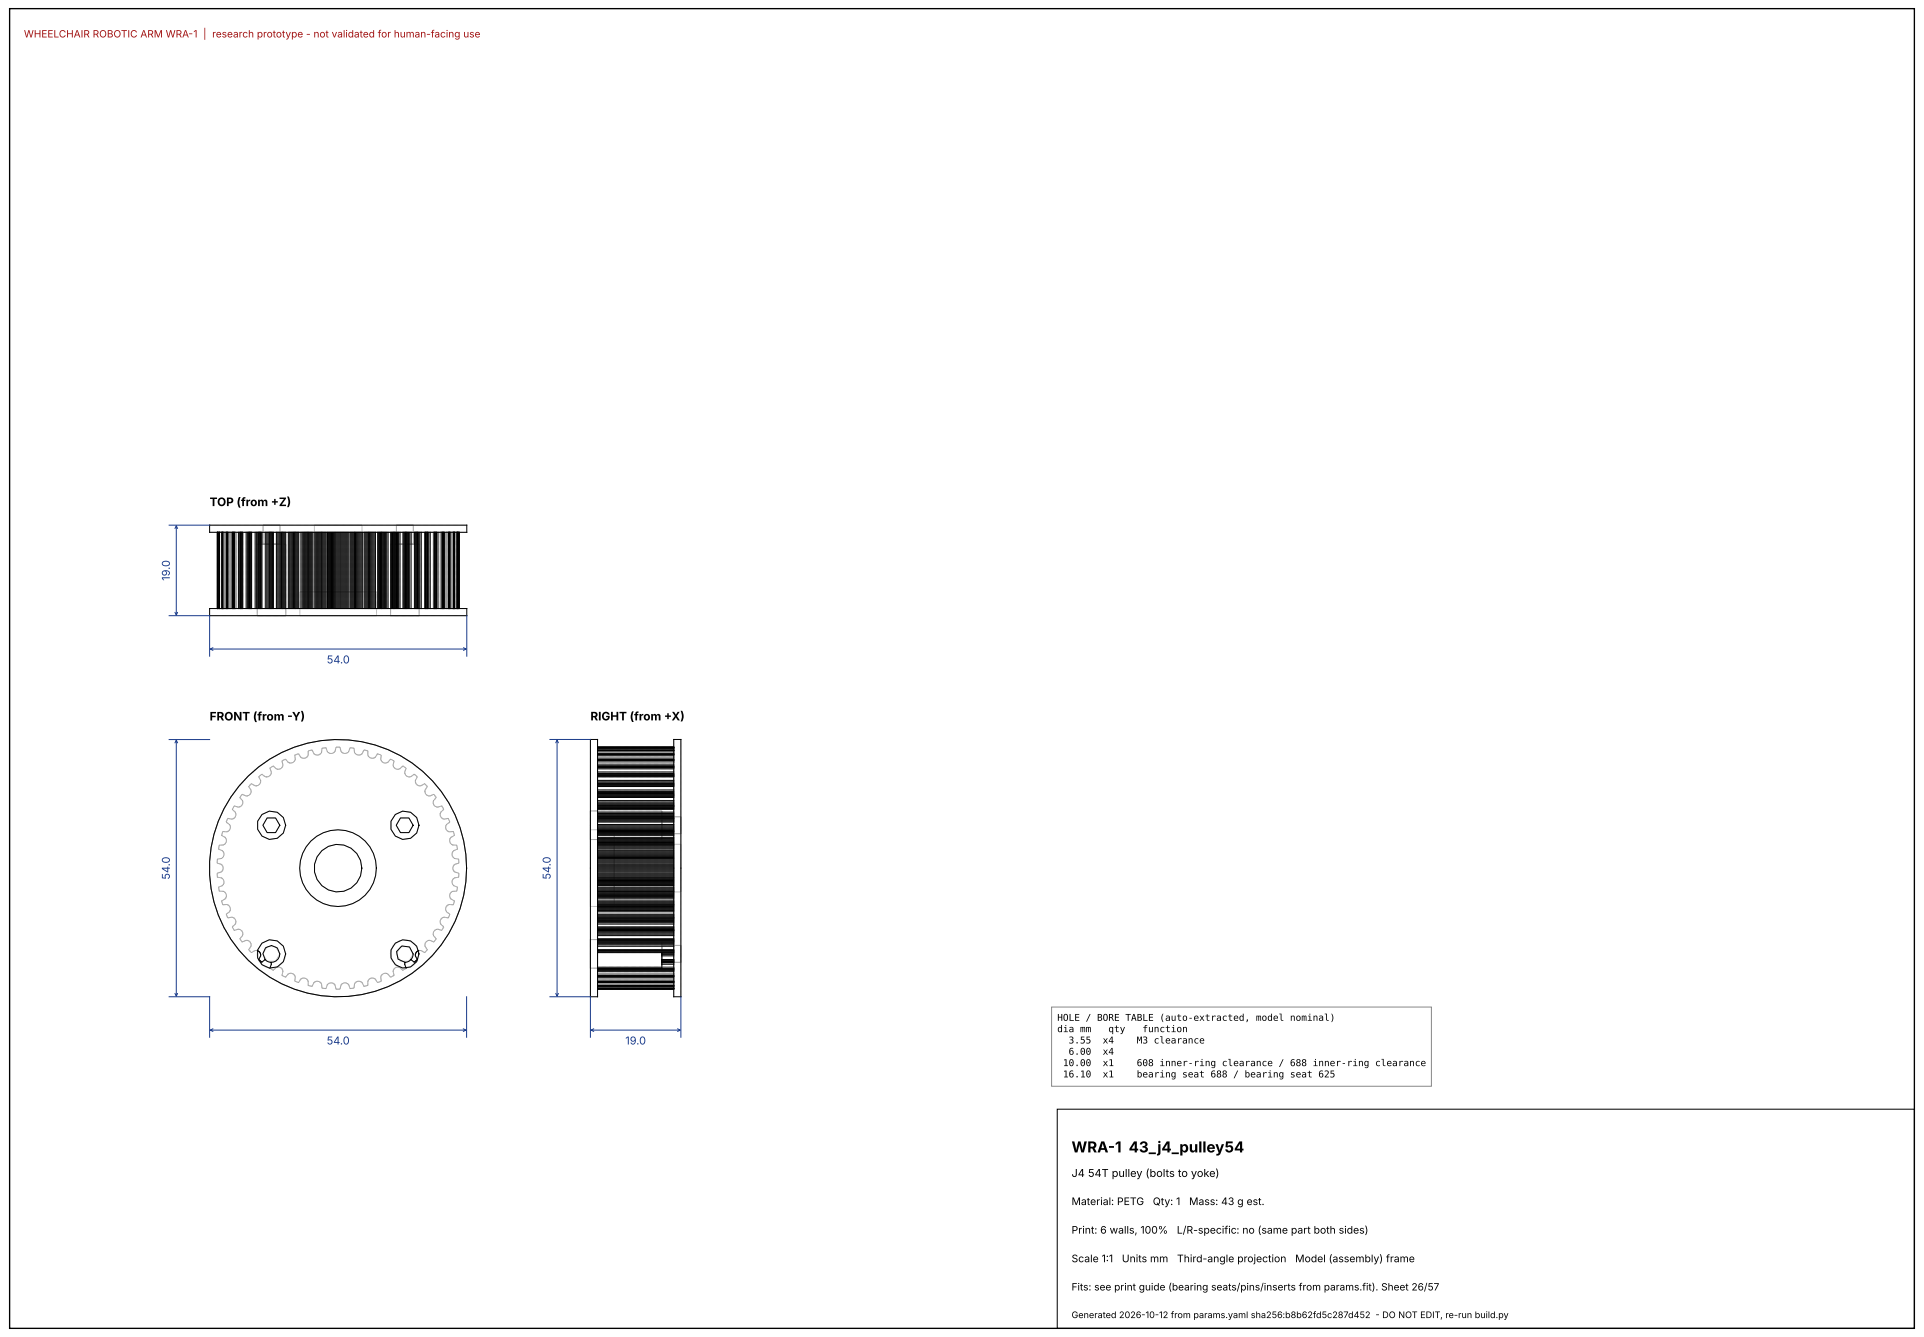
[picture p119: page 27]
FRONT (from -Y); TOP (from +Z); RIGHT (from +X); dia mm; qty; function; M3 clearance; 608 inner-ring clearance / 688 inner-ring clearance; bearing seat 688 / bearing seat 625; WRA-1 43_j4_pulley54

HOLE / BORE TABLE (auto-extracted, model nominal)

J4 54T pulley (bolts to yoke)

Material: PETG Qty: 1 Mass: 43 g est.

Print: 6 walls, 100% L/R-specific: no (same part both sides)

Fits: see print guide (bearing seats/pins/inserts from params.fit). Sheet 26/57

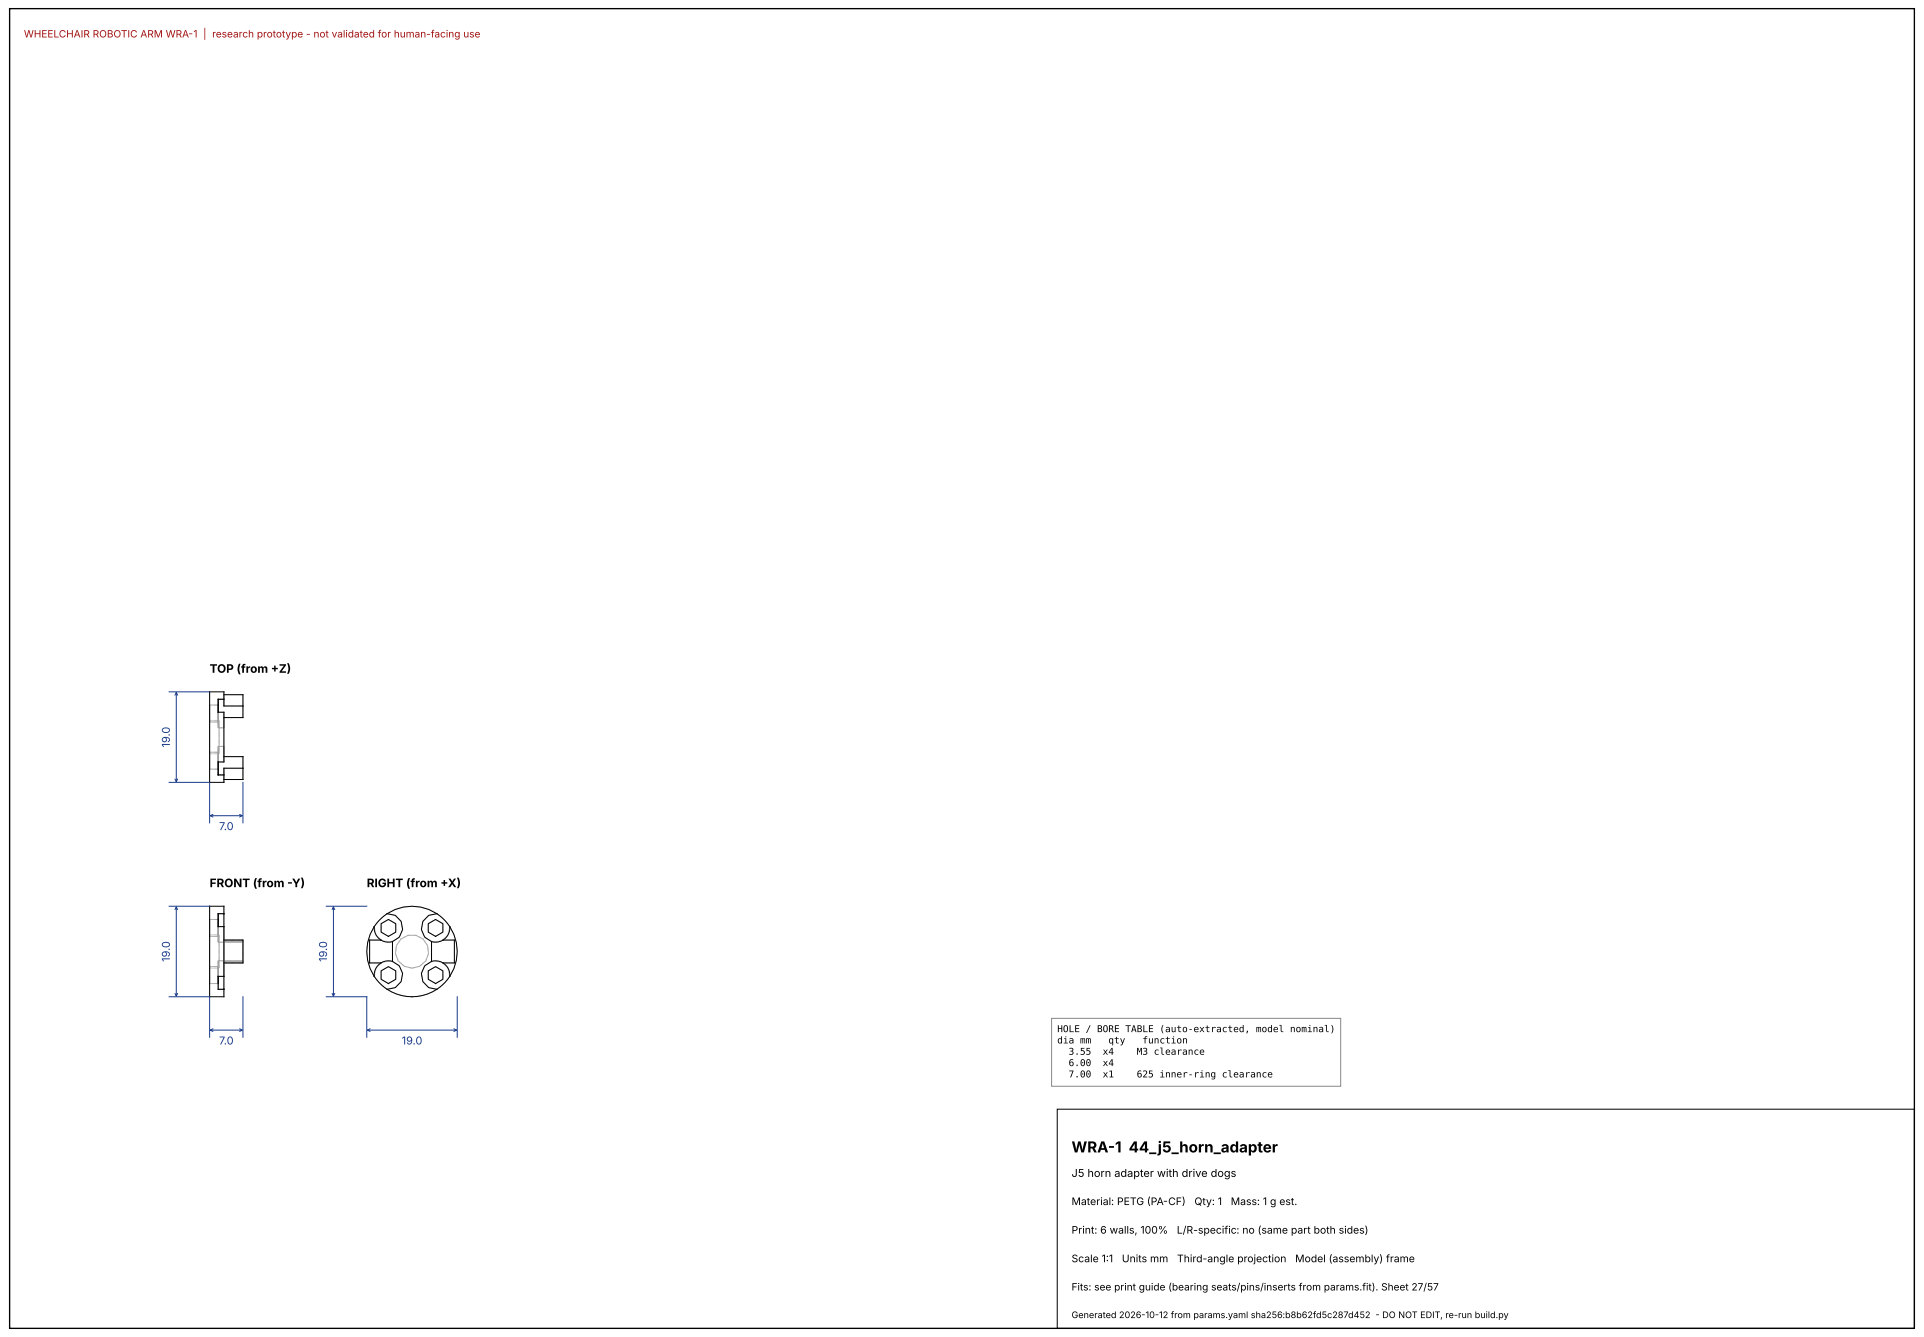
[picture p120: page 28]
FRONT (from -Y); TOP (from +Z); RIGHT (from +X); dia mm; qty; function; M3 clearance; 625 inner-ring clearance; WRA-1 44_j5_horn_adapter

HOLE / BORE TABLE (auto-extracted, model nominal)

J5 horn adapter with drive dogs

Material: PETG (PA-CF) Qty: 1 Mass: 1 g est.

Print: 6 walls, 100% L/R-specific: no (same part both sides)

Fits: see print guide (bearing seats/pins/inserts from params.fit). Sheet 27/57

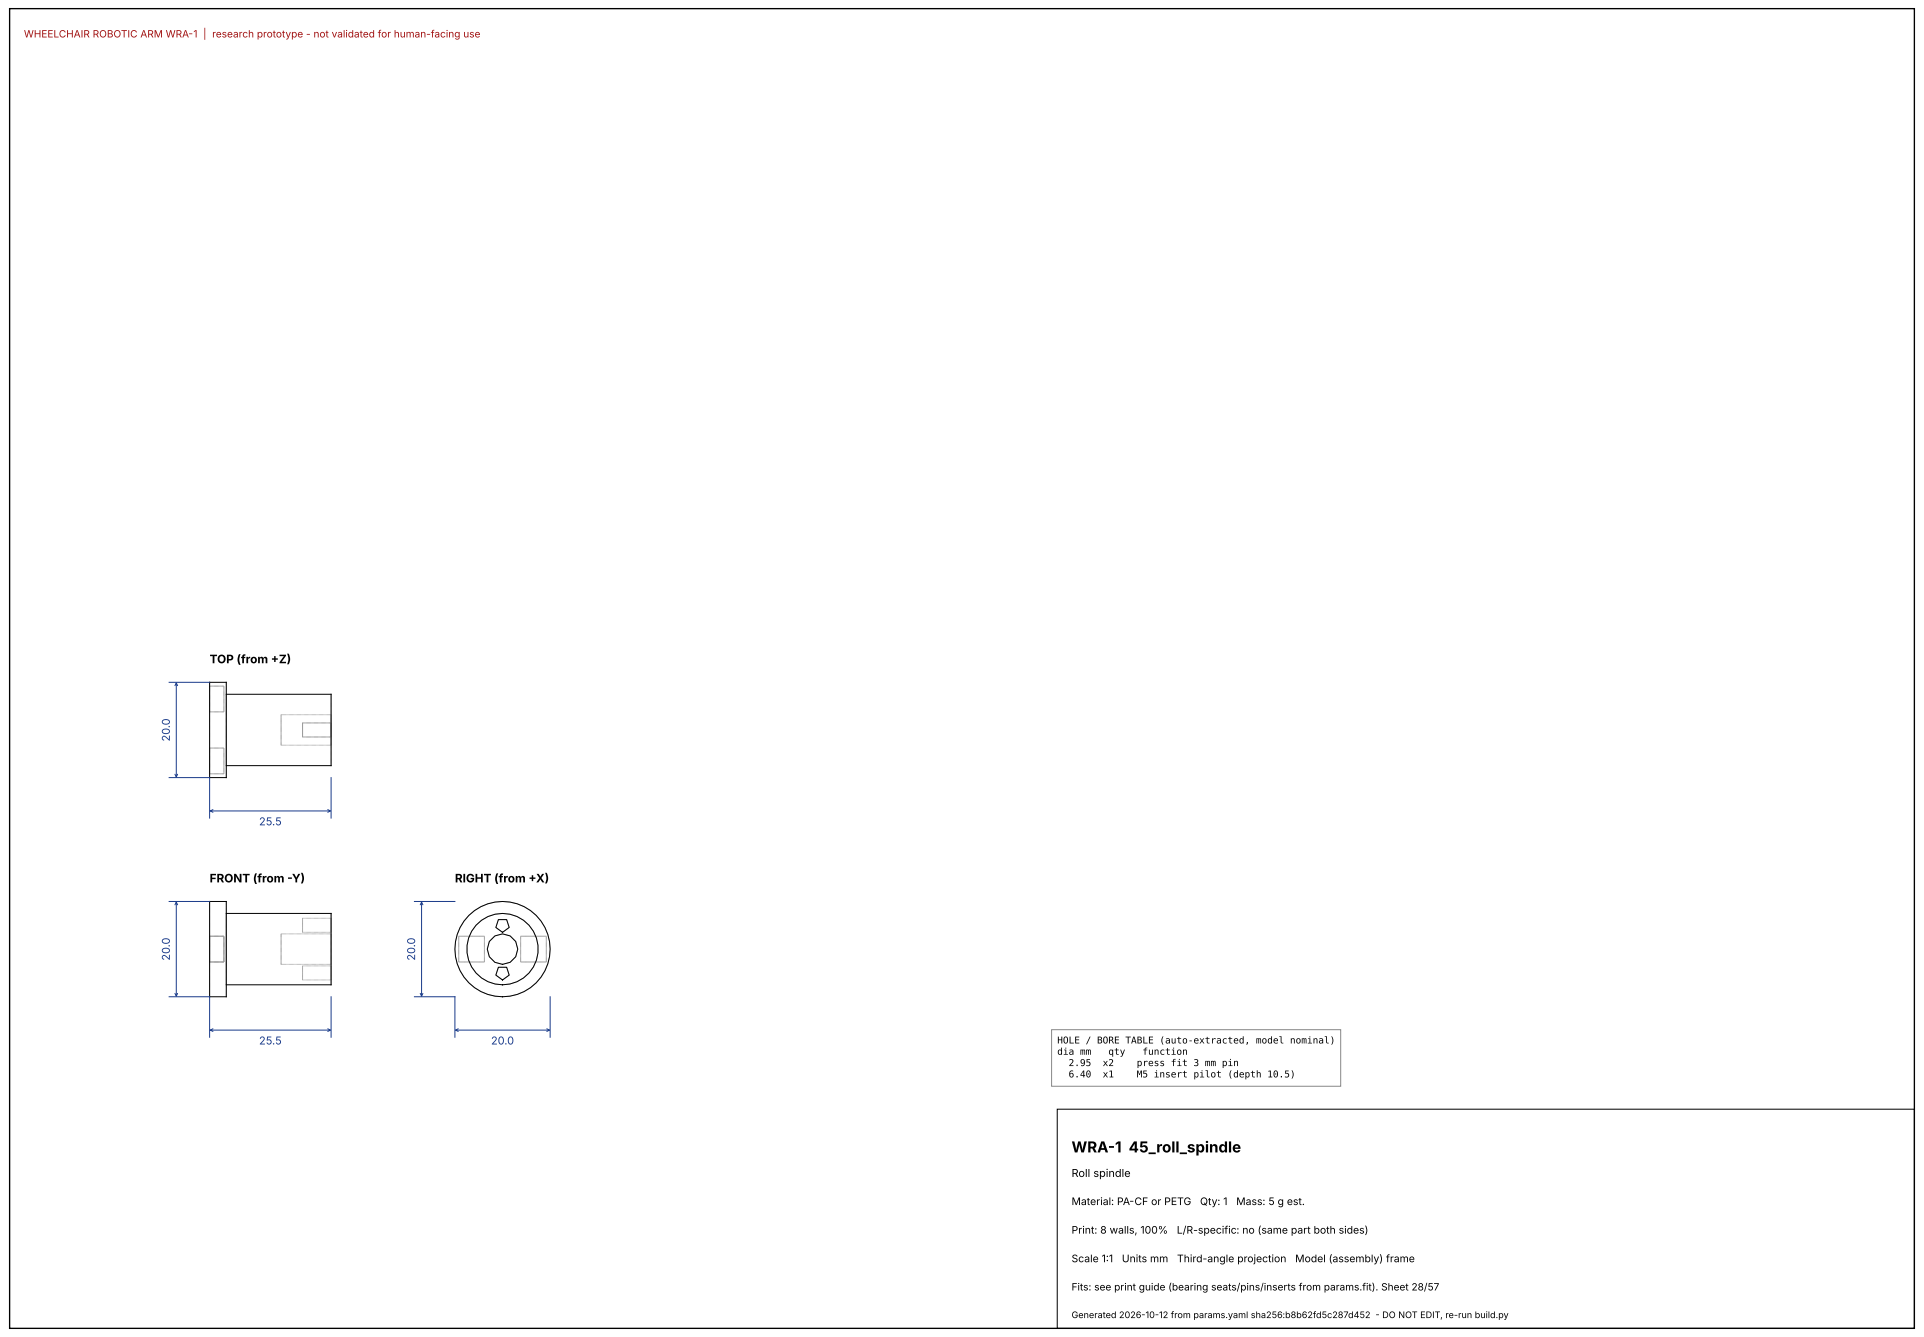
[picture p121: page 29]
FRONT (from -Y); TOP (from +Z); RIGHT (from +X); dia mm; qty; function; press fit 3 mm pin; M5 insert pilot (depth 10.5); WRA-1 45_roll_spindle; Roll spindle

HOLE / BORE TABLE (auto-extracted, model nominal)

Material: PA-CF or PETG Qty: 1 Mass: 5 g est.

Print: 8 walls, 100% L/R-specific: no (same part both sides)

Fits: see print guide (bearing seats/pins/inserts from params.fit). Sheet 28/57

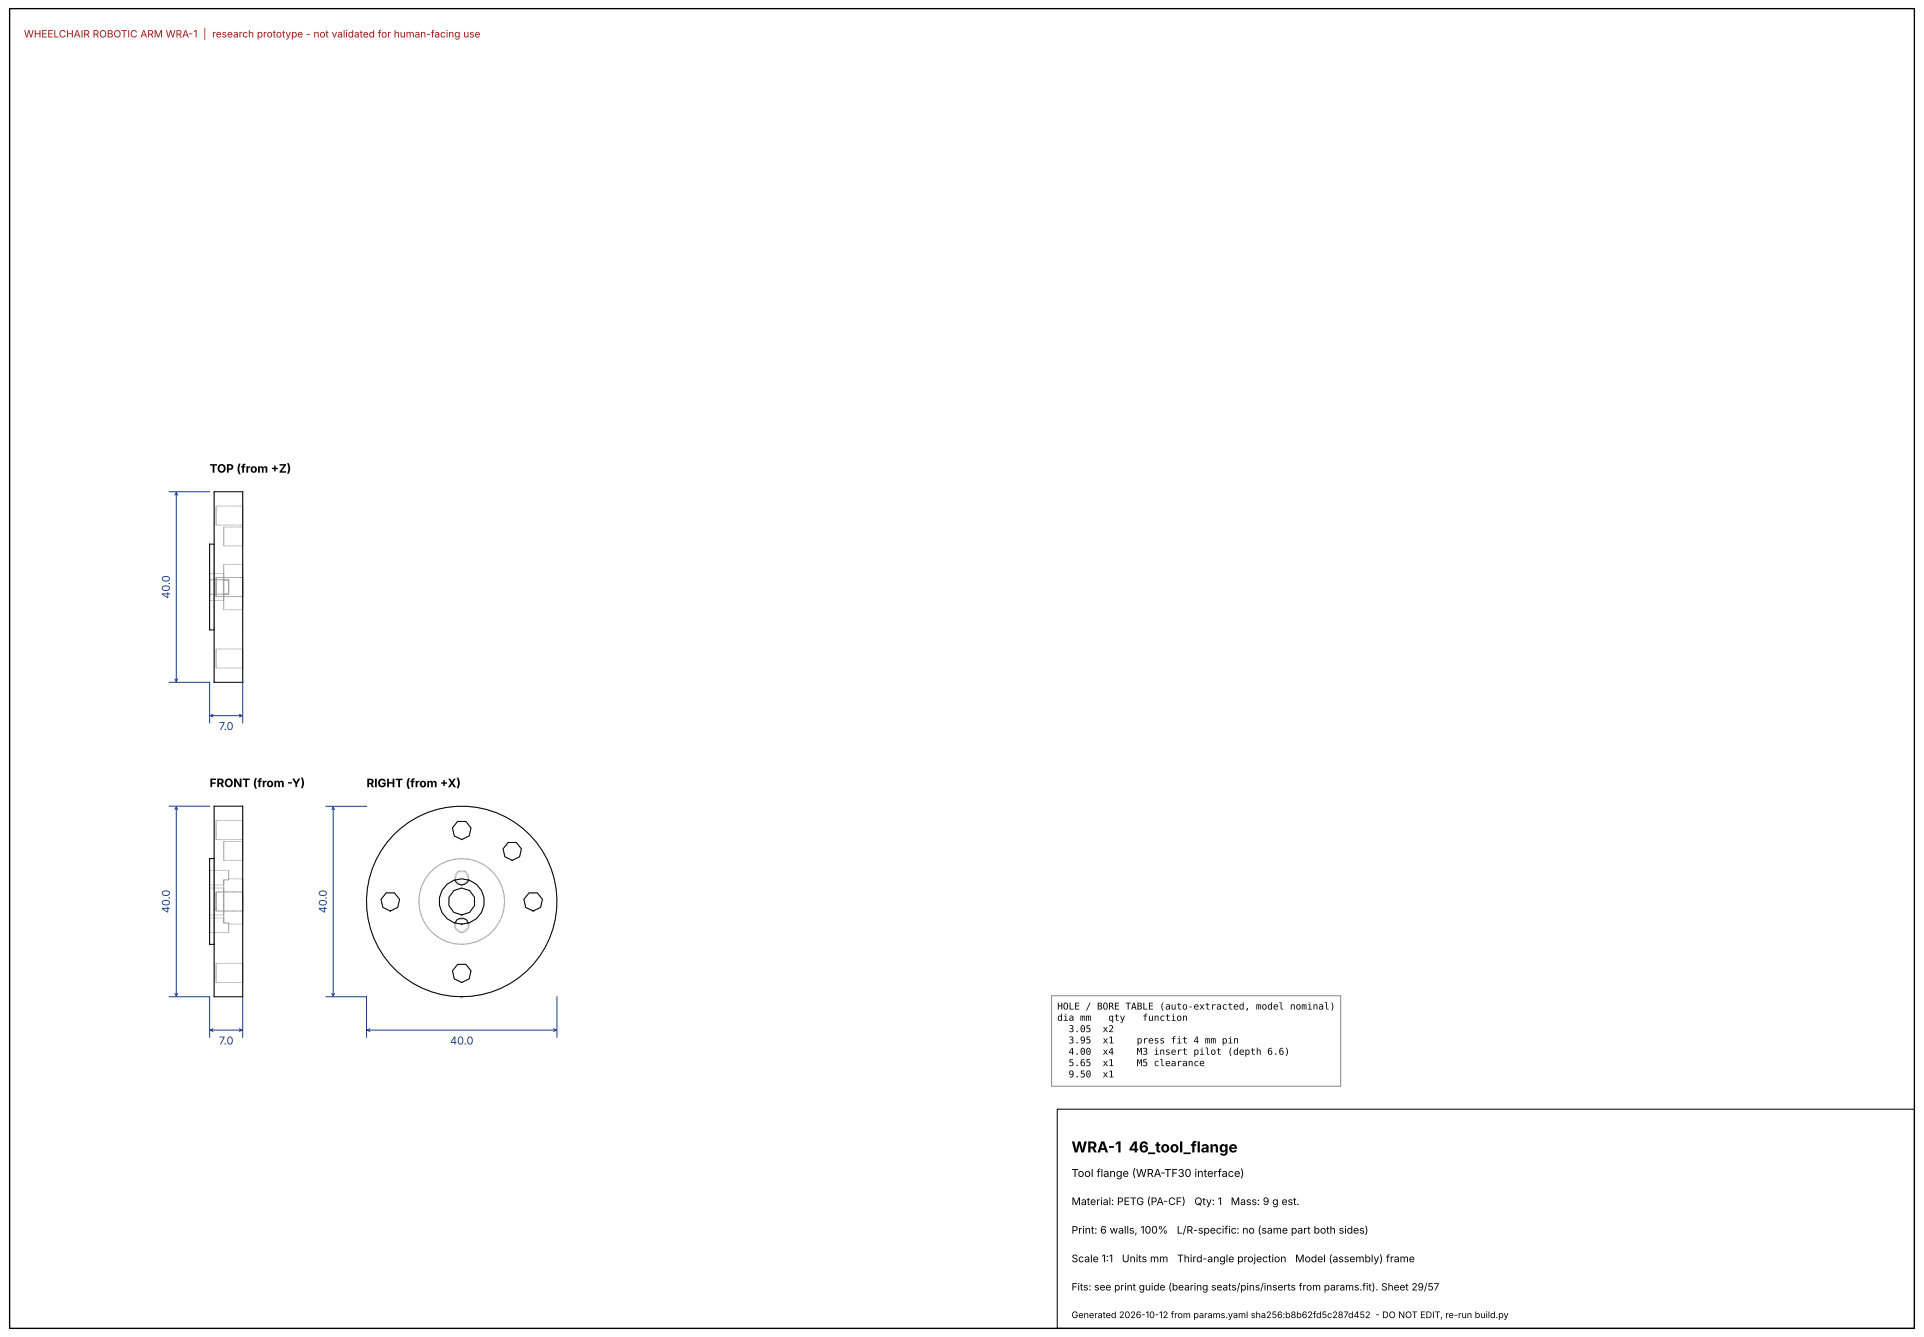
[picture p122: page 30]
FRONT (from -Y); TOP (from +Z); RIGHT (from +X); dia mm; qty; function; press fit 4 mm pin; M3 insert pilot (depth 6.6); M5 clearance; WRA-1 46_tool_flange

HOLE / BORE TABLE (auto-extracted, model nominal)

Tool flange (WRA-TF30 interface)

Material: PETG (PA-CF) Qty: 1 Mass: 9 g est.

Print: 6 walls, 100% L/R-specific: no (same part both sides)

Fits: see print guide (bearing seats/pins/inserts from params.fit). Sheet 29/57

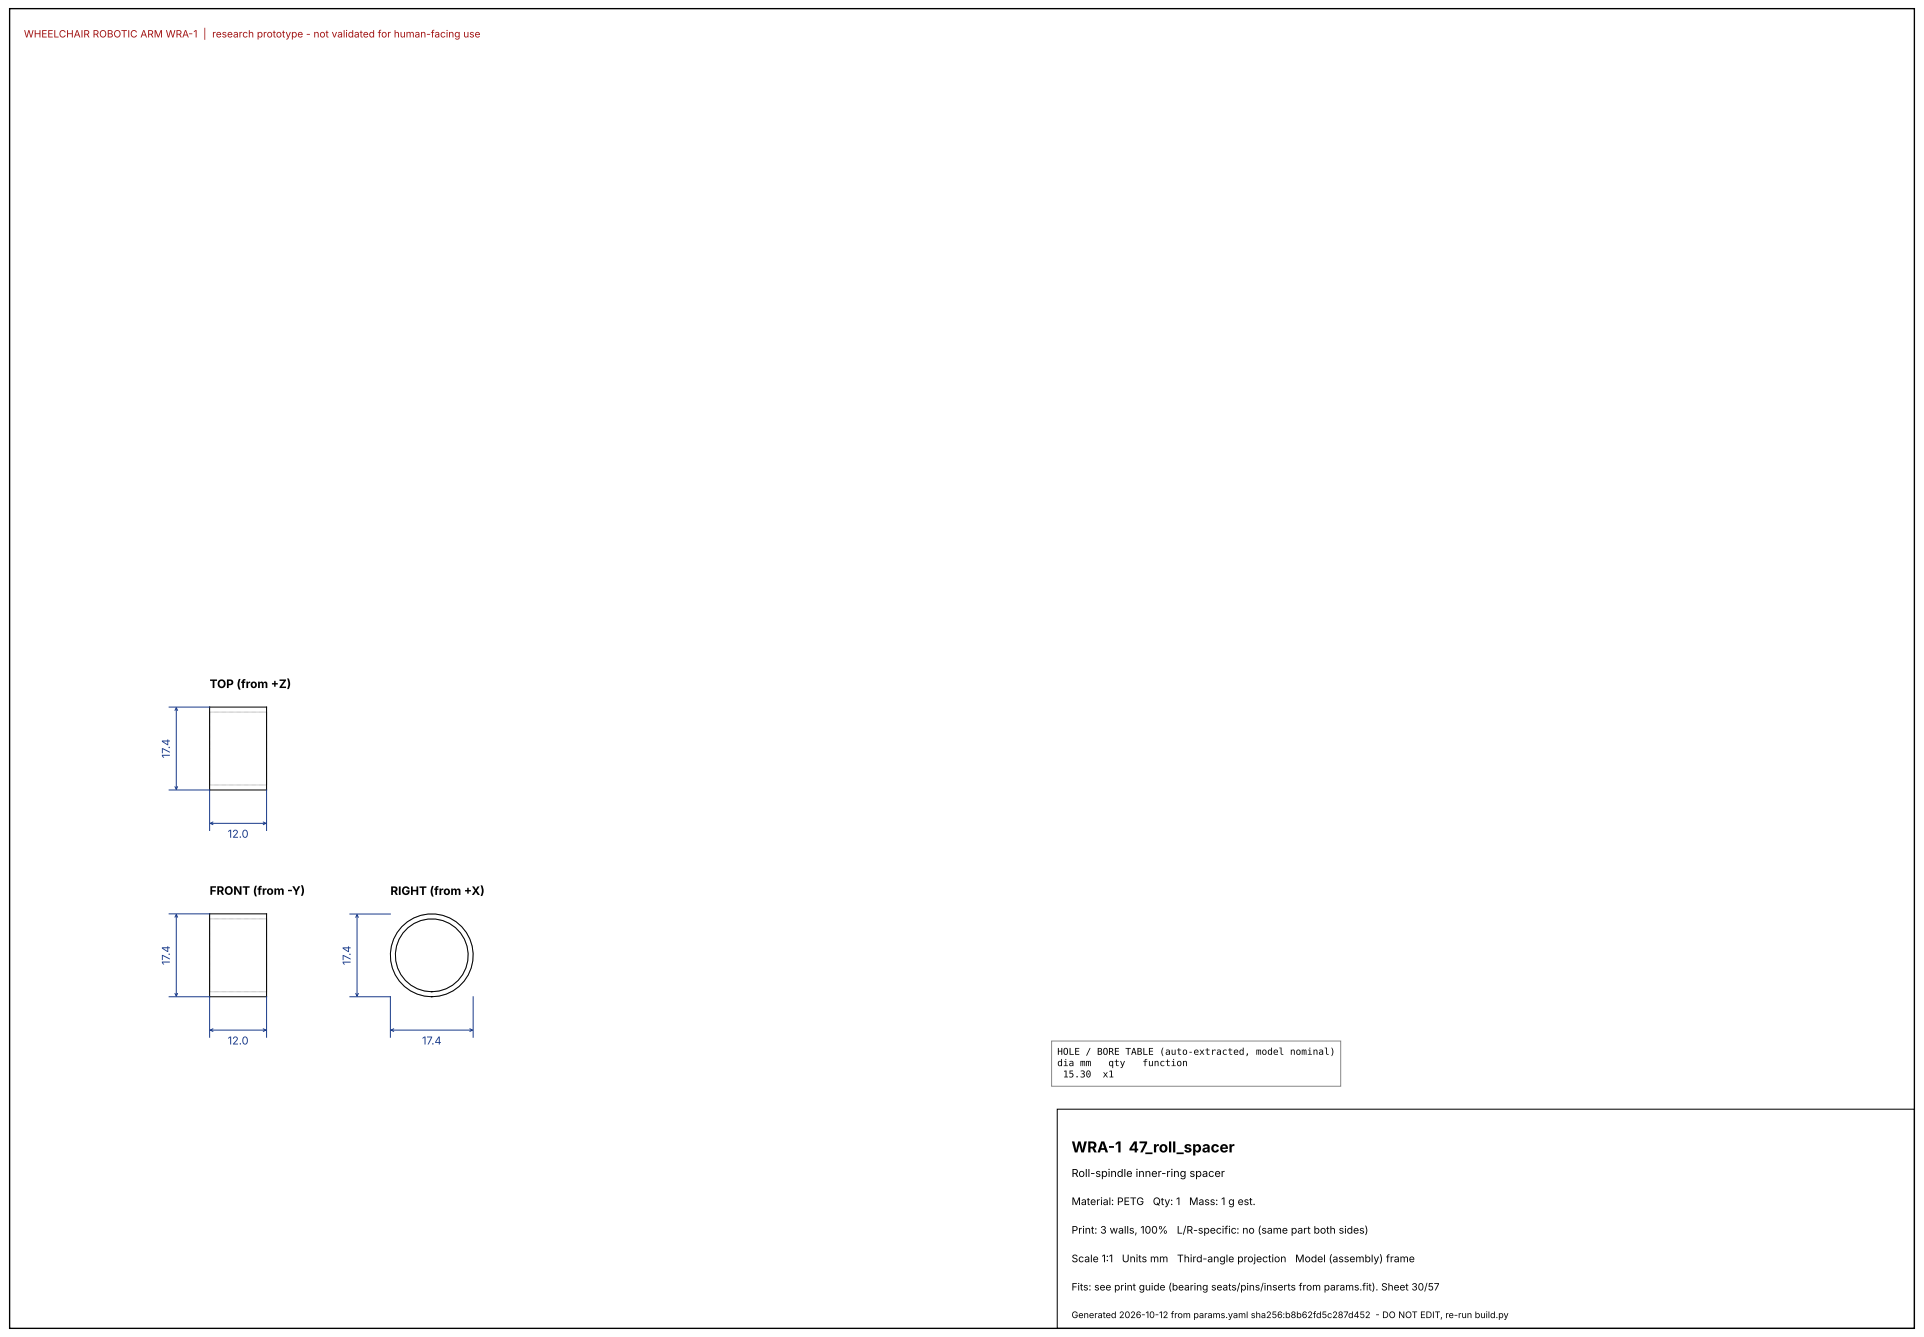
[picture p123: page 31]
FRONT (from -Y); TOP (from +Z); RIGHT (from +X); dia mm; qty; function; WRA-1 47_roll_spacer

HOLE / BORE TABLE (auto-extracted, model nominal)

Roll-spindle inner-ring spacer

Material: PETG Qty: 1 Mass: 1 g est.

Print: 3 walls, 100% L/R-specific: no (same part both sides)

Fits: see print guide (bearing seats/pins/inserts from params.fit). Sheet 30/57

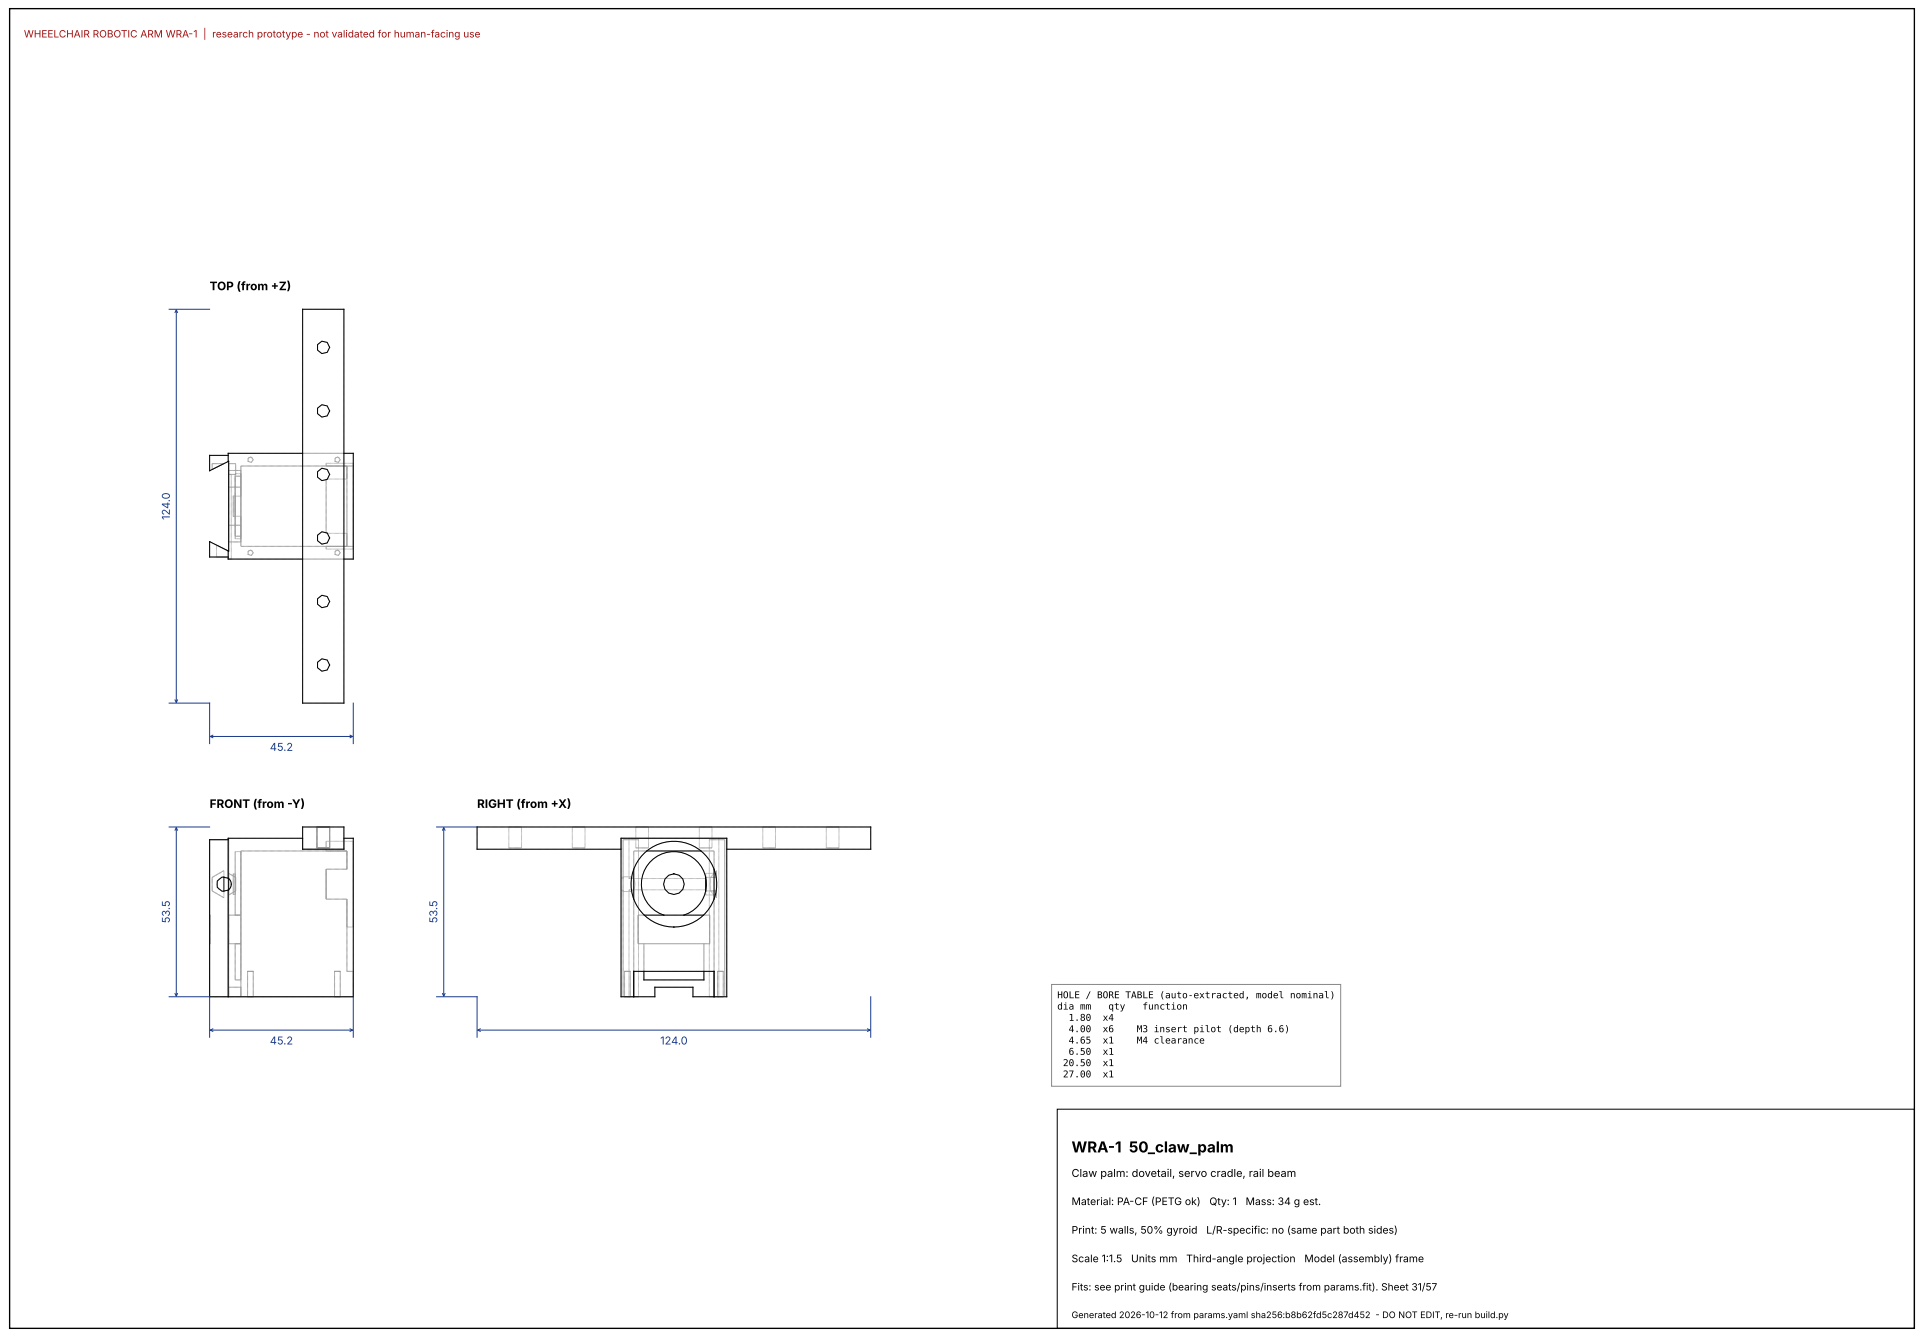
[picture p124: page 32]
FRONT (from -Y); TOP (from +Z); RIGHT (from +X); dia mm; qty; function; M3 insert pilot (depth 6.6); M4 clearance; WRA-1 50_claw_palm

HOLE / BORE TABLE (auto-extracted, model nominal)

Claw palm: dovetail, servo cradle, rail beam

Material: PA-CF (PETG ok) Qty: 1 Mass: 34 g est.

Print: 5 walls, 50% gyroid L/R-specific: no (same part both sides)

Scale 1:1.5 Units mm Third-angle projection Model (assembly) frame

Fits: see print guide (bearing seats/pins/inserts from params.fit). Sheet 31/57

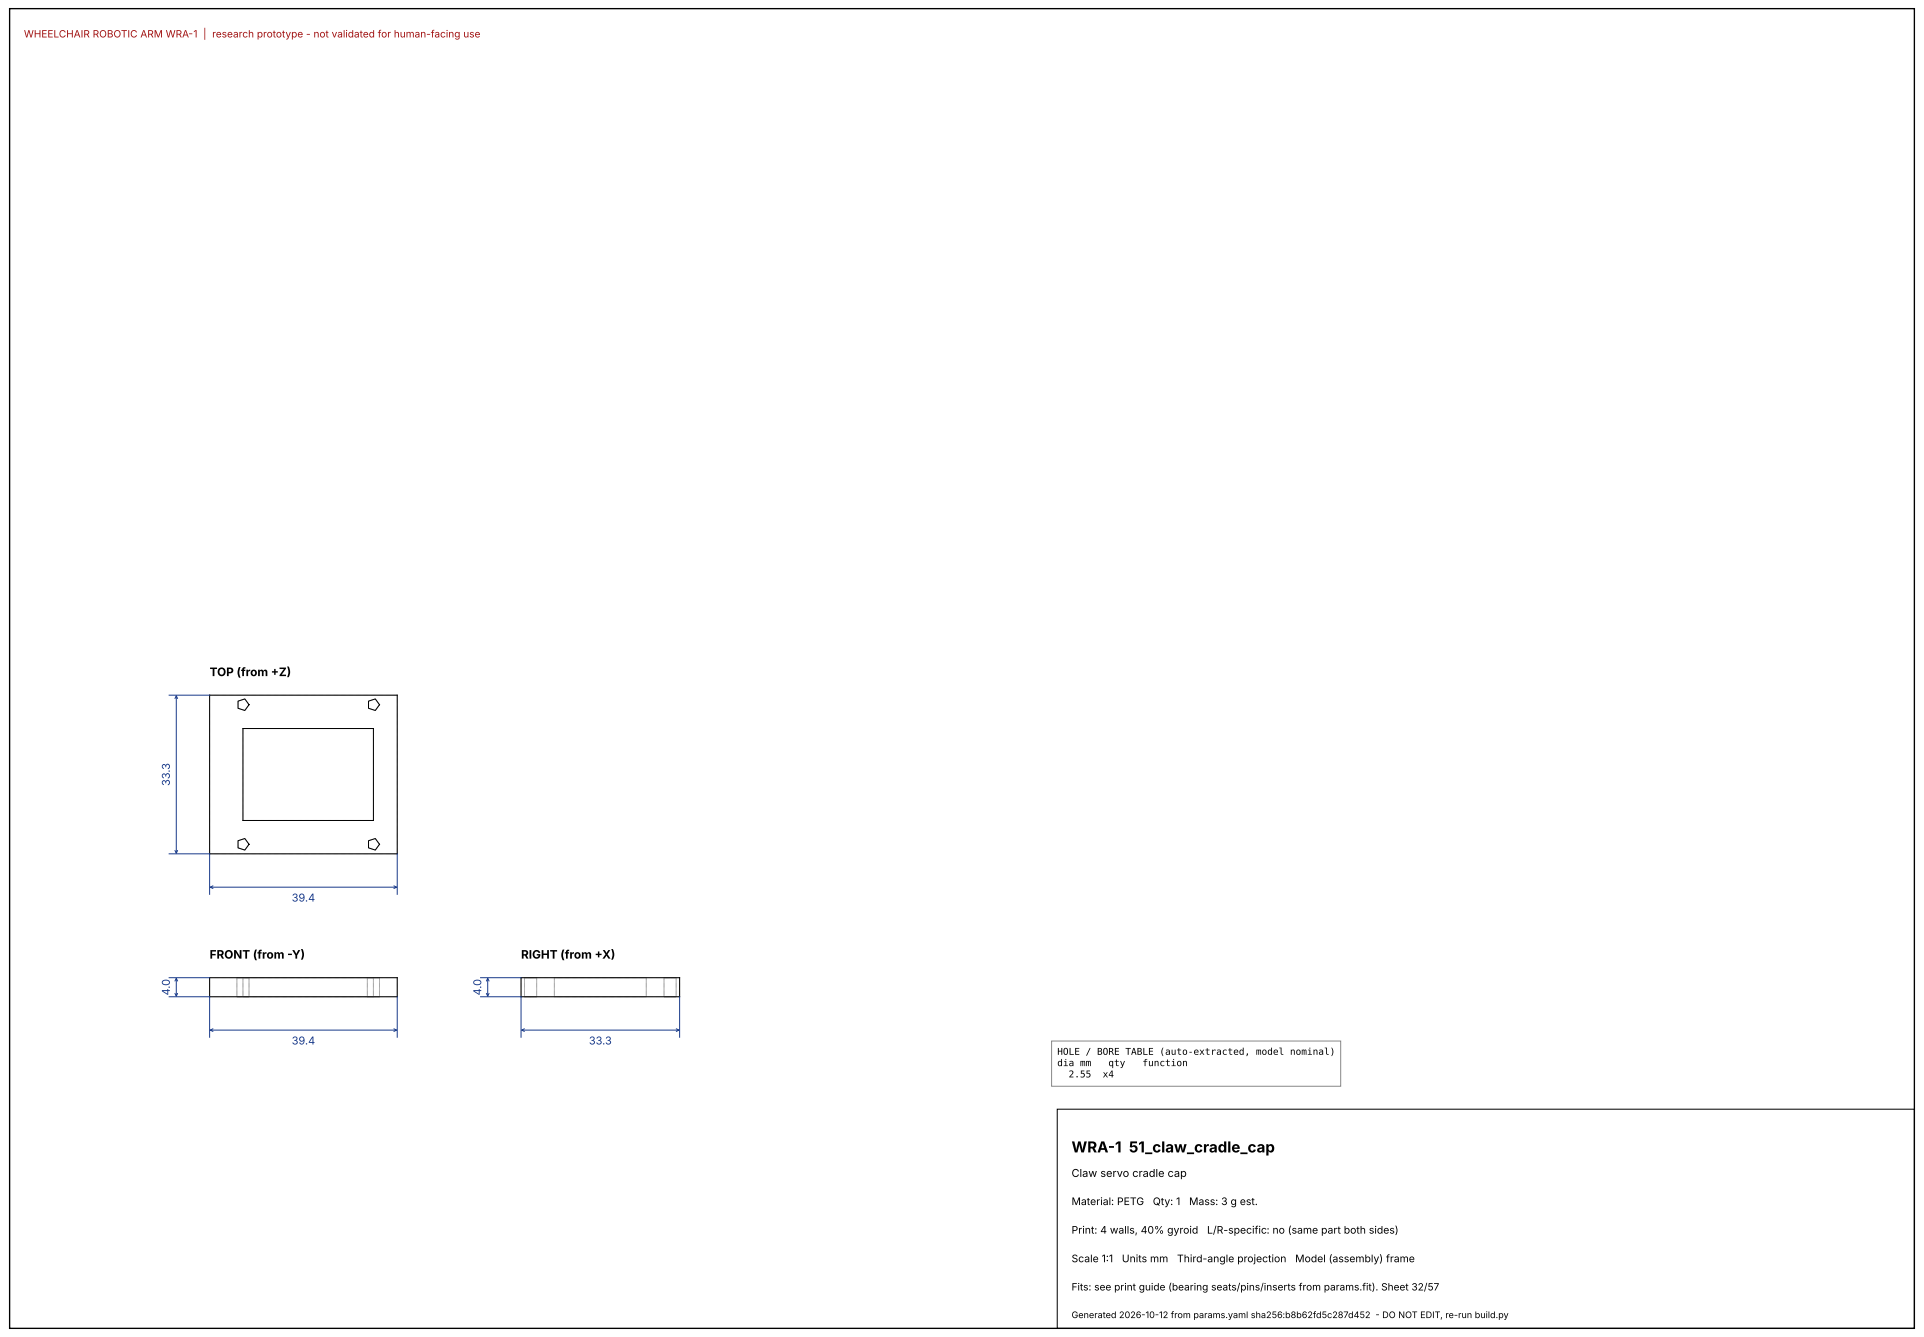
[picture p125: page 33]
FRONT (from -Y); TOP (from +Z); RIGHT (from +X); dia mm; qty; function; WRA-1 51_claw_cradle_cap

HOLE / BORE TABLE (auto-extracted, model nominal)

Claw servo cradle cap

Material: PETG Qty: 1 Mass: 3 g est.

Print: 4 walls, 40% gyroid L/R-specific: no (same part both sides)

Fits: see print guide (bearing seats/pins/inserts from params.fit). Sheet 32/57

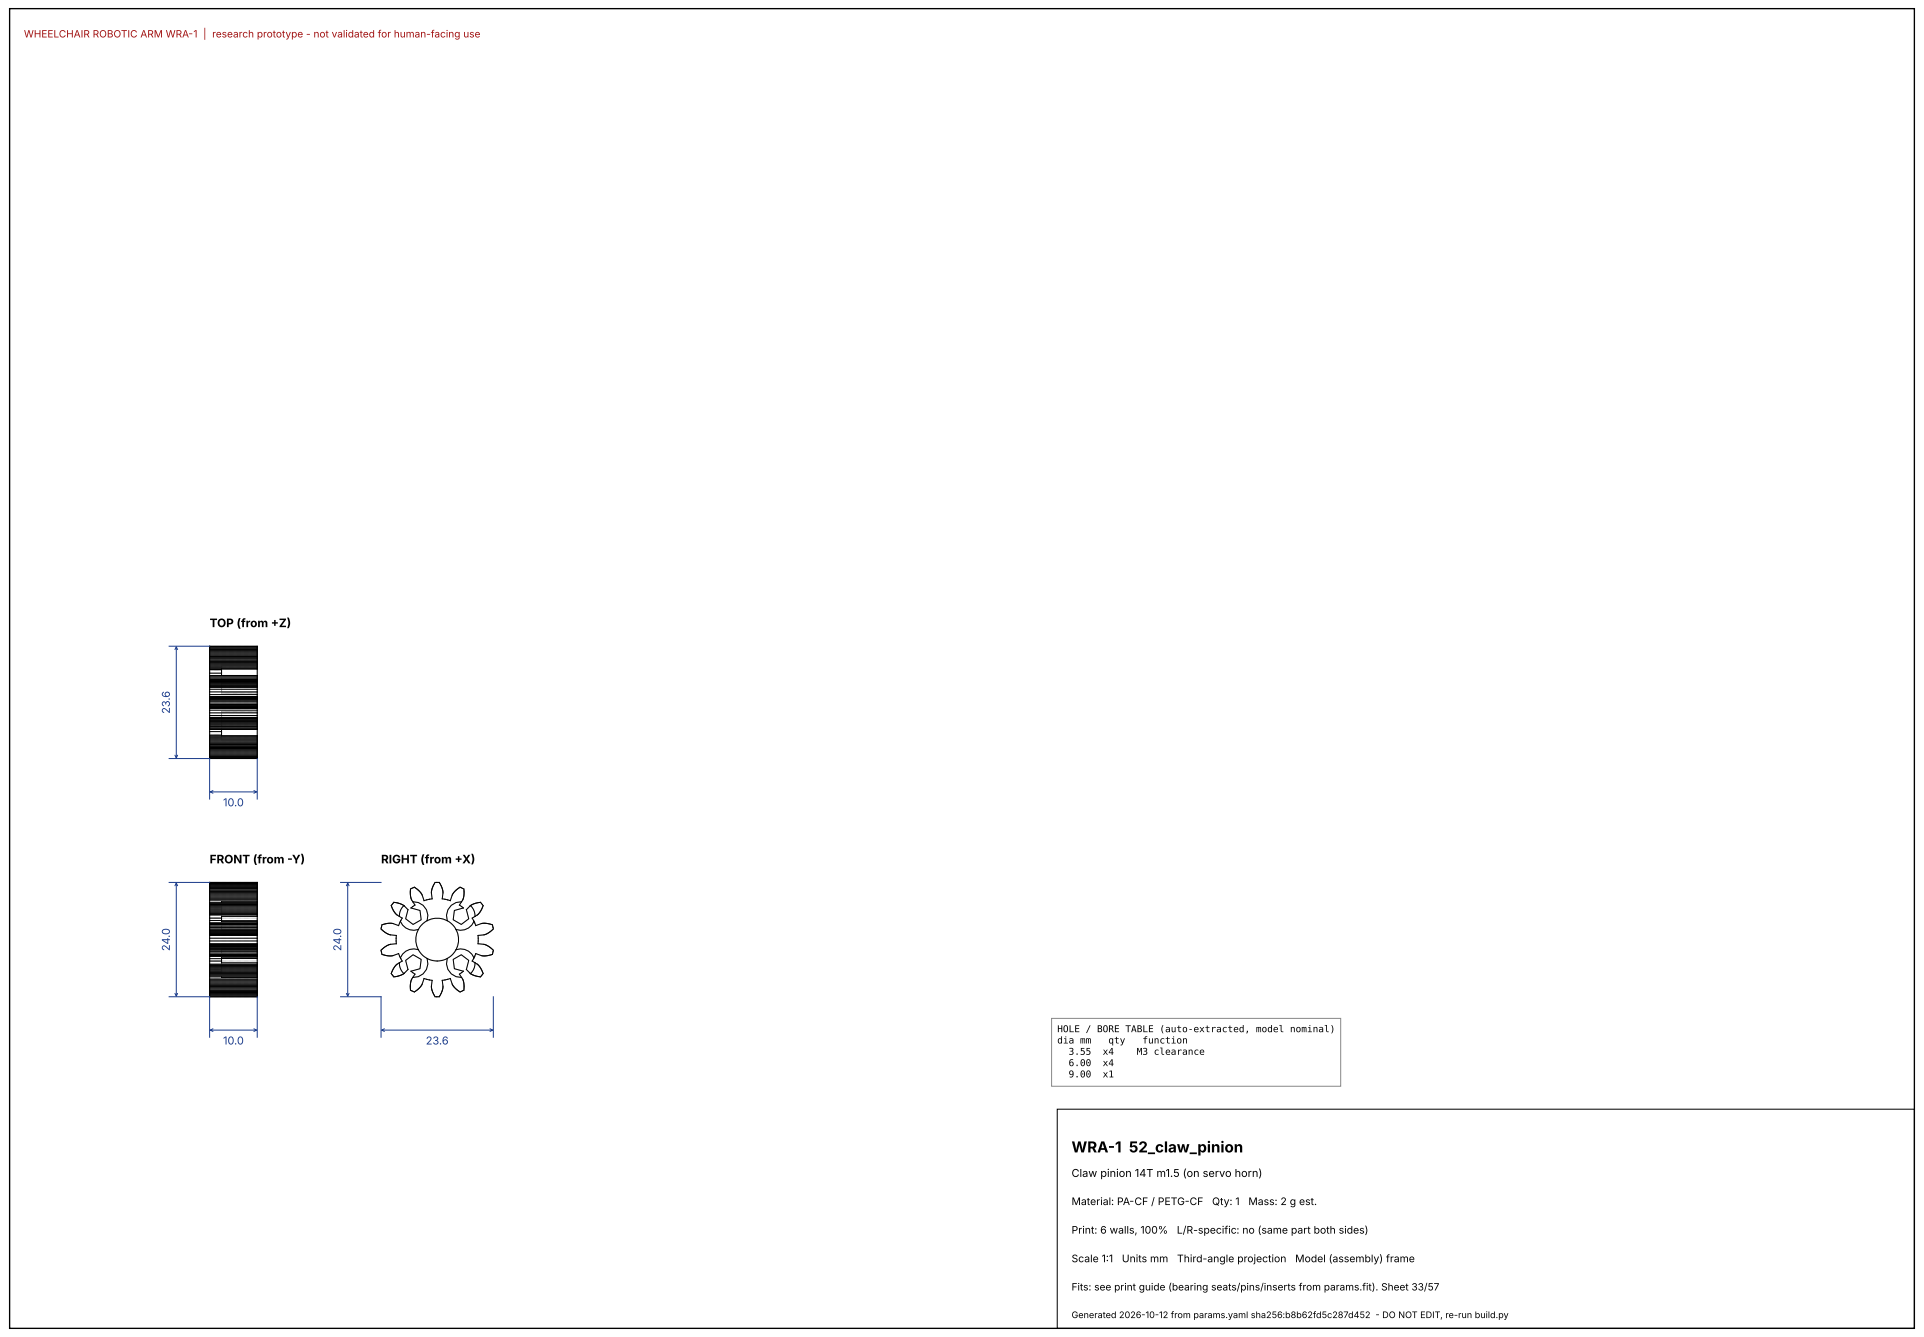
[picture p126: page 34]
FRONT (from -Y); TOP (from +Z); RIGHT (from +X); dia mm; qty; function; M3 clearance; WRA-1 52_claw_pinion

HOLE / BORE TABLE (auto-extracted, model nominal)

Claw pinion 14T m1.5 (on servo horn)

Material: PA-CF / PETG-CF Qty: 1 Mass: 2 g est.

Print: 6 walls, 100% L/R-specific: no (same part both sides)

Fits: see print guide (bearing seats/pins/inserts from params.fit). Sheet 33/57

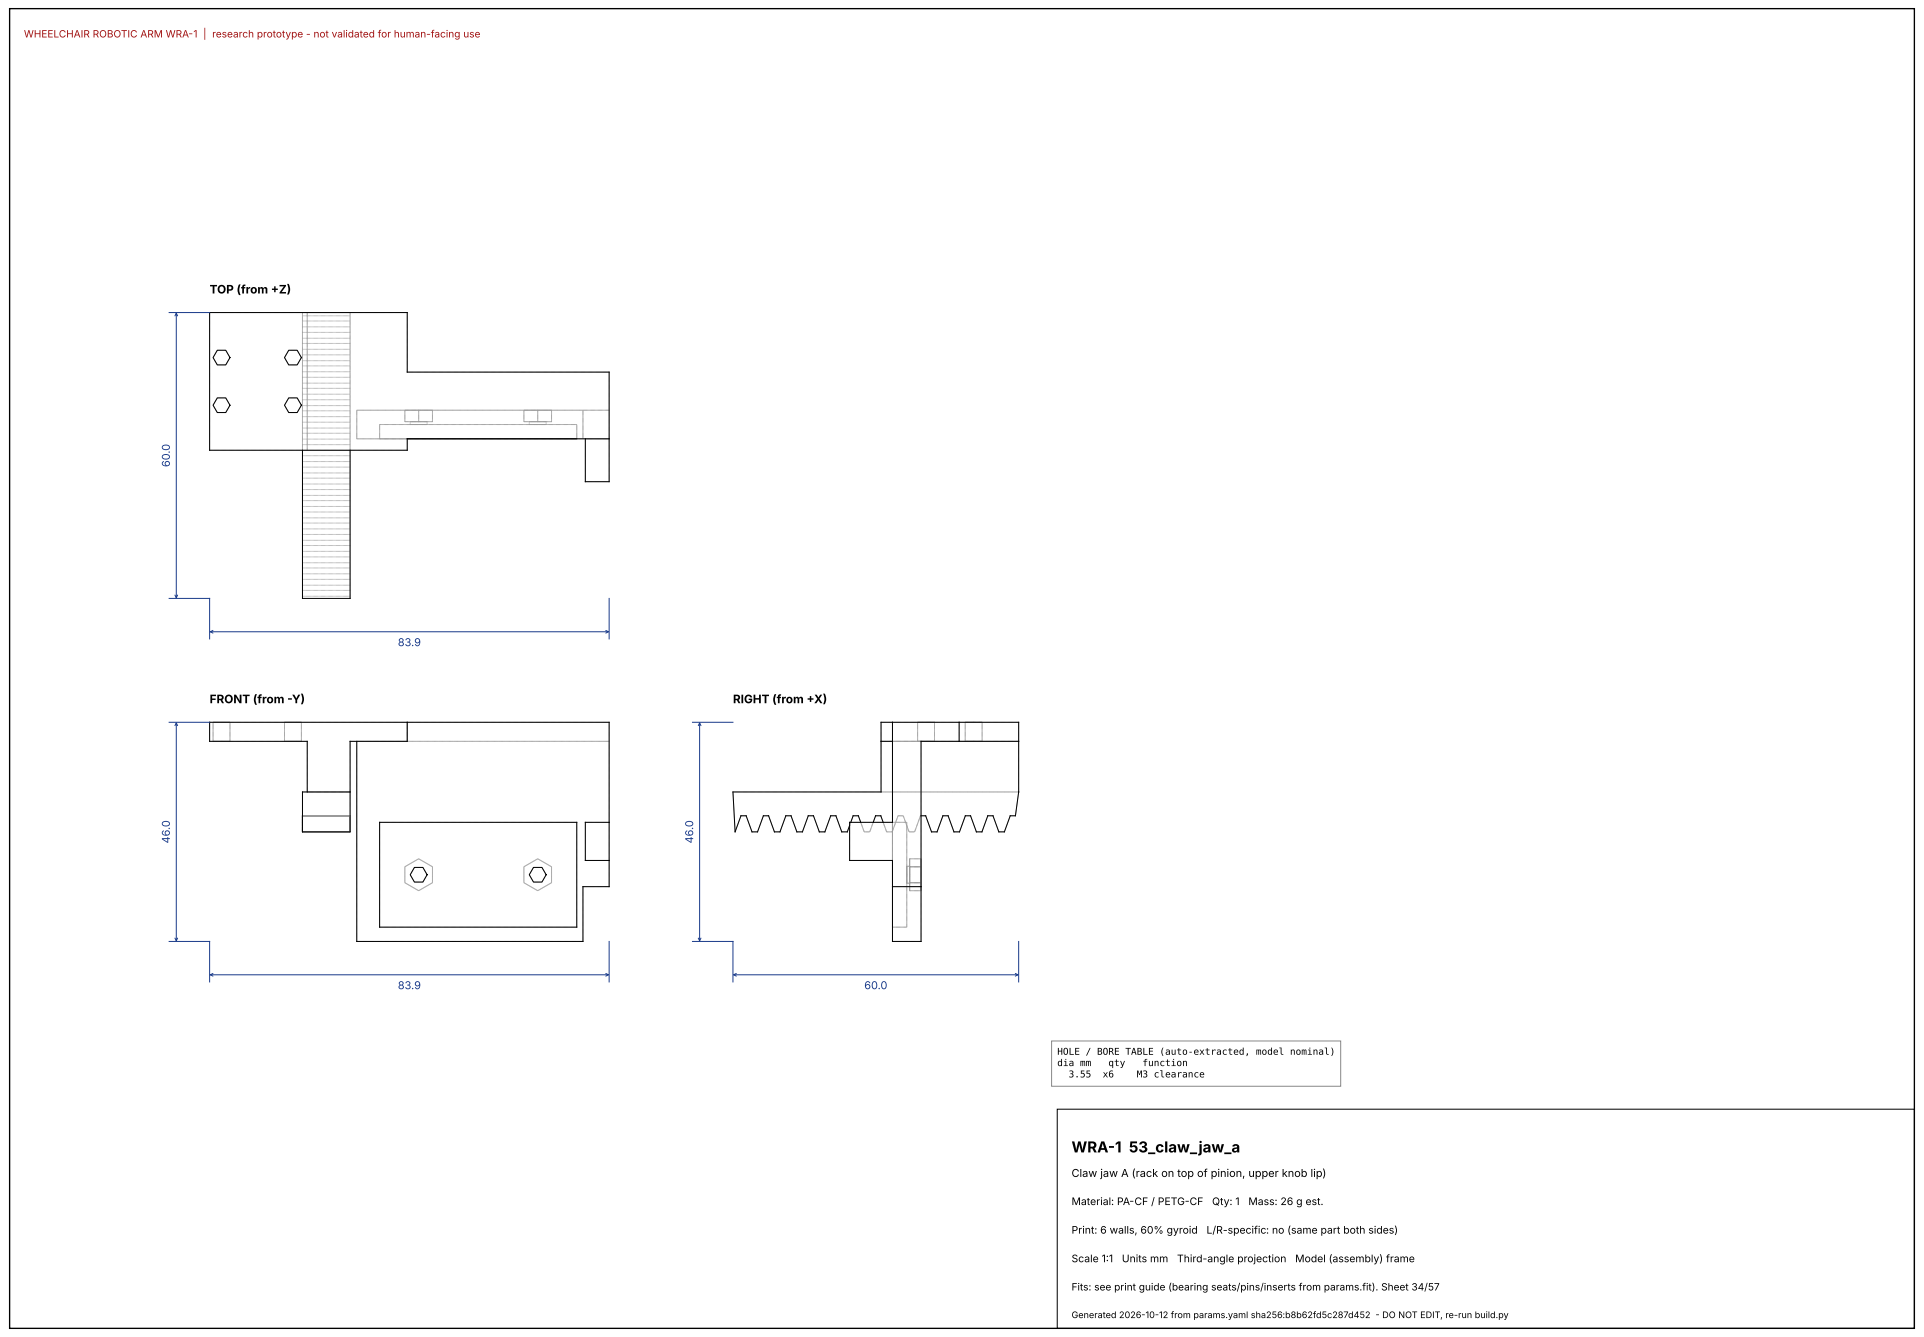
[picture p127: page 35]
FRONT (from -Y); TOP (from +Z); RIGHT (from +X); dia mm; qty; function; M3 clearance; WRA-1 53_claw_jaw_a

HOLE / BORE TABLE (auto-extracted, model nominal)

Claw jaw A (rack on top of pinion, upper knob lip)

Material: PA-CF / PETG-CF Qty: 1 Mass: 26 g est.

Print: 6 walls, 60% gyroid L/R-specific: no (same part both sides)

Fits: see print guide (bearing seats/pins/inserts from params.fit). Sheet 34/57

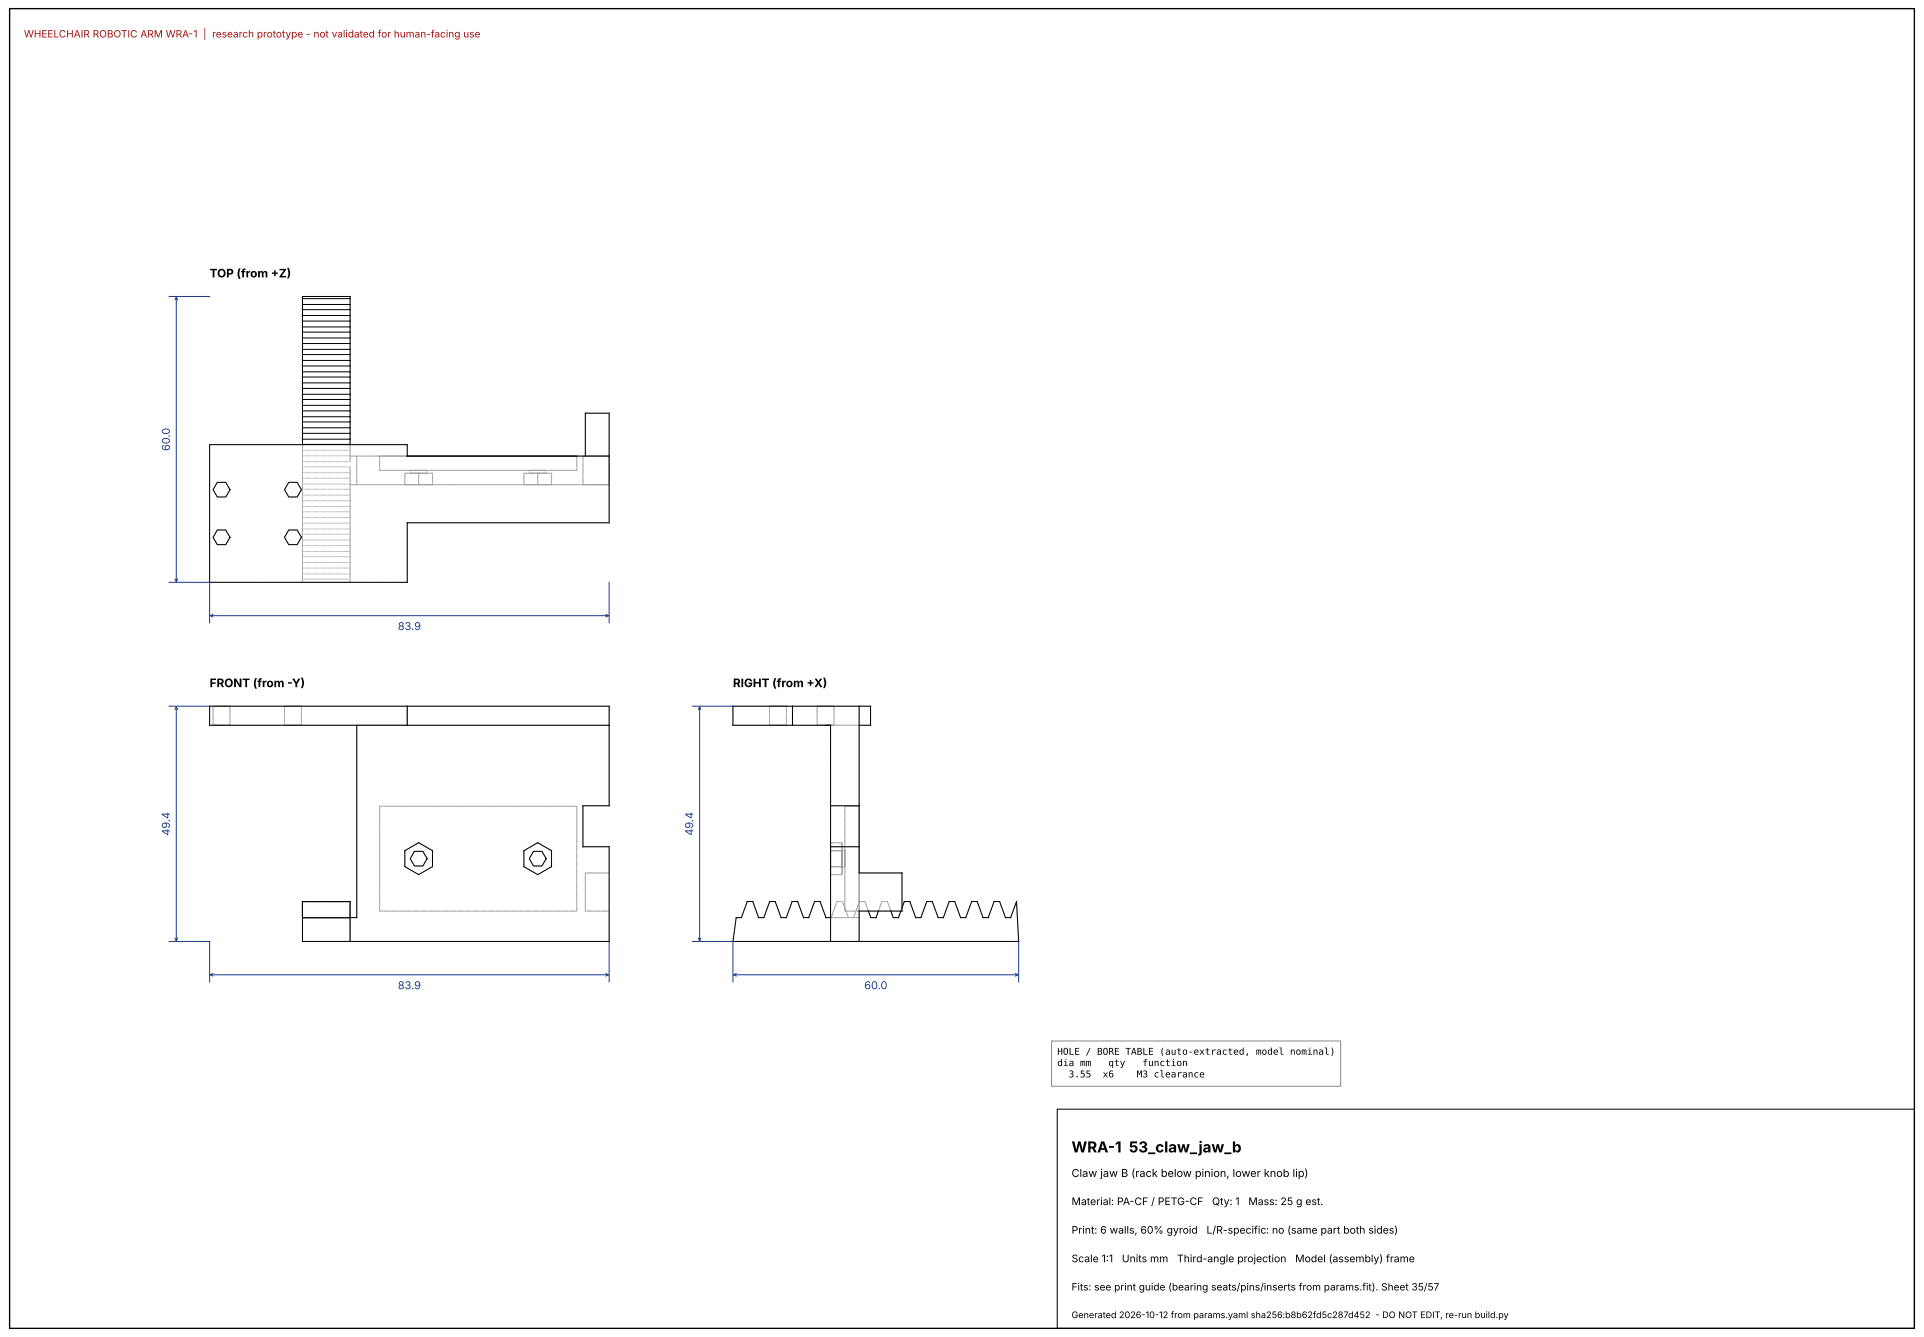
[picture p128: page 36]
FRONT (from -Y); TOP (from +Z); RIGHT (from +X); dia mm; qty; function; M3 clearance; WRA-1 53_claw_jaw_b

HOLE / BORE TABLE (auto-extracted, model nominal)

Claw jaw B (rack below pinion, lower knob lip)

Material: PA-CF / PETG-CF Qty: 1 Mass: 25 g est.

Print: 6 walls, 60% gyroid L/R-specific: no (same part both sides)

Fits: see print guide (bearing seats/pins/inserts from params.fit). Sheet 35/57

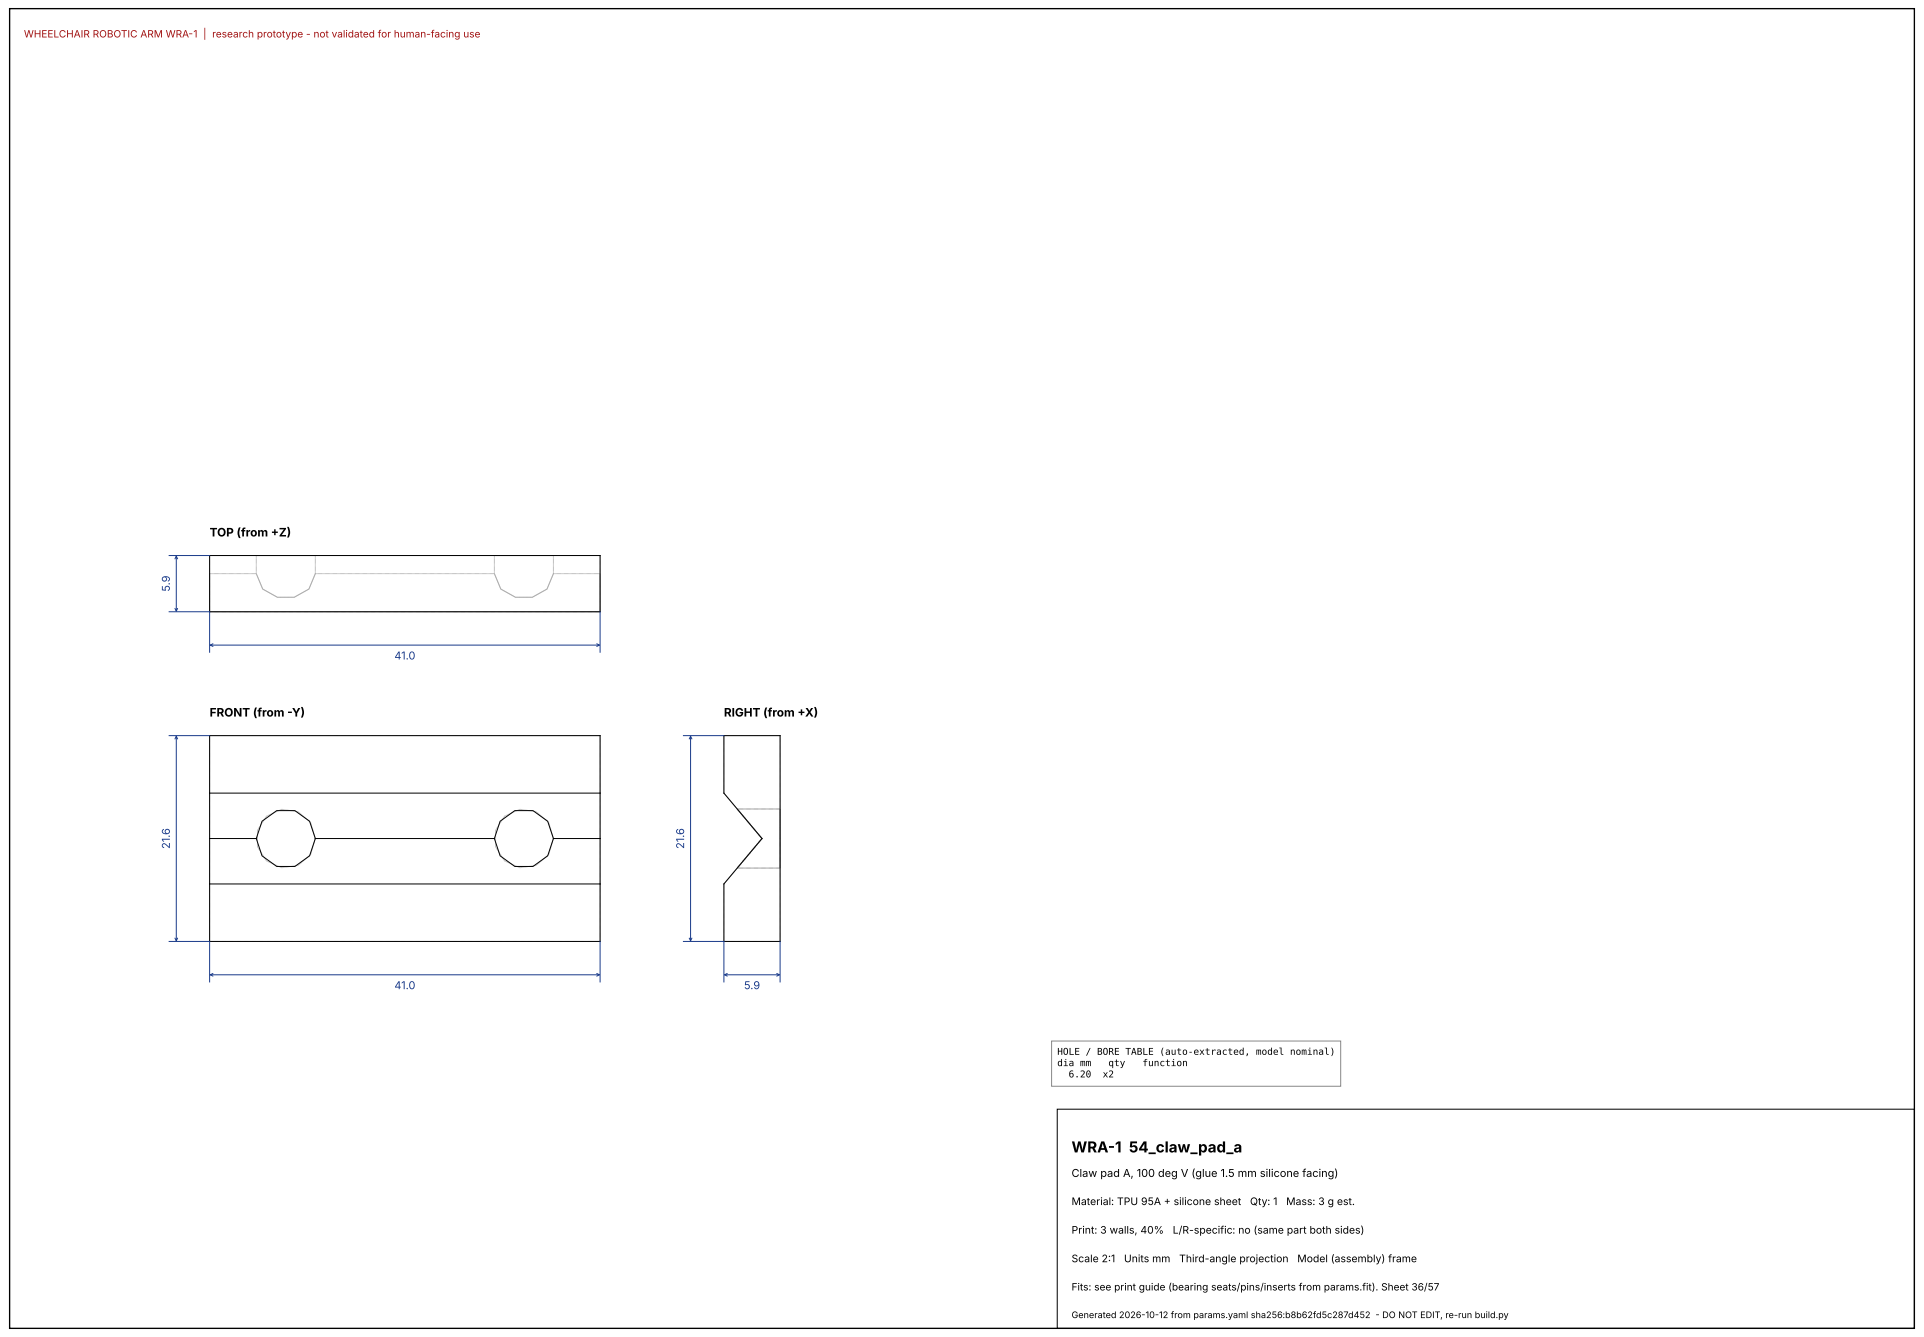
[picture p129: page 37]
FRONT (from -Y); TOP (from +Z); RIGHT (from +X); dia mm; qty; function; WRA-1 54_claw_pad_a

HOLE / BORE TABLE (auto-extracted, model nominal)

Claw pad A, 100 deg V (glue 1.5 mm silicone facing)

Material: TPU 95A + silicone sheet Qty: 1 Mass: 3 g est.

Print: 3 walls, 40% L/R-specific: no (same part both sides)

Scale 2:1 Units mm Third-angle projection Model (assembly) frame

Fits: see print guide (bearing seats/pins/inserts from params.fit). Sheet 36/57

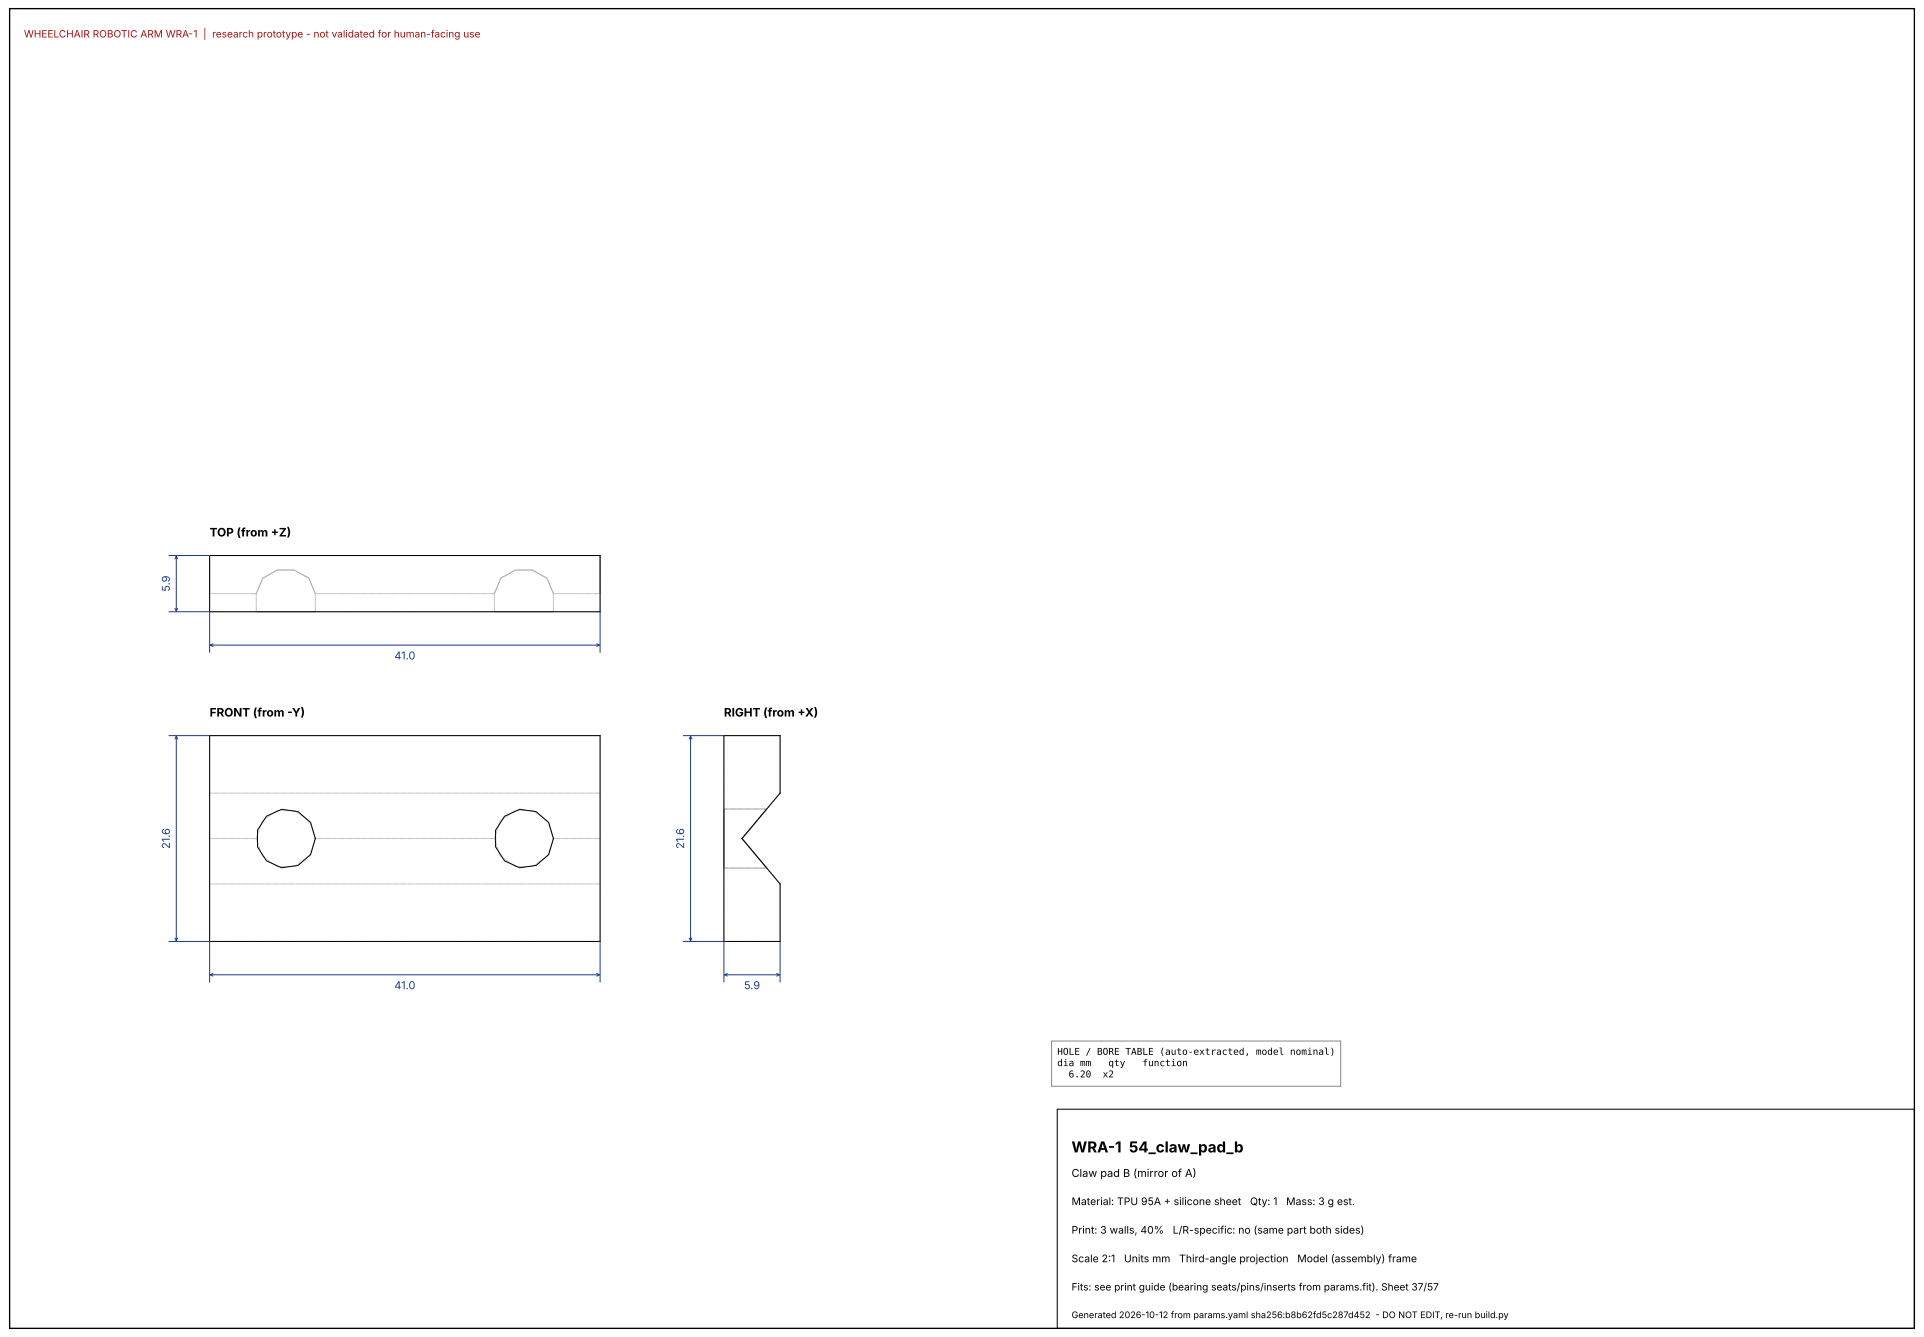
[picture p130: page 38]
FRONT (from -Y); TOP (from +Z); RIGHT (from +X); dia mm; qty; function; WRA-1 54_claw_pad_b

HOLE / BORE TABLE (auto-extracted, model nominal)

Claw pad B (mirror of A)

Material: TPU 95A + silicone sheet Qty: 1 Mass: 3 g est.

Print: 3 walls, 40% L/R-specific: no (same part both sides)

Scale 2:1 Units mm Third-angle projection Model (assembly) frame

Fits: see print guide (bearing seats/pins/inserts from params.fit). Sheet 37/57

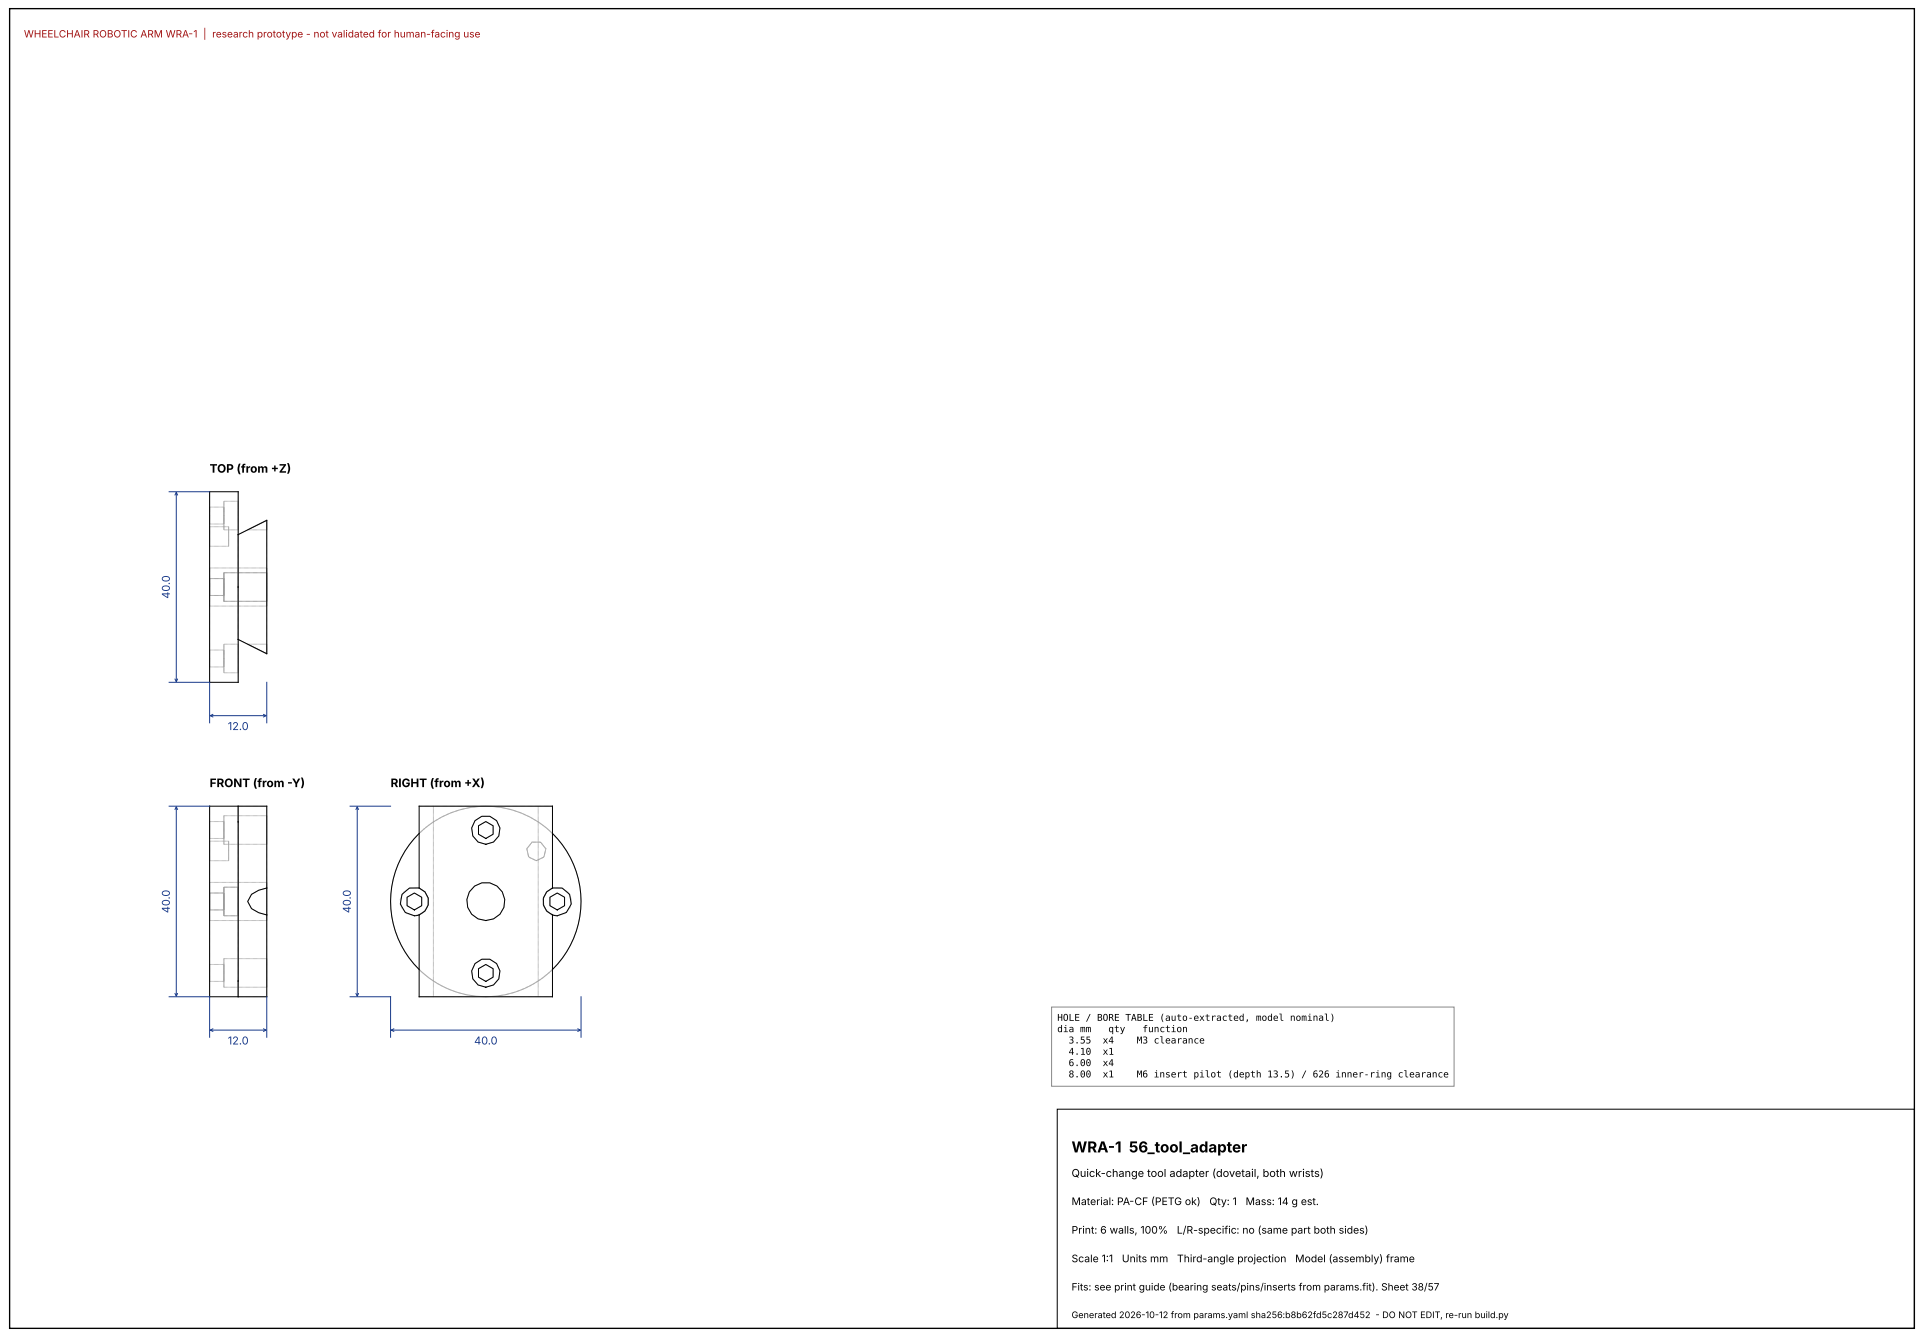
[picture p131: page 39]
FRONT (from -Y); TOP (from +Z); RIGHT (from +X); dia mm; qty; function; M3 clearance; M6 insert pilot (depth 13.5) / 626 inner-ring clearance; WRA-1 56_tool_adapter

HOLE / BORE TABLE (auto-extracted, model nominal)

Quick-change tool adapter (dovetail, both wrists)

Material: PA-CF (PETG ok) Qty: 1 Mass: 14 g est.

Print: 6 walls, 100% L/R-specific: no (same part both sides)

Fits: see print guide (bearing seats/pins/inserts from params.fit). Sheet 38/57

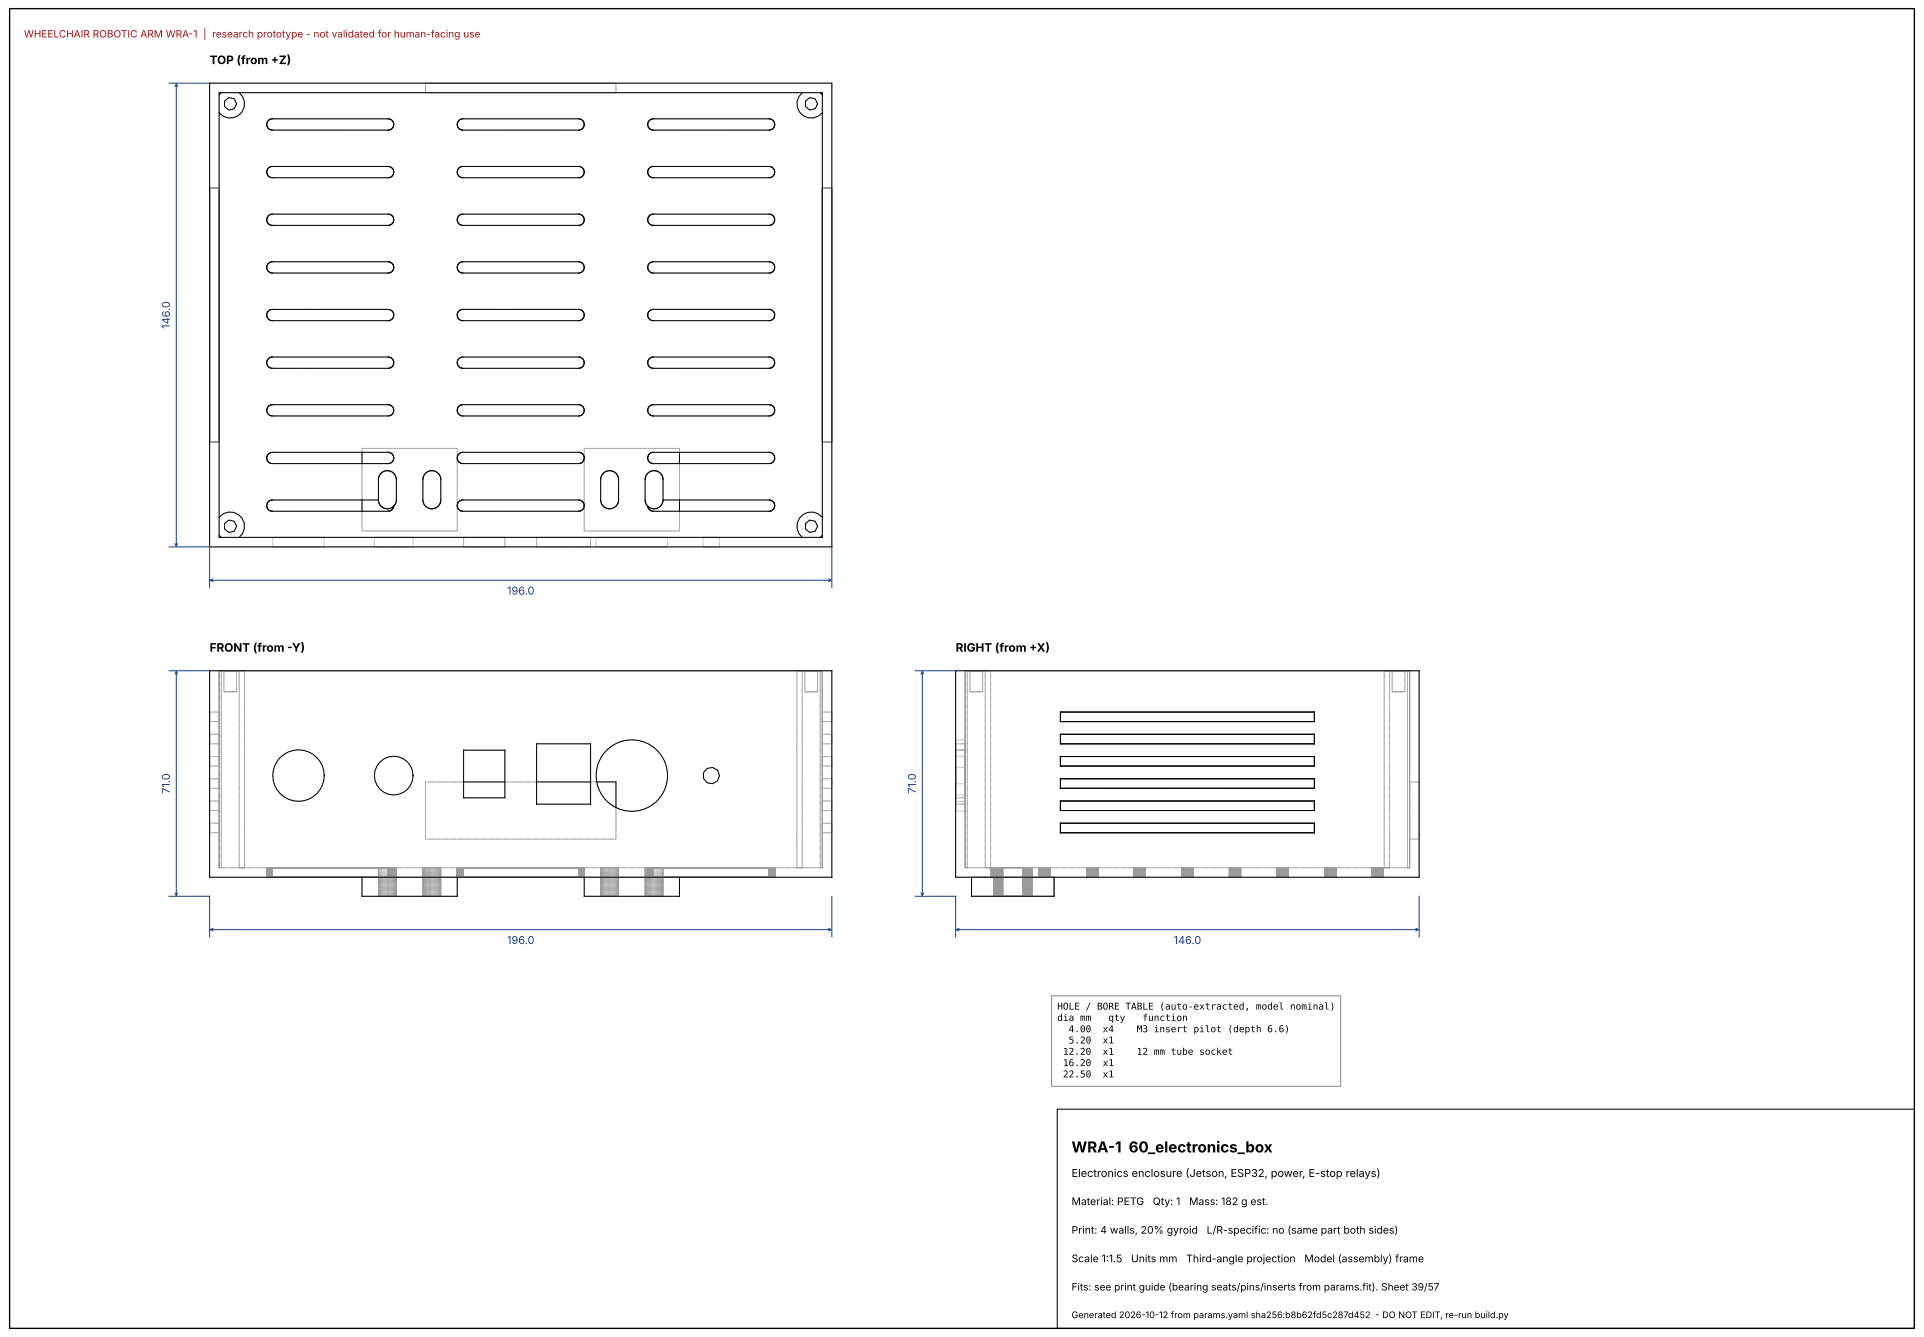
[picture p132: page 40]
FRONT (from -Y); TOP (from +Z); RIGHT (from +X); dia mm; qty; function; M3 insert pilot (depth 6.6); 12 mm tube socket; WRA-1 60_electronics_box

HOLE / BORE TABLE (auto-extracted, model nominal)

Electronics enclosure (Jetson, ESP32, power, E-stop relays)

Material: PETG Qty: 1 Mass: 182 g est.

Print: 4 walls, 20% gyroid L/R-specific: no (same part both sides)

Scale 1:1.5 Units mm Third-angle projection Model (assembly) frame

Fits: see print guide (bearing seats/pins/inserts from params.fit). Sheet 39/57

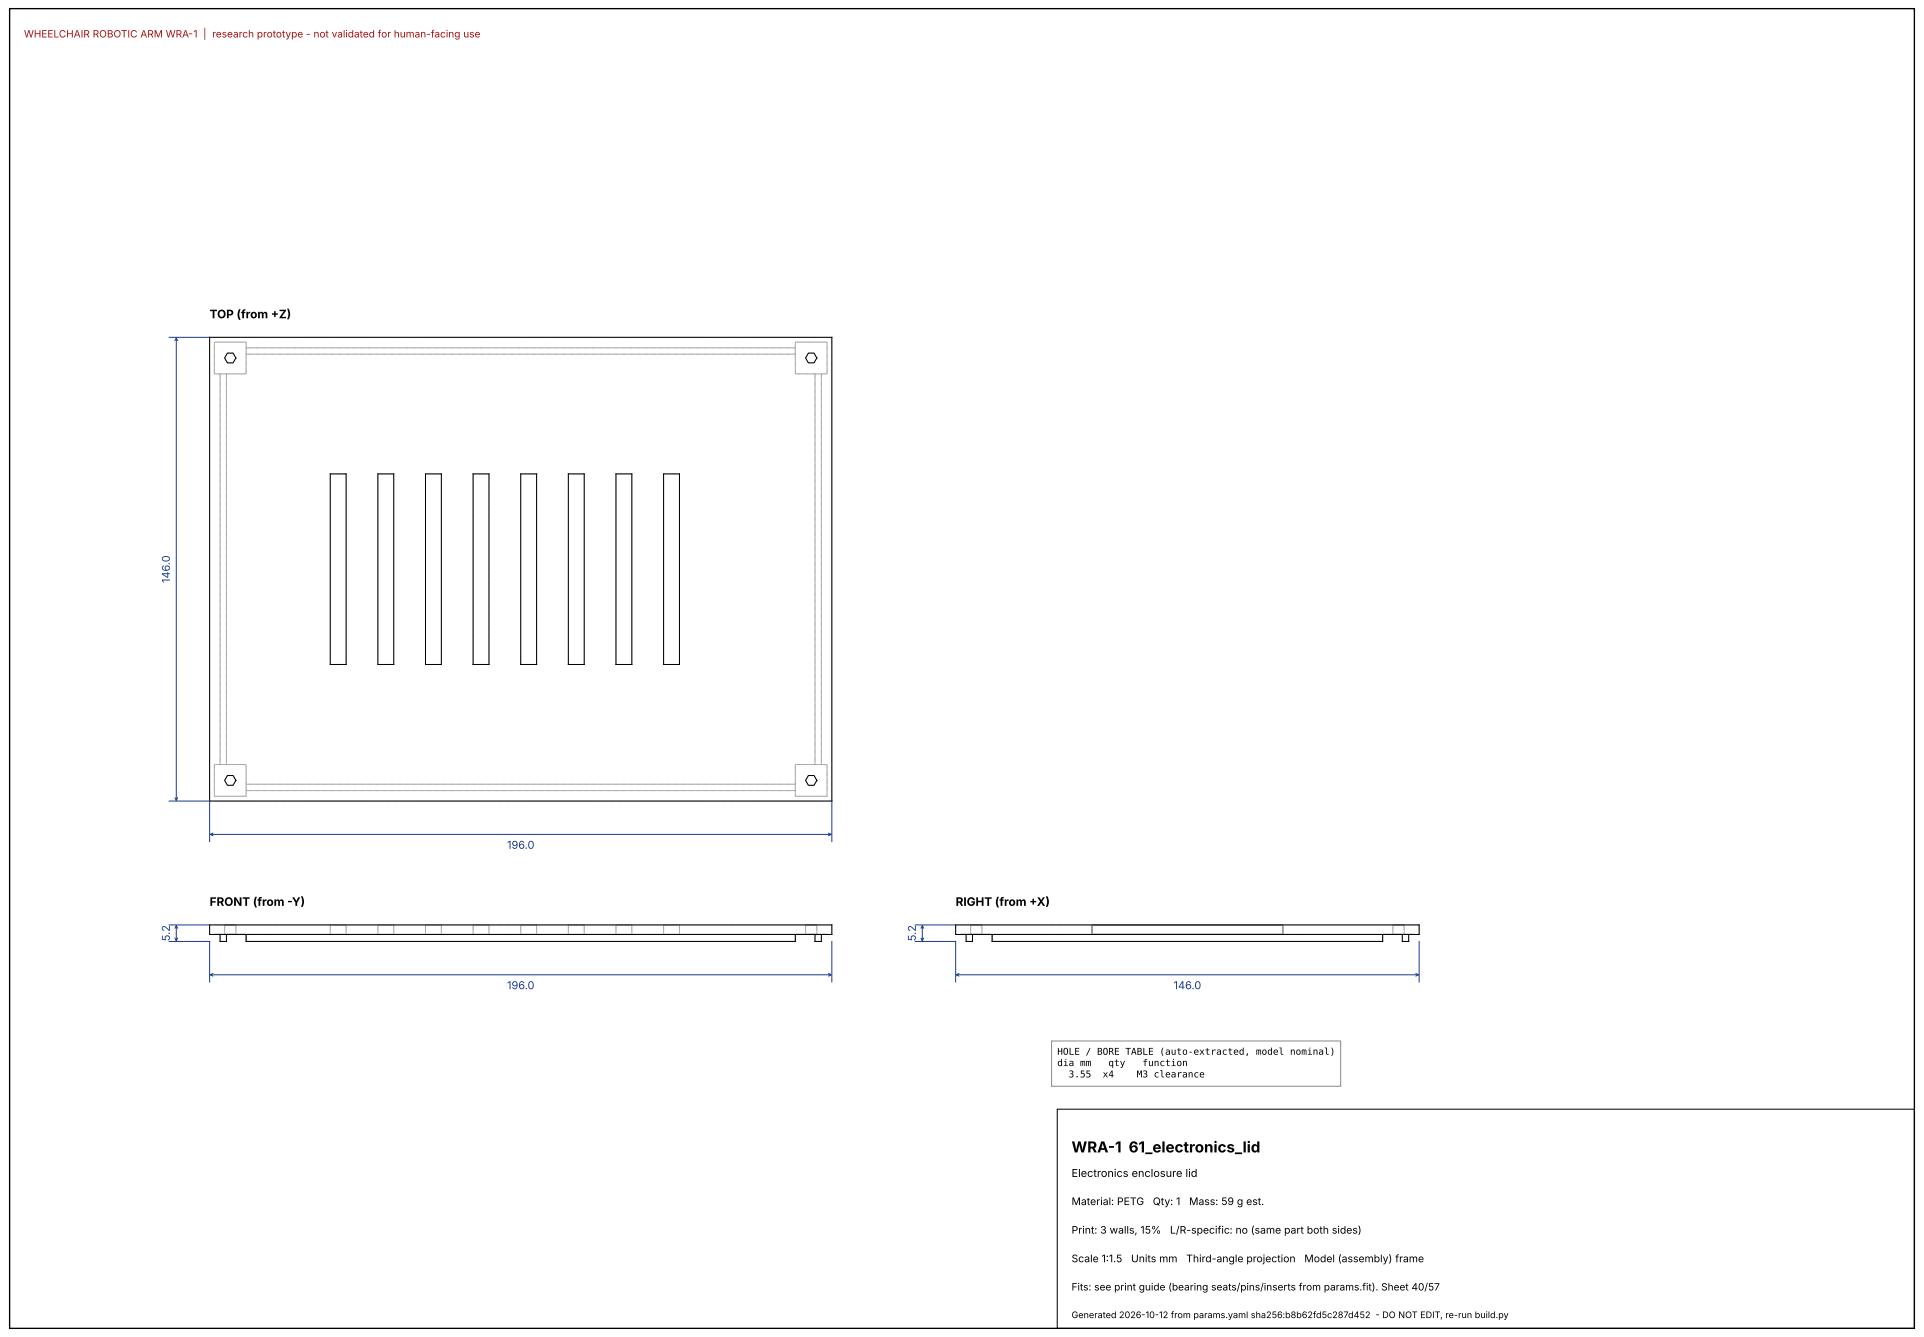
[picture p133: page 41]
FRONT (from -Y); TOP (from +Z); RIGHT (from +X); dia mm; qty; function; M3 clearance; WRA-1 61_electronics_lid

HOLE / BORE TABLE (auto-extracted, model nominal)

Electronics enclosure lid

Material: PETG Qty: 1 Mass: 59 g est.

Print: 3 walls, 15% L/R-specific: no (same part both sides)

Scale 1:1.5 Units mm Third-angle projection Model (assembly) frame

Fits: see print guide (bearing seats/pins/inserts from params.fit). Sheet 40/57

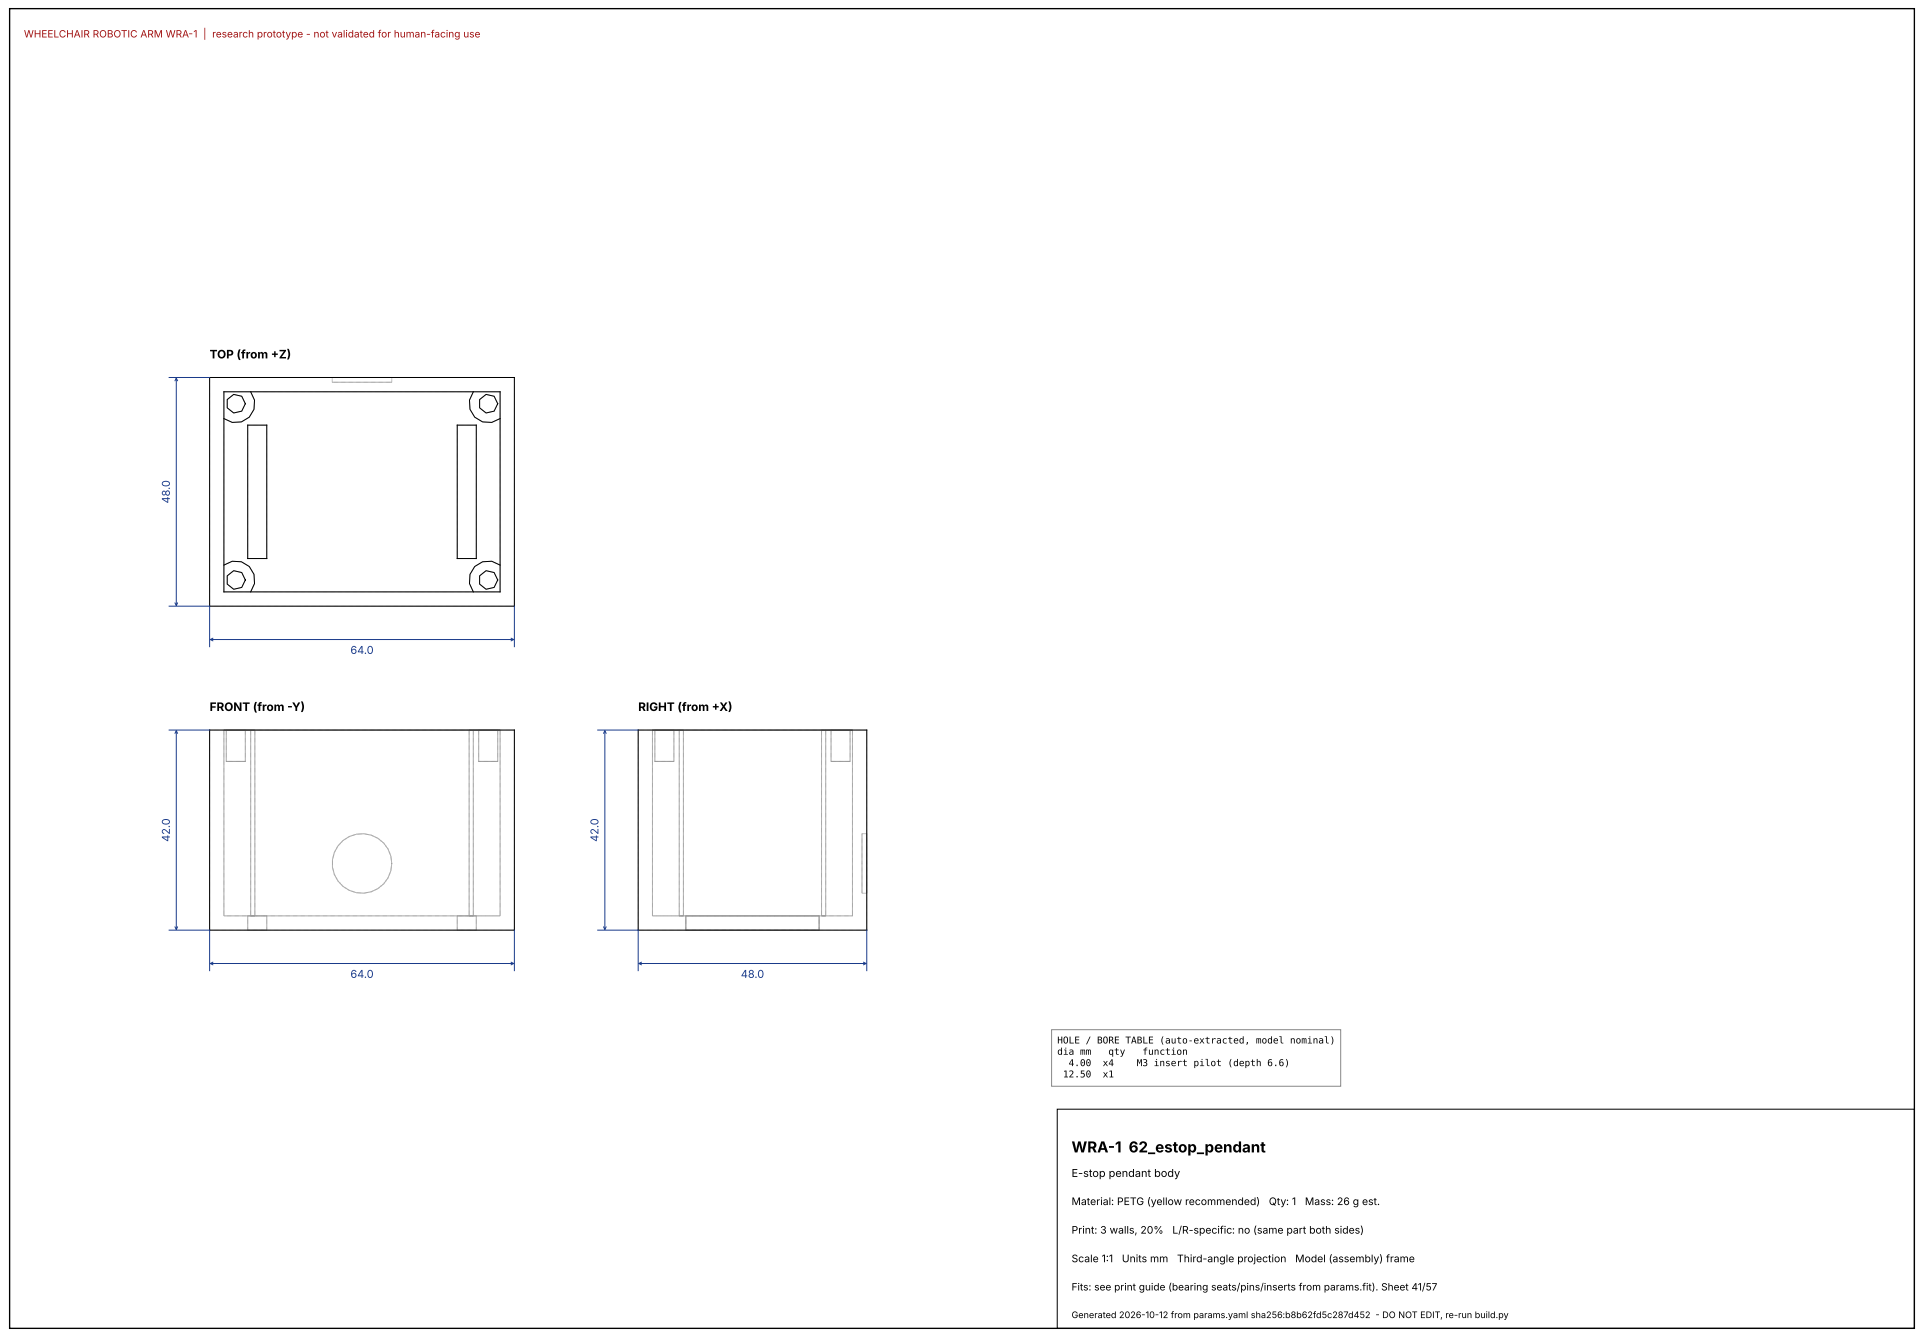
[picture p134: page 42]
FRONT (from -Y); TOP (from +Z); RIGHT (from +X); dia mm; qty; function; M3 insert pilot (depth 6.6); WRA-1 62_estop_pendant

HOLE / BORE TABLE (auto-extracted, model nominal)

E-stop pendant body

Material: PETG (yellow recommended) Qty: 1 Mass: 26 g est.

Print: 3 walls, 20% L/R-specific: no (same part both sides)

Fits: see print guide (bearing seats/pins/inserts from params.fit). Sheet 41/57

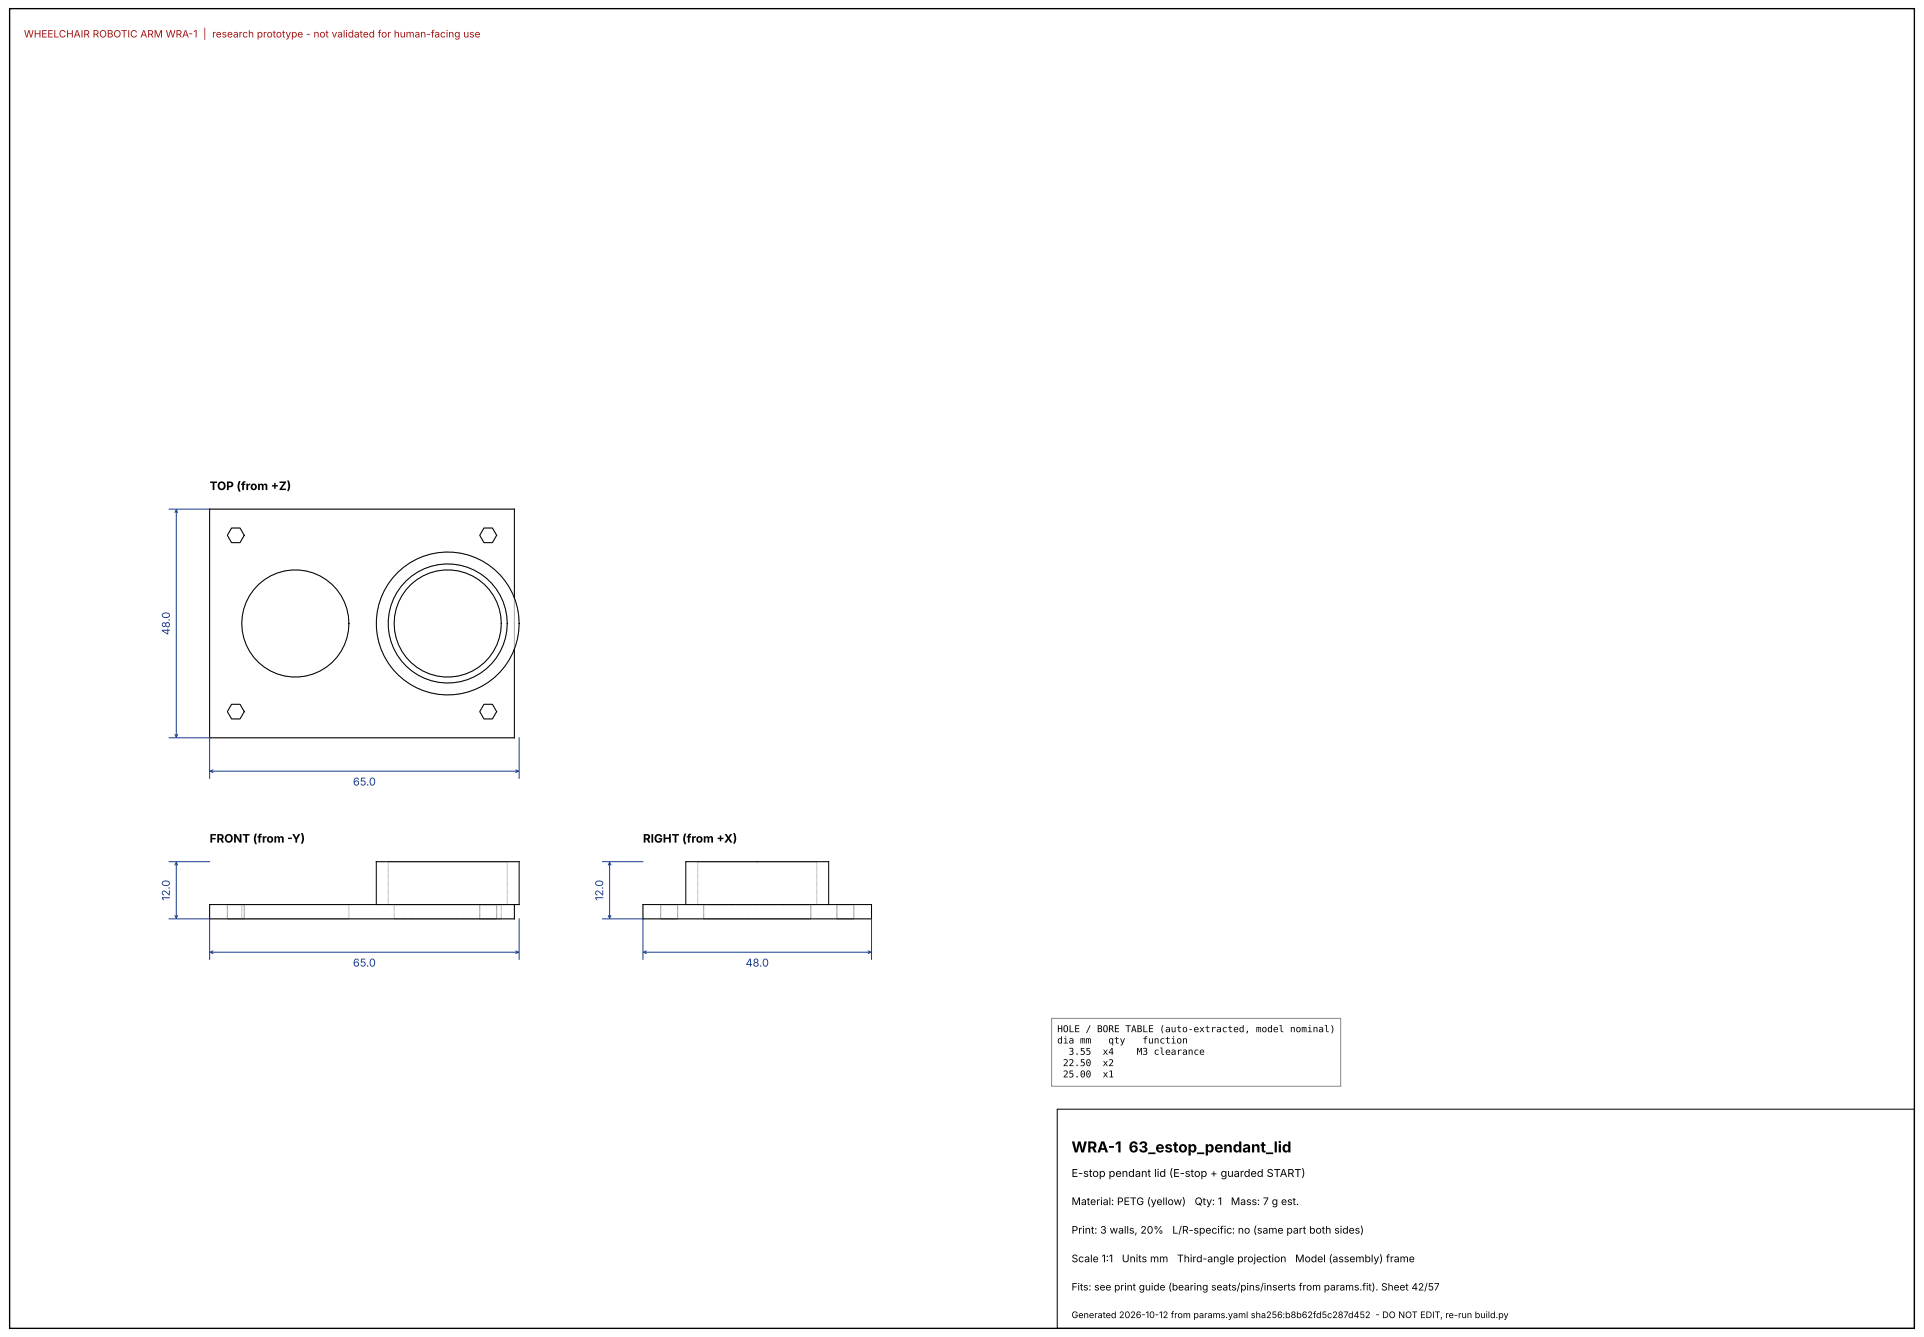
[picture p135: page 43]
FRONT (from -Y); TOP (from +Z); RIGHT (from +X); dia mm; qty; function; M3 clearance; WRA-1 63_estop_pendant_lid

HOLE / BORE TABLE (auto-extracted, model nominal)

E-stop pendant lid (E-stop + guarded START)

Material: PETG (yellow) Qty: 1 Mass: 7 g est.

Print: 3 walls, 20% L/R-specific: no (same part both sides)

Fits: see print guide (bearing seats/pins/inserts from params.fit). Sheet 42/57

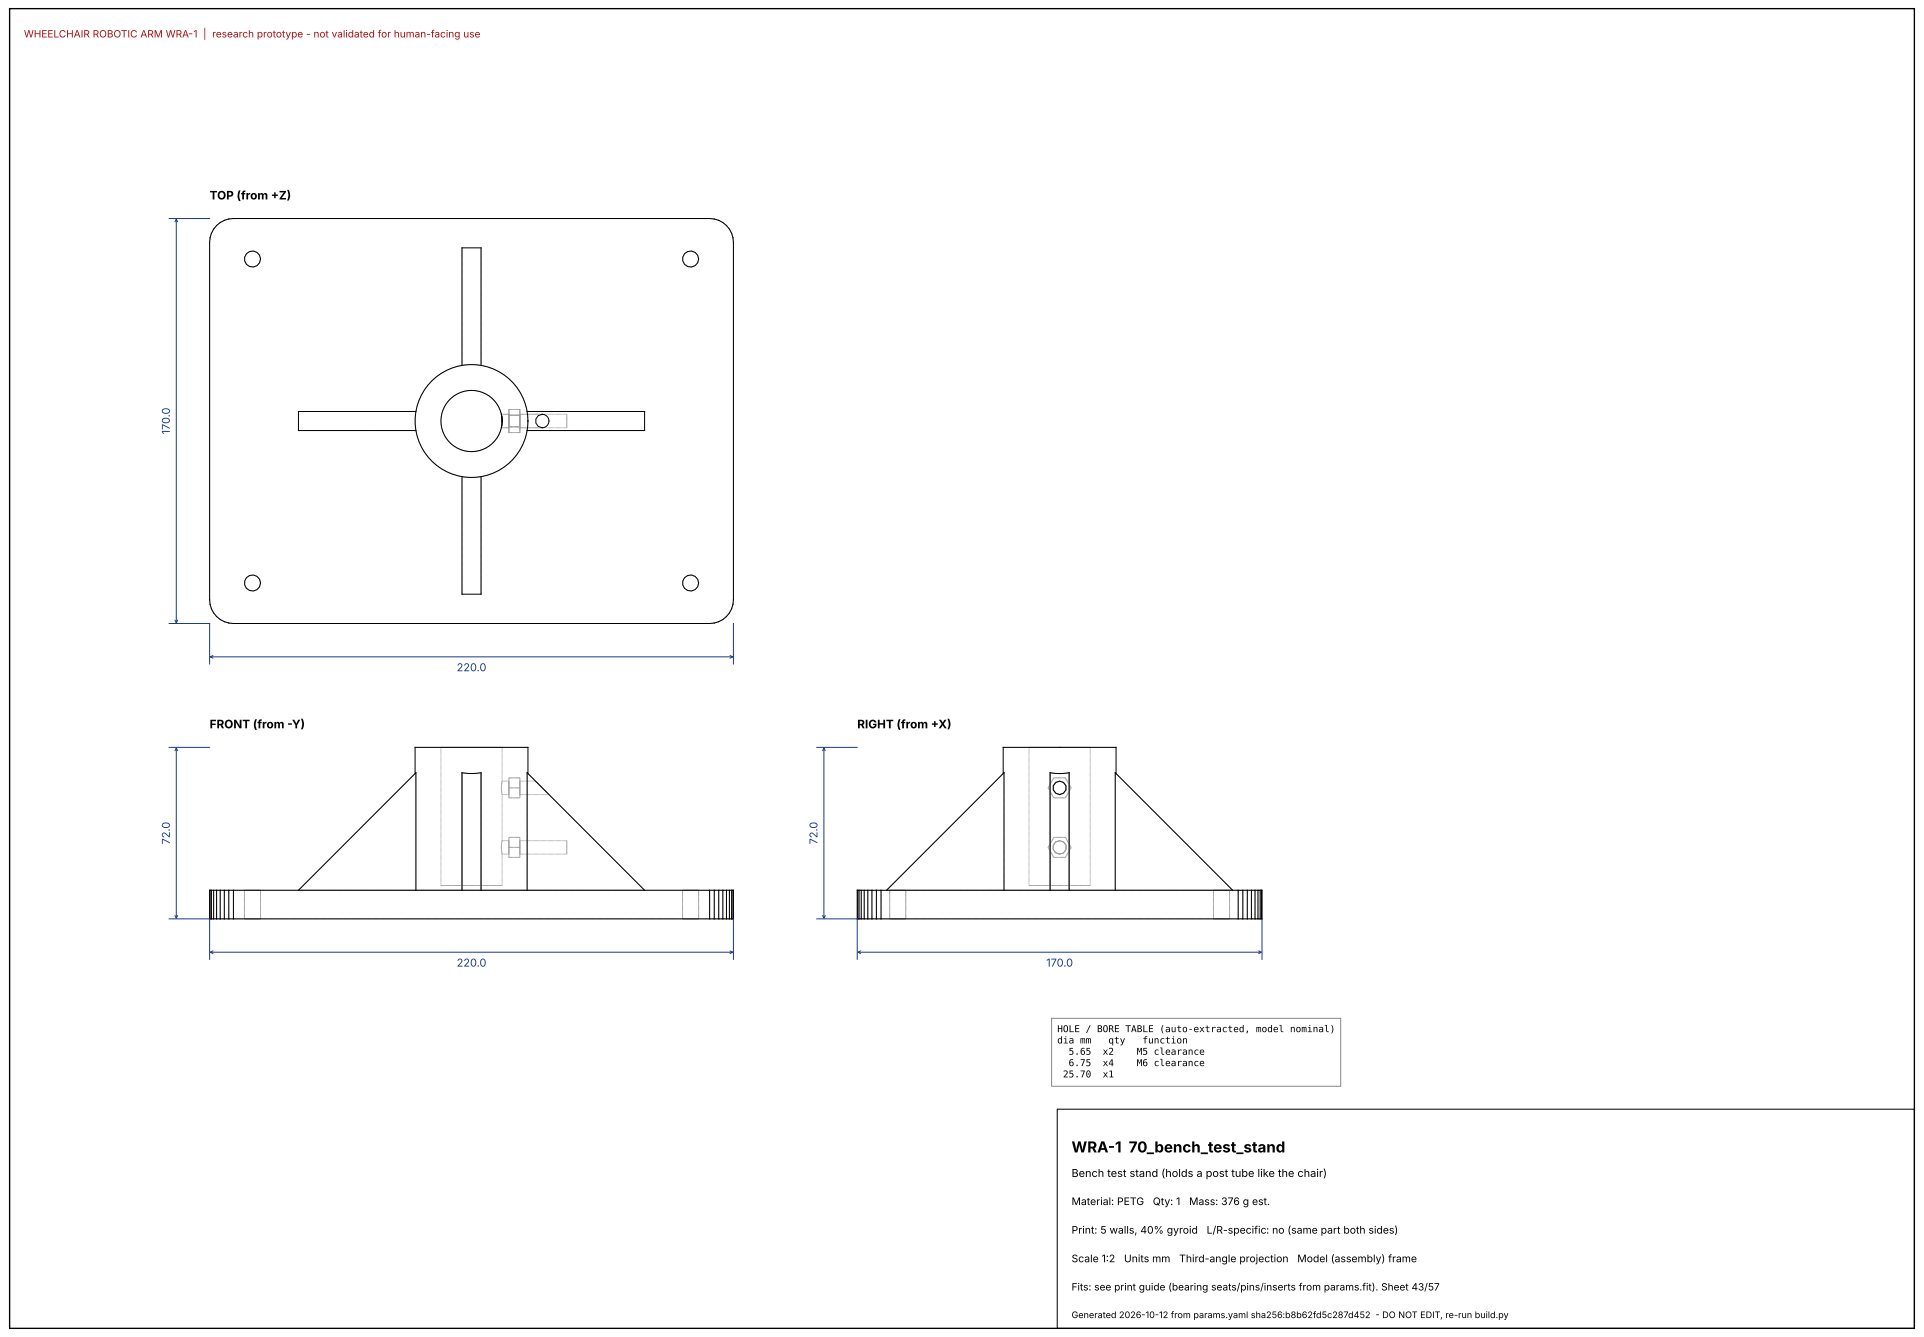
[picture p136: page 44]
FRONT (from -Y); TOP (from +Z); RIGHT (from +X); dia mm; qty; function; M5 clearance; M6 clearance; WRA-1 70_bench_test_stand

HOLE / BORE TABLE (auto-extracted, model nominal)

Bench test stand (holds a post tube like the chair)

Material: PETG Qty: 1 Mass: 376 g est.

Print: 5 walls, 40% gyroid L/R-specific: no (same part both sides)

Scale 1:2 Units mm Third-angle projection Model (assembly) frame

Fits: see print guide (bearing seats/pins/inserts from params.fit). Sheet 43/57

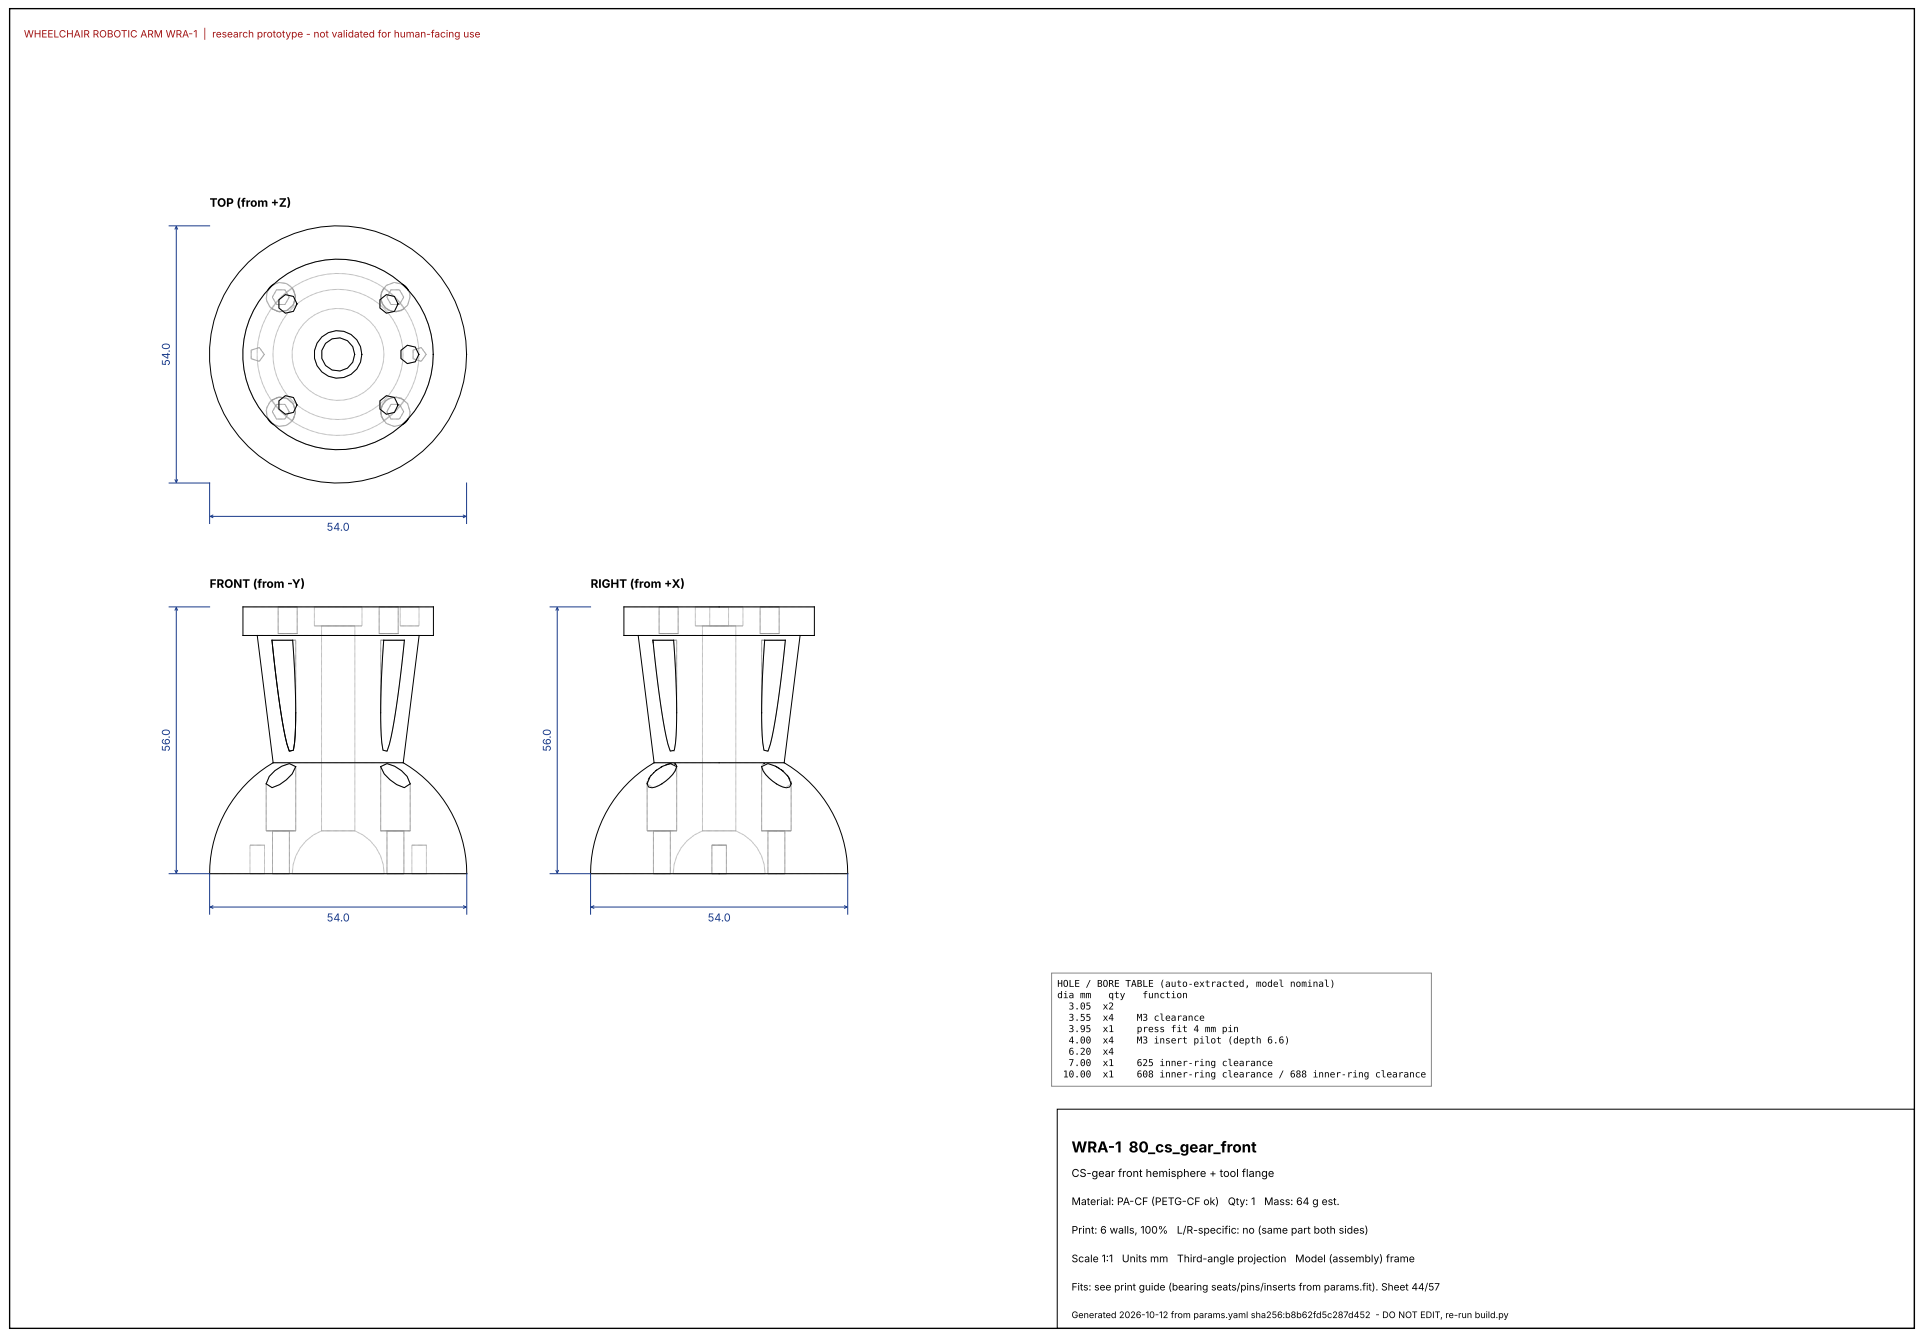
[picture p137: page 45]
FRONT (from -Y); TOP (from +Z); RIGHT (from +X); dia mm; qty; function; M3 clearance; press fit 4 mm pin; M3 insert pilot (depth 6.6); 625 inner-ring clearance; 608 inner-ring clearance / 688 inner-ring clearance; WRA-1 80_cs_gear_front

HOLE / BORE TABLE (auto-extracted, model nominal)

CS-gear front hemisphere + tool flange

Material: PA-CF (PETG-CF ok) Qty: 1 Mass: 64 g est.

Print: 6 walls, 100% L/R-specific: no (same part both sides)

Fits: see print guide (bearing seats/pins/inserts from params.fit). Sheet 44/57

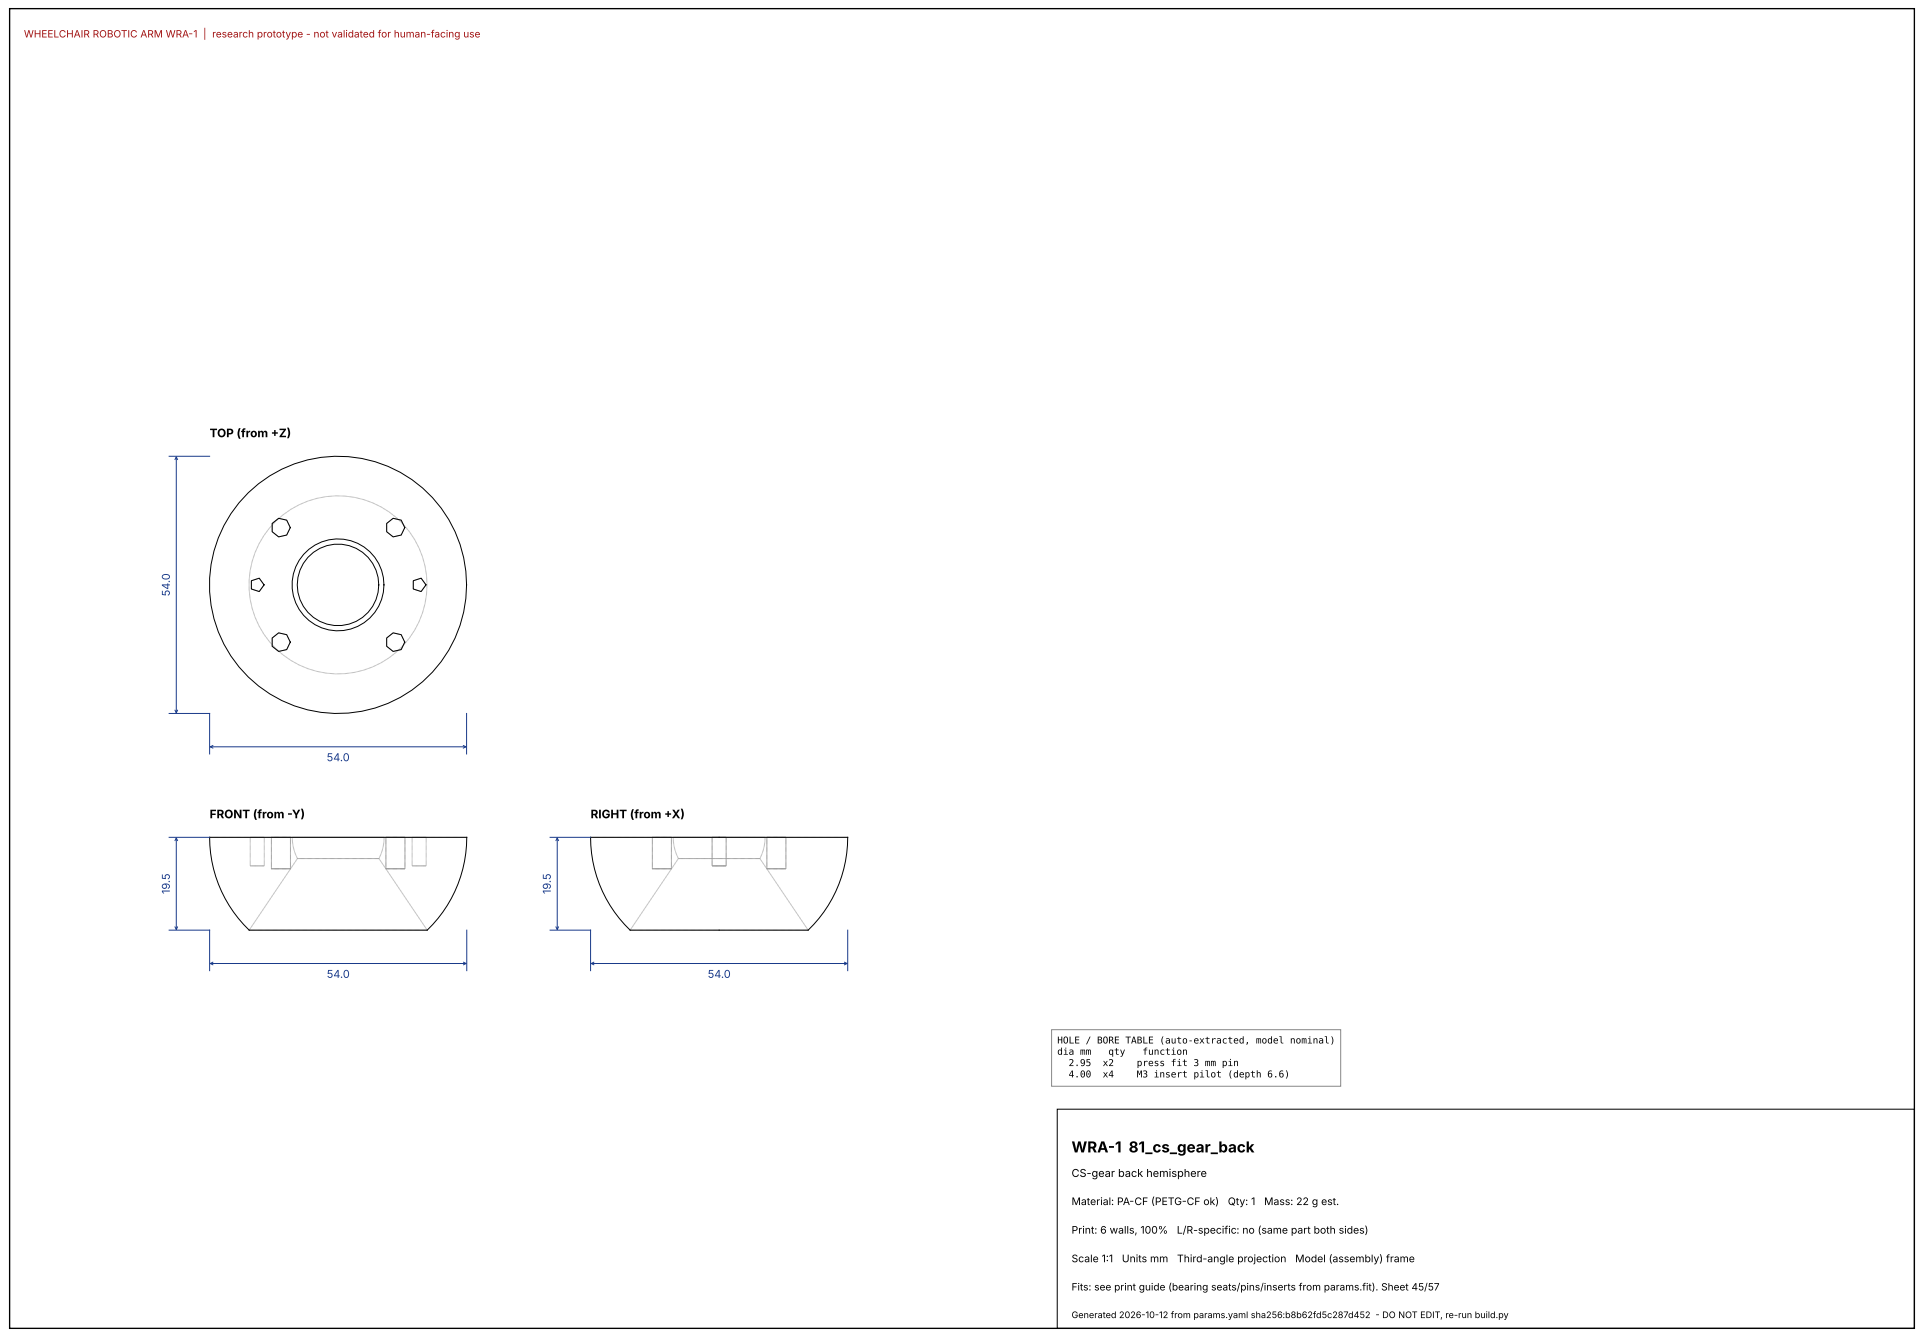
[picture p138: page 46]
FRONT (from -Y); TOP (from +Z); RIGHT (from +X); dia mm; qty; function; press fit 3 mm pin; M3 insert pilot (depth 6.6); WRA-1 81_cs_gear_back

HOLE / BORE TABLE (auto-extracted, model nominal)

CS-gear back hemisphere

Material: PA-CF (PETG-CF ok) Qty: 1 Mass: 22 g est.

Print: 6 walls, 100% L/R-specific: no (same part both sides)

Fits: see print guide (bearing seats/pins/inserts from params.fit). Sheet 45/57

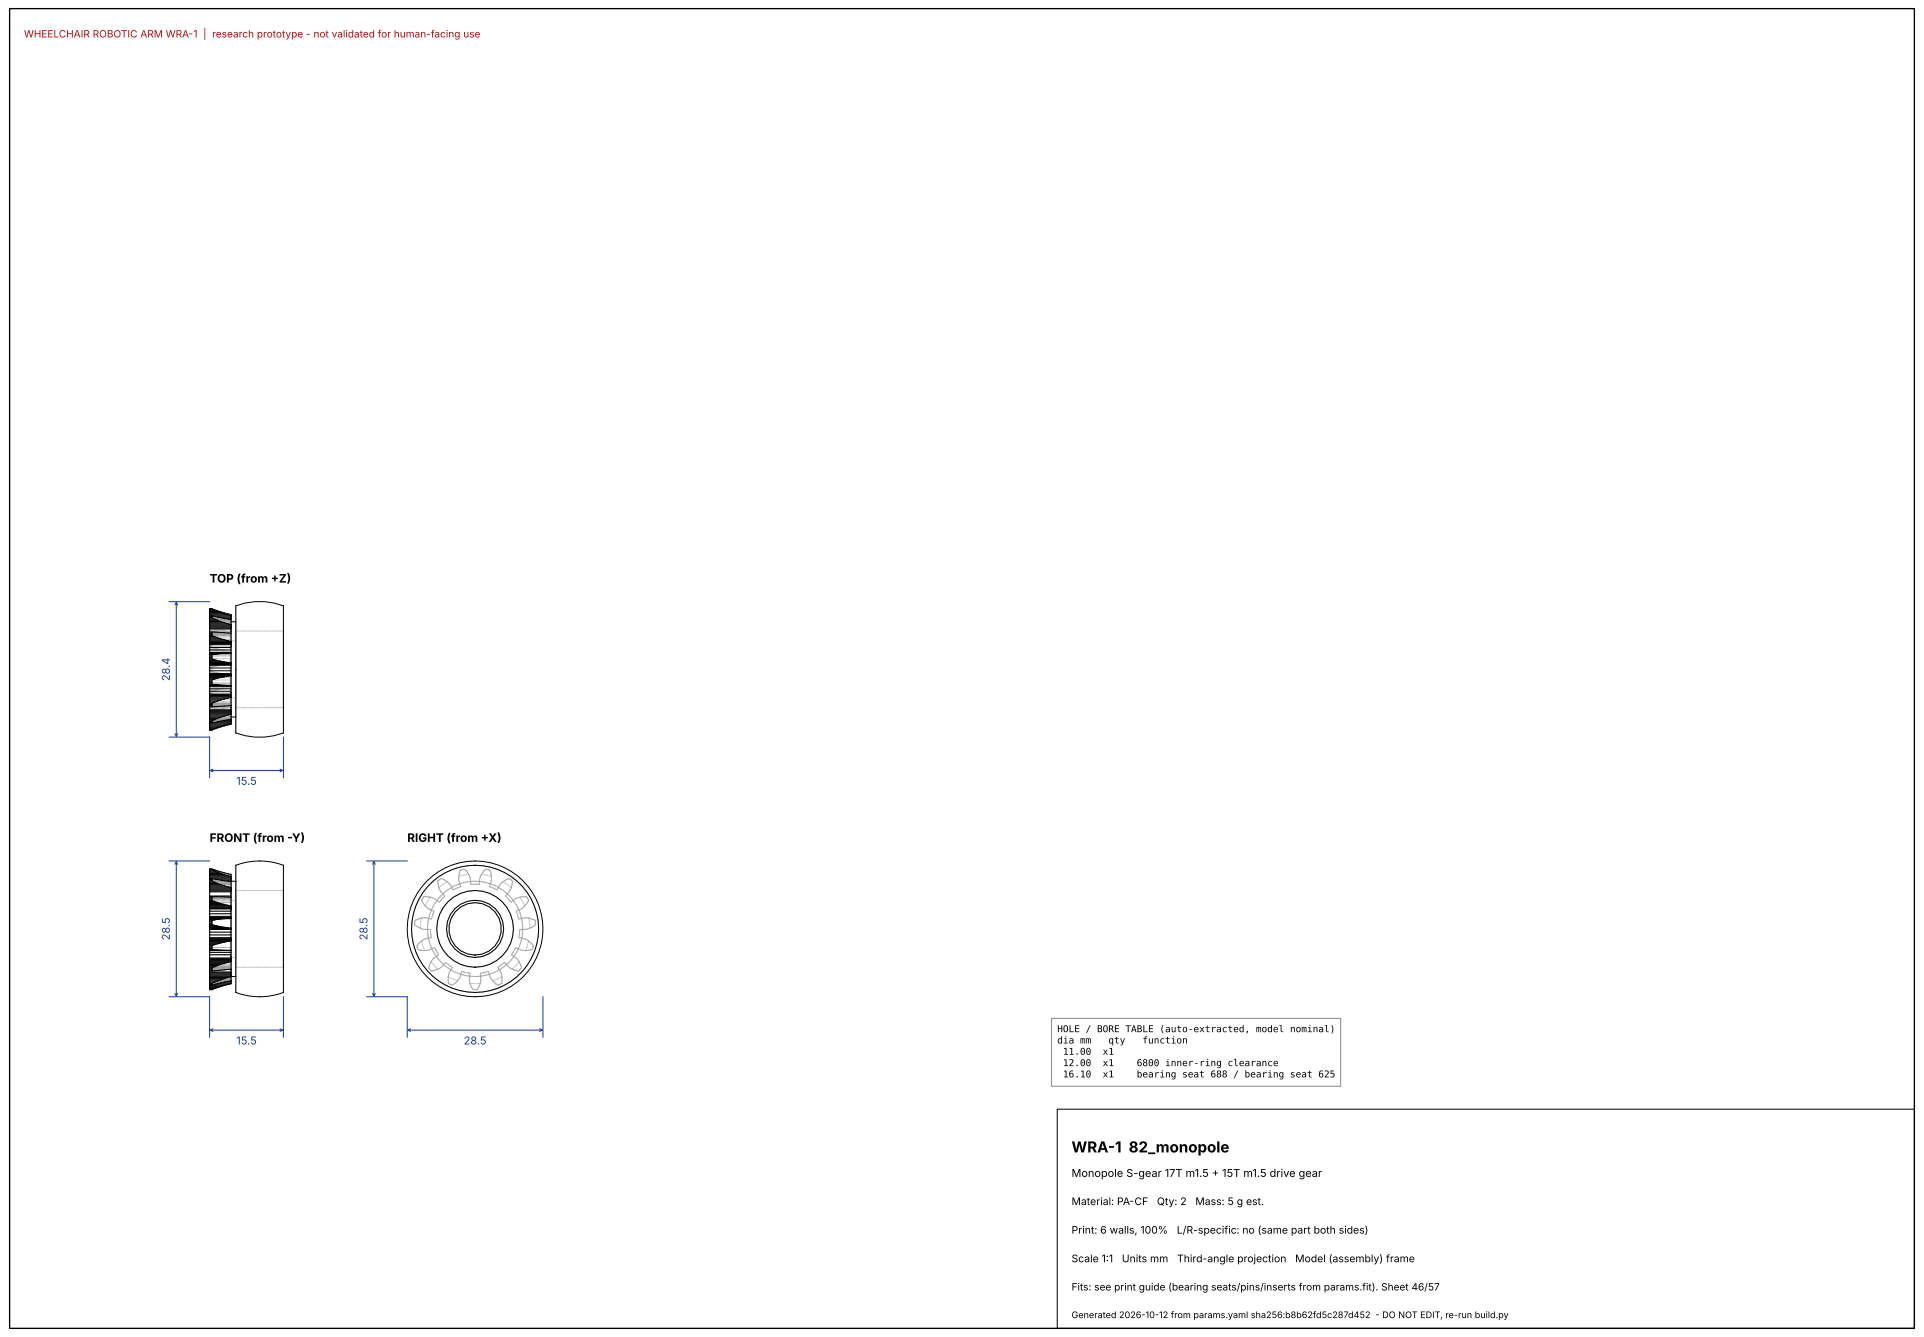
[picture p139: page 47]
FRONT (from -Y); TOP (from +Z); RIGHT (from +X); dia mm; qty; function; 6800 inner-ring clearance; bearing seat 688 / bearing seat 625; WRA-1 82_monopole

HOLE / BORE TABLE (auto-extracted, model nominal)

Monopole S-gear 17T m1.5 + 15T m1.5 drive gear

Material: PA-CF Qty: 2 Mass: 5 g est.

Print: 6 walls, 100% L/R-specific: no (same part both sides)

Fits: see print guide (bearing seats/pins/inserts from params.fit). Sheet 46/57

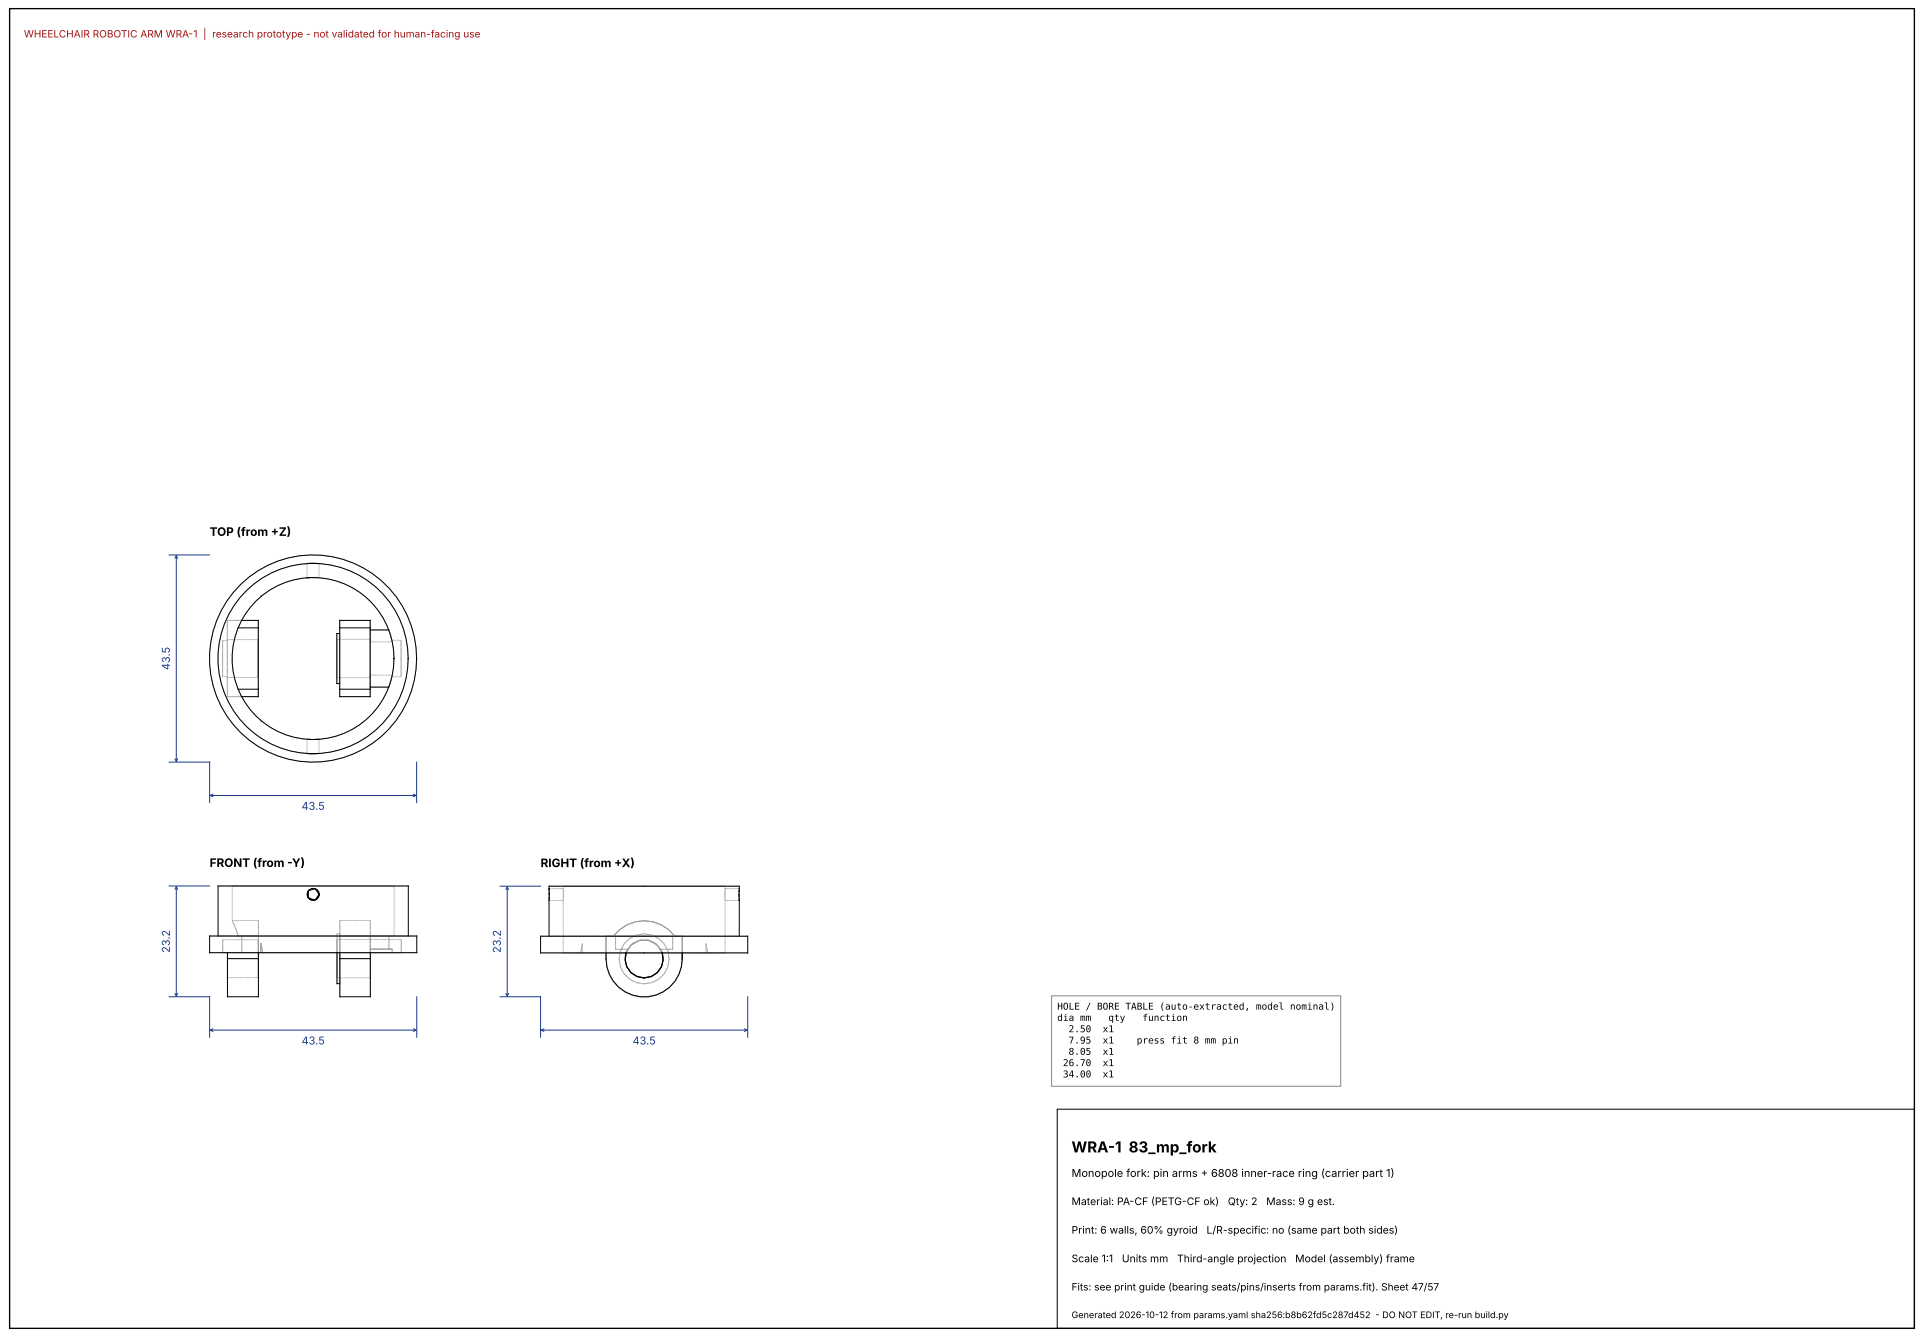
[picture p140: page 48]
FRONT (from -Y); TOP (from +Z); RIGHT (from +X); dia mm; qty; function; press fit 8 mm pin; WRA-1 83_mp_fork

HOLE / BORE TABLE (auto-extracted, model nominal)

Monopole fork: pin arms + 6808 inner-race ring (carrier part 1)

Material: PA-CF (PETG-CF ok) Qty: 2 Mass: 9 g est.

Print: 6 walls, 60% gyroid L/R-specific: no (same part both sides)

Fits: see print guide (bearing seats/pins/inserts from params.fit). Sheet 47/57

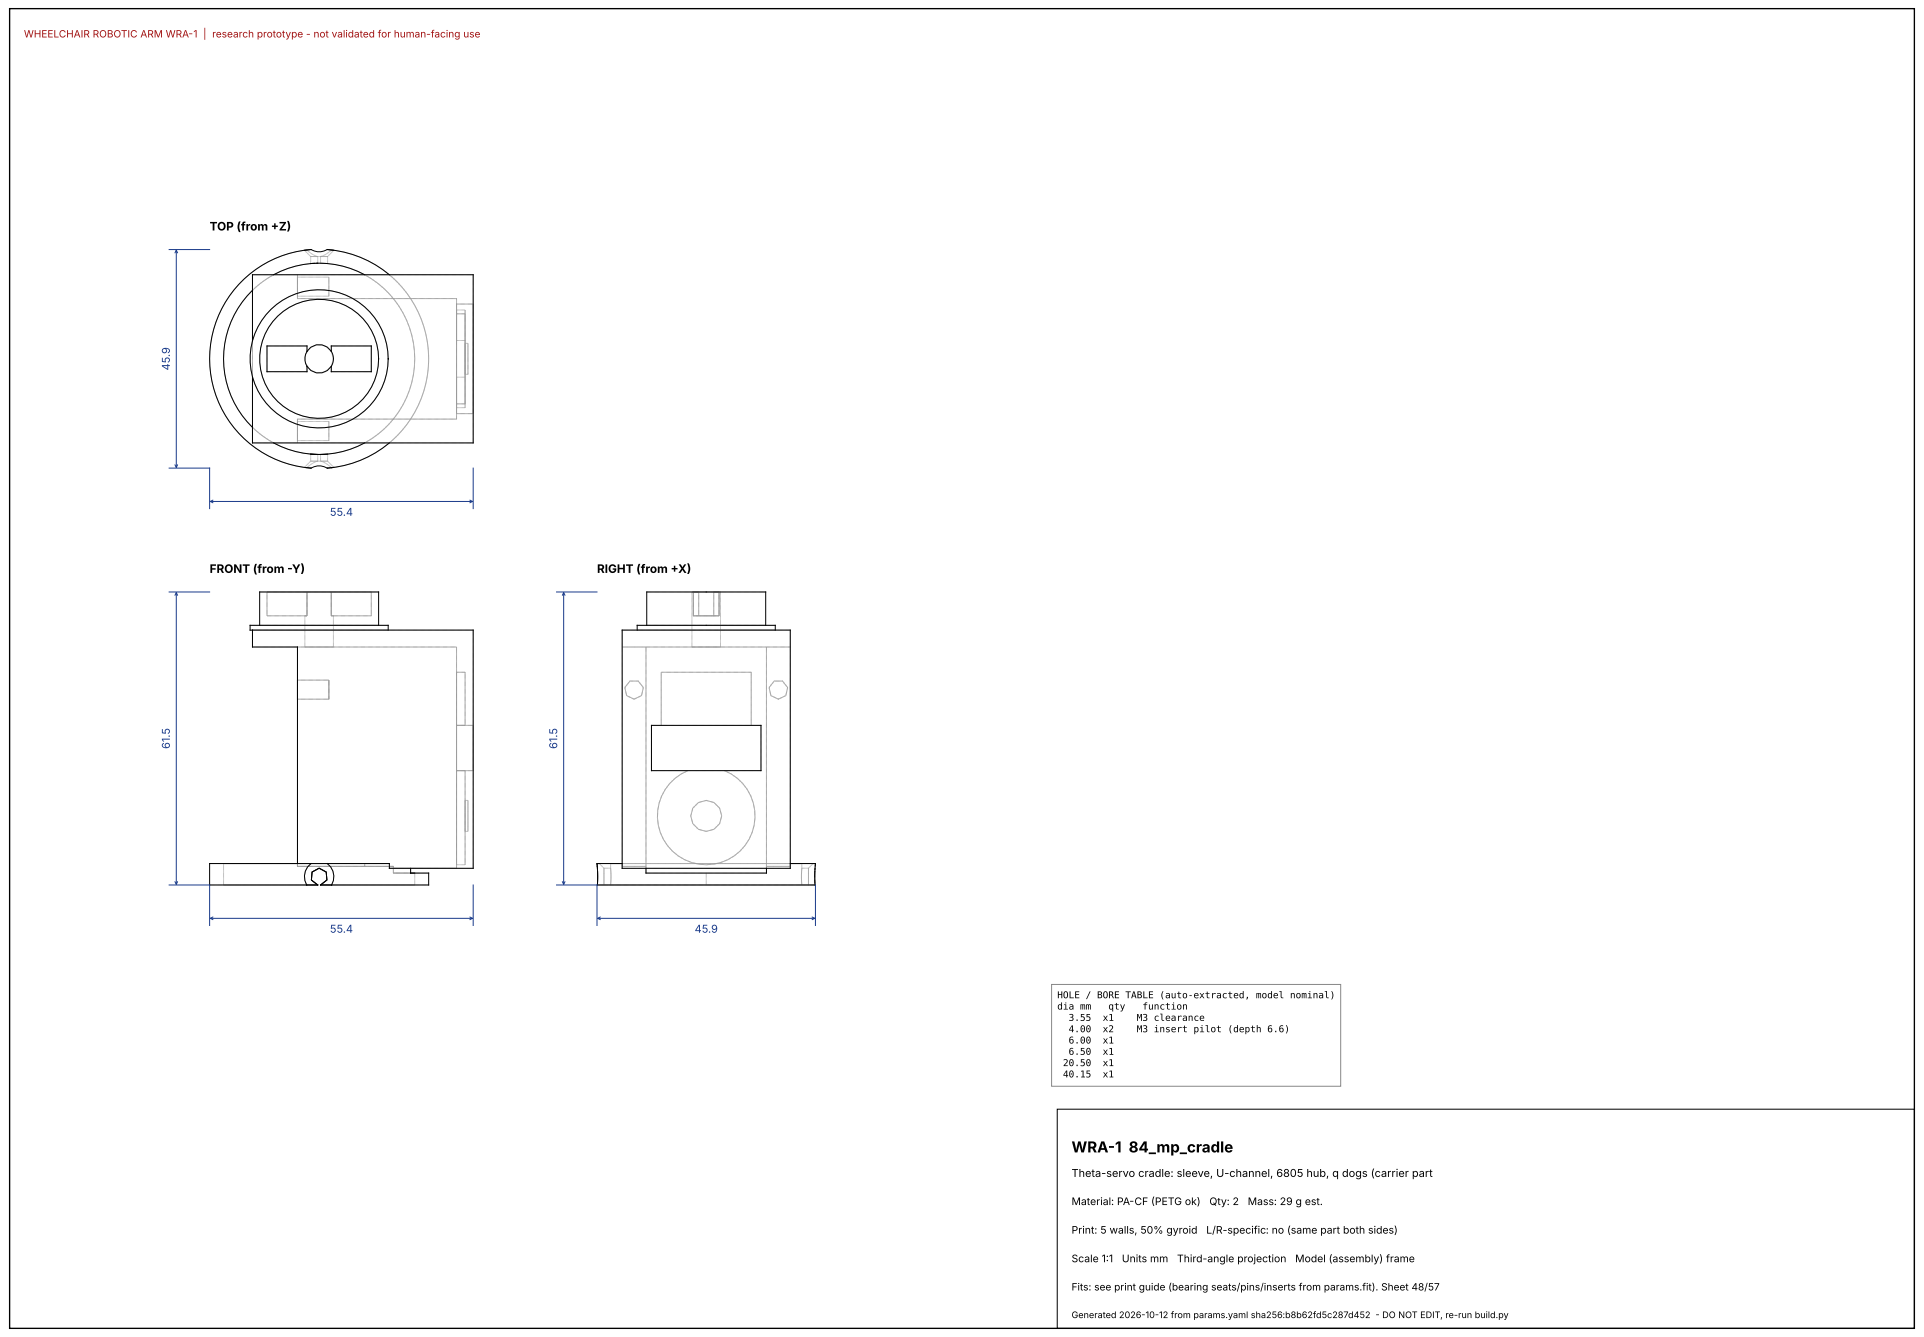
[picture p141: page 49]
FRONT (from -Y); TOP (from +Z); RIGHT (from +X); dia mm; qty; function; M3 clearance; M3 insert pilot (depth 6.6); WRA-1 84_mp_cradle

HOLE / BORE TABLE (auto-extracted, model nominal)

Theta-servo cradle: sleeve, U-channel, 6805 hub, q dogs (carrier part

Material: PA-CF (PETG ok) Qty: 2 Mass: 29 g est.

Print: 5 walls, 50% gyroid L/R-specific: no (same part both sides)

Fits: see print guide (bearing seats/pins/inserts from params.fit). Sheet 48/57

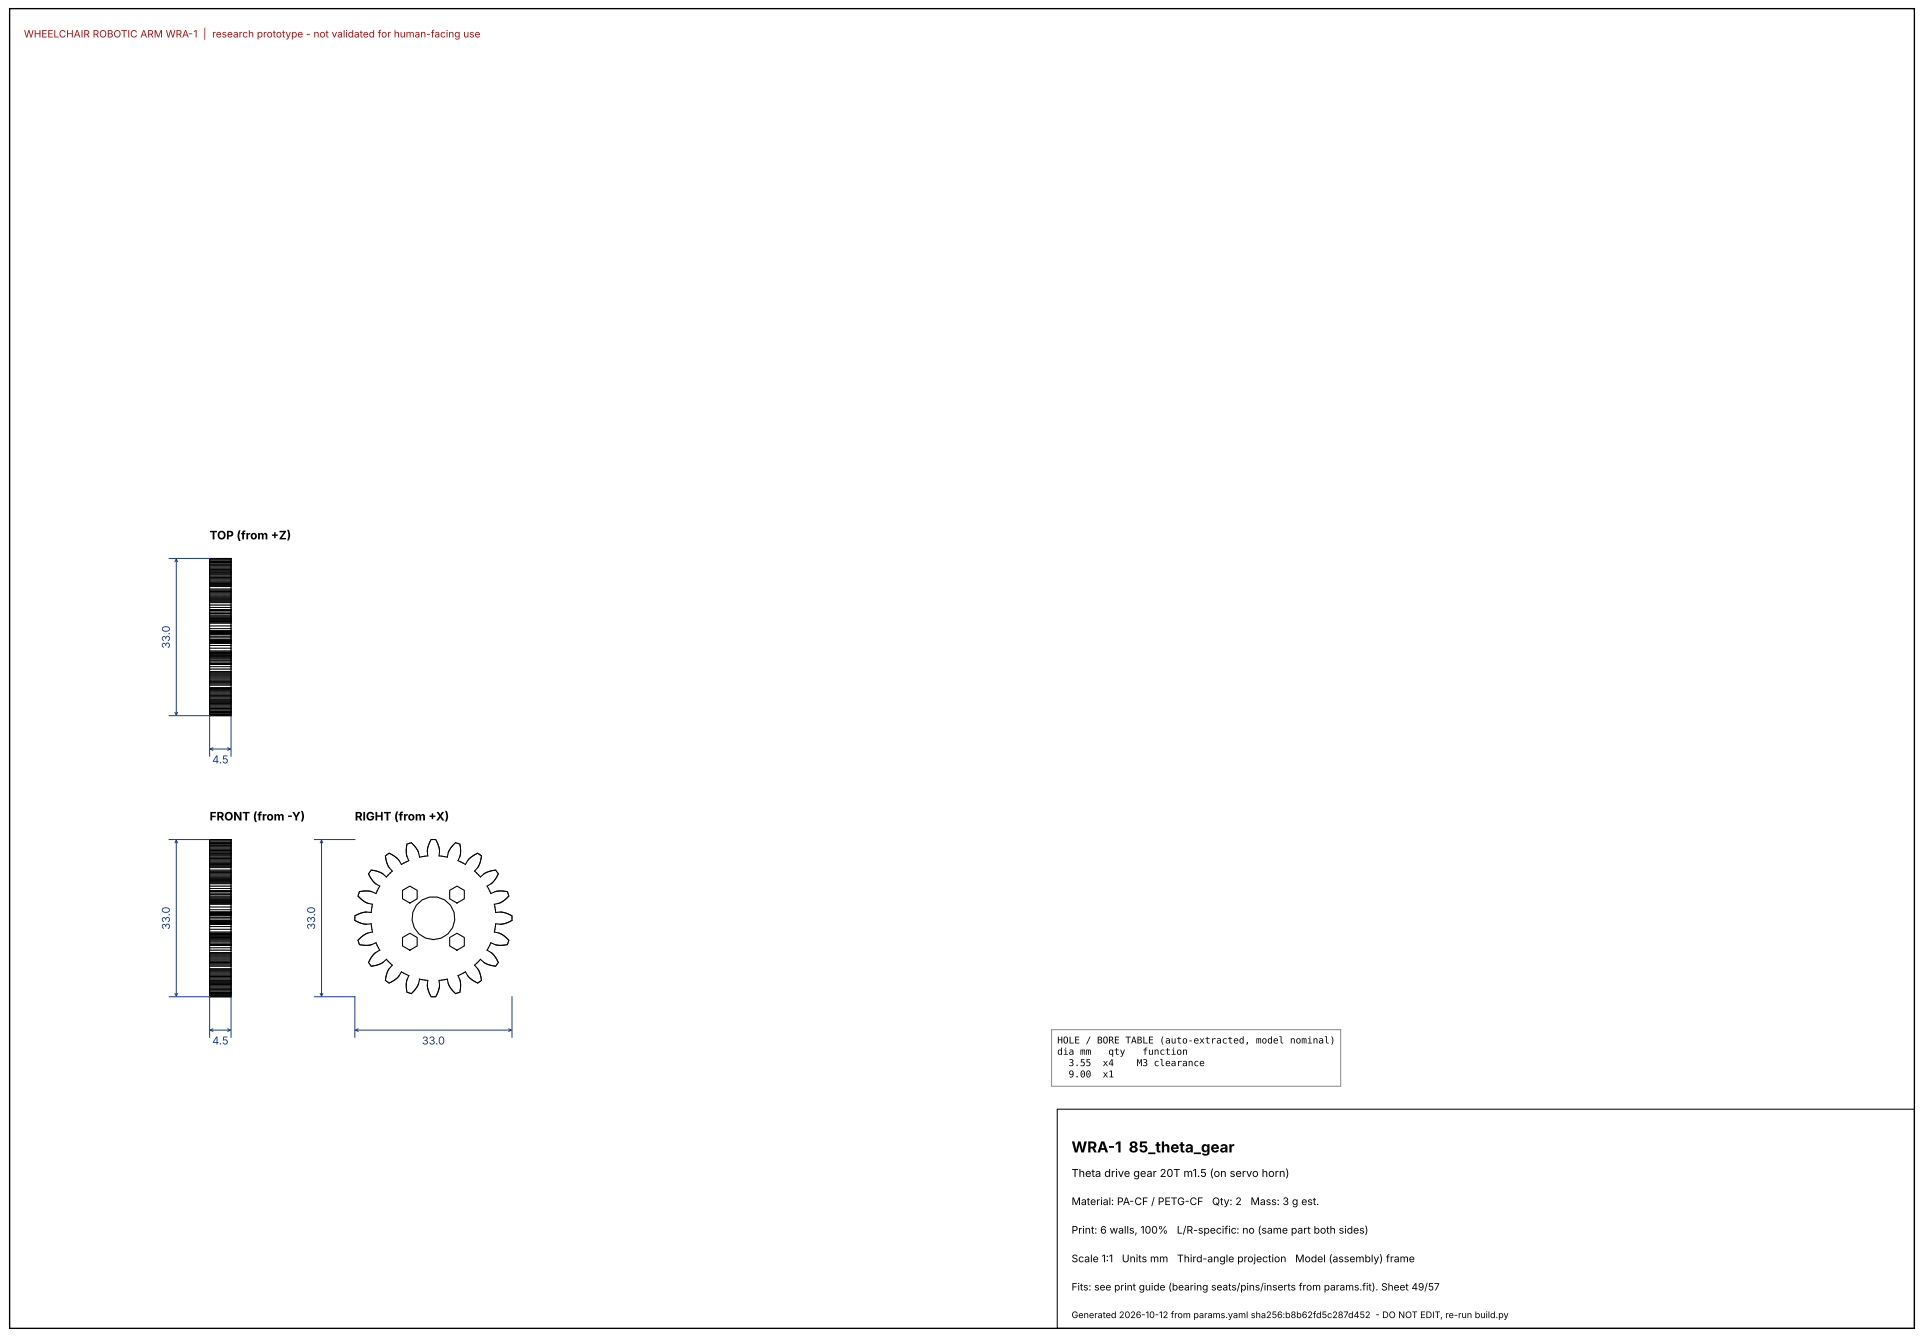
[picture p142: page 50]
FRONT (from -Y); TOP (from +Z); RIGHT (from +X); dia mm; qty; function; M3 clearance; WRA-1 85_theta_gear

HOLE / BORE TABLE (auto-extracted, model nominal)

Theta drive gear 20T m1.5 (on servo horn)

Material: PA-CF / PETG-CF Qty: 2 Mass: 3 g est.

Print: 6 walls, 100% L/R-specific: no (same part both sides)

Fits: see print guide (bearing seats/pins/inserts from params.fit). Sheet 49/57

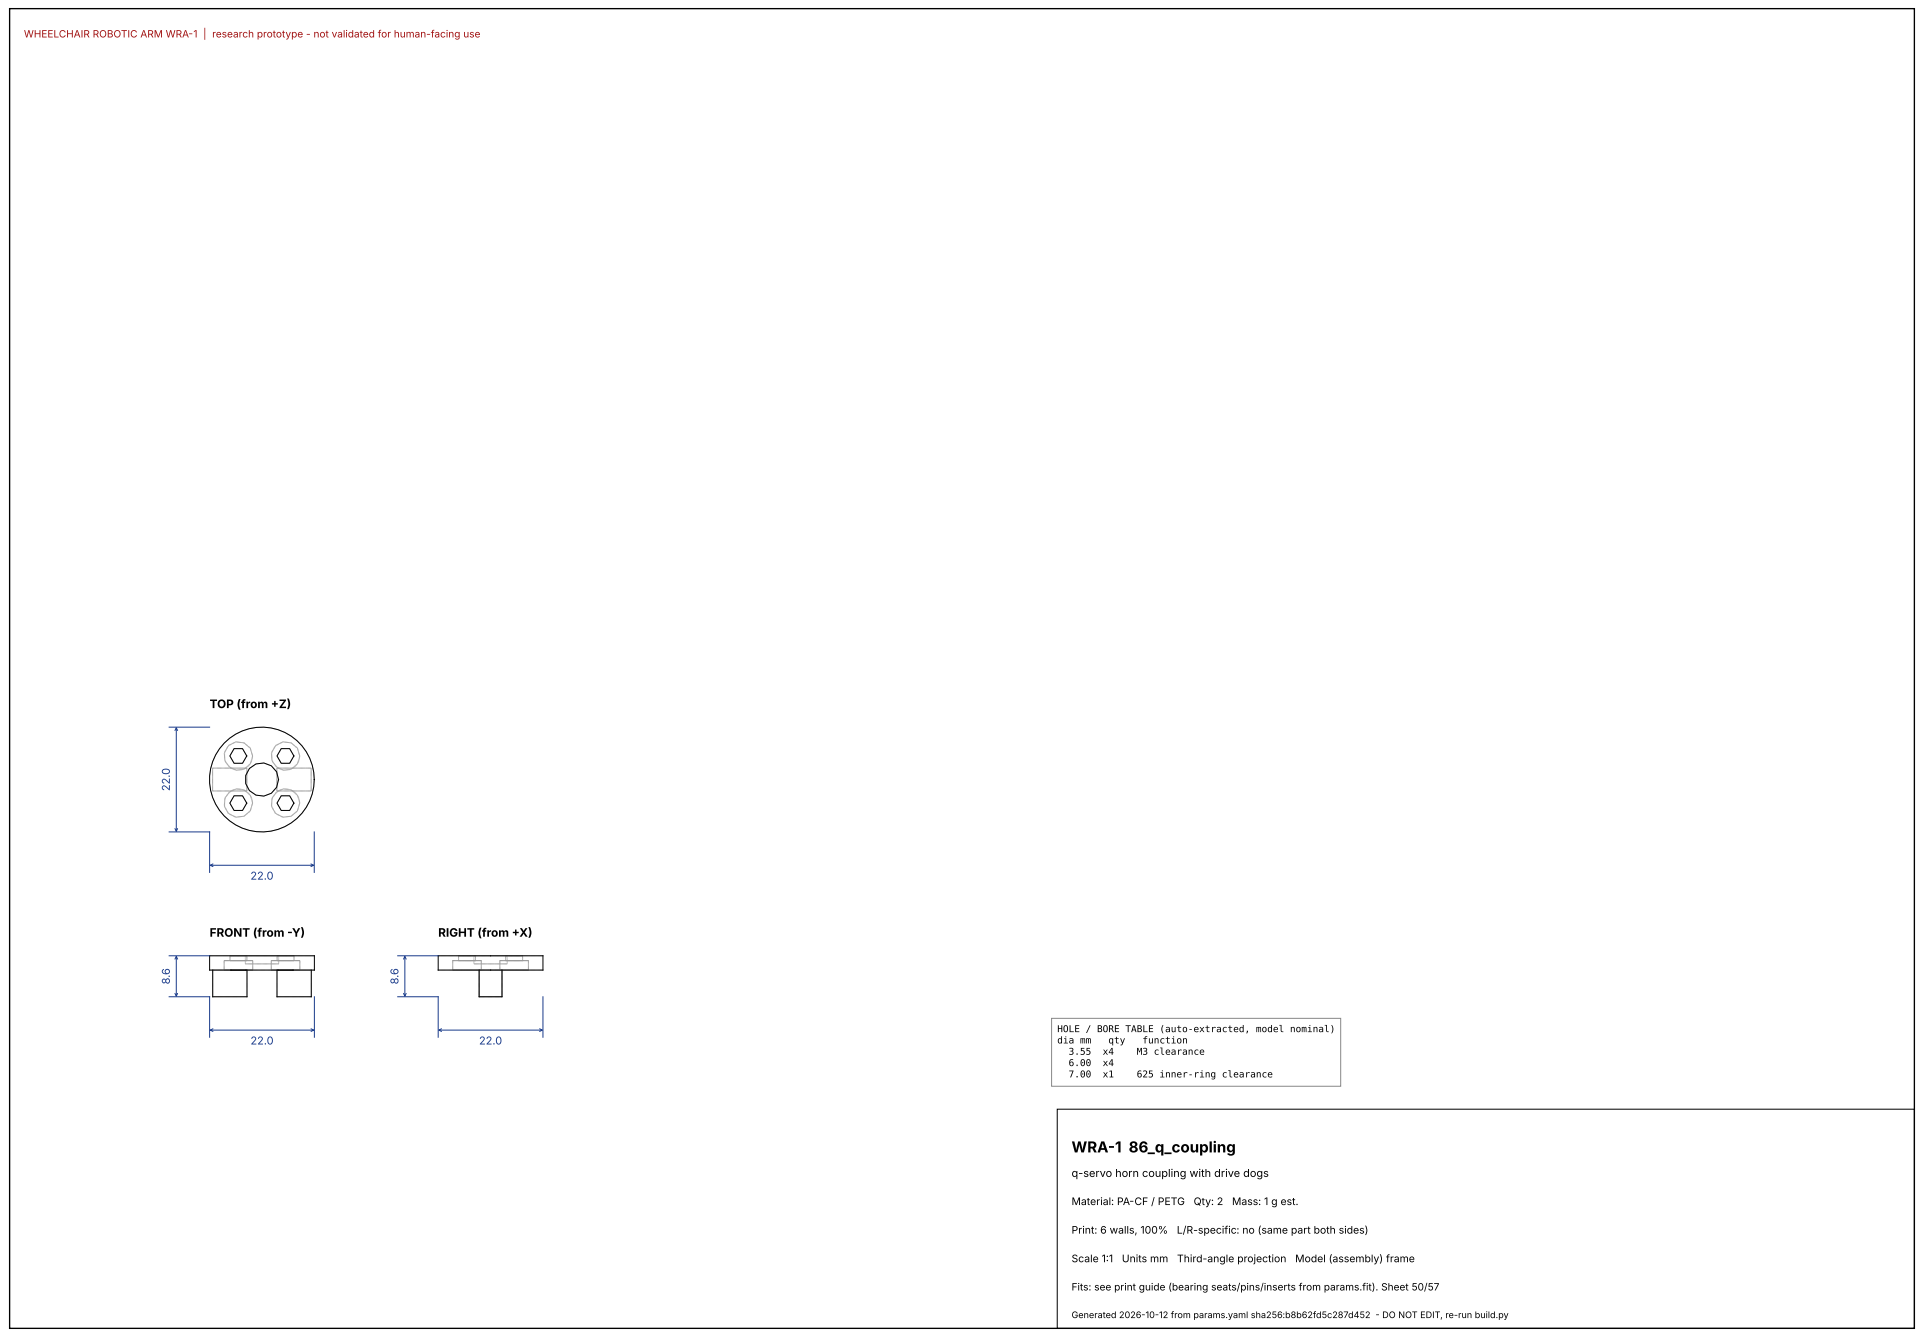
[picture p143: page 51]
FRONT (from -Y); TOP (from +Z); RIGHT (from +X); dia mm; qty; function; M3 clearance; 625 inner-ring clearance; WRA-1 86_q_coupling

HOLE / BORE TABLE (auto-extracted, model nominal)

q-servo horn coupling with drive dogs

Material: PA-CF / PETG Qty: 2 Mass: 1 g est.

Print: 6 walls, 100% L/R-specific: no (same part both sides)

Fits: see print guide (bearing seats/pins/inserts from params.fit). Sheet 50/57

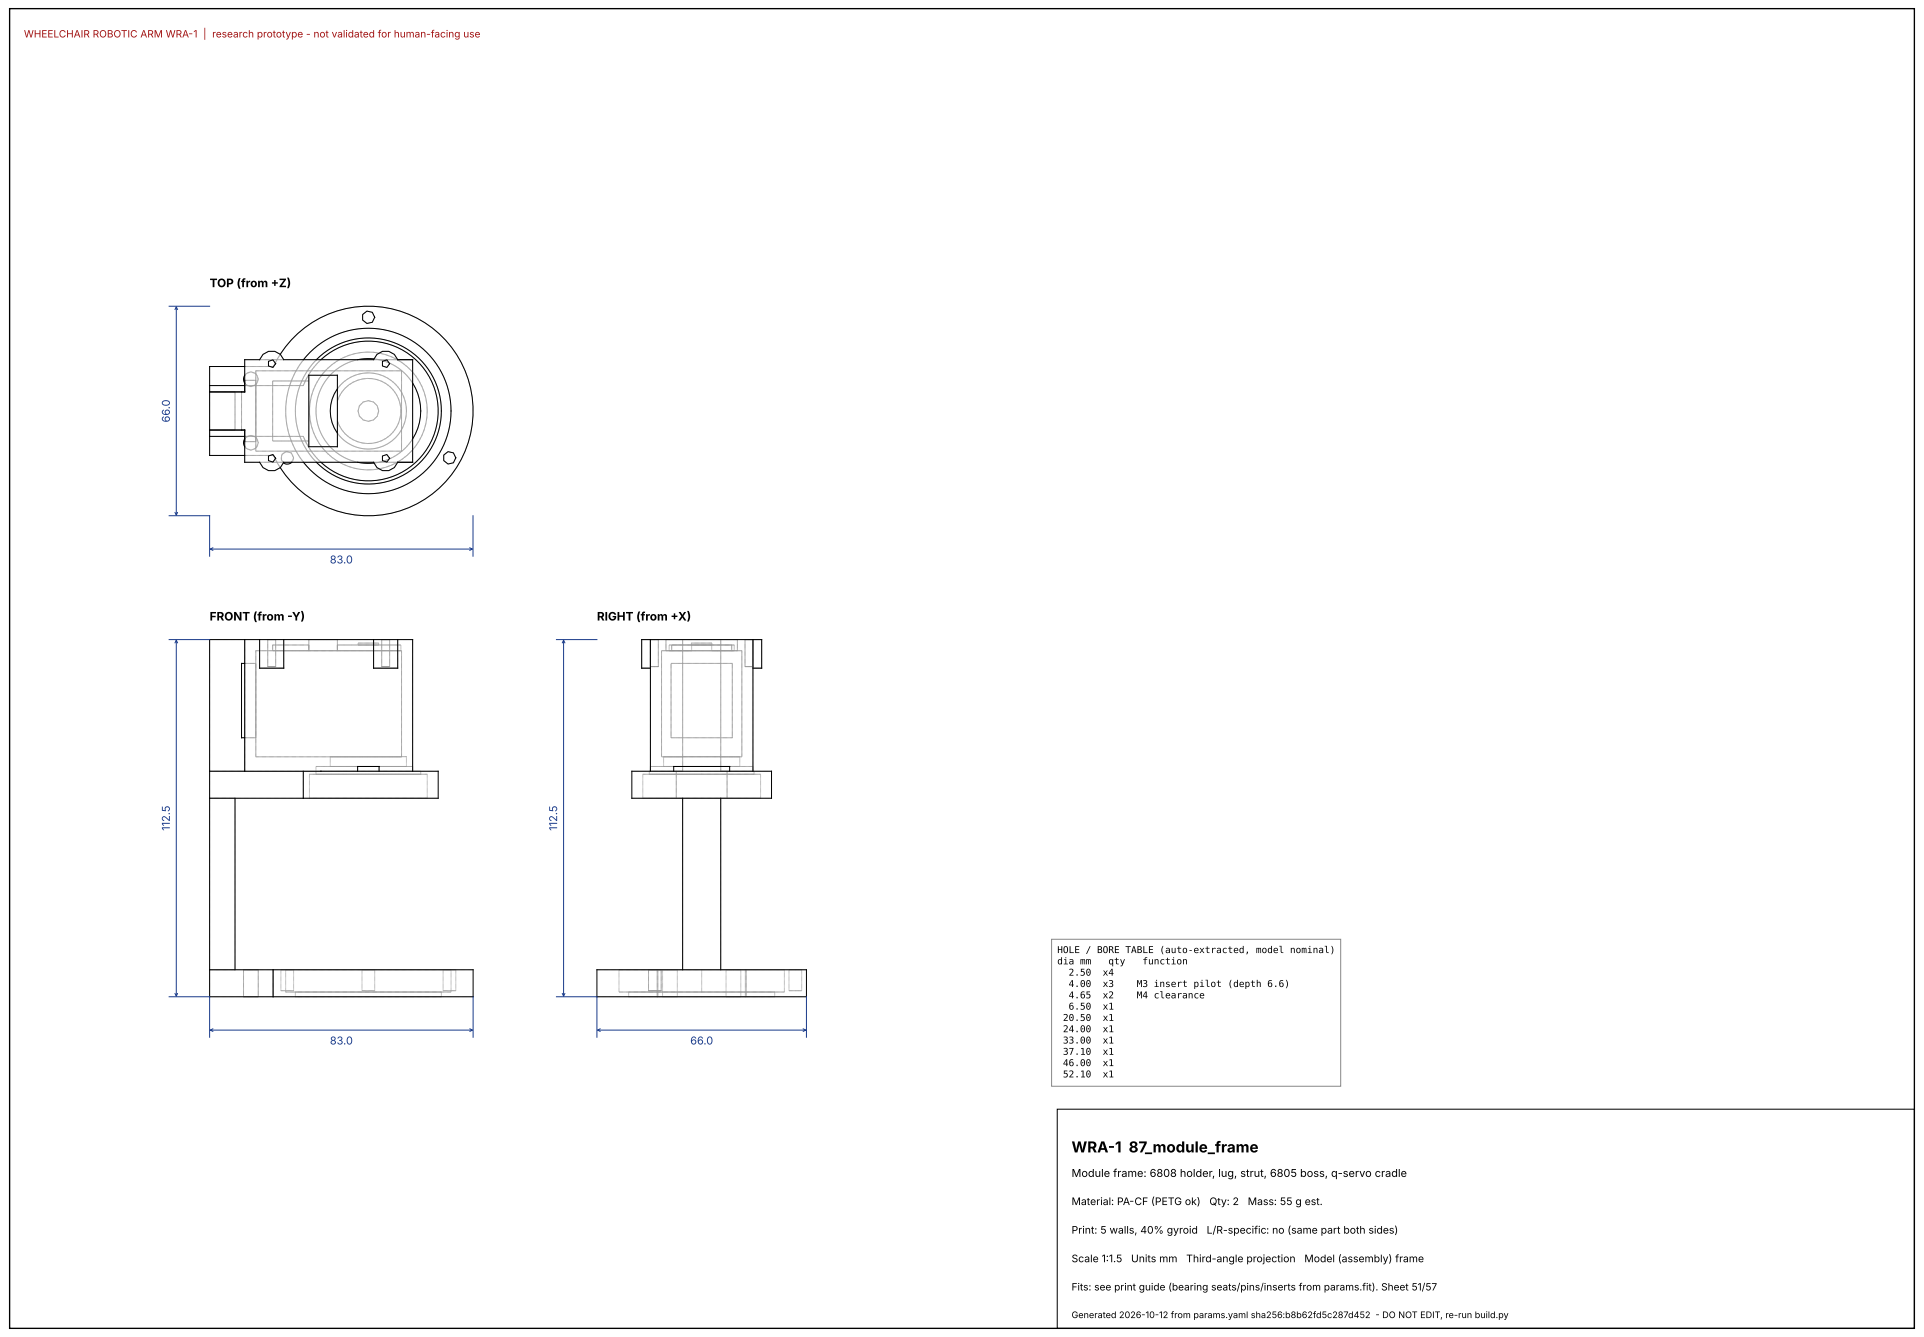
[picture p144: page 52]
FRONT (from -Y); TOP (from +Z); RIGHT (from +X); dia mm; qty; function; M3 insert pilot (depth 6.6); M4 clearance; WRA-1 87_module_frame

HOLE / BORE TABLE (auto-extracted, model nominal)

Module frame: 6808 holder, lug, strut, 6805 boss, q-servo cradle

Material: PA-CF (PETG ok) Qty: 2 Mass: 55 g est.

Print: 5 walls, 40% gyroid L/R-specific: no (same part both sides)

Scale 1:1.5 Units mm Third-angle projection Model (assembly) frame

Fits: see print guide (bearing seats/pins/inserts from params.fit). Sheet 51/57

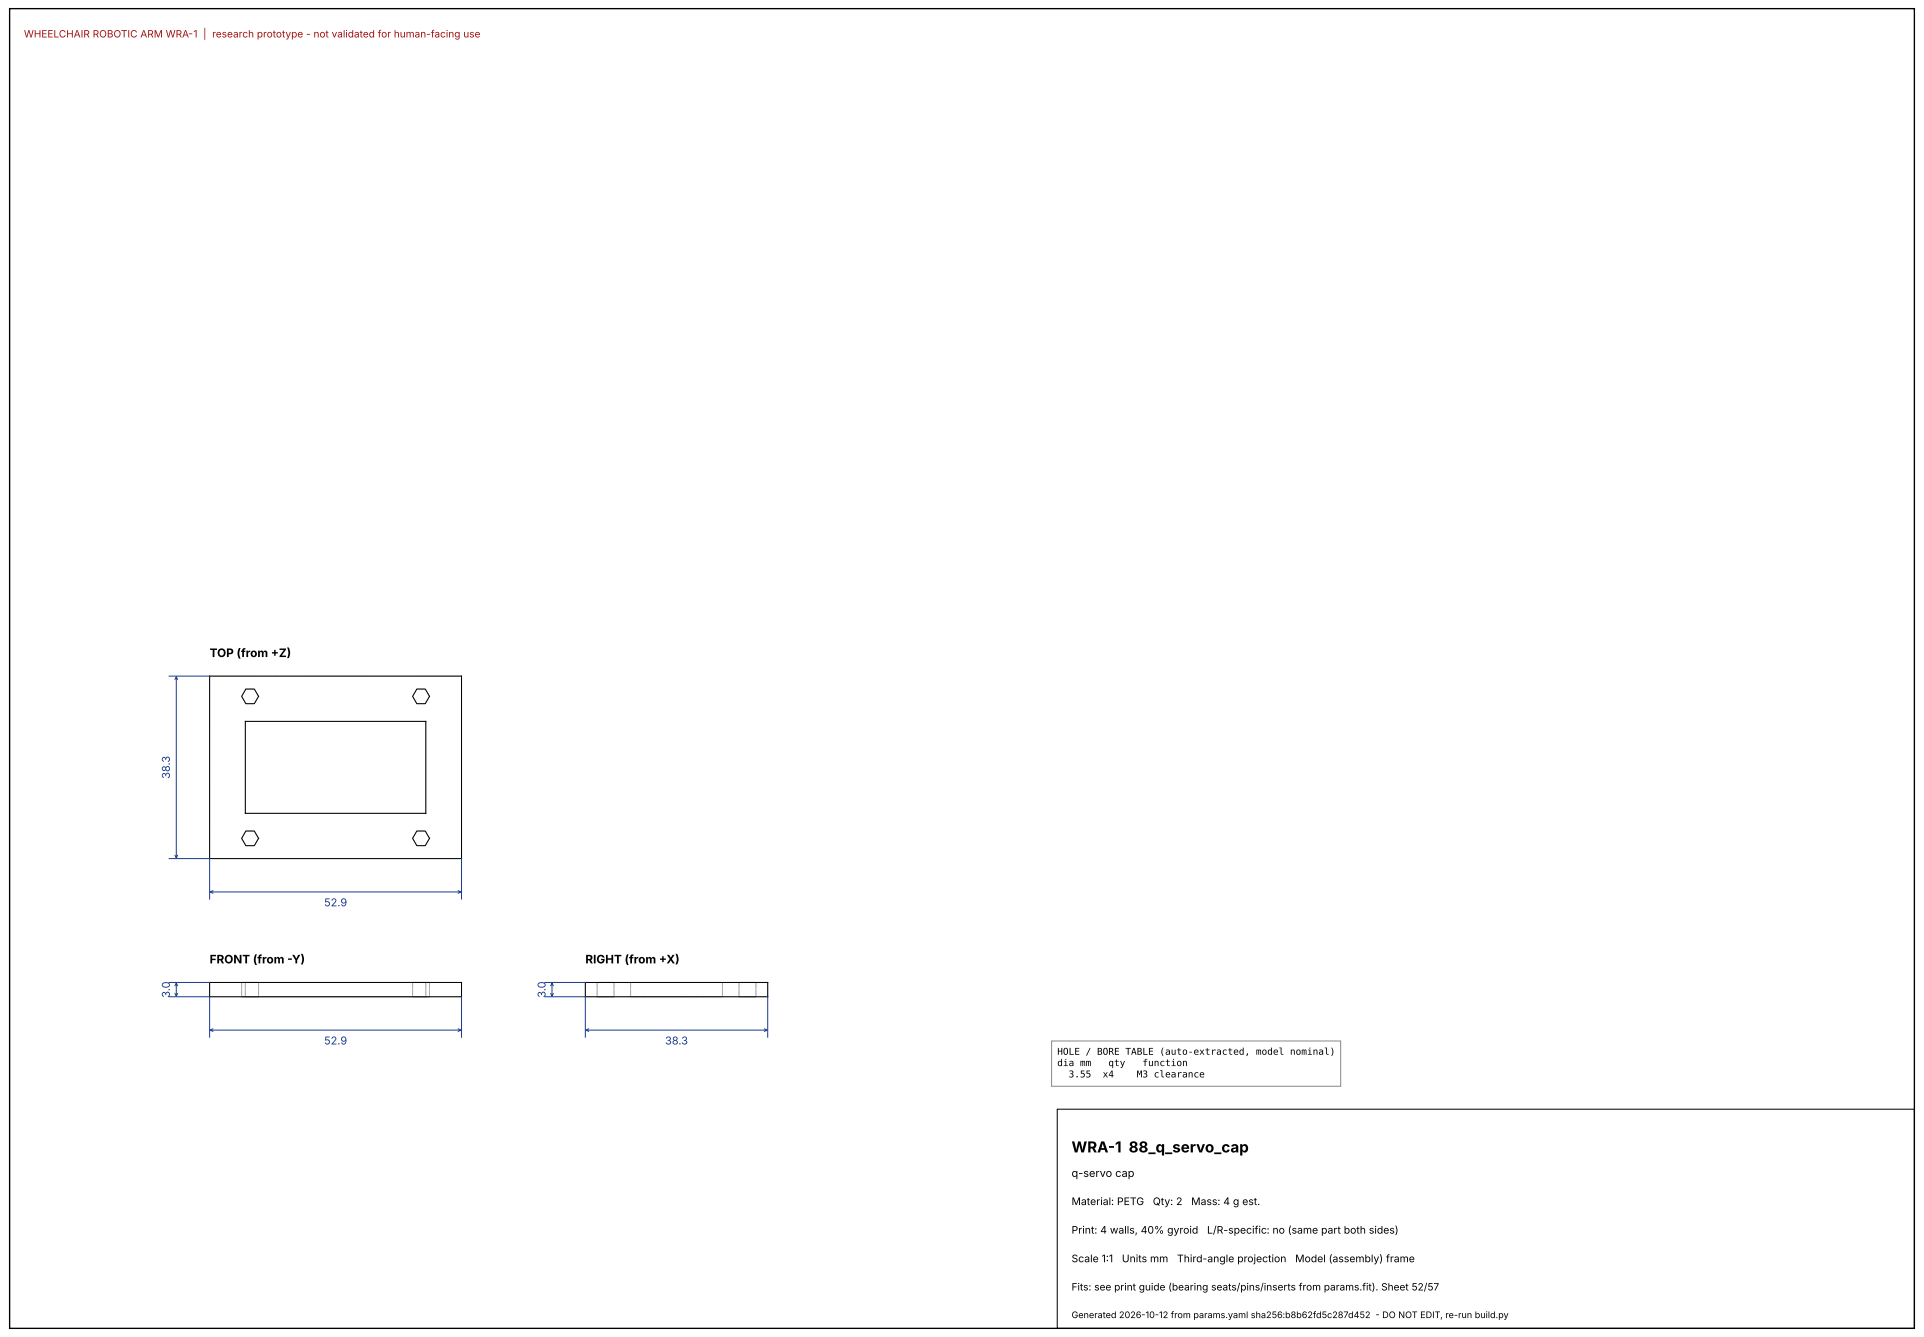
[picture p145: page 53]
FRONT (from -Y); TOP (from +Z); RIGHT (from +X); dia mm; qty; function; M3 clearance; WRA-1 88_q_servo_cap; q-servo cap

HOLE / BORE TABLE (auto-extracted, model nominal)

Material: PETG Qty: 2 Mass: 4 g est.

Print: 4 walls, 40% gyroid L/R-specific: no (same part both sides)

Fits: see print guide (bearing seats/pins/inserts from params.fit). Sheet 52/57

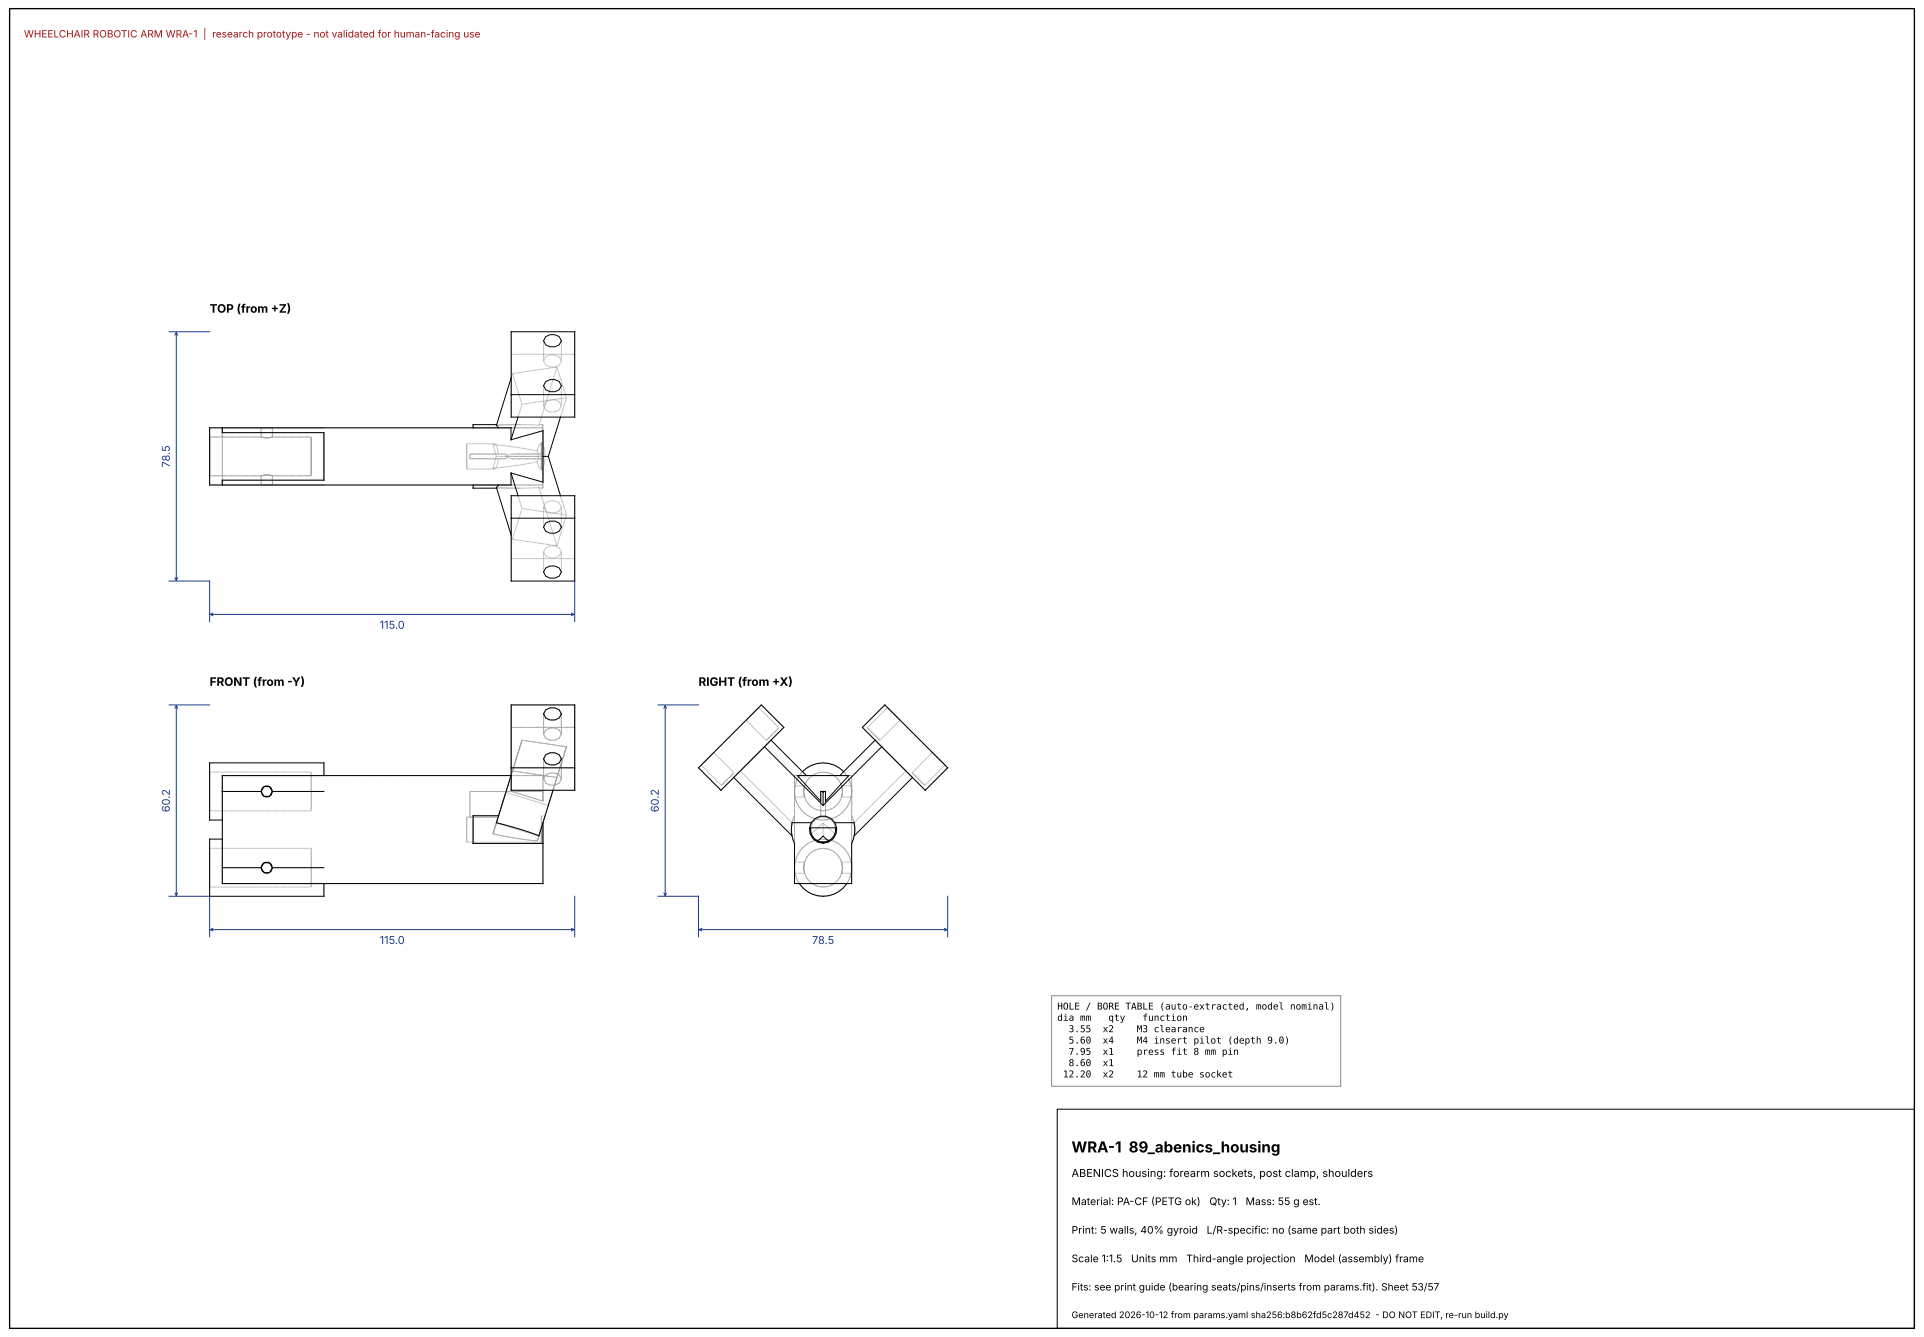
[picture p146: page 54]
FRONT (from -Y); TOP (from +Z); RIGHT (from +X); dia mm; qty; function; M3 clearance; M4 insert pilot (depth 9.0); press fit 8 mm pin; 12 mm tube socket; WRA-1 89_abenics_housing

HOLE / BORE TABLE (auto-extracted, model nominal)

ABENICS housing: forearm sockets, post clamp, shoulders

Material: PA-CF (PETG ok) Qty: 1 Mass: 55 g est.
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
