landen-finkel-engineering/ROLLO-Wheelchair-Arm/firmware/esp32_safety_controller/esp32_safety_controller.ino

// Arduino IDE entry point.  Intentionally empty: the Arduino IDE also compiles everything in src/,
// where setup() and loop() live (src/main.cpp).  PlatformIO ignores this file.
// Board: "ESP32 Dev Module" (esp32 core 2.0.x).  Upload speed 921600.  See docs/11_software_setup.md.
