landen-finkel-engineering/ROLLO-Wheelchair-Arm/(commit log)

2026-10-12 WRA-1: 3D-printable wheelchair robotic arm (ABENICS wrist, door-knob claw)
    Research prototype, designed and checked in CAD and simulation; not built
    or tested yet. Not safe for human-facing use until the staged tests in
    docs/09_safety.md pass.
    - cad/: parametric build123d source (params.yaml is the single source of
    truth) and build.py, which regenerates STL/STEP, drawings, renders, BOM,
    print guide, URDF and the verification report
    - output/: generated STL (print orientation, toothed ABENICS gears), STEP
    parts and zipped assemblies, drawings, DXF, renders, reports
    - calcs/: mass, springs, torques, structure, gear teeth, belts, power,
    accuracy, knob reach window -> docs/05
    - firmware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
    [base_link.stl, bom_purchased.csv, calibration.yaml, fastener_schedule.csv, forearm.stl, jaw_a.stl, jaw_b.stl, printed_parts.csv]
2026-10-12 Add printable STL files (print orientation; ABENICS gears with real teeth)
    Claude-Session: https://claude.ai/code/session_01J8a1Pvc83PJ2wDtSmD8tm3
    [00_fit_test_coupon.stl, 01_receiver.stl, 02_tube_clamp_body.stl, 03_tube_clamp_cap.stl, 04_post_bracket.stl, 05_stop_collar.stl, 10_base_housing.stl, 11_j1_fixed_pulley.stl]
2026-10-12 Add STEP files: one per part, zipped assemblies
    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
    [00_fit_test_coupon.step, 01_receiver.step, 02_tube_clamp_body.step, 03_tube_clamp_cap.step, 04_post_bracket.step, 05_stop_collar.step, 10_base_housing.step, 11_j1_fixed_pulley.step]
2026-10-12 Add drawings (SVG + PDF), renders and the aluminium bracket DXF
    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
    [04_post_bracket_plates.dxf]
2026-10-12 Report: printed-mass total matches the BOM (2618 g)
    The parts table summed the rounded per-part masses (2615 g); the BOM uses the
    unrounded masses.
    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
2026-10-12 Keep the driver's chair geometry in step with params.yaml; fix stale numbers
    - build.py --verify first refreshes arm_geometry.json (chair -> arm transform,
    user keep-out boxes) and records its params_sha; --all runs the software
    export before assemblies and renders.
    - arm_geometry.json carries params_sha; the driver logs it at start-up and
    `wra_cli.py status` prints it (geometry_params_sha).
    - docs/09: new test T4.0 (Jetson geometry matches the verified build);
    docs/11 section G: copy arm_geometry.json to the Jetson after a change;
    docs/12, docs/10, docs/00 section 13 and README point to it.
    - verification.md: installation checks labelled by pose.
    - docs/00: knob-pose added width 1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
    [driver_node.py, wra_cli.py]
2026-10-12 The chair is a manual wheelchair, not a power chair
    The CAD chair was already a manual chair (hand rims, wheel locks, push
    handles, swing-away footrests); only the text and procedures assumed a
    power chair.
    - README, docs/00, docs/01, docs/07, BOM note: manual (self-propelled)
    wheelchair; the arm has its own battery because the chair has none.
    - Door task: wheel locks on first (docs/10 step 0); `wra_cli.py door` asks
    (skip with --yes); the voice command note says to set them first.
    - docs/09: hazard H15 and an FMEA row for the chair rolling during a door
    pull; T4.2 adds the push stroke, footrest swing-away and folding; T5.3
    pushing the chair with the arm docked. docs/12 T18-T20 to c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
    [bom_purchased.csv]
2026-10-12 README: link the materials list from "Start here"
    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
2026-10-12 Add a shopping list with buy links; flag two parts the CAD doesn't fit yet
    - docs/16_shopping_list.md: a link for every purchased part in BOM.md
    (mostly Amazon), with pack sizes, options to choose and cut lengths.
    - While matching parts to the design:
    - a spring that meets the J2/J3 balance spec is ~12-16 mm OD and
    85-100 mm long unstretched; the CAD only has a 9 mm placeholder, so the
    spring mounting is still open;
    - no standard 30 mm shaft collar fits the J1 cavity (45 x 13 mm);
    - the captive O-ring for the dock thumb screws is 5 x 1.5 mm (it grips
    the M6 thread); the BOM had the 13 mm recess size.
    - BOM, README, docs/00 (BOM section, springs, limitations) and test_log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
    [bom_purchased.csv]
2026-10-13 Amazon list for the shopping list; 8 x 25 drive-module pins; stainless post in the BOM
    - docs/16: link to one shared Amazon list with every purchased part
    (bottom of the page), plus in-stock replacements for listings that had
    gone unavailable or redirected, cheaper shim kits, a ruthex insert box,
    and the list's real cost (~$1,210 at pack prices vs the BOM's ~$577)
    - Drive-module pulley axles are now 8 x 25 dowels (dm.pin_len,
    ddm.pin_len = 25). With 8 x 24 the J2/J3 pins ended 0.8 mm short of the
    bottom of the lower 608. No printed part changes; BOM, driver geometry,
    assemblies and calcs regenerated; --verify ALL PASS (params_sha
    5d1eef09daa8874d); driver tests 10/10
    - BOM: the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
    [bom_purchased.csv, turntable.stl]
